eSpark-Consulting-Group/anis-carrier-board/Deliverables/Renderings/3D_Top_View.PNG

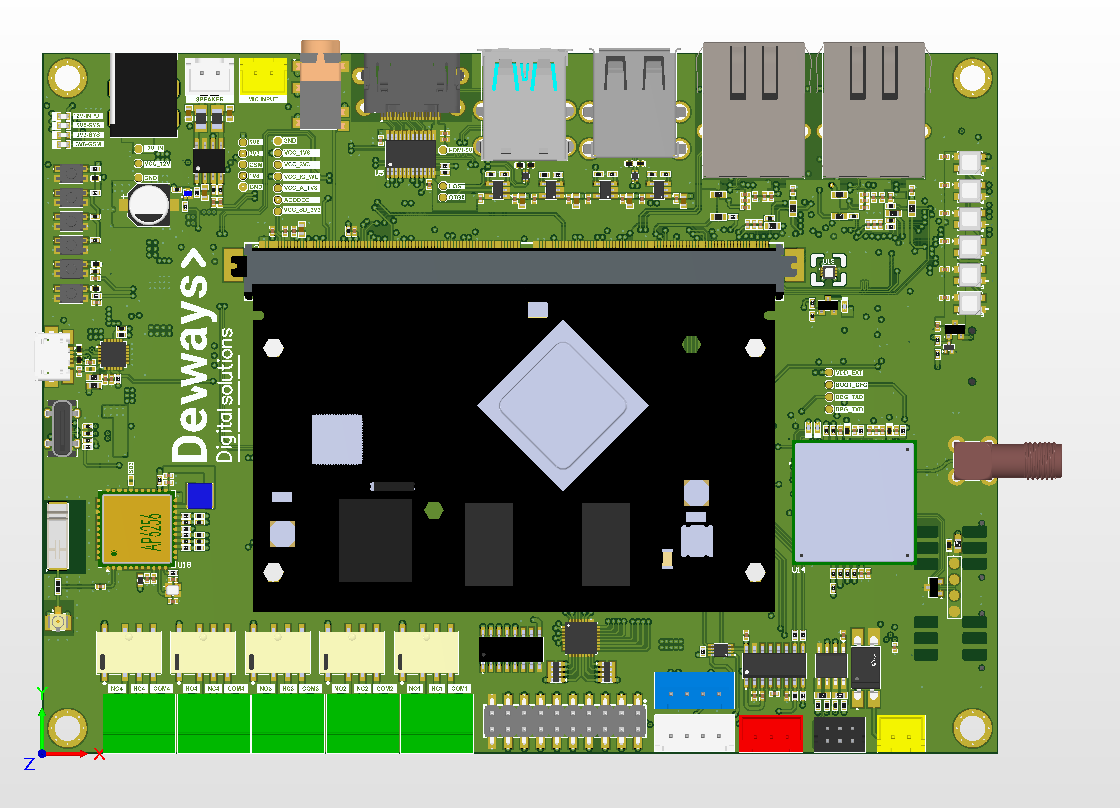
Deliverables/Renderings/3D_Top_View.PNG
