eSpark-Consulting-Group/anis-carrier-board/Deliverables/Renderings/2D_C_View.png

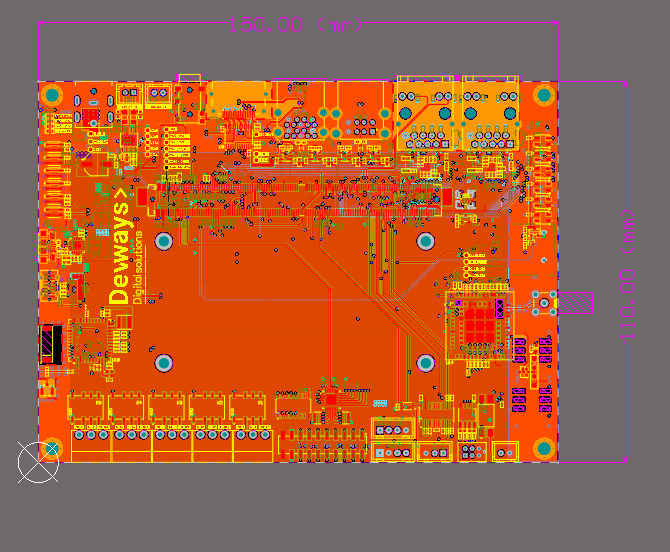
Deliverables/Renderings/2D_C_View.png
