eSpark-Consulting-Group/anis-carrier-board/README.md

# Carrier Board Design and Development
### Client Name: Anis Mohammed
