eSpark-Consulting-Group/anis-carrier-board/Deliverables/Renderings/2D_L2_View.png

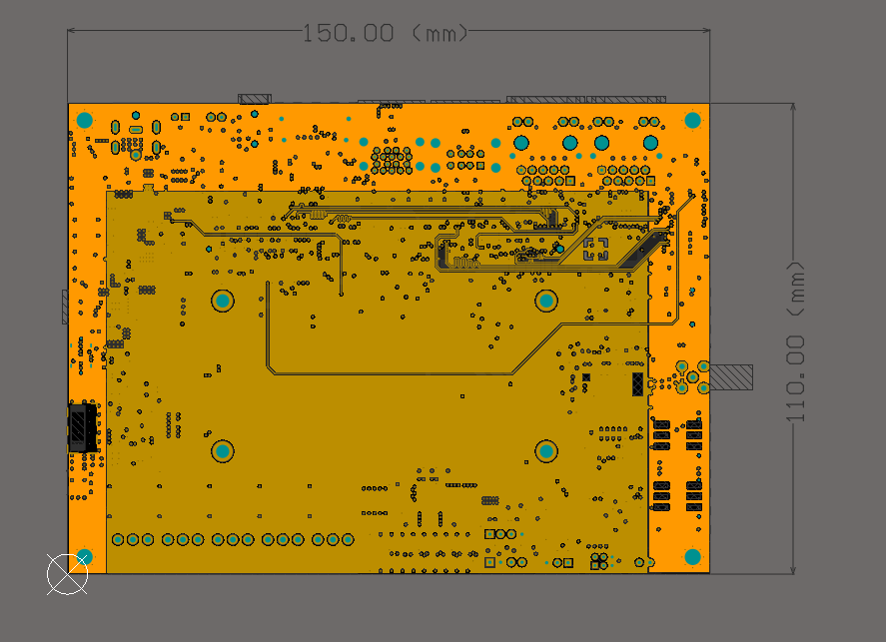
Deliverables/Renderings/2D_L2_View.png
