eSpark-Consulting-Group/anis-carrier-board/Deliverables/Renderings/2D_L3_View.png

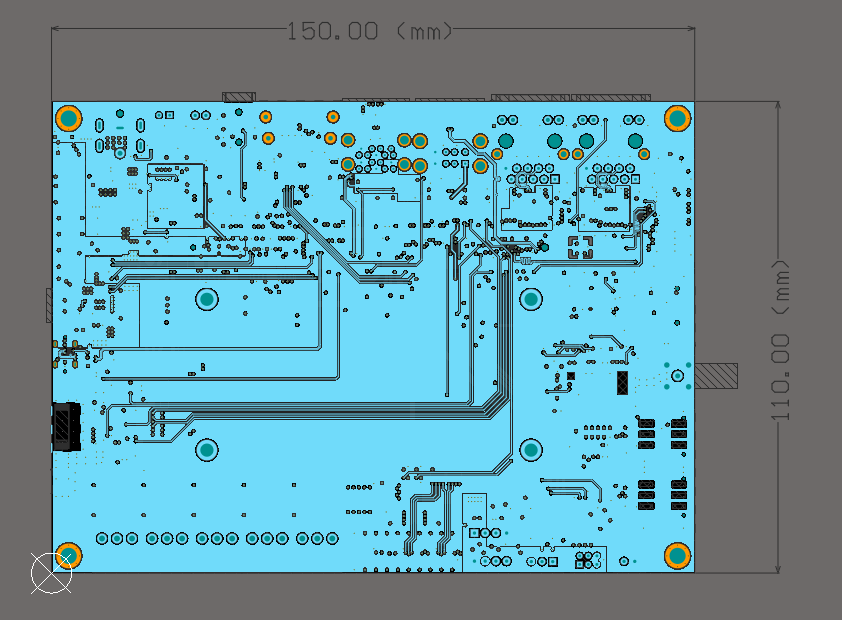
Deliverables/Renderings/2D_L3_View.png
