eSpark-Consulting-Group/anis-carrier-board/Deliverables/Renderings/2D_L6_View.png

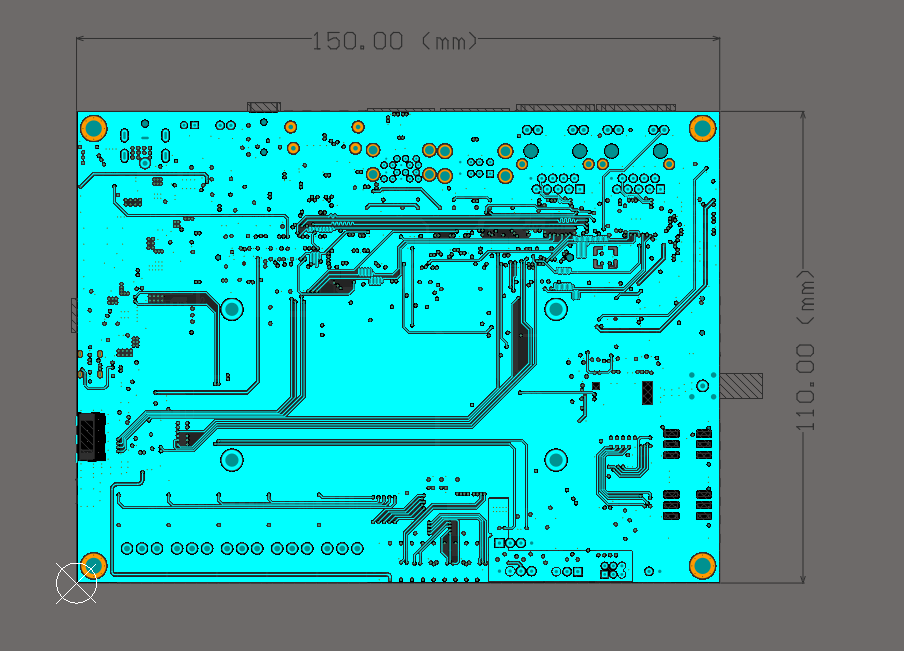
Deliverables/Renderings/2D_L6_View.png
