eSpark-Consulting-Group/anis-carrier-board/Deliverables/Renderings/2D_L7View.png

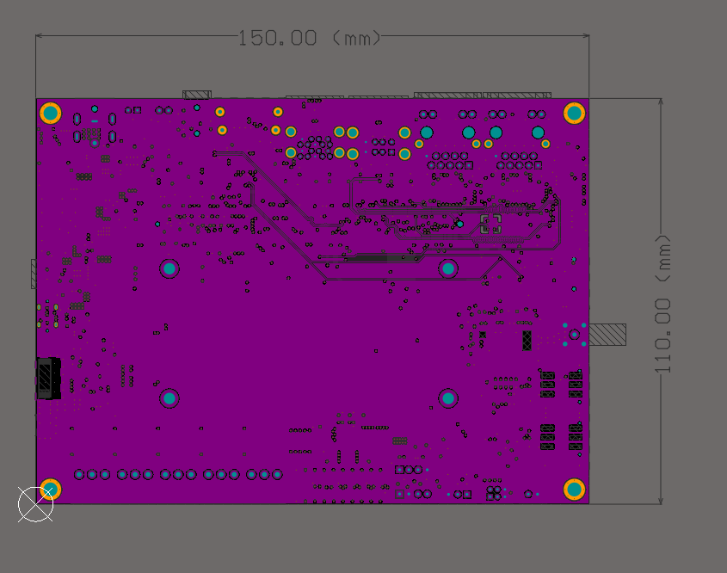
Deliverables/Renderings/2D_L7View.png
