eSpark-Consulting-Group/anis-carrier-board/Deliverables/Renderings/2D_Top_View.PNG

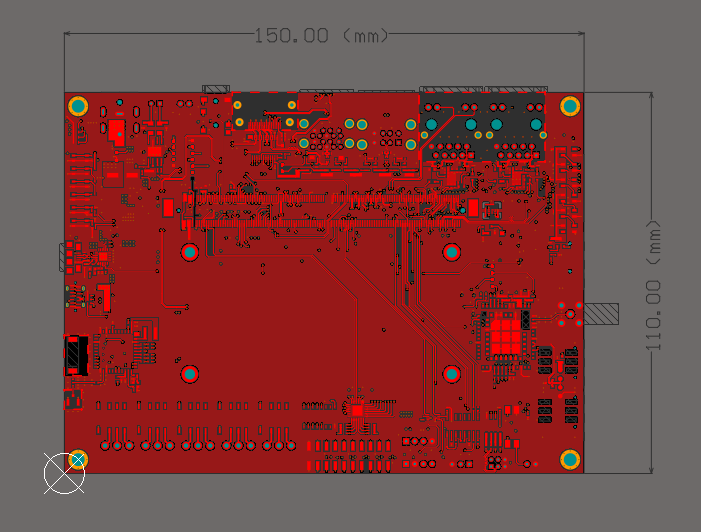
Deliverables/Renderings/2D_Top_View.PNG
