eSpark-Consulting-Group/anis-carrier-board/Deliverables/Renderings/Isometric_View.PNG

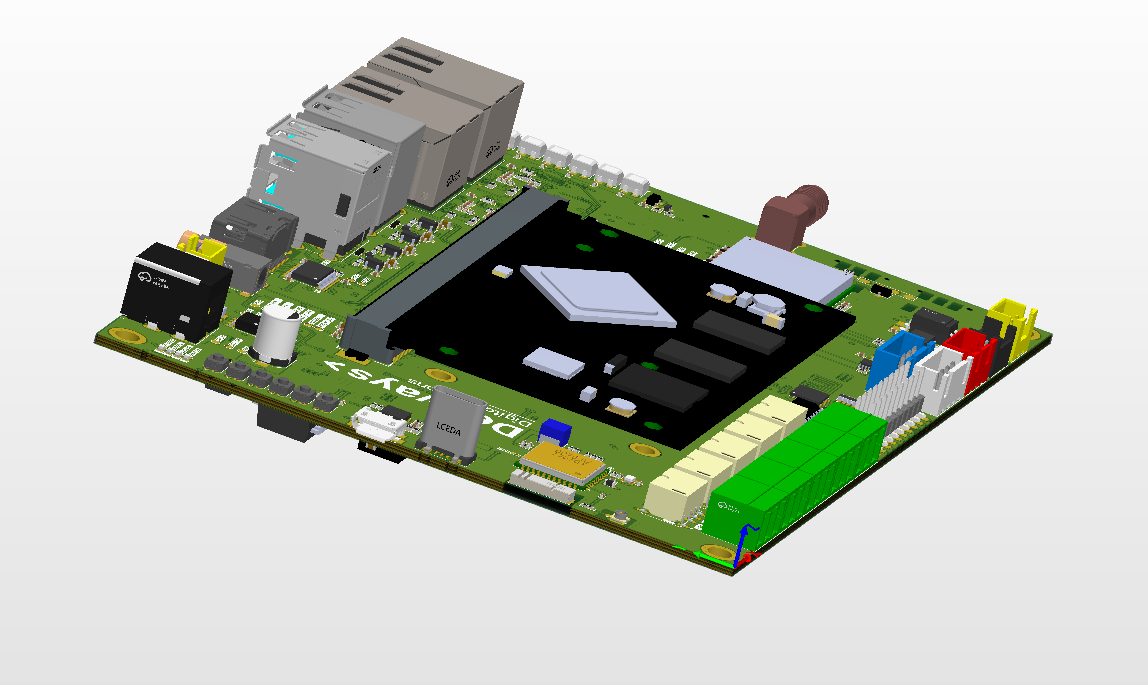
Deliverables/Renderings/Isometric_View.PNG
