eSpark-Consulting-Group/anis-carrier-board/Design-Files/Carrier-Board-v1.1/BOM/Client-BOM-Carrier-Board-v1.1.xlsx

# | Item Type | Designator | Description | Footprint | Manufacturer Part Number | Manufacturer | Value | Quantity | Remarks
1 | Antenna | ANT1 | RF ANT 2.4GHZ/5.5GHZ CHIP SLD | Custom | W3006 | Pulse | - | 1
2 | Capacitor | C1, C3, C4, C6, C7, C8, C9, C10, C11, C12, C13, C14, C15, C16, C17, C18, C21, C22, C23, C27, C30, C34, C55, C65, C66, C67, C70, C71, C72, C75, C76, C78, C81, C84, C85, C88, C89, C91, C92, C93, C94, C95, C96, C97, C98, C100, C101, C103, C104, C106, C107, C109, C110, C111, C113, C114, C115, C118, C119, C120, C122, C126, C129, C131, C134, C135, C136, C137, C141, C143, C144, C147, C148, C149, C152, C153, C154, C155, C158, C168, C169, C180, C181, C182, C183, C184, C185, C186, C187, C188, C189, C190, C191, C192, C193, C194, C199, C204 | CAP CER 0.1UF 16V X5R 0402 | Cap-0402 | CC0402KRX5R7BB104 | Yageo | 100nF | 98
3 | Capacitor | C2, C79 | CAP CER 10UF 10V X5R 0402 | Cap-0402 | CC0402MRX5R6BB106 | Yageo | 10uF | 2
4 | Capacitor | C5, C24, C31, C125, C142, C203 | CAP CER 1000PF 2KV X7R 1206 | Cap-1206 | CC1206KKX7RDBB102 | Yageo | 1nF | 6
5 | Capacitor | C19, C25, C28, C32 | CAP CER 1UF 16V X5R 0402 | Cap-0402 | CC0402KRX5R7BB105 | Yageo | 1uF | 4
6 | Capacitor | C20, C26, C29, C33 | CAP CER 10UF 16V X5R 0603 | Cap-0603 | CC0603KRX5R7BB106 | Yageo | 10uF | 4
7 | Capacitor | C35, C36, C38 | CAP CER 4.7UF 50V X5R 0805 | Cap-0805 | GRM21BR61H475KE51L | Murata | 4.7uf | 3
8 | Capacitor | C37, C68, C80, C166 | CAP CER 1UF 25V X5R 0402 | Cap-0402 | CC0402KRX5R8BB105 | Yageo | 1uF | 4
9 | Capacitor | C39, C40, C42, C43, C46, C50, C52, C53, C57, C124, C130, C177, C179 | CAP CER 0.1UF 50V X7R 0402 | cap-0402 | C1005X7R1H104KT000F | TDK | 100nF | 13
10 | Capacitor | C41, C51, C176, C178 | CAP CER 10UF 50V X5R 0805 | Cap-0805 | GRM21BR61H106ME43L | Murata | 10uF | 4
11 | Capacitor | C44, C45, C54, C56 | CAP CER 47UF 25V X5R 1206 | Cap-1206 | GRM31CR61E476ME44L | Murata | 47uF | 4
12 | Capacitor | C47, C59 | CAP CER 2.2UF 25V X5R 0402 | Cap-0402 | GRM155R61E225KE11D | Murata | 2.2uf | 2
13 | Capacitor | C48, C60 | CAP CER 1000PF 25V X7R 0402 | Cap-0402 | CC0402KRX7R8BB102 | Yageo | 1000pF | 2
14 | Capacitor | C49, C61 | CAP CER 3.9PF 50V C0G/NPO 0402 | Cap-0402 | CC0402BRNPO9BN3R9 | Yageo | 3.9pF | 2
15 | Capacitor | C58, C77 | CAP CER 10PF 50V C0G/NP0 0402 | Cap-0402 | GRM1555C1H100JA01D | Murata | 10pF | 2
16 | Capacitor | C62 | CAP TANT 470UF 10% 10V 2917 | Case-E | TAJE477K010RNJ | Kyocera AVX | 470uF | 1
17 | Capacitor | C63 | CAP CER 0.1UF 50V X5R 0603 | Cap-0603 | CC0603KRX5R9BB104 | Yageo | 100nF | 1
18 | Capacitor | C64 | CAP CER 33PF 25V C0G/NP0 0402 | Cap-0402 | GRM1555C1E330JA01D | Murata | 33pF | 1
19 | Capacitor | C69, C174 | CAP TANT 100UF 20% 10V 1411 | Case-B | TAJB107M010RNJ | Kyocera AVX | 100uF | 2
20 | Capacitor | C73, C74 | CAP CER 0.22UF 25V X5R 0402 | Cap-0402 | CC0402KRX5R8BB224 | Yageo | 220nF | 2
21 | Capacitor | C82, C83 | CAP CER 12PF 50V C0G/NP0 0402 | Cap-0402 | GJM1555C1H120GB01D | Murata | 12pF | 2
22 | Capacitor | C86, C87, C90, C99, C102, C105, C108, C112, C156, C157 | CAP CER 10UF 25V X5R 0603 | Cap-0603 | C1608X5R1E106M080AC | TDK | 10uF | 10
23 | Capacitor | C116 | 100uF 50V ±20% SMD,D6.3xL7.7mm Aluminum Electrolytic Capacitors - SMD ROHS | Custom | RVT1H101M0607 | ROQANG | 100uF | 1
24 | Capacitor | C117, C121, C123, C132, C140, C146, C150 | CAP CER 4.7UF 10V X5R 0402 | Cap-0402 | CC0402KRX5R6BB475 | Yageo | 4.7uF | 7
25 | Capacitor | C127, C128, C138, C139 | CAP CER 18PF 50V C0G/NP0 0402 | Cap-0402 | GCM1555C1H180GA16D | Murata | 18pF | 4
26 | Capacitor | C133, C145, C151, C197 | CAP CER 1UF 25V X5R 0603 | Cap-0603 | CC0603KRX5R8BB105 | Yageo | 1uF | 4
27 | Capacitor | C159, C160, C161, C162, C163, C164, C198 | CAP CER 1000PF 25V X7R 0402 | Cap-0402 | CC0402KRX7R8BB102 | Yageo | 1nF | 7
28 | Capacitor | C165 | CAP CER 100PF 50V C0G/NPO 0402 | Cap-0402 | CC0402JRNPO9BN101 | Yageo | 100pF | 1
29 | Capacitor | C170, C171 | CAP CER 27PF 25V C0G/NP0 0402 | Cap-0402 | 0402N270J250CT | Walsin Technologies | 27pF | 2
30 | Capacitor | C172, C173 | CAP CER 0.015UF 50V X7R 0402 | Cap-0402 | CC0402KRX7R9BB153 | Yageo | 15nF | 2
31 | Capacitor | C175 | CAP CER 0.1UF 100V X7R 0603 | Cap-0603 | CC0603KRX7R0BB104 | Yageo | 0.1uF | 1
32 | Capacitor | C195, C196 | CAP CER 1000PF 25V C0G/NPO 0603 | CAP-0603 | CC0603JRNPO8BN102 | Yageo | 1nF | 2
33 | Surge Protection (TVS/ESD) | D1, D2 | TVS DIODE 7V/12V 14V/26V SOT23-3 | SOT-23 | CDSOT23-SM712 | Bourns | - | 2
34 | Diode | D3, D4, D7, D8, D9, D10, D11, D12, D13, D14, D22, D23, D24, D25, D48, D49, D50, D51, D52, D55, D57, D61, D64, D65, D66, D68 | DFN1006-2(0402) ESD Protection Devices ROHS | DFN1006-2L (Bi-Directional) | ESD5451N | TECH PUBLIC | - | 26
35 | Diode | D5, D6 | DFN2510-10L ESD Protection Devices ROHS | DFN2510-10L_ | ESD5344D-10/TR | WILLSEMI | - | 2
36 | Diode | D15 | TVS DIODE 33VWM 53.3VC SMB | SMB Bi Directional | SMBJ33CA-13-F | Diodes | - | 1
37 | Diode | D16, D58, D59, D60, D62, D63 | DIODE ZENER ARRAY 3.3V SOT363 | SOT-363 | BZX84C3V3TS-7-F | Diodes Incorporated | - | 6
38 | Diode | D17 | DIODE ZENER 5.1V 500MW SOD123 | SOD-123 | MMSZ5231BT1G | ON Semiconductor | - | 1
39 | Diode | D18, D26, D27, D28, D29, D30, D31, D32, D33, D34, D35, D36, D37, D38, D39, D40, D41, D42, D43, D44, D45 | DFN1006-2 ESD Protection Devices ROHS | DFN1006-2L_ | ESD9X5VU | TECH PUBLIC | - | 21
40 | Diode | D19 | 16A 20V 7V 5V@Max Unidirectional SOT-23 TVS ROHS | Sot-23 | ESD5302F-3/TR | WILLSEMI | - | 1
41 | Diode | D20, D21 | 35A@8/20us 15V 4.5V@Max DFN1006-2L Electrostatic and Surge Protection (TVS/ESD) ROHS | DFN1006-2L_ | ESD5651N-2/TR | WILLSEMI(Will Semicon) | - | 2
42 | (TVS/ESD) | D46, D47 | TVS DIODE 5.5VWM SOT23 | SOT-23 | DRTR5V0U1SO-7 | Diodes | - | 2
43 | (TVS/ESD) | D53, D54 | X1-DFN1006-2 ESD and Surge Protection (TVS/ESD) ROHS | DFN1006-2L (Bi-Directional) | ESD9N12BA | TECH PUBLIC | - | 2
44 | Fuse | F1 | FUSE BRD MNT 5A 32VAC 75VDC 1206 | Fuse 1206 (3216 Metric) | 0458005.DR | Littelfuse | - | 1
45 | Fuse | F2 | 6V 500mA 40A 1A 0603 Resettable Fuses ROHS | Fuse-0603 | SMD0603-050 | TECHFUSE | - | 1
46 | Ferrite Bead | FB1 | FERRITE BEAD 30 OHM 0805 1LN | Ind-0805 | BLM21PG300SN1D | Murata | - | 1
47 | Ferrite Bead | FB2 | 0603 180Ω ±25% DCR=0.09Ω 1.5A | IND-0603 (1608 Metric) | BLM18PG181SN1D | Murata | - | 1
48 | Ferrite Bead | FB3, FB4 | FERRITE BEAD 1K OHM 1206 1LN | IND-1206 | BLM31KN102SN1L | Murata | - | 2
49 | MicroSD card | J1 | 2mm Deck MicroSD card (TF card) Self bomb SMD SD Card / Memory Card Connector ROHS | Custom | TF-01A | Yuandi | - | 1
50 | Card Edge Connectors | J1 Part- | SMD,P=0.5mm,Surface Mount，Right Angle | Custom | AS0B826-S78B-7H | FOXCONN | - | 1
51 | HDMI Connector | J2 | CONN RCPT 1.4 HDMI 19POS SMD R/A | Custom | 10029449-111RLF | Amphenol ICC / FCI | - | 1
52 | Wire To Wire Connector | J3 | 2x3P 2 2mm 2mm male 3 -25℃~+85℃ 3A Straight Plugin,P=2mm Wire To Board / Wire To Wire Connector ROHS | Custom | HX20012-6A black | HX(Zhejiang Yueqing Hongxing Elec) | - | 1
53 | Wire To Board Connector | J4 | 1x3P 3P XH 1 Tin 2.5mm 3 -25℃~+85℃ Brass 3A Straight Plugin,P=2.5mm Wire To Board Connector ROHS | Custom | HC-XH-3A-R | HCTL | - | 1
54 | Type-A USB Connector | J5 | USB 2.0 1.5A 2 235℃ Right-Angle 4P+4P Female -40℃~+85℃ Gold Brass Type-A Plugin USB Connectors ROHS | Custom | U224-081N-1BR61 | XKB Connection | - | 1
55 | Type-A Connector | J6 | USB 3.0 2 Right-Angle 9P+9P Female Type-A Plugin USB Connectors ROHS | Custom | UEA1112C-8HS6-4F | FOXCONN | - | 1
56 | DC JACK | J7 | Shrouded DC Power Receptacle -20℃~+70℃ 2.5mm 6.5mm 10A 16V Plugin AC/DC Power Connectors ROHS | Custom | DC-053D-25A | Korean Hroparts Elec | - | 1
57 | SMA Connector | J8 | 1 Inner bore SMA Board Edge Bend 11mm 5.35mm Plugin RF Connectors / Coaxial Connectors ROHS | Custom | HJ-SMA175 | HJ Tech | - | 1
58 | Pogo Connector | ~~J9~~ | ~~Pogo Pad 2.5mm 4 Pin~~ | ~~Custom~~ | ~~POGO Connector 4 Pin~~ | ~~-~~ | ~~-~~ | ~~1~~ | ~~DO NOT PLACE~~
59 | SIM Card Connectors | J10, J11 | Copper Alloy Self bomb Gold plating 1.25mm Deck -40℃~+85℃ 260℃ NanoSIM SMD SIM Card Connectors ROHS | Custom | XKNANO-113 | XKB Connectivity | - | 2
60 | Terminal Block | J12, J13, J14, J15, J16 | 250V 10A 3 Bend -40℃~+105℃ 1 3.5mm 1x3P Green Board Edge/Receptacle-Close Push-Pull,P=3.5mm Pluggable System Terminal Block ROHS | Custom | DB2ERC-3.5-3P-GN | DORABO | - | 5
61 | Male Header | J17 | 250V 3A Brick nogging Square Pins 2.5mm 260℃@5S 6mm 20P -40℃~+105℃ 2.54mm 双排 Black 2.54mm 2x10P SMD,P=2.54mm Pin Headers ROHS | Custom | PZ254-2-10-S | HCTL | - | 1
62 | UFL Connector | J18 | CONN U.FL RCPT STR 50 OHM SMD | Custom | U.FL-R-SMT-1(80) | Hirose | - | 1
63 | USB Connector | J19 | CONN RCPT USB2.0 MICRO B SMD R/A | Custom | 10118192-0001LF | Amphenol FCI | - | 1
64 | Wire To Board Connector | J20 | 1x4P 4P XH 1 Tin 2.5mm 4 -25℃~+85℃ Brass 3A Straight Plugin,P=2.5mm Wire To Board Connector ROHS | Custom | XH-4A-L | HCTL | - | 1
65 | Ethernet Connector | J21, J24 | RJ45 RJReceptacle 1 Internal oscillator included Shrouded WithLED Plugin Ethernet Connectors/Modular Connectors (RJ45 RJ11) ROHS | Custom | HR911130C | HANRUN | - | 2
66 | JST Connector | J22 | 1x2P XH 1 2.54mm 2.54mm Male pin 2 -25℃~+85℃ 3A Straight Straight,P=2.5mm Wire To Board / Wire To Wire Connector ROHS | Custom | HC-XH-2A-G | HCTL | - | 1
67 | Wire To Board Connector | J23 | 1x4P 4P XH 1 Tin 2.5mm 4 -25℃~+85℃ Brass 3A Straight Plugin,P=2.5mm Wire To Board Connector ROHS | Custom | XH-4A | HCTL | - | 1
68 | Audio Connector | J25 | 3.5mm headphone jack 1A SMD Audio Connectors ROHS | Custom | PJ-332D-6A | Korean Hroparts Elec | - | 1
69 | FFC / FPC Connector | J26 | CONN FFC BOTTOM 30POS 0.5MM R/A | Custom | TF31-30S-0.5SH(800) | Hirose | - | 1
70 | Wire To Board Connector | J27, J28 | 1x2P 2P XH 1 Tin 2.5mm 2 -25℃~+85℃ Brass 3A Straight Plugin,P=2.5mm Wire To Board Connector ROHS | Custom | XH-2A-Y | HCTL | - | 2
71 | USB Connector | J29 | 1 Brick nogging 14P Female Type-C SMD USB Connectors ROHS | Custom | TYPE-C-31-D-07 | Korean Hroparts Elec | - | 1
72 | Relay | K1, K2, K3, K4, K5 | RELAY TELECOM DPDT 1A 5V | Custom | G6K-2F-Y-TR-DC5 | Omron | - | 5
73 | Common Mode Chokes | L1, L2, L3, L4 | CMC 100MA 2LN 90 OHM SMD | Custom | MCZ1210CH900L2TA0G | TDK | - | 4
74 | Inductor | L5 | Fixed Ind 4.720%UH 0.06 Ohm 3200M | Custom | SWPA4030S4R7MT | Sunlord | 4.7uH | 1
75 | Inductor | L6, L9 | FIXED IND 2.2UH 1.5A 160MOHM SMD | Custom | MAKK2016T2R2M | Taiyo Yuden | 2.2uH | 2
76 | Inductor | L7, L8 | 1uH ±20% 23A SMD,6.6x6.4mm Power Inductors ROHS | Custom | YSPIT0630A-1R0M | YJYCOIN | 1uH | 2
77 | LED | LED1 | Emerald 0603 Light Emitting Diodes (LED) ROHS | LED-0603 | NCD0603G2 | Foshan NationStar Optoelectronics | - | 1
78 | LED | LED2, LED6 | RED LED 0603 Light Emitting Diodes | LED-0603 | NCD0603R3 | Foshan NationStar Optoelectronics | - | 2
79 | LED | LED3 | yellow 0603 Light Emitting Diodes (LED) ROHS | LED-0603 | NCD0603Y2 | Foshan NationStar Optoelectronics | - | 1
80 | LED | LED4 | LED YELLOW CLEAR CHIP SMD | LED-0402 | XZMYK68W-2 | SunLED | - | 1
81 | LED | LED5 | LED RED CLEAR CHIP SMD | LED-0402 | XZMDK68W-2 | SunLED | - | 1
82 | LED | LED7 | LED BLUE CLEAR 2SMD | LED-0402 | XZCBD68W-2 | SunLED | - | 1
83 | RGB LED | LED8, LED9, LED10, LED11, LED12, LED13 | 12mA RGB SMD3535 Light Emitting Diodes (LED) ROHS | SMD3535 | WS2812B-MINI-V3/W | Worldsemi | - | 6
84 | Mosfet | Q2, Q3, Q4, Q5 | SOT-23 MOSFETs ROHS | SOT-23 | FDN335N | TECH PUBLIC | - | 4
85 | MOSFET | Q7 | 30V 100mA 200mW 8Ω@4V,10mA N Channel SOT-23 MOSFETs ROHS | SOT-23 | 2SK3018 | KUU | - | 1
86 | Transistor | Q14 | Trans Gp Bjt NPN 25V 1.5A 300MW 3-PIN SOT-23 T/r | SOT-23 | SS8050-G | Comchip | - | 1
87 | MOSFET | Q15 | MOSFET P-CH 30V 4.3A SOT23-3 | SOT-23 | AOSS21311C | Alpha & Omega Semiconductor | - | 1
88 | Transistor | Q16 | TRANS NPN 40V 0.2A SOT523 | SOT-523 | MMBT3904T-7-F | Diodes Zetex | - | 1
89 | Mosfet | Q17 | 40V 100mW 100@10mA,1V 200mA 300MHz 300mV@50mA,5mA NPN -55℃~+150℃@(Tj) SOT-723 Bipolar Transistors - BJT ROHS | SOT-723 | MMBT3904M | TECH PUBLIC | - | 1
90 | Resistor | R1, R23, R24, R28, R29, R52, R53, R54, R60, R65, R68, R84, R85, R86, R87, R88, R89, R90, R116, R129, R139, R142, R173, R174, R191, R247, R255 | RES 0 OHM JUMPER 1/16W 0402 | Res-0402 | RC0402FR-070RL | Yageo | 0R | 27
91 | Resistor | R2, R4, R5, R25, R26, R30, R33, R37, R46, R50, R72, R75, R76, R77, R78, R79, R82, R83, R92, R108, R111, R112, R130, R140, R143, R152, R194, R199, R203, R208, R209, R225, R228, R229, R230, R234, R252, R253, R254, R258, R265 | RES 10K OHM 1% 1/16W 0402 | Res-0402 | RC0402FR-0710KL | Yageo | 10K | 41
92 | Resistor | ~~R3, R61, R205~~ | ~~RES 0 OHM JUMPER 1/16W 0402~~ | ~~Res-0402~~ | ~~RC0402FR-070RL~~ | ~~Yageo~~ | ~~DNP~~ | ~~3~~ | ~~DO NOT PLACE~~
93 | Resistor | R6, R11, R14, R15, R16, R19, R20, R21, R22, R119, R120, R121, R122, R123, R124, R144, R145, R146, R147, R148, R149, R177, R178, R239, R240, R241, R242, R243, R244, R245, R246 | RES 22 OHM 1% 1/16W 0402 | Res-0402 | RC0402FR-0722RL | Yageo | 22R | 31
94 | Resistor | R7, R34, R41, R47, R115, R264 | RES SMD 1M OHM 5% 1/16W 0402 | Res-0402 | AF0402JR-071ML | Yageo | 1M | 6
95 | Resistor | R8, R9, R48, R91, R97, R98, R99, R100, R101, R132, R133, R134, R135, R156, R160, R161, R165, R166, R167, R170, R171, R172, R210, R211, R212, R213, R214, R215, R216, R217, R218, R219, R220, R221, R238, R248, R249, R250, R251, R259, R260 | RES 4.7K OHM 1% 1/16W 0402 | Res-0402 | RC0402FR-074K7L | Yageo | 4.7K | 41
96 | Resistor | R10, R73, R74, R80, R81, R237 | RES 1K OHM 1% 1/16W 0402 | Res-0402 | RC0402FR-071KL | Yageo | 1K | 6
97 | Resistor | ~~R12, R13~~ | ~~RES 100 OHM 1% 1/16W 0402~~ | ~~Res-0402~~ | ~~RC0402FR-07100RL~~ | ~~Yageo~~ | ~~DNP~~ | ~~2~~ | ~~DO NOT PLACE~~
98 | Resistor | R17 | RES SMD 120 OHM 0.1% 1/10W 0603 | Res-0603 | RT0603BRB07120RL | Yageo | NC | 1
99 | Resistor | R18 | RES SMD 120 OHM 0.1% 1/10W 0603 | Res-0603 | RT0603BRB07120RL | Yageo | 120R | 1
100 | Resistor Array | R27, R222, R223, R224 | RES ARRAY 4 RES 10K OHM 1206 | Custom | YC164-FR-0710KL | Yageo | 10K | 4
101 | Resistor | R31, R36, R45, R49 | RES 6.8K OHM 1% 1/16W 0402 | Res-0402 | RC0402FR-076K8L | Yageo | 6.8K | 4
102 | Resistor | R32, R40, R42, R44 | RES SMD 510 OHM 1% 1/16W 0402 | Res-0402 | RT0402FRE07510RL | Yageo | 510R | 4
103 | Resistor | R35 | RES 22.1K OHM 1% 1/10W 0603 | Res-0603 | RC0603FR-0722K1L | Yageo | 22.1K | 1
104 | Resistor | R38, R39, R104, R105, R197 | RES 5.1K OHM 1% 1/16W 0402 | Res-0402 | RC0402FR-075K1L | Yageo | 5.1K | 5
105 | Resistor | R43 | RES 47.5K OHM 1% 1/10W 0603 | Res-0603 | RC0603FR-0747K5L | Yageo | 47.5K | 1
106 | Resistor | R51 | RES 2.7K OHM 1% 1/10W 0603 | Res-0603 | RC0603FR-072K7L | Yageo | 2.7K | 1
107 | Resistor | R55 | RES SMD 330R 100 mW 0603 | Res-0603 | RC0603JR-07330RL | Yageo | 330R | 1
108 | Resistor | ~~R56~~ | ~~RES 100K OHM 1% 1/16W 0402~~ | ~~Res-0402~~ | ~~RC0402FR-07100KL~~ | ~~Yageo~~ | ~~DNP~~ | ~~1~~ | ~~DO NOT PLACE~~
109 | Resistor | R57, R63, R64, R69 | RES 100K OHM 1% 1/16W 0402 | Res-0402 | RC0402FR-07100KL | Yageo | 100K | 4
110 | Resistor | R58, R66, R198 | RES 12K OHM 1% 1/16W 0402 | Res-0402 | RC0402FR-0712KL | Yageo | 12K | 3
111 | Resistor | R59, R67 | RES 39K OHM 1% 1/16W 0402 | Res-0402 | RC0402FR-0739KL | Yageo | 39K | 2
112 | Resistor | R62 | RES SMD 1K OHM 1% 1/10W 0603 | Res-0603 | CRCW06031K00FKEA | Vishay Dale | 1K | 1
113 | Resistor | R70, R71 | RES 180 OHM 1% 1/10W 0603 | Res-0603 | RC0603FR-07180RL | Yageo | 180R | 2
114 | Resistor | R93, R94, R95, R125, R126, R136, R157, R162 | RES 0 OHM JUMPER 1/10W 0603 | Res-0603 | RC0603JR-070RL | Yageo | 0R | 8
115 | Resistor | R96, R153 | RES SMD 1.8K OHM 1% 1/5W 0402 | Res-0402 | RCS04021K80FKED | Vishay Dale | 1.8K | 2
116 | Resistor | R102, R103, R117, R118, R189, R190, R206, R207 | RES SMD 2.2K OHM 1% 1/16W 0402 | Res-0402 | RC0402FR-072K2L | Yageo | 2.2K | 8
117 | Resistor | R106, R107, R127, R150, R188, R195, R227, R232 | RES 100 OHM 1% 1/16W 0402 | Res-0402 | RC0402FR-07100RL | Yageo | 100R | 8
118 | Resistor | R109, R113 | RES 15K OHM 1% 1/16W 0402 | Res-0402 | RC0402FR-0715KL | Yageo | 15K | 2
119 | Resistor | R110, R114 | RES 20K OHM 1% 1/16W 0402 | Res-0402 | RC0402FR-0720KL | Yageo | 20K | 2
120 | Resistors | R128, R151 | RES 120 OHM 1% 1/16W 0402 | Res-0402 | RC0402FR-07120RL | Yageo | 120R | 2
121 | Resistors | R131, R141 | RES 2.49K OHM 1% 1/16W 0402 | Res-0402 | RC0402FR-072K49L | Yageo | 2.49K | 2
122 | Resistor | R137, R138 | RES 470 OHM 1% 1/16W 0402 | Res-0402 | RC0402FR-07470RL | Yageo | 470R | 2
123 | Resistor | ~~R175, R231~~ | ~~RES 10K OHM 1% 1/16W 0402~~ | ~~Res-0402~~ | ~~RC0402FR-0710KL~~ | ~~Yageo~~ | ~~DNP~~ | ~~2~~ | ~~DO NOT PLACE~~
124 | Resistor | R196 | RES 3K OHM 1% 1/16W 0402 | Res-0402 | RC0402FR-073KL | Yageo | 3K | 1
125 | Resistor | R201, R202, R233 | RES 470 OHM 1% 1/10W 0603 | Res-0603 | RC0603FR-07470RL | Yageo | 470R | 3
126 | Resistor | R204 | RES 47K OHM 1% 1/16W 0402 | Res-0402 | RC0402FR-0747KL | Yageo | 47K | 1
127 | Resistor | R226 | RES 1.5K OHM 1% 1/16W 0402 | Res-0402 | RC0402FR-071K5L | Yageo | 1.5K | 1
128 | Resistor | R235 | RES 51K OHM 1% 1/16W 0402 | Res-0402 | RC0402FR-0751KL | Yageo | 51K | 1
129 | Resistor | R236 | RES 499 OHM 1% 1/16W 0402 | Res-0402 | RC0402FR-07499RL | Yageo | 499R | 1
130 | Resistor | R256, R257 | RES SMD 22.1KOHM 0.1% 1/16W 0402 | Res-0402 | RT0402BRD0722K1L | Yageo | 22.1K | 2
131 | Resistor | R263, R266 | RES SMD 15K OHM 0.1% 1/16W 0402 | Res-0402 | RT0402BRD0715KL | Yageo | 15K | 2
132 | Resistor | RN4, RN5 | RES ARRAY 4 RES 22 OHM 1206 | 0603x4 | YC164-FR-0722RL | YAGEO | 22R | 2
133 | Switch | SW1, SW2, SW3, SW4, SW5, SW6 | 3mm 2mm Round Button 50mA Top3.65mm SPST 12V SMD Tactile Switches | Custom | TS-1185EC-C-D-B | XKB | - | 6
134 | IC | U1 | IC TXRX RS485/422 10MBPS 8SOIC | SOIC-8 | MAX3490EESA+T | Maxim | - | 1
135 | IC | U2 | IC RS232 LINE DVR/RCVR 16-SOIC | SOIC-16 | MAX3232EIDR | Texas Instruments | - | 1
136 | IC | U3, U4 | TVS DIODE 5.5VWM 11VC U-DFN2510 | U-DFN2510-10 | DT1240-04LP-7 | Diodes | - | 2
137 | IC | U5 | IC INTERFACE SPECIALIZED 24TSSOP | 24-TSSOP | TPD12S016PWR | Texas Instruments | - | 1
138 | IC | U6, U7, U8, U9 | SOT-23-5 Power Distribution Switches ROHS | SOT-23-5 | SY6280AAC | Silergy | - | 4
139 | IC | U10 | MOSFET N-CH 40V 60A PPAK SO-8 | PowerPAK-SO-8 | SQJ886EP-T1_GE3 | Vishay Siliconix | - | 1
140 | IC | U11 | OR Controller N+1 ORing Controller N-Channel 1:1 SOT-23-6 | SOT-23-6 | LM74700QDBVRQ1 | Texas Instruments | - | 1
141 | IC | U12 | IC REG BUCK 3.3V 6A 17FC2QFN | 17-FC2QFN (3.5x3.75) | MAX20006AFOB/VY+T | Maxim | - | 1
142 | IC | U13 | IC REG BUCK 5V 8A 17FC2QFN | 17-FC2QFN (3.5x3.75) | MAX20008AFOC/VY+T | Analog Devices | - | 1
143 | Module | U14 | LGA-85_19.6x19.6x1.10P RF Modules ROHS | Custom | A7682E | SIMCom Wireless Solutions | - | 1
144 | IC | U15 | IC TRNSLTR BIDIRECTIONAL US8 | Custom | TXB0102DCUT | Texas Instruments | - | 1
145 | ESD Diode | U16, U17 | 15V 5 Unidirectional 5V SOT-363 ESD Protection Devices ROHS | SOT-363 | SMF05CT1G-ES | ElecSuper | - | 2
146 | IC | U18 | 802.11ac/a/b/g/n WiFi Combo Sip Module (WiFi 5), 1T1R | Custom | AP6256 | SparkLan | - | 1
147 | Temperature & Humidity Sensor | U19 | DFN-6-EP(2x2) Temperature and Humidity Sensor ROHS | DFN-6-EP(2x2) | GXHTC3 | GXCAS | - | 1
148 | IC | U20 | 100uA@50V 3V@2V,300mA 1.6V@350mA 4mA@12V 100uA@50V 1.25V@350mA 500mA 25pF SOP-16_150mil Darlington Transistor Arrays ROHS | SOP-16_150mil | ULN2003A | Mixic | - | 1
149 | IC | U21 | IC USB TO UART BRIDGE QFN24 | Custom | CP2102N-A02-GQFN24R | Silicon Labs | - | 1
150 | IC | U22 | IC TRANSLTR BIDIRECTIONAL 8VSSOP | VSSOP-8(3.1x2.1) | TXS0102DCUR | Texas Instruments | - | 1
151 | IC | U23, U25 | WQFN-40-EP(5x5) Ethernet ICs ROHS | WQFN-40-EP(5x5) | RTL8211F-CG | Realtek Semicon | - | 2
152 | IC | U24 | Power Switch/Driver 1:1 P-Channel 1.7V~5.5V 130mΩ 1.2A SC-70-6 | SC-70-6 | MIC94093YC6-TR | Microchip Tech | - | 1
153 | IC | U26 | IC REG LDO ADJ 3A TO263-5 | TO-263-5 (D2PAK) | MIC29302WU-TR | Microchip | - | 1
154 | IC | U27 | IC REG LINEAR 1.8V 800MA SOT223 | SOT- 223 | LM1117MPX-1.8/NOPB | TI National Semiconductor | - | 1
155 | IC | U28 | IC XPNDR 400KHZ I2C SMBUS 32UQFN | 32-UQFN (5x5) | TCA6424ARGJR | Texas Instruments | - | 1
156 | IC | U29 | Optoisolator Output Channel 4-SMD | Custom | PC817X2NIPW | Sharp | - | 1
157 | IC | U30 | IC BUFFER SCHMITT TRIGGER 5TSOP | SC-74A | 74LVC1G17GV,125 | Nexperia | - | 1
158 | IC | U31 | SOP-8-EP Audio Power OpAmps ROHS | 8-SOIC-EP | NS4110B | Shenzhen Nsiway Tech | - | 1
159 | IC | U33 | IC USB SWITCH DPDT 10MSOP | 10-MSOP | FSUSB42MUX | ON Semiconductor / Fairchild | - | 1
160 | Crystal | X1 | 37.4MHz SMD Crystal Resonator 9pF 60Ω ±10ppm -40℃~+85℃ SMD2016-4P Crystals | Custom | Q22FA12800078 | Seiko | 37.4MHz | 1
161 | Crystal | X2, X3 | CRYSTAL 25.0000MHZ 12PF SMD | Custom | Q22FA12800090 | Seiko Epson | 25MHz | 2
162 | Peripheral | - | Network cables ROHS | Custom | S108510003 | Ckmtw | - | 2
163 | Peripheral | - | Network cables ROHS | Custom | S108510001 | Ckmtw | - | 3
164 | Peripheral | - | Network cables ROHS | Custom | S108510002 | Ckmtw | - | 1
165 | Peripheral | - | 250V 10A 3 -40℃~+105℃ 1.5 1 16~28 3.5mm 1x3P Green Plug P=3.5mm Pluggable System Terminal Block ROHS | Custom | DB2EK-3.5-3P-GN-S | DORABO | - | 5
166 | Peripheral | SMA Antenna | 1.8 3dBi Vertical 50W - Antennas ROHS | Custom | BWGSMJWX105-7KJ | BAT WIRELESS |  | 1
167 | Peripheral | UFL Antenna | 1.5 3dBi Vertical 50W - Antennas ROHS | - | BW2.4FNX42-12B1 | BAT WIRELESS | - | 1
168 | Peripheral | Adaptor | 12V 8A | - | - | DAMTSM | - | 1
169 | Peripheral | Compute Module | Rockchip RK3568 8G/64G | - | Core-3568J | FireFly | - | 1
170 | Peripheral | - | Universal RFID reader/writer module |  | TWN4 MultiTech 3 M | ELATEC
171 | Peripheral | - | Epson BA-T500IIS: M-T500II Series, 24V |  | BA-T500IIS | Epson
172 | Peripheral | - | 20/ 50pcs M3 M4 M5 M6 M8 White/ Black ABS Non-Threaded Spacer Round Hollow Standoff Washer PCB Board Spacer length 2 to 25mm | - | M3x5mm 100pcs | - | - | 4
173 | Peripheral | - | Honeywell 1900G-HD (High Density) 2D Barcode Scanner with USB Cable |  | Xenon 1900g | Honeywell
