eSpark-Consulting-Group/anis-carrier-board/(list of files, cad)

Other CAD files:
Deliverables/Supporting_Files/Carrier_Board_v1.1.DWG
