eSpark-Consulting-Group/anis-carrier-board/Deliverables/Schematic/Carrier-Board-v1.1.pdf

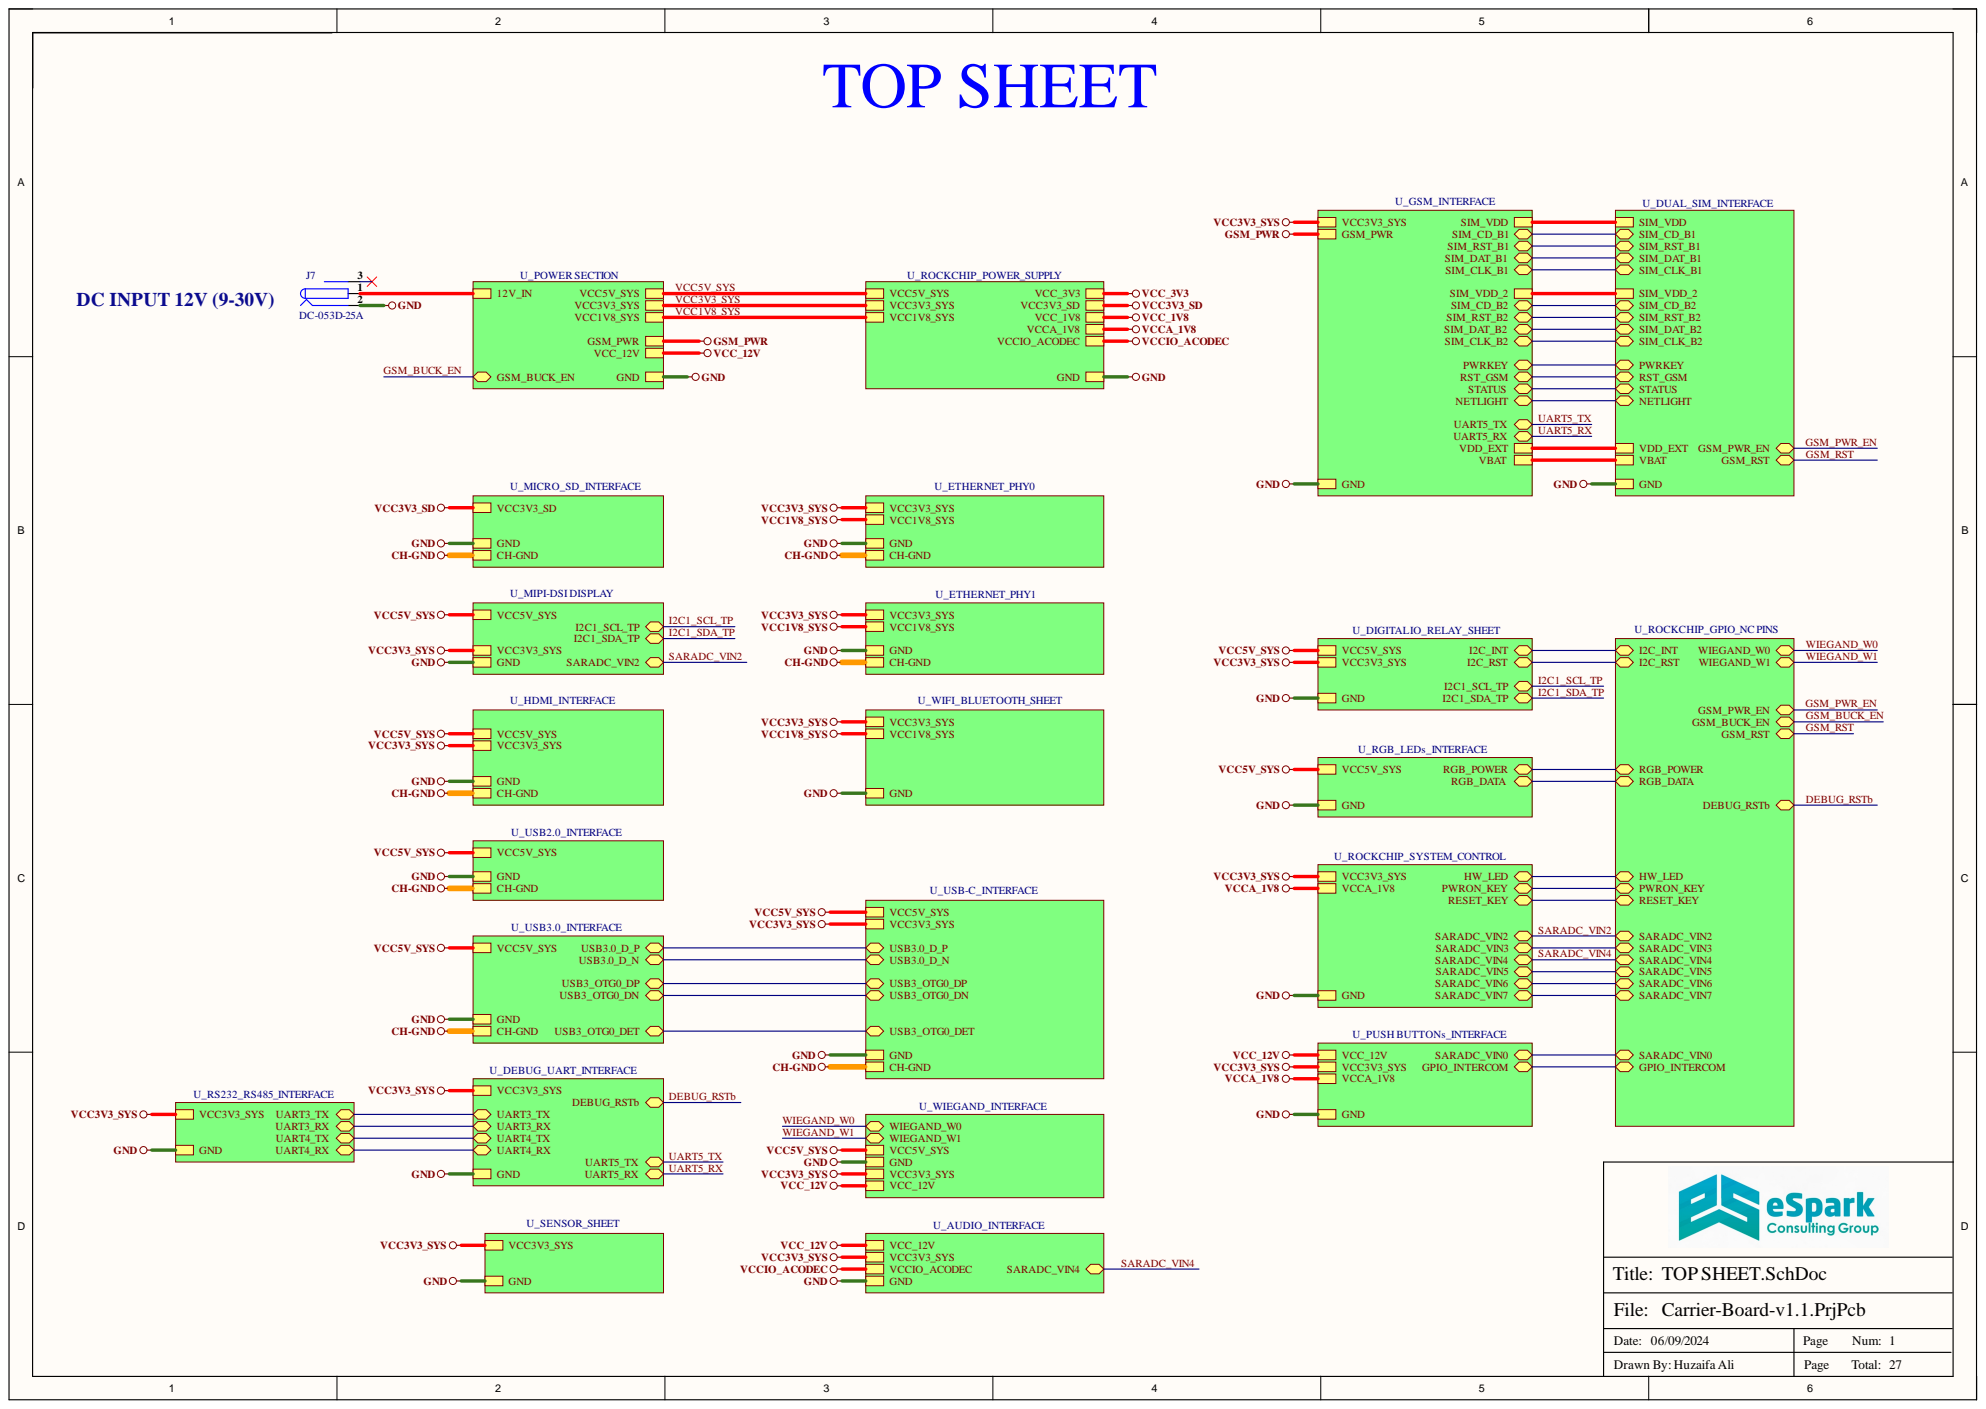
[picture p14: page 1]

Date: 06/09/2024 | Page Num: 1

Drawn By: Huzaifa Ali | Total:

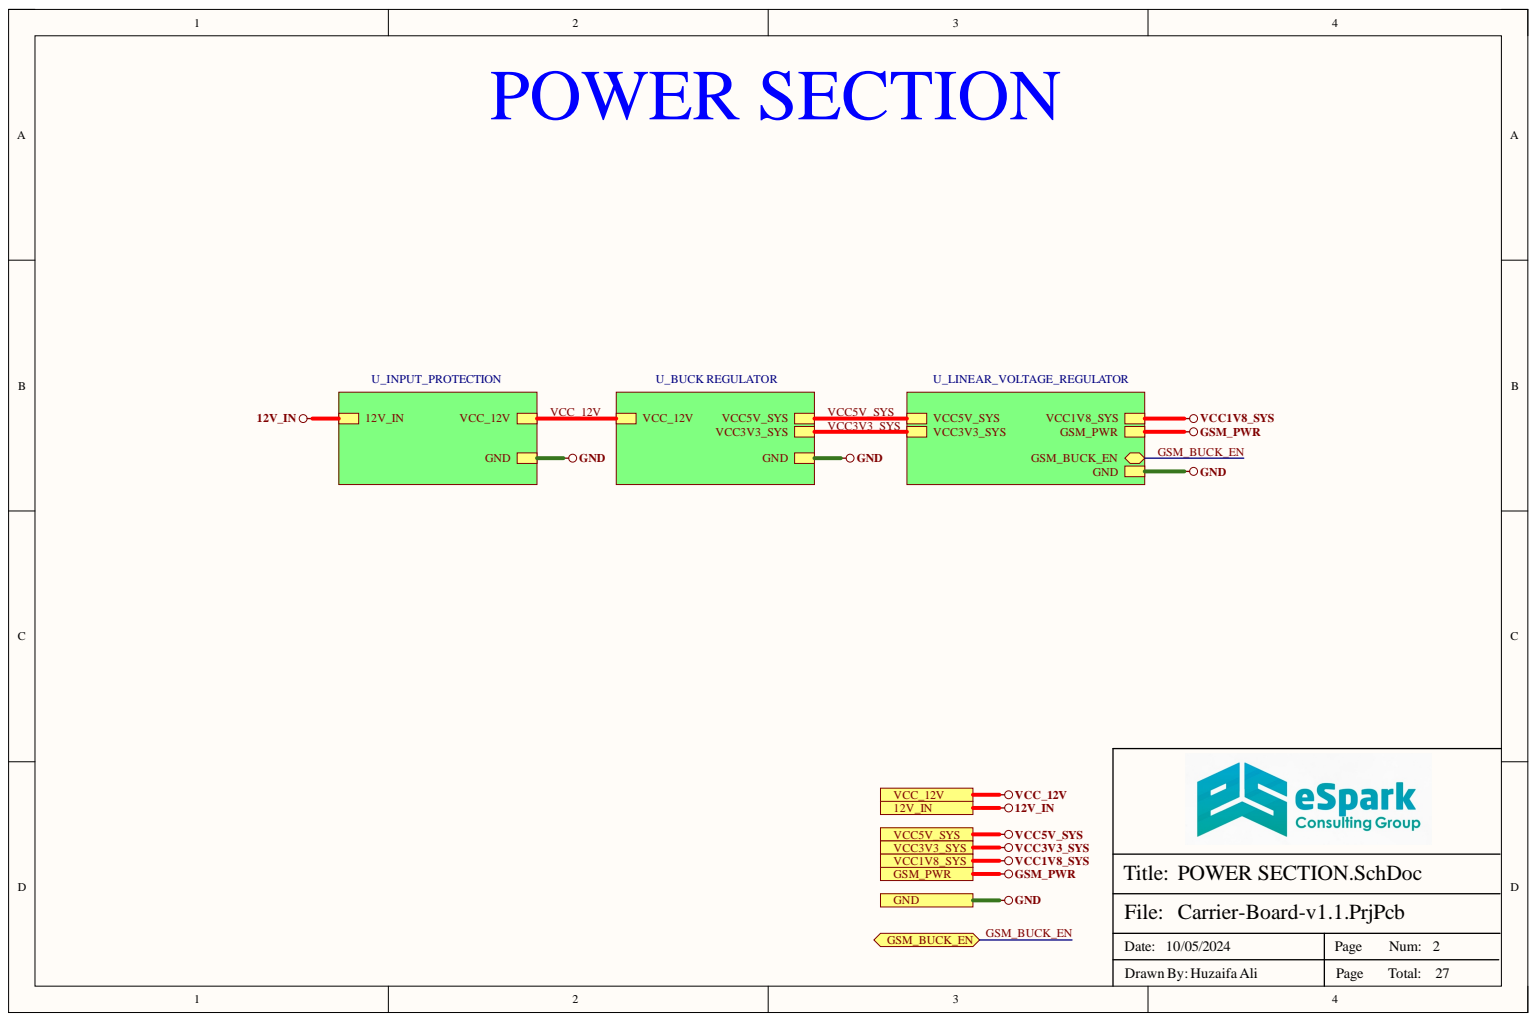
[picture p15: page 2]

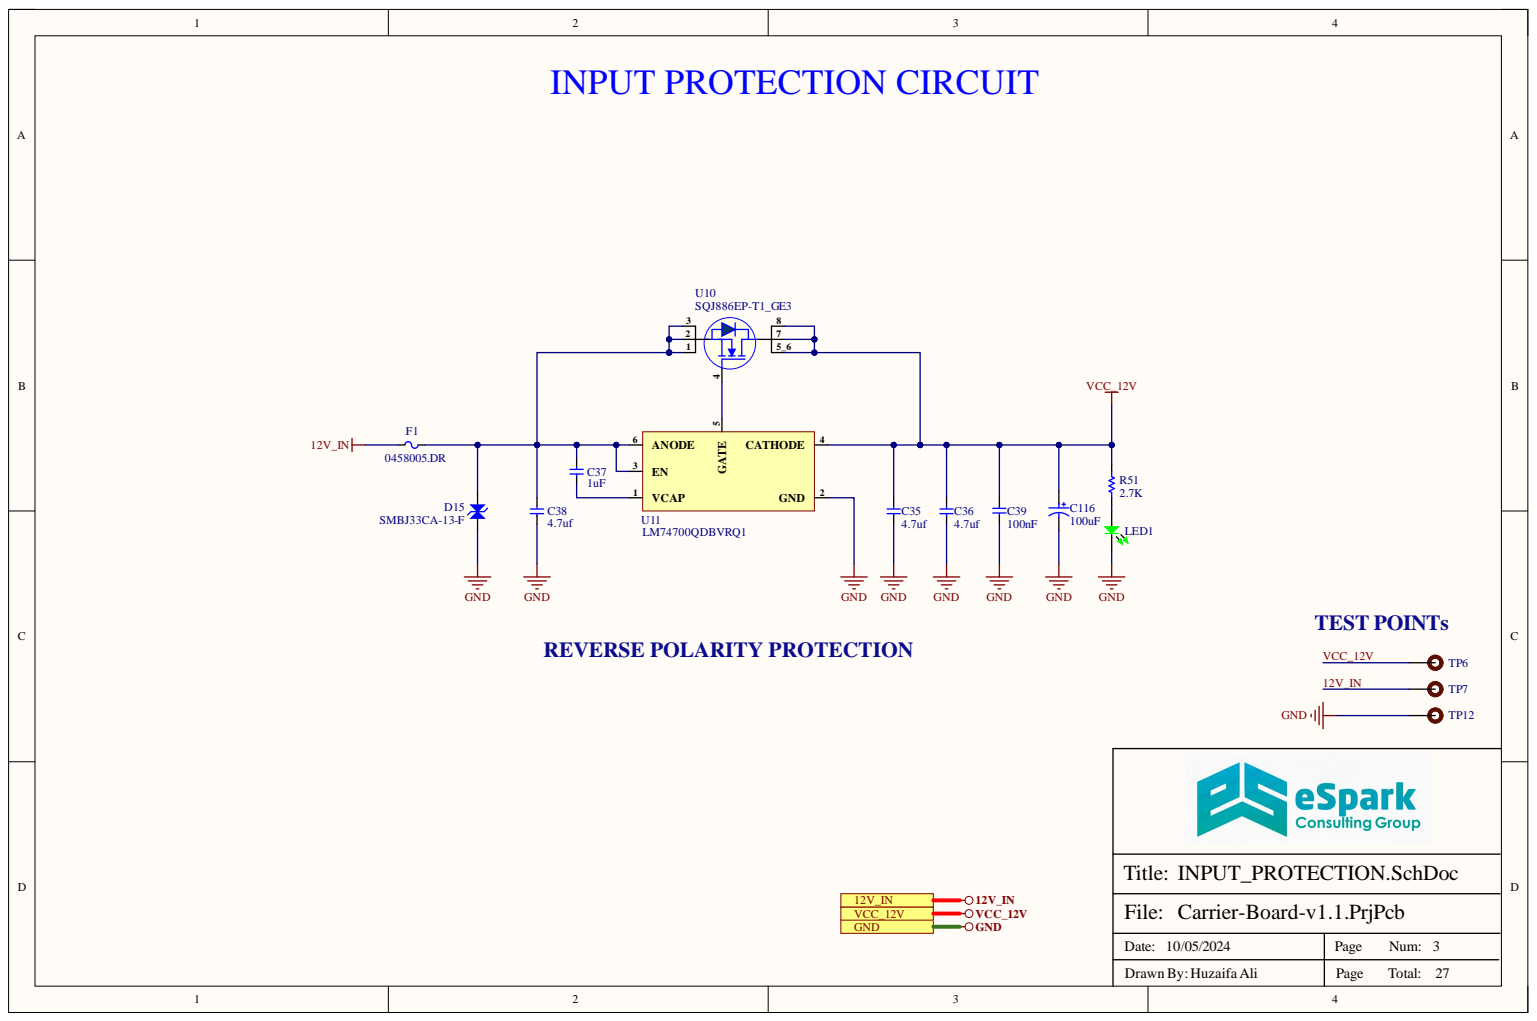
[picture p16: page 3]

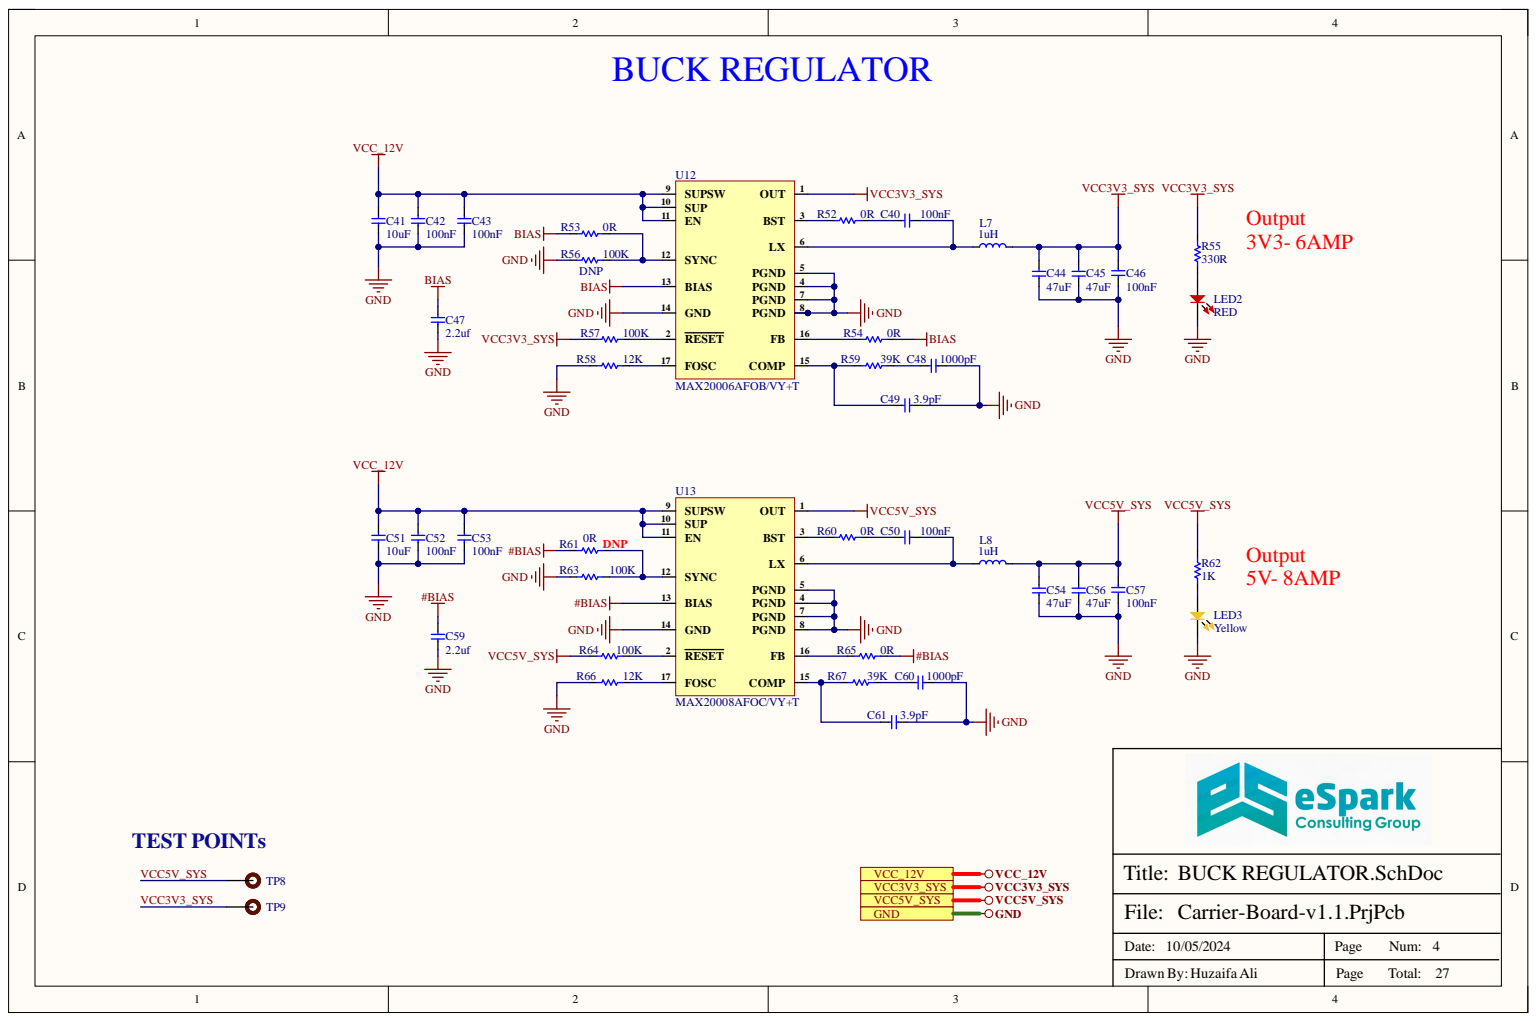
[picture p17: page 4]

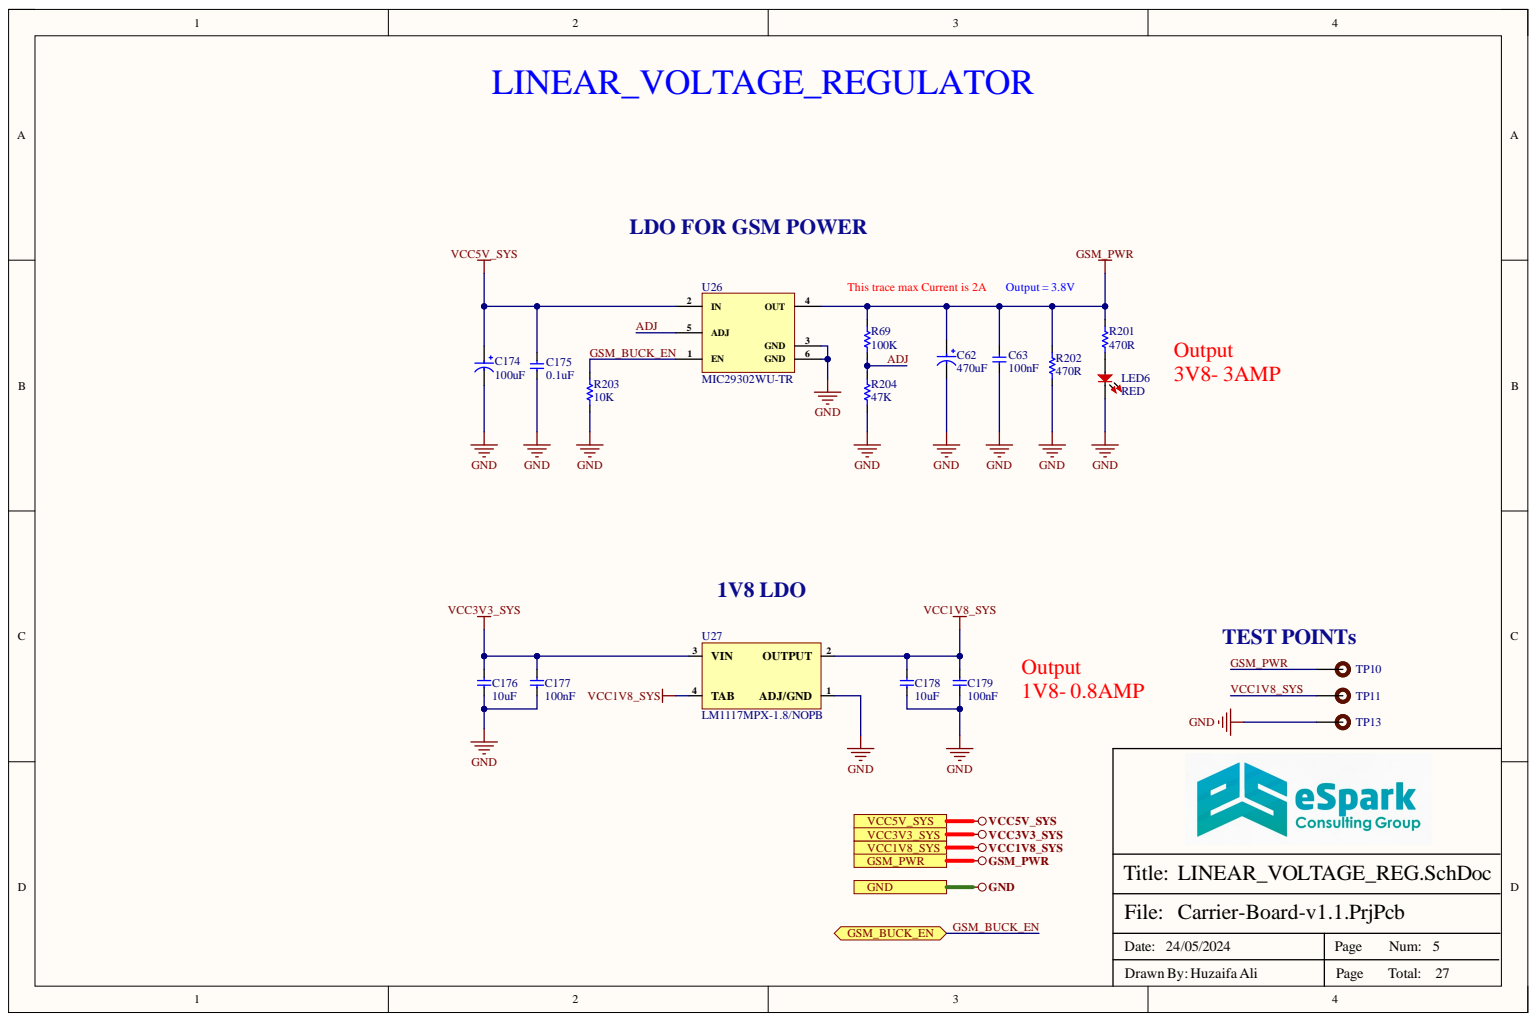
[picture p18: page 5]

LDO FOR GSM POWER

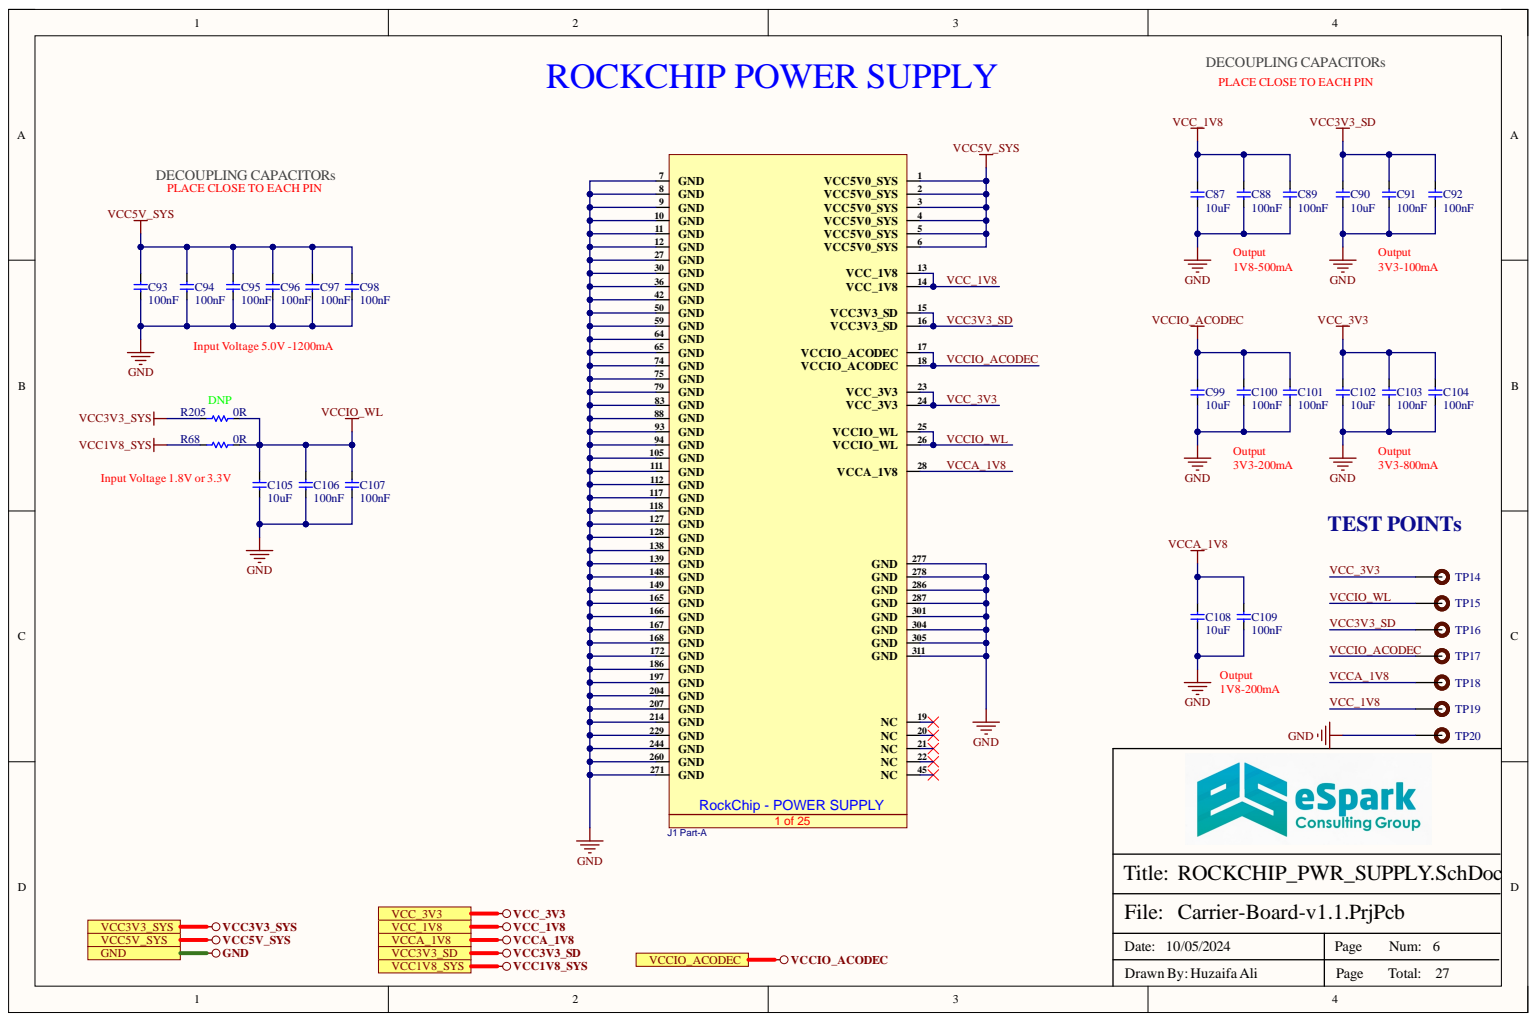
[picture p19: page 6]

DECOUPLING CAPACITORs
PLACE CLOSE TO EACH PIN

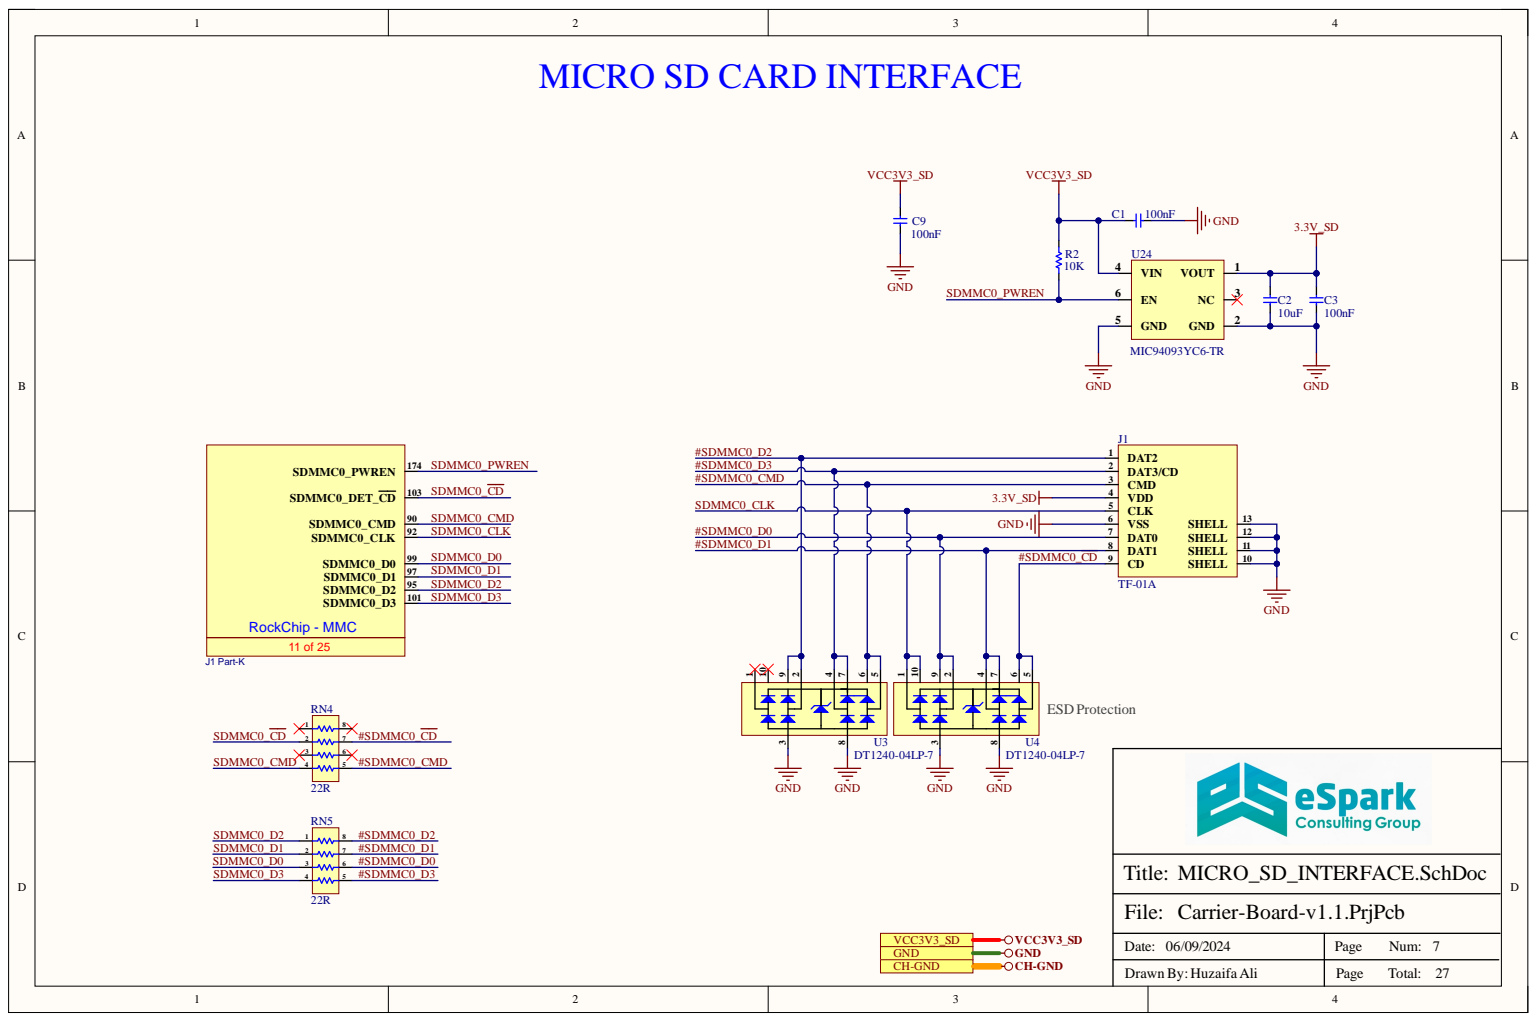
[picture p20: page 7]

MICRO SD CARD INTERFACE

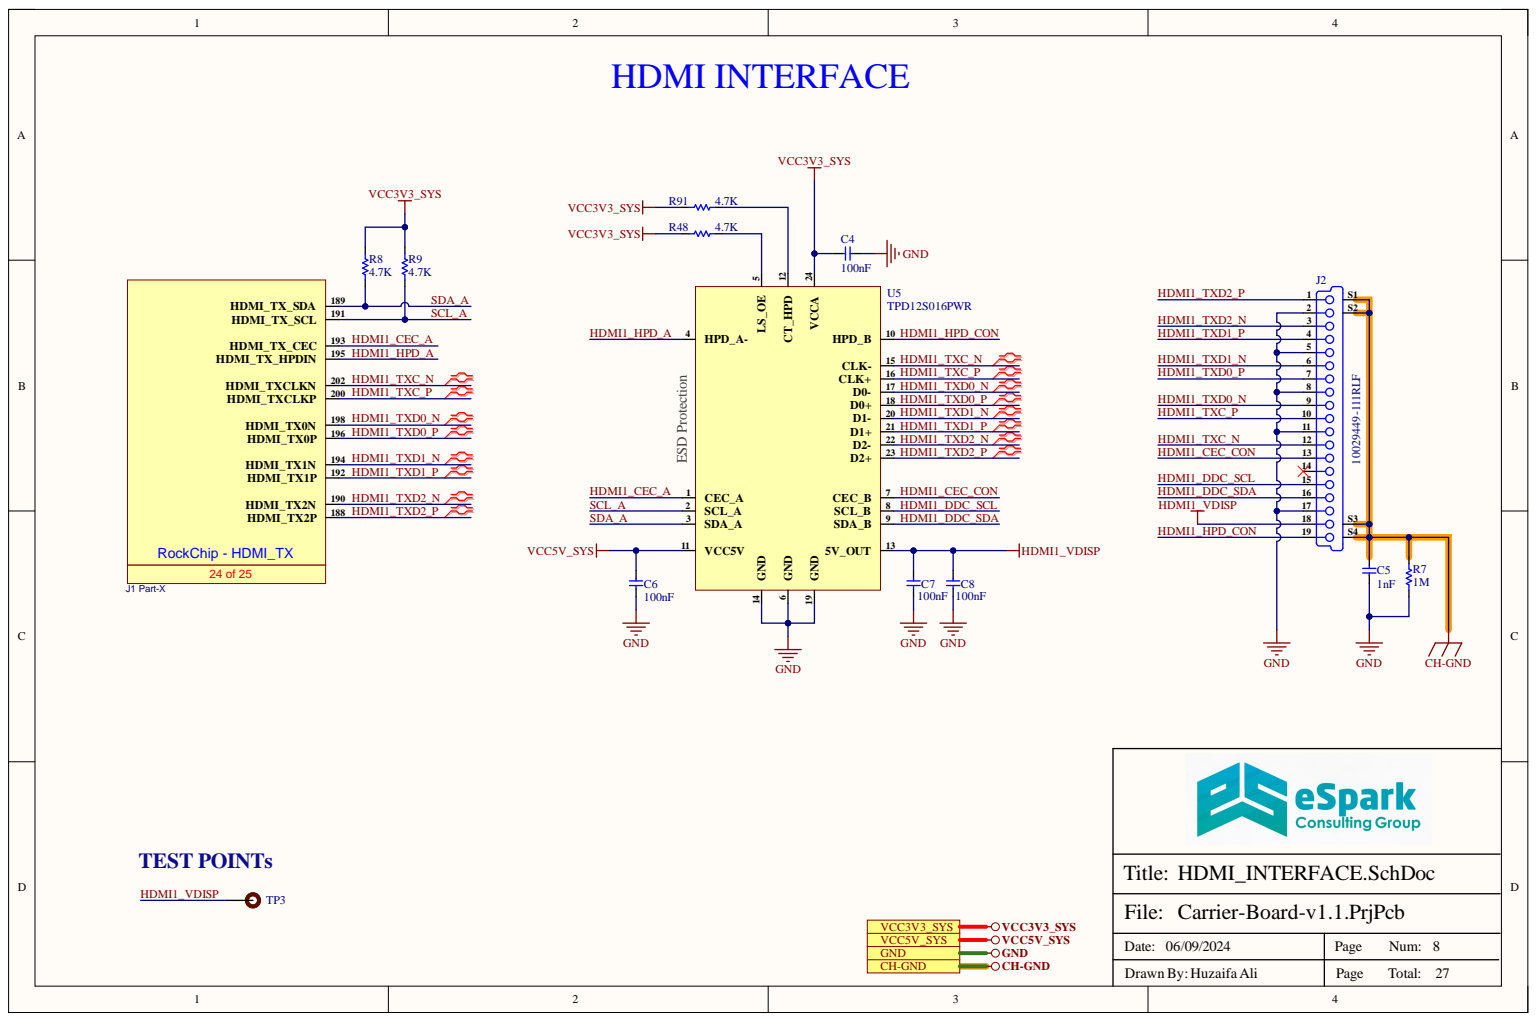
[picture p21: page 8]

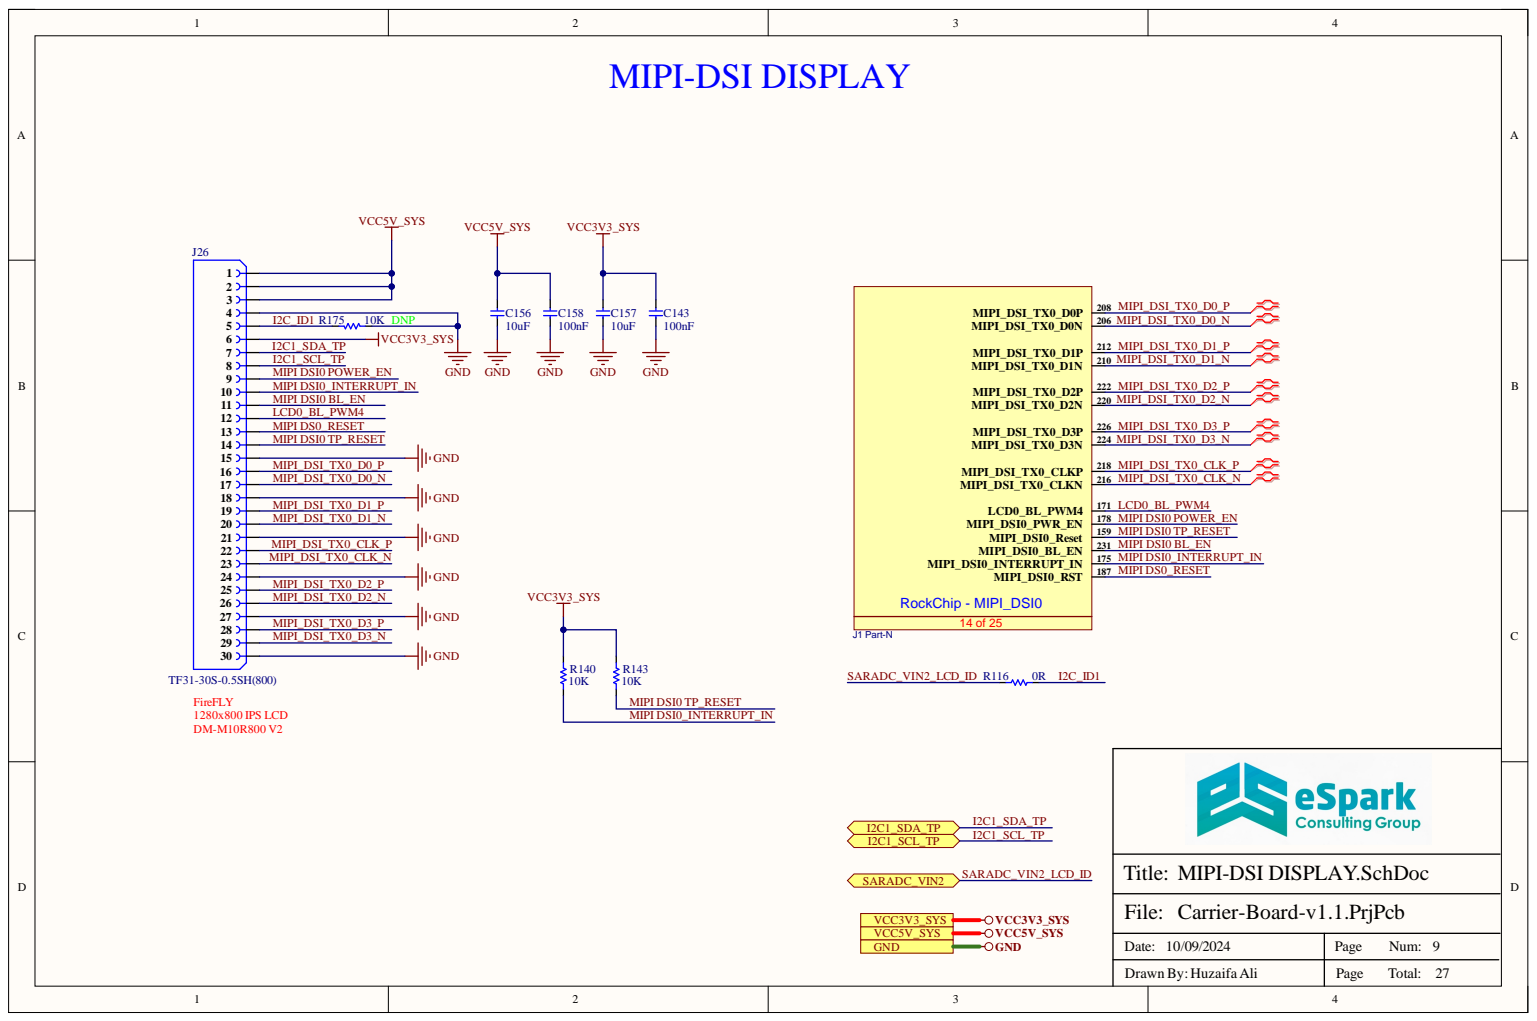
[picture p22: page 9]

MIPI-DSI DISPLAY.SchDoc

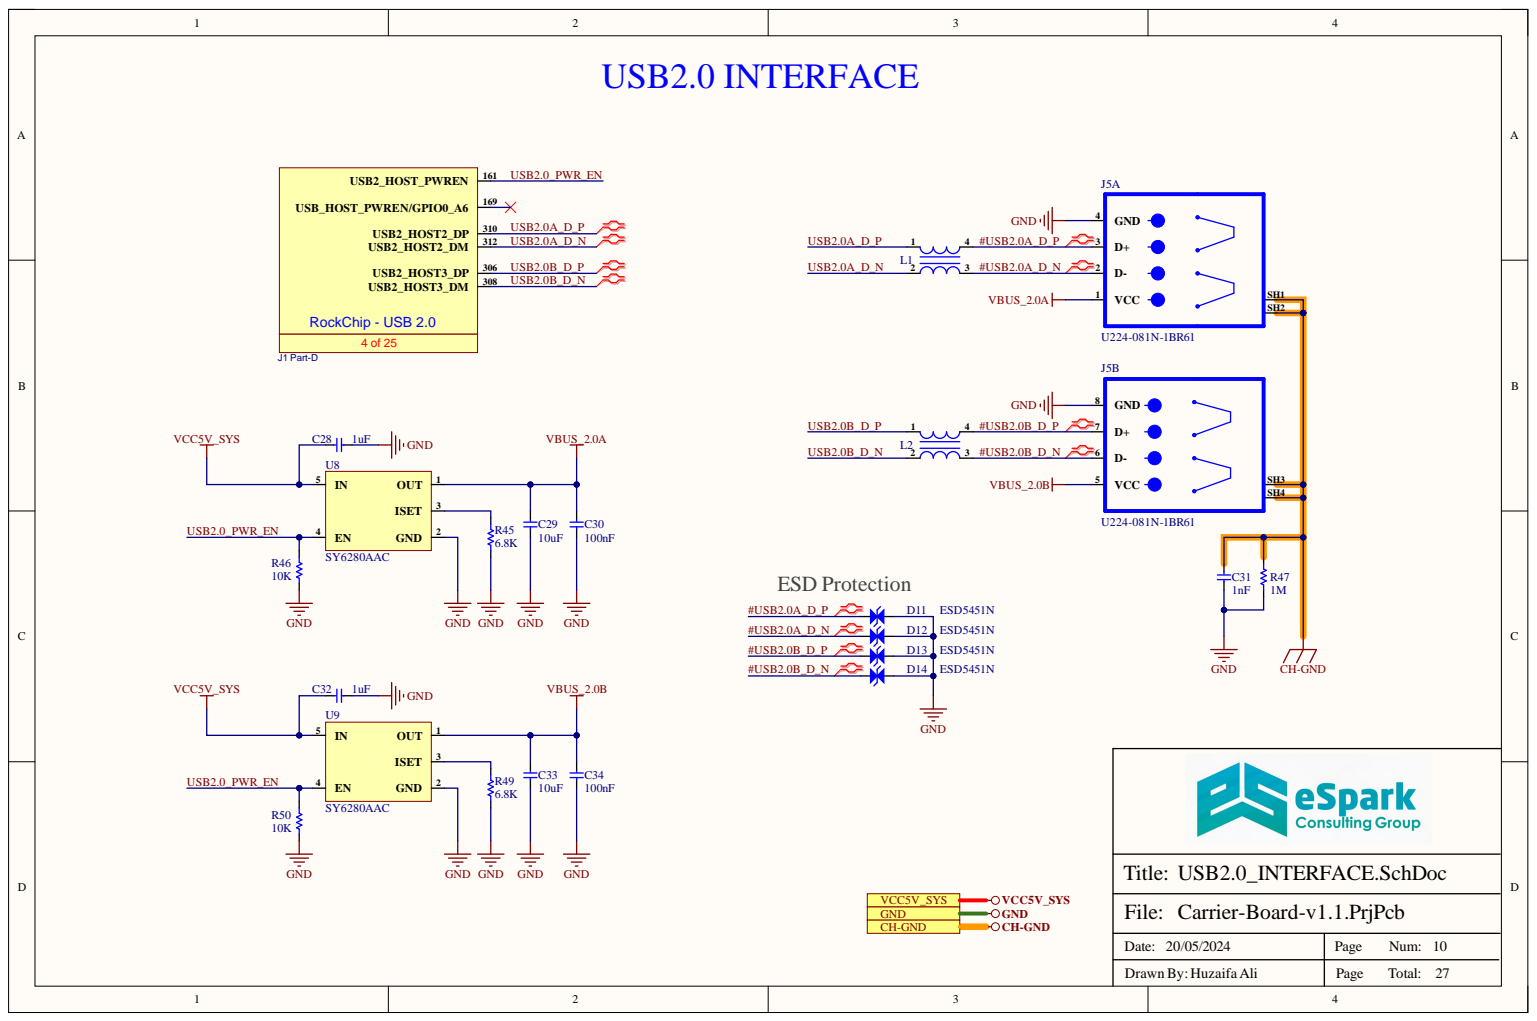
[picture p23: page 10]

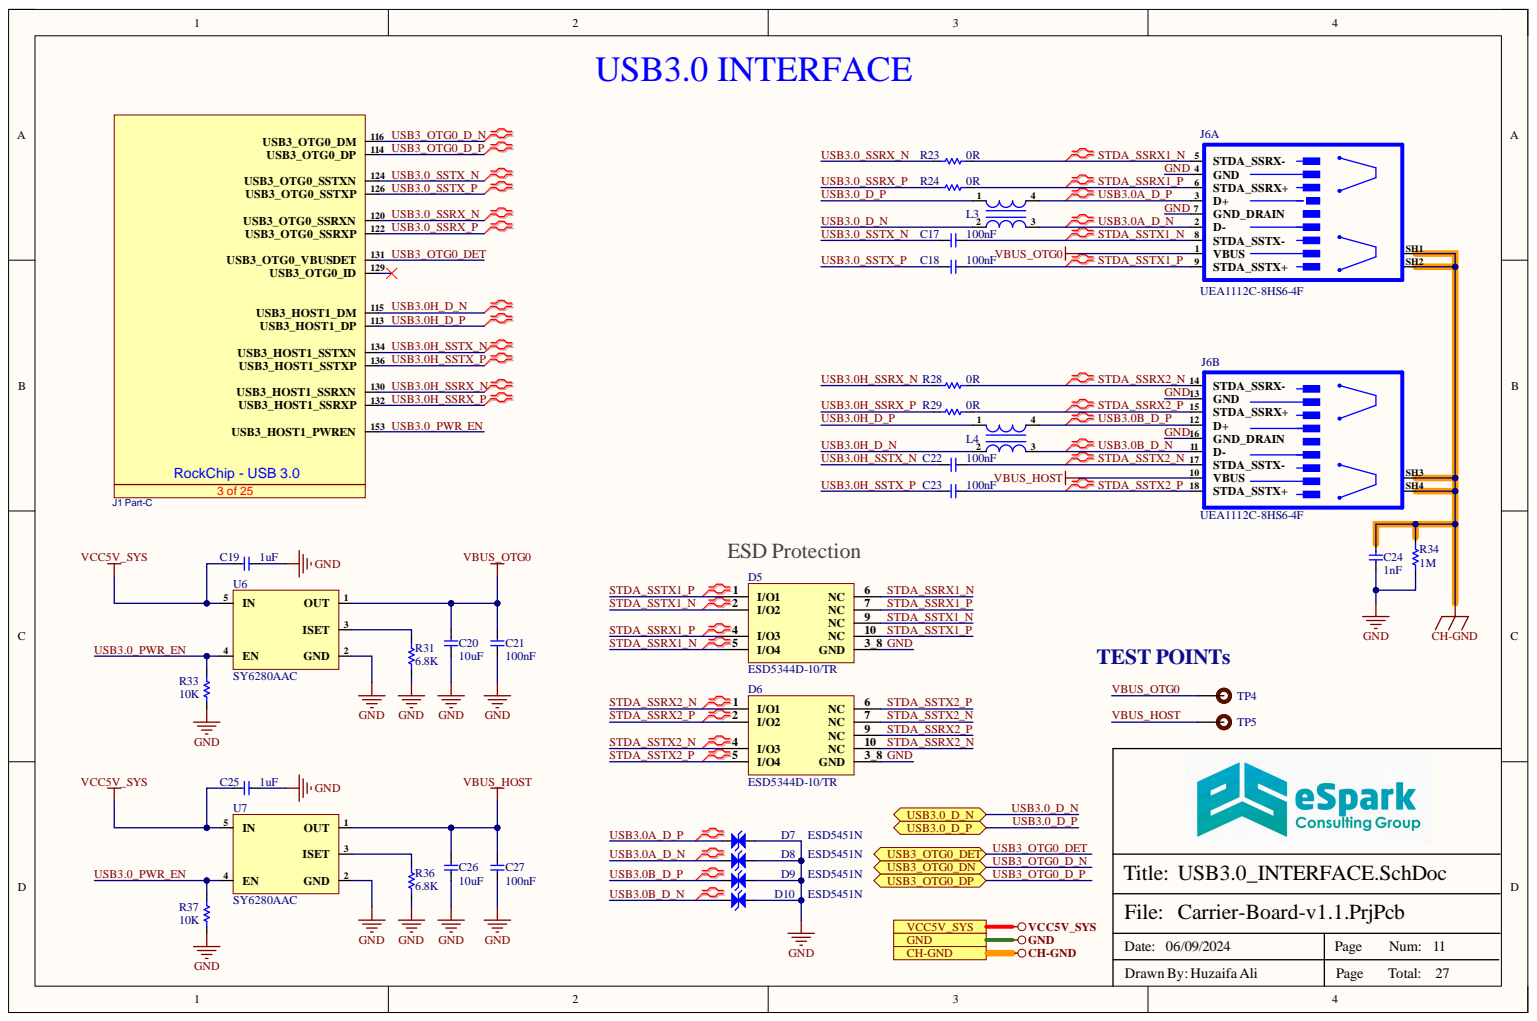
[picture p24: page 11]

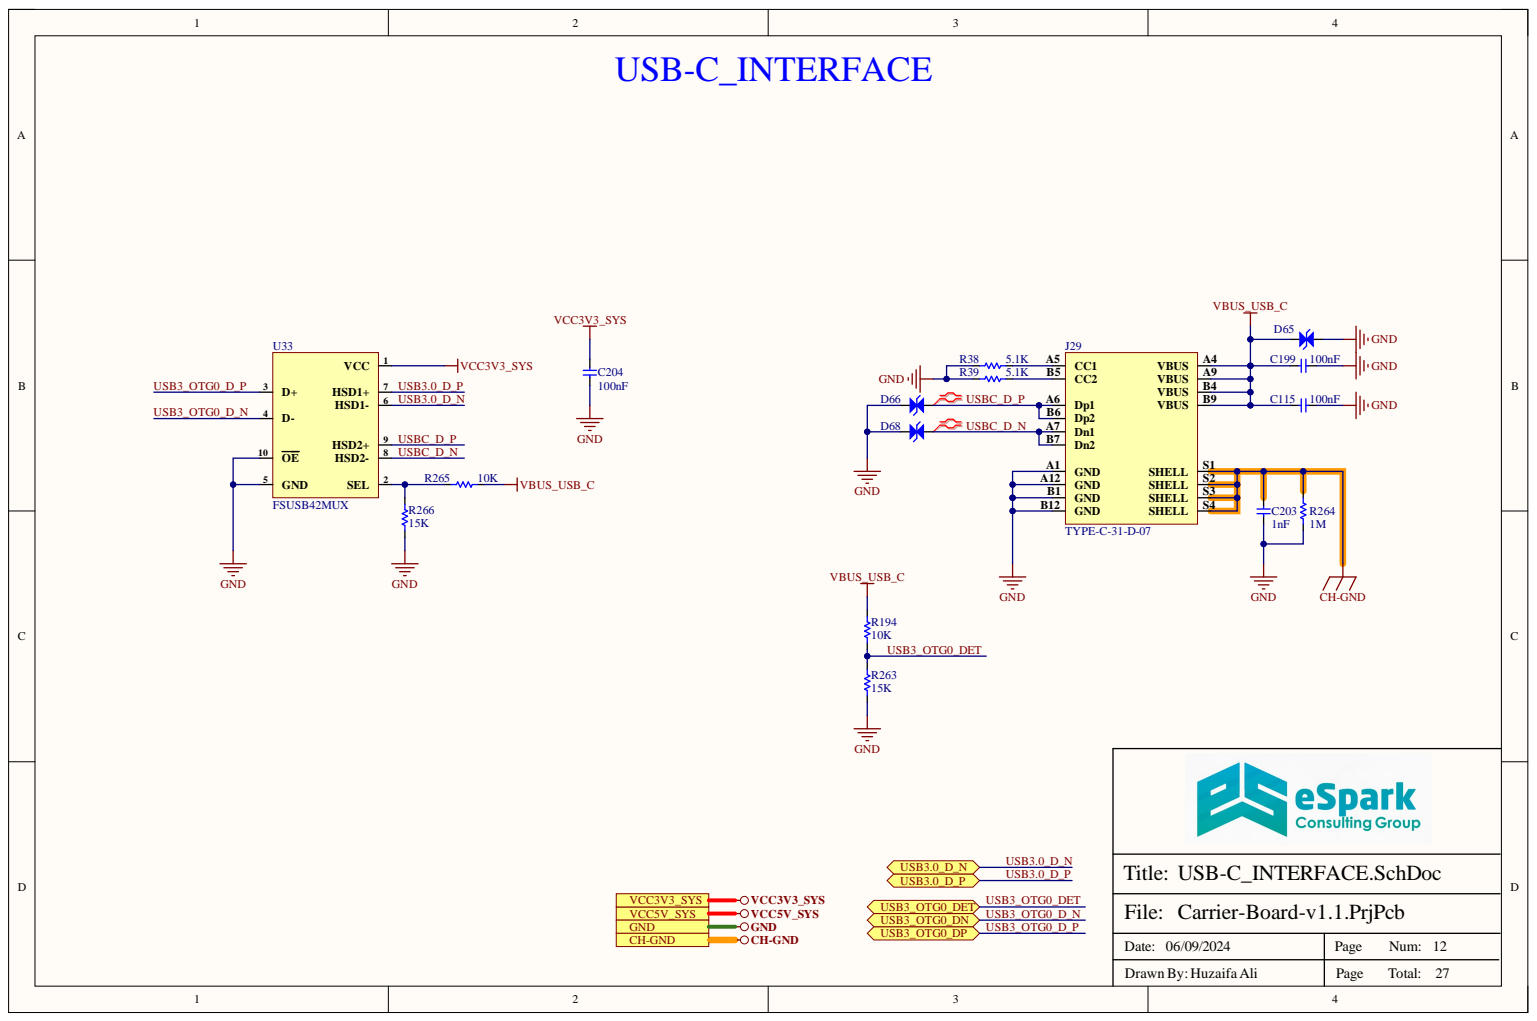
[picture p25: page 12]

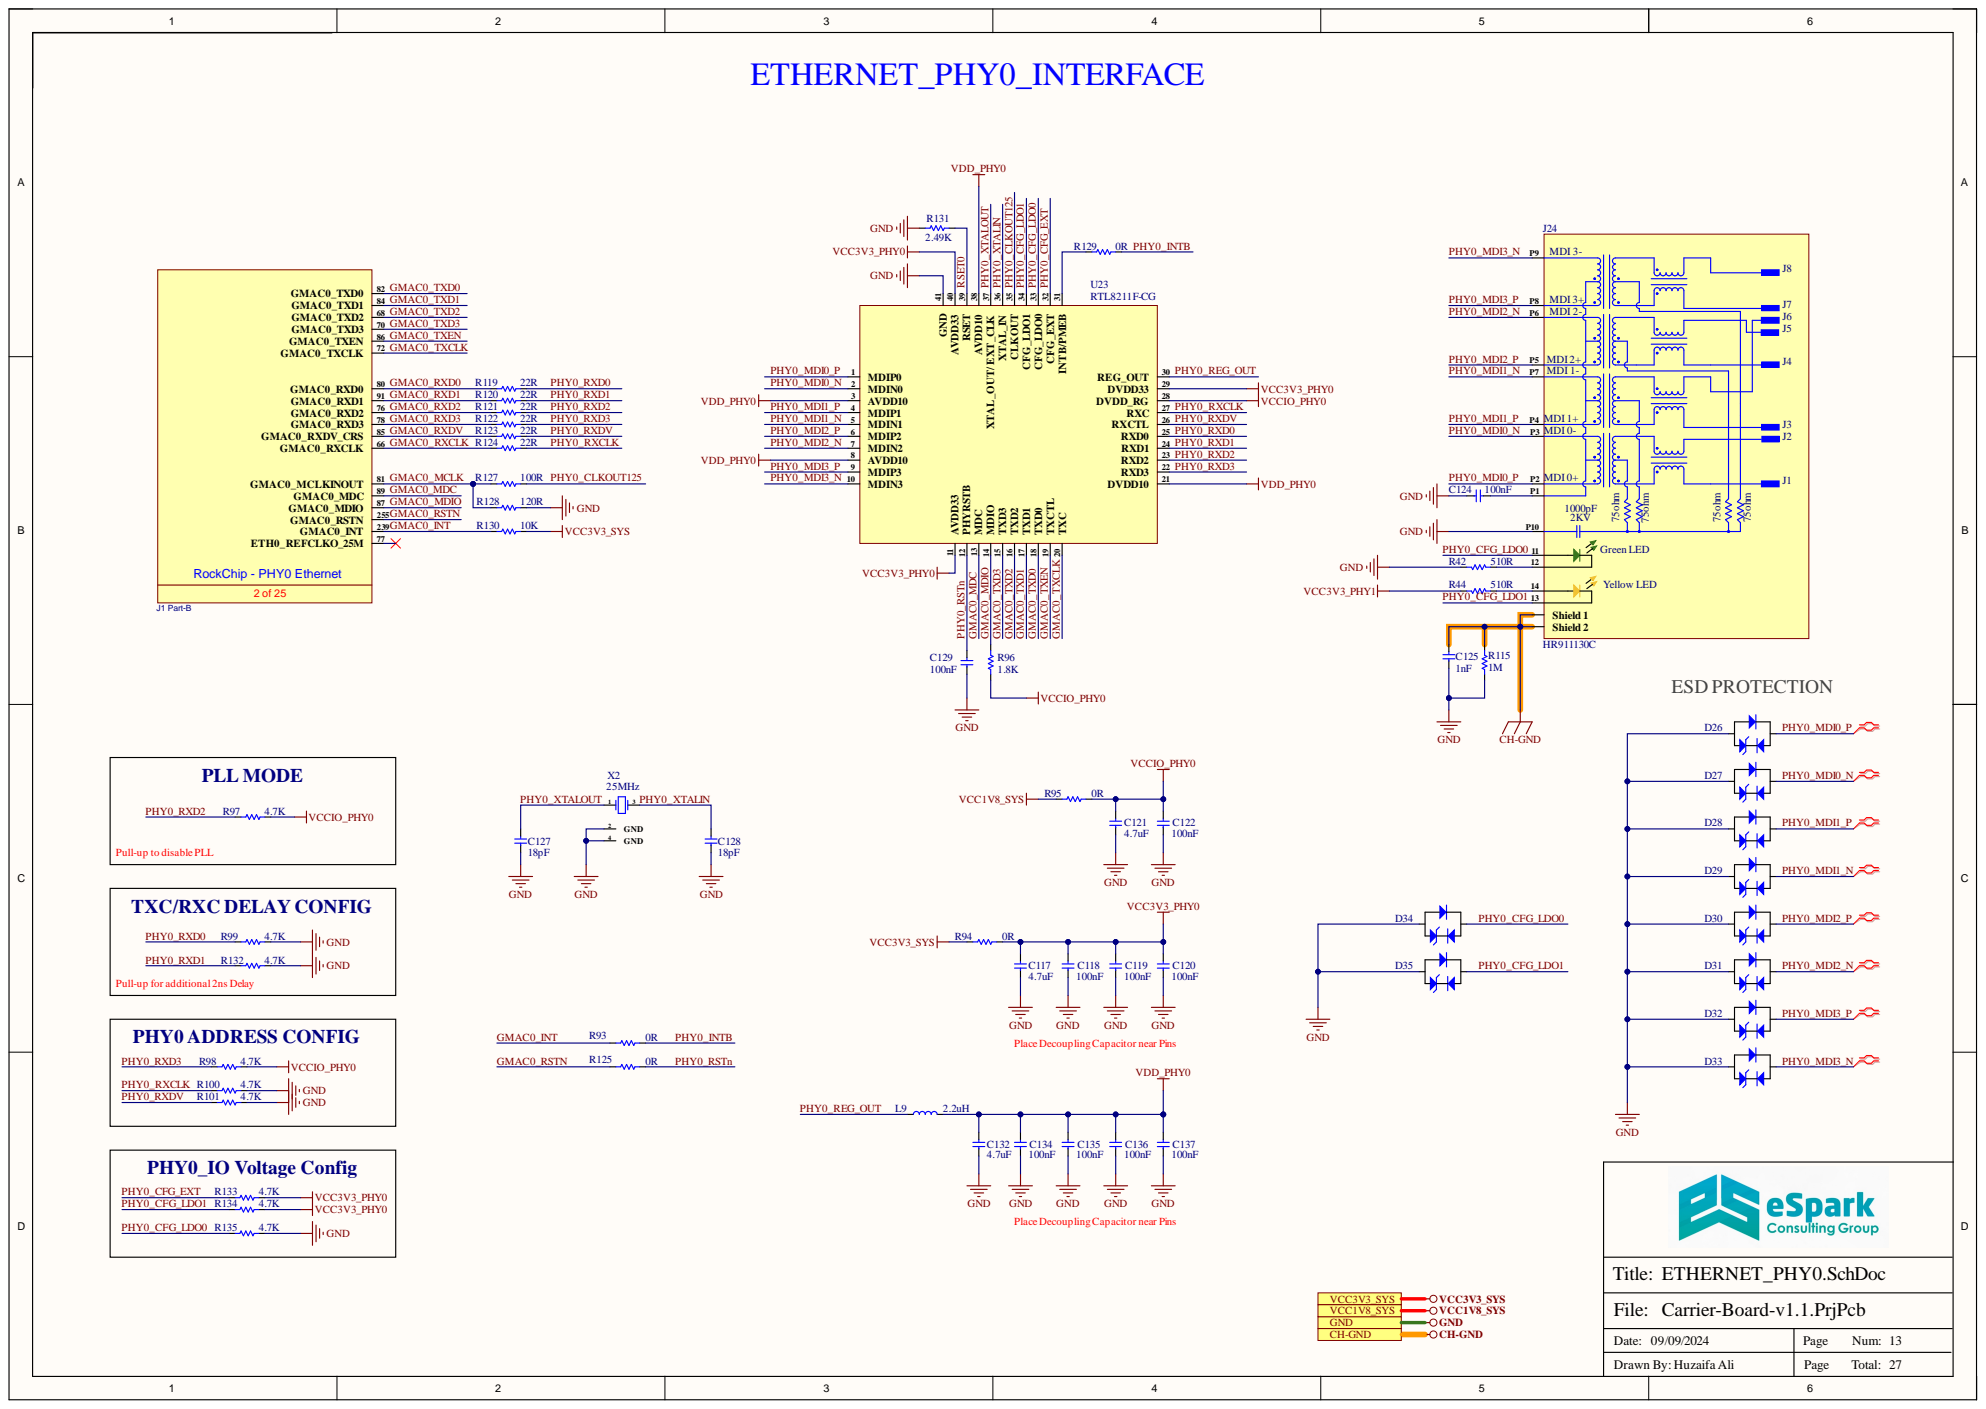
[picture p26: page 13]

30 NTB/PMEB 31 CFG_EXT 32 CFG_LDO0 33 CFG_LDO1 34 CLKOUT 35 XTAL_IN 36 XTAL_OUT/ EXT_CLK 37 AVDD10 38 RSET 39 AVDD33 40 GND 41

Pull-up to disablePLL

TXC/RXC DELAY CONFIG

Pull-up for additional 2ns Delay

Date: 09/09/2024 | Num: 13

Drawn By: Huzaifa Ali | Total:

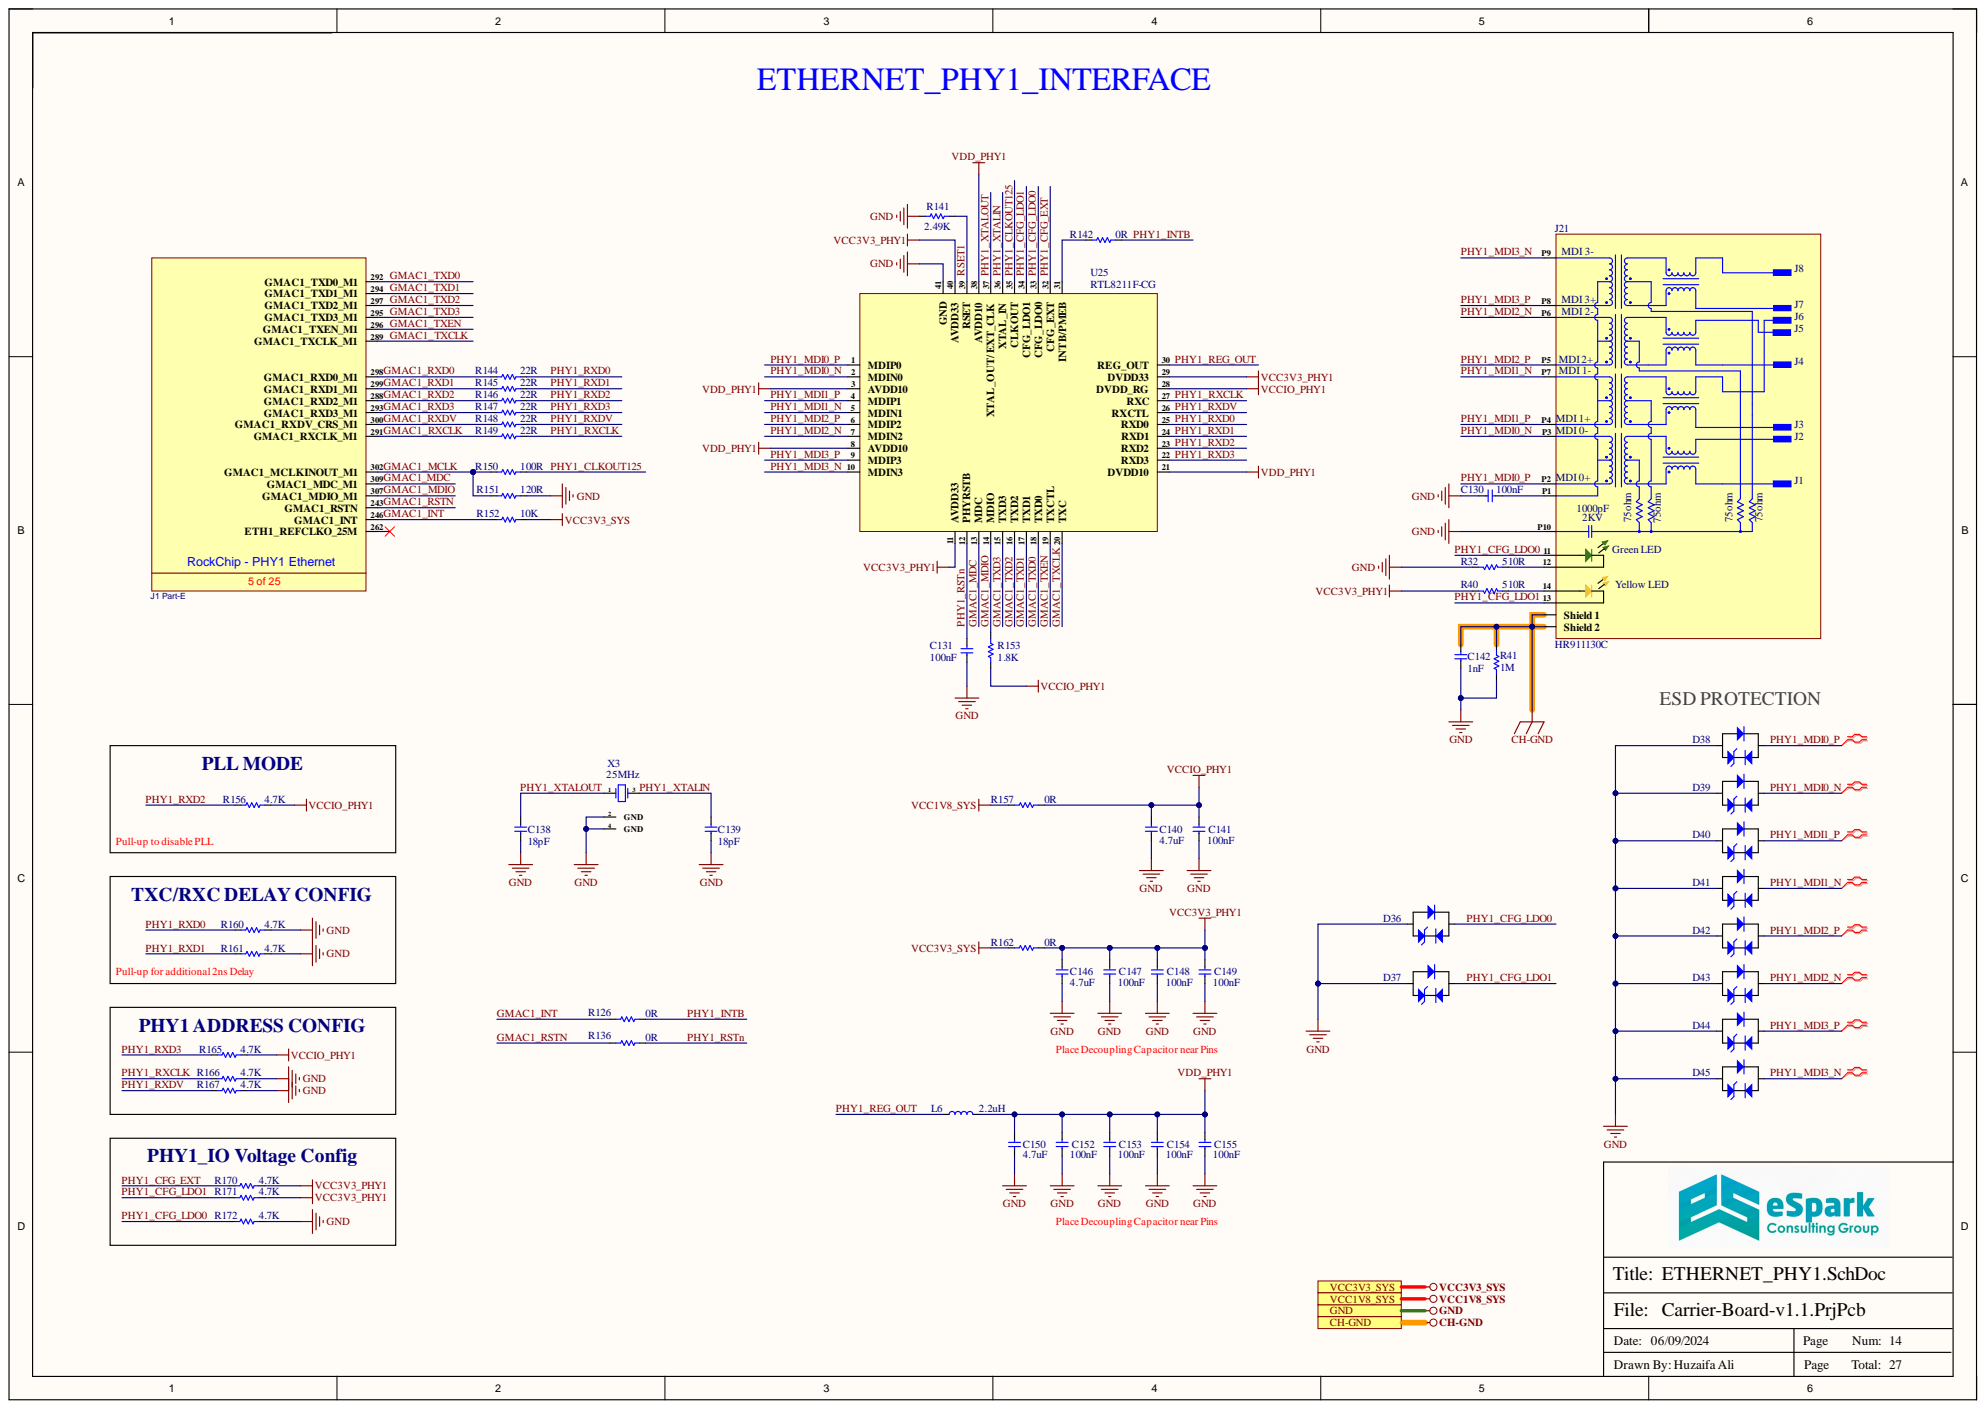
[picture p27: page 14]
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

Pull-up to disablePLL

TXC/RXC DELAY CONFIG

Pull-up for additional 2ns Delay

Date: 06/09/2024 | Num: 14

Drawn By: Huzaifa Ali | Total:

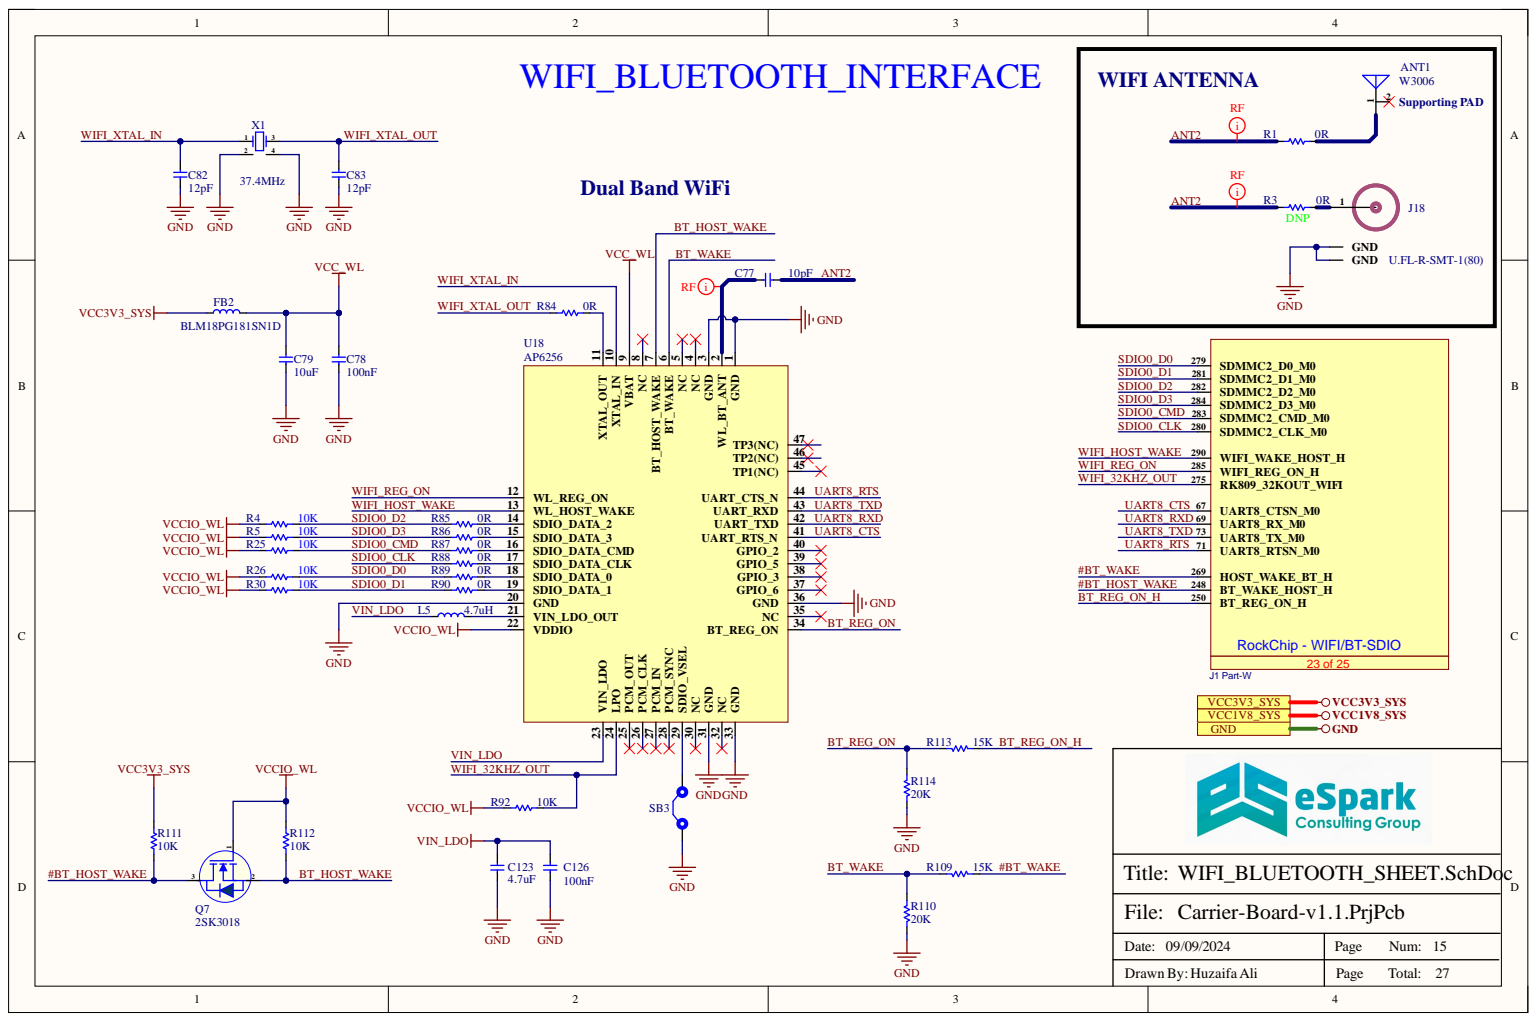
[picture p28: page 15]

GND 1 WL_BT_ANT 2 GND 3 NC 4 NC 5 BT_WAKE 6 BT_H

RockChip - WIFI/BT-SDIO

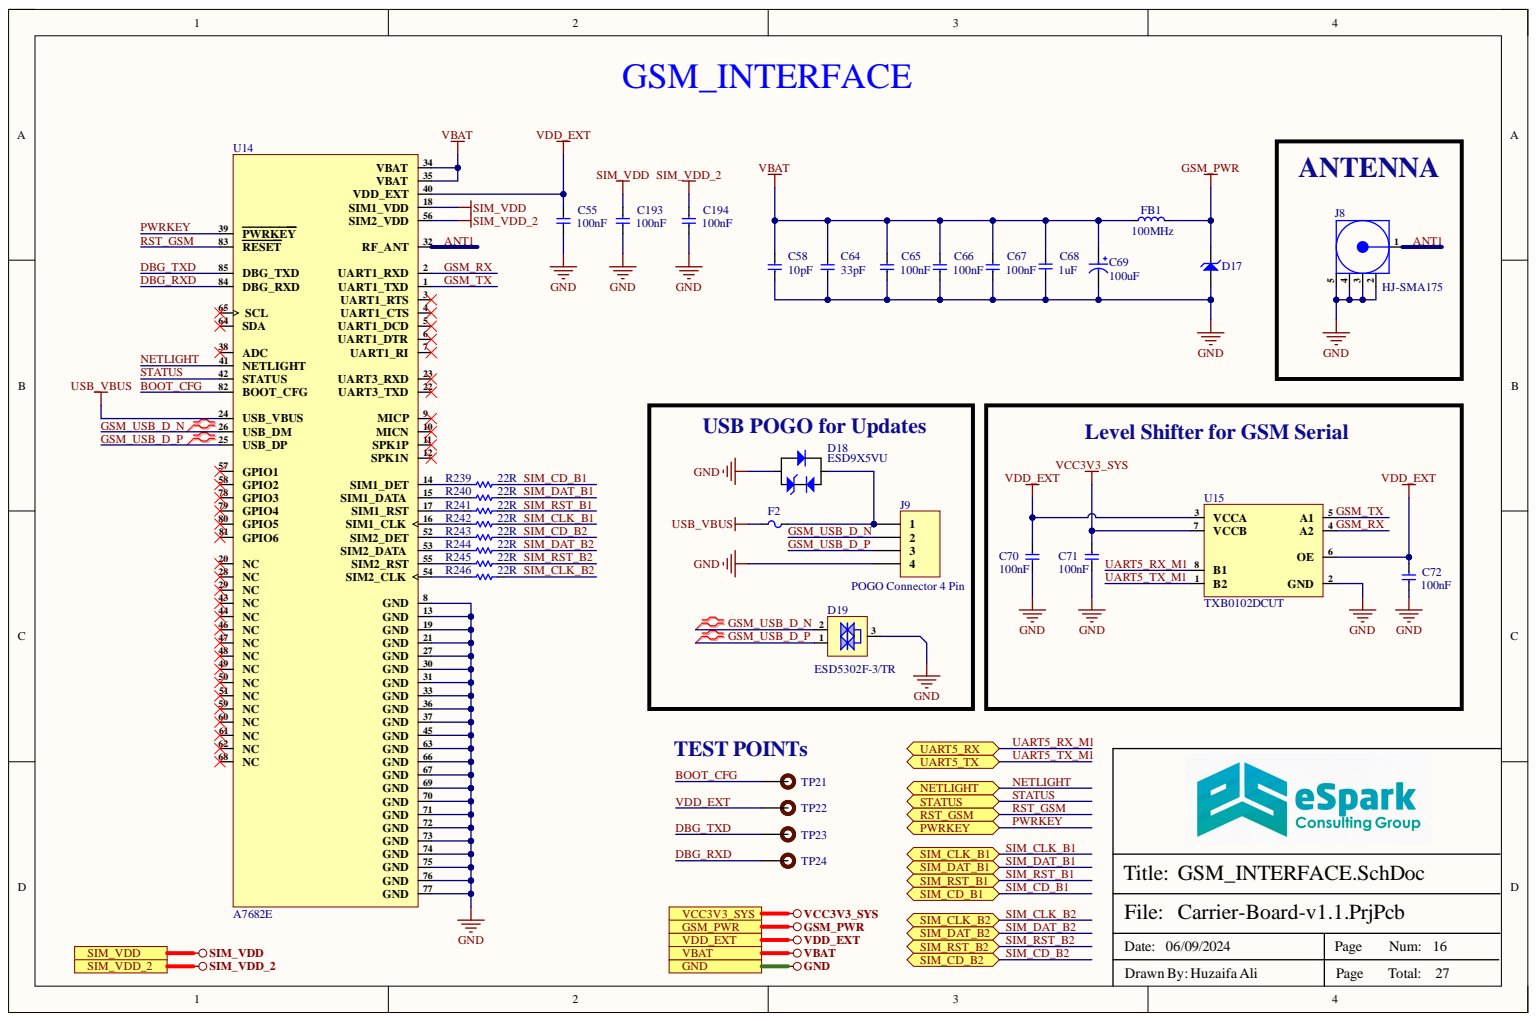
[picture p29: page 16]

USB POGO for Updates

Level Shifter for GSM Serial

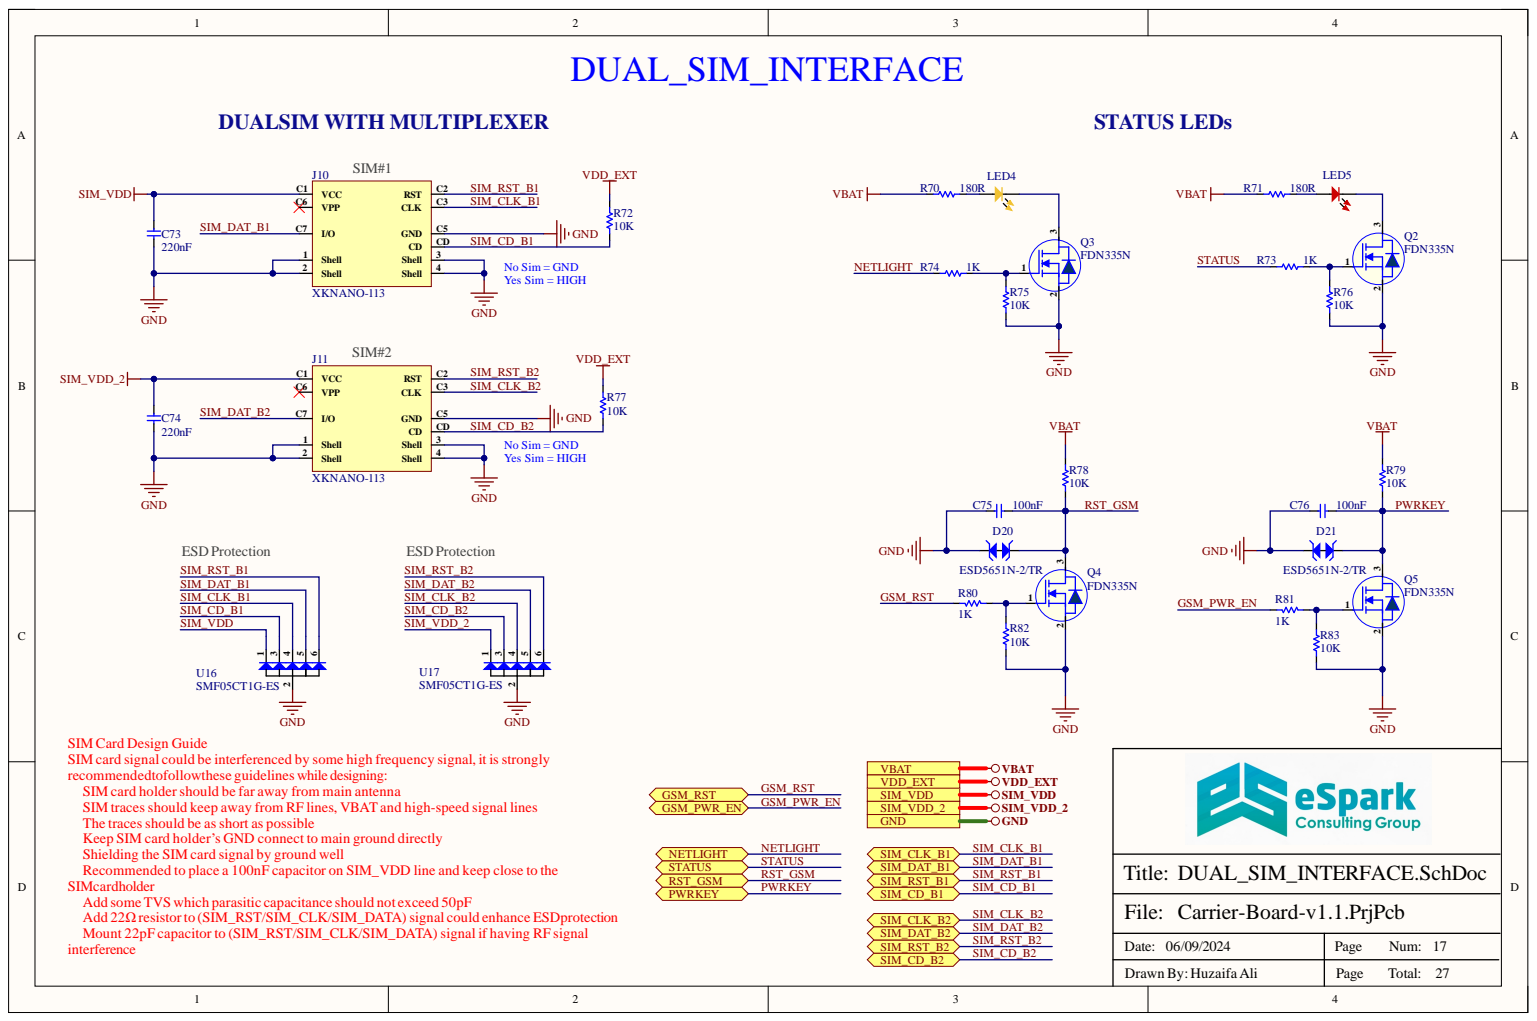
[picture p30: page 17]

SIM Card Design Guide
SIM card signal could be interferenced by some high frequency signal, it is strongly
recommendedtofollowthese guidelines while designing:
SIM card holder should be far away from main antenna
SIM traces should keep away from RF lines, VBATand high-speed signal lines
The traces should be as short as possible
Keep SIM card holder’s GND connect to main ground directly
Shielding the SIM card signal by ground well
Recommended to place a 100nF capacitor on SIM_VDD line and keep close to the
SIMcardholder
Add some TVS which parasitic capacitance should not exceed 50pF
Add 22Ω resistor to (SIM_RST/SIM_CLK/SIM_DATA) signal could enhance ESDprotection
Mount 22pF capacitor to (SIM_RST/SIM_CLK/SIM_DATA) signal if having RF signal
interference

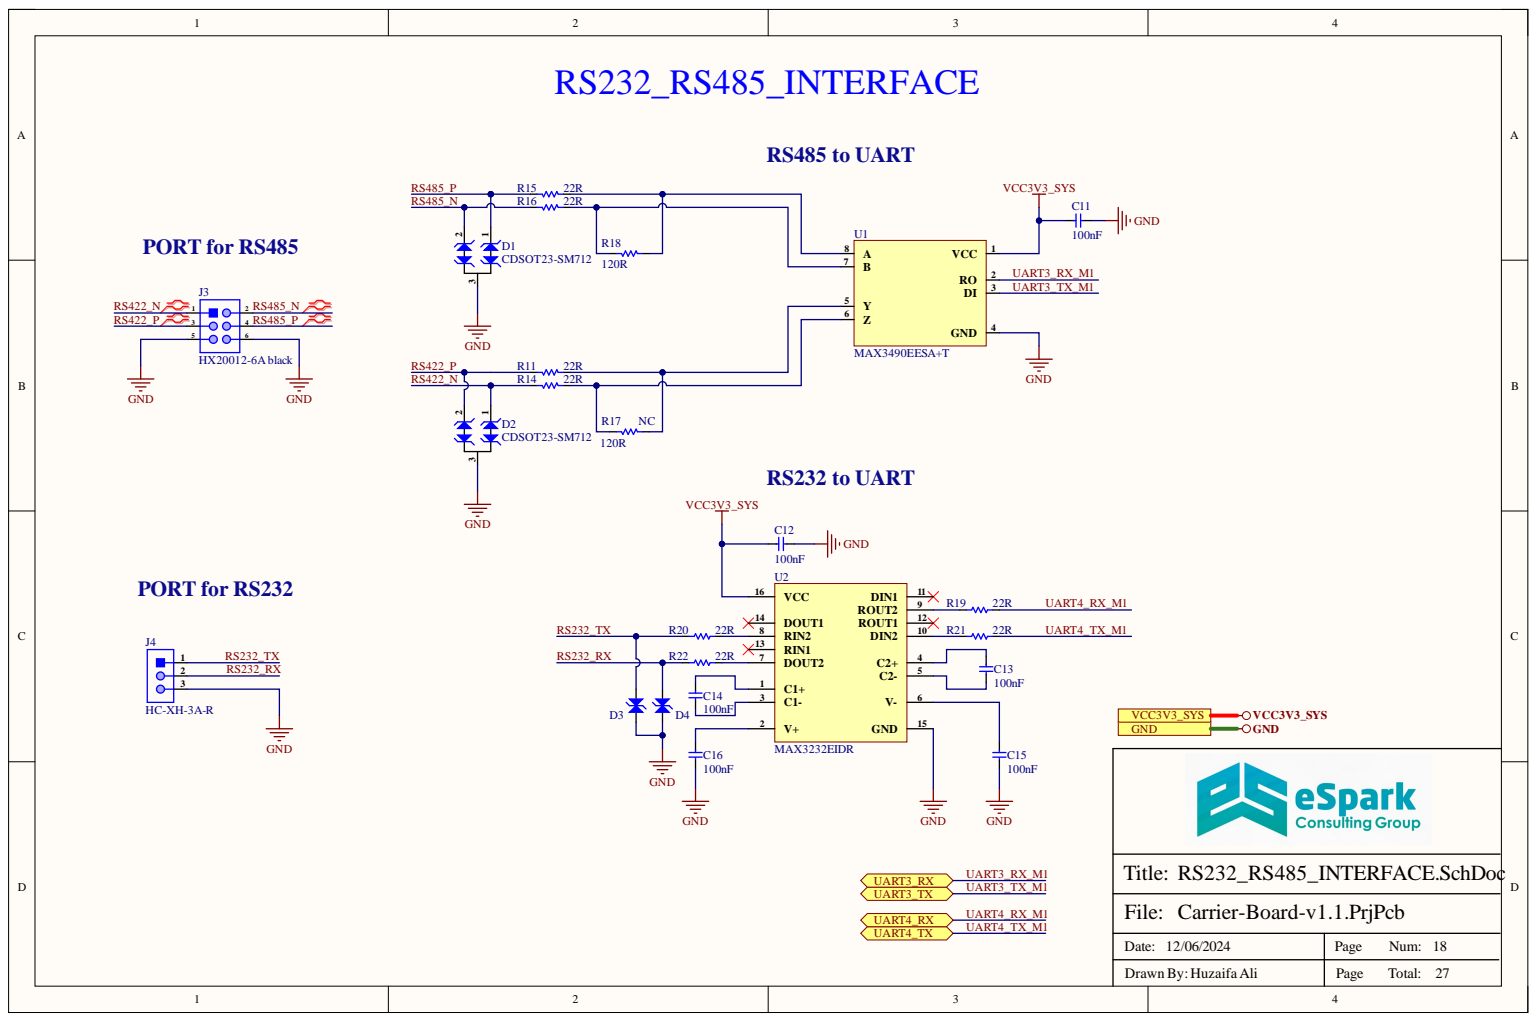
[picture p31: page 18]

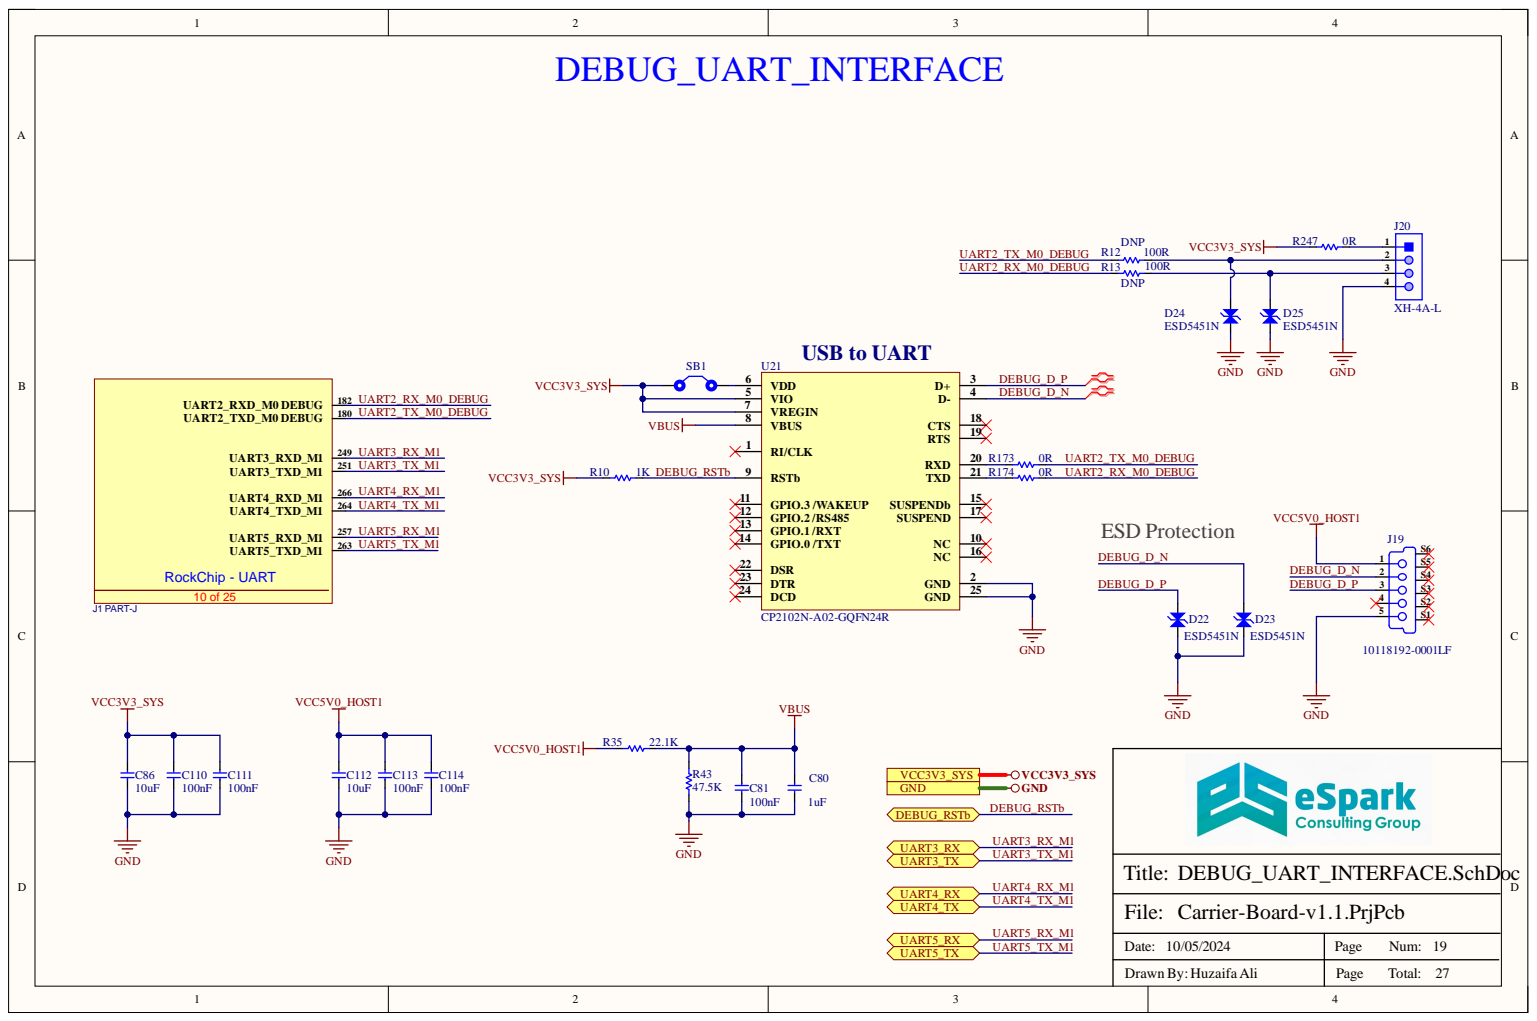
[picture p32: page 19]

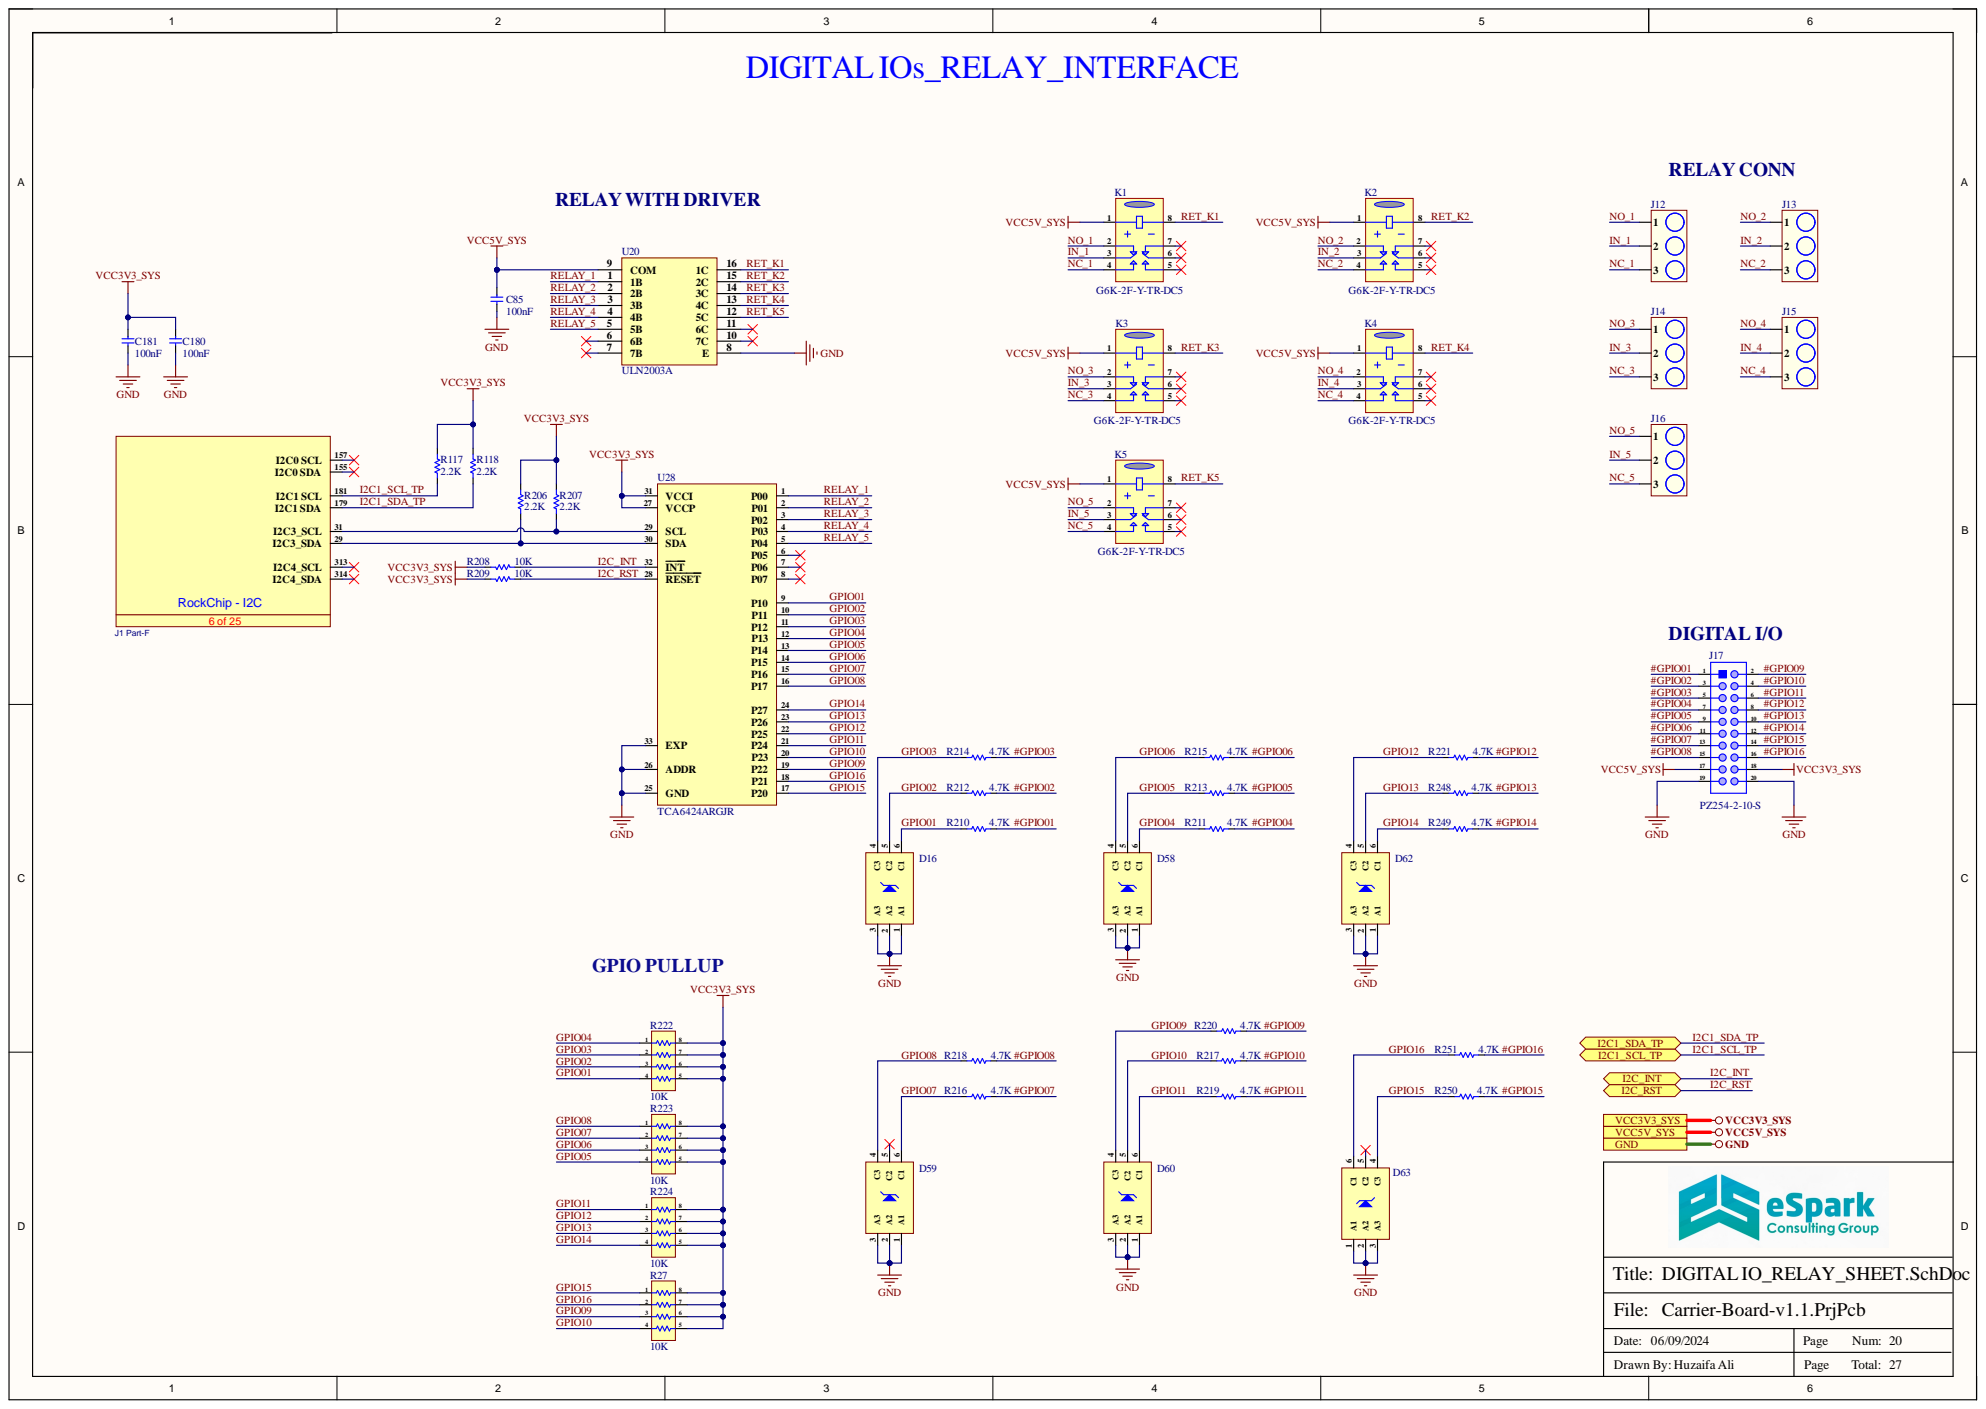
[picture p33: page 20]

Date: 06/09/2024 | Num: 20

Drawn By: Huzaifa Ali | Total:

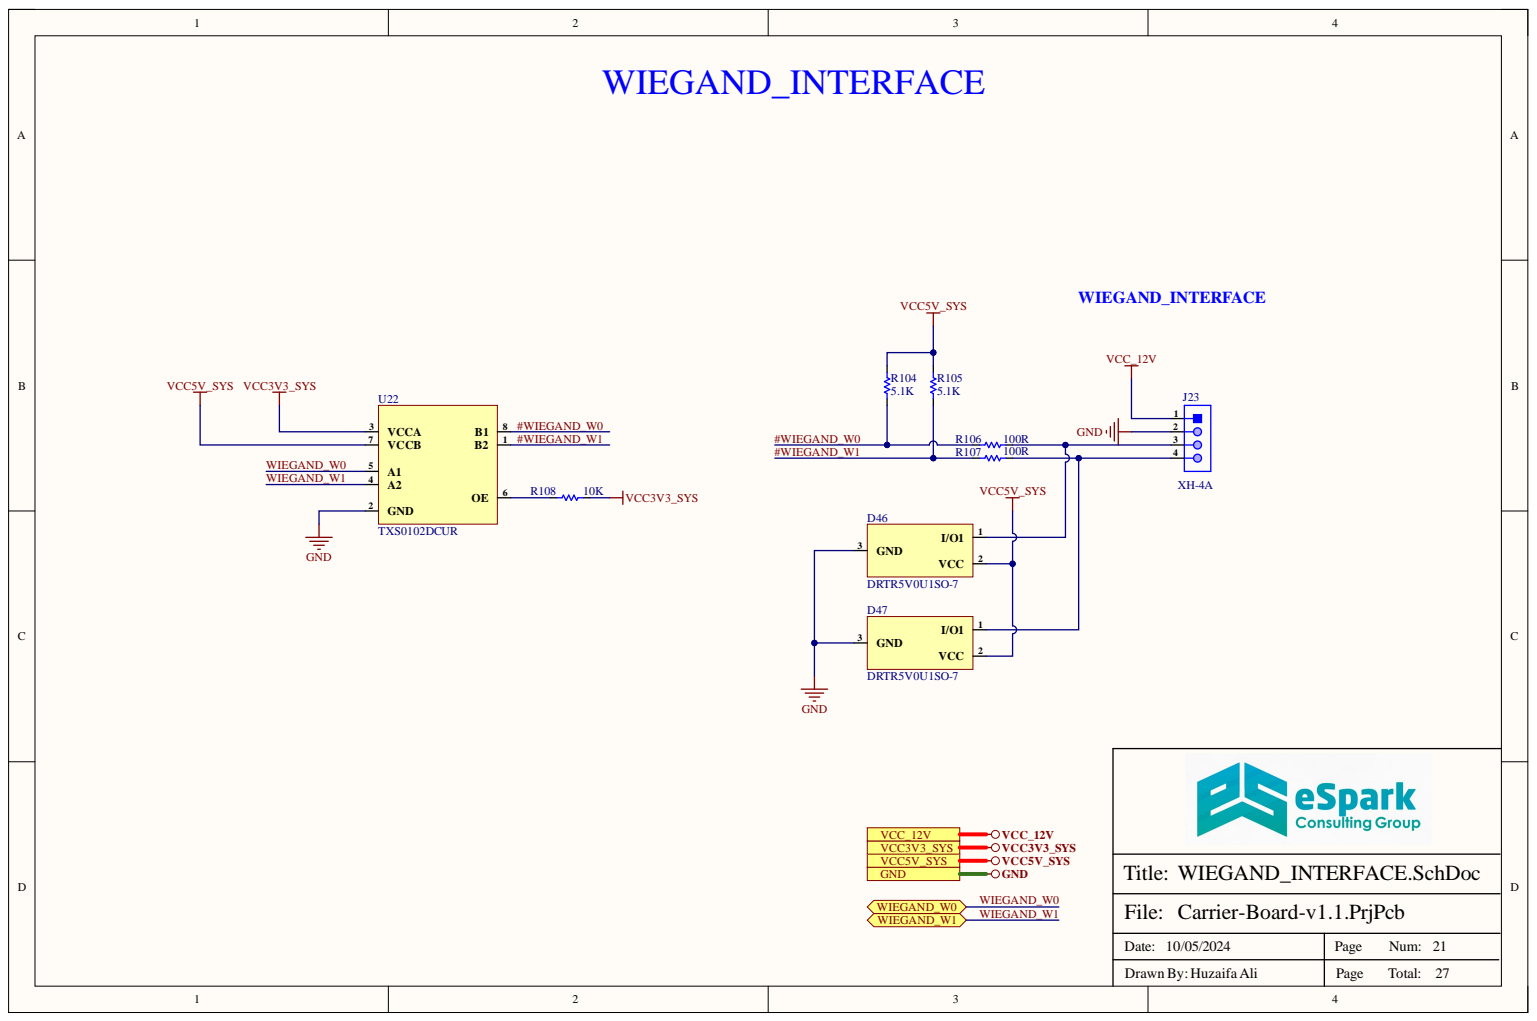
[picture p34: page 21]

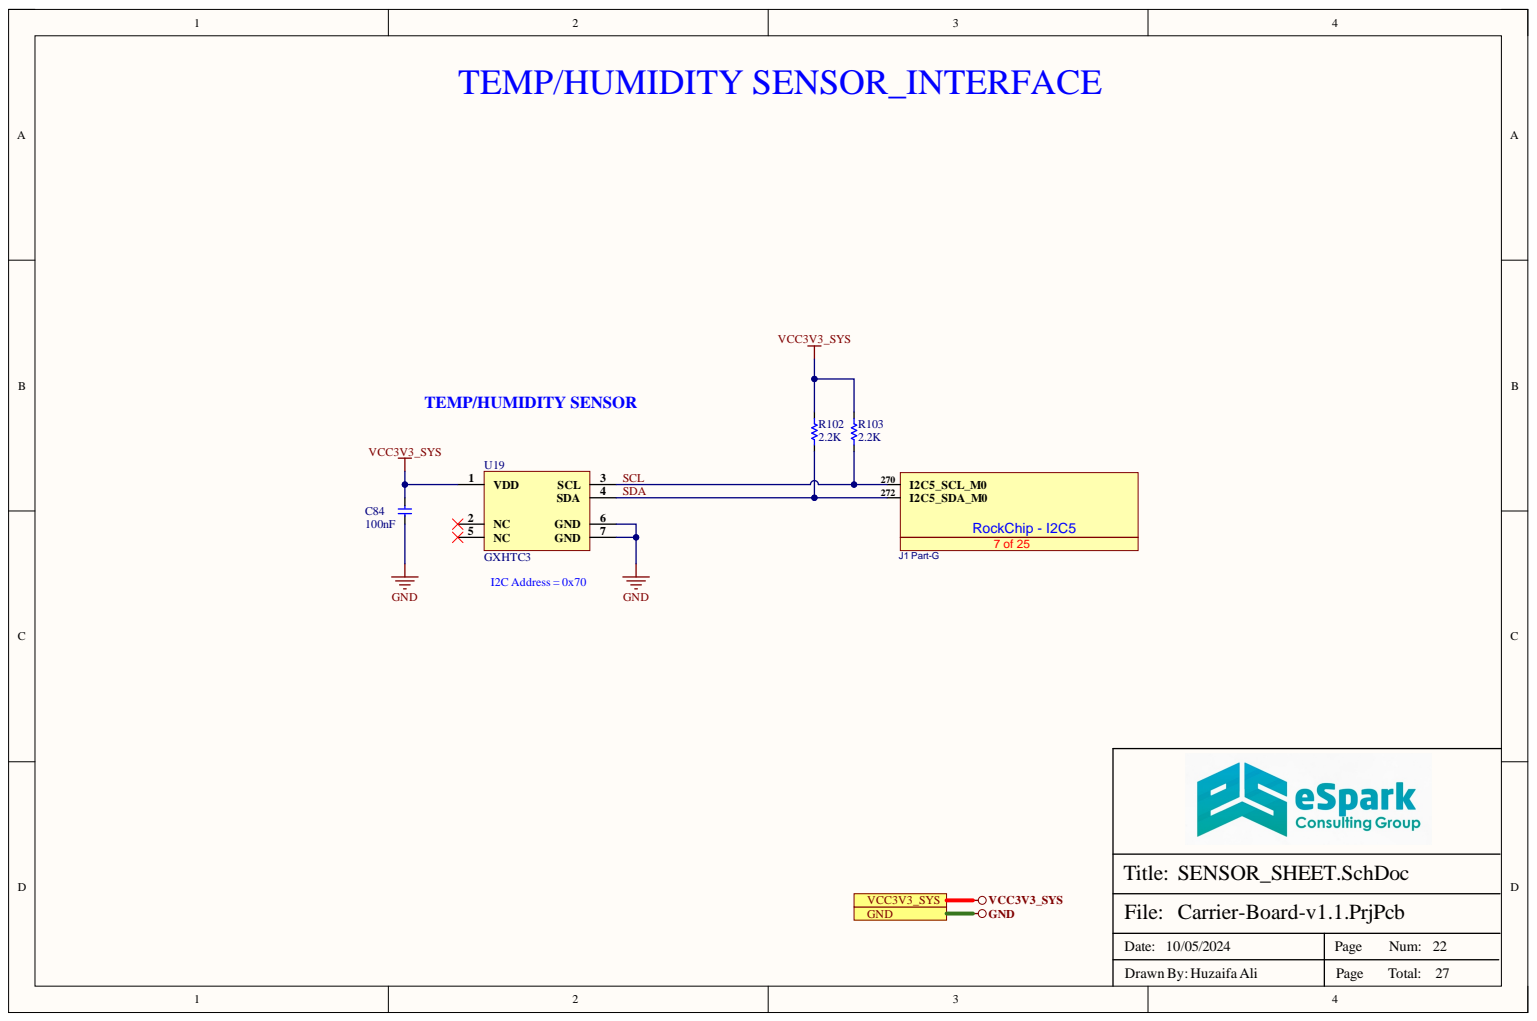
[picture p35: page 22]

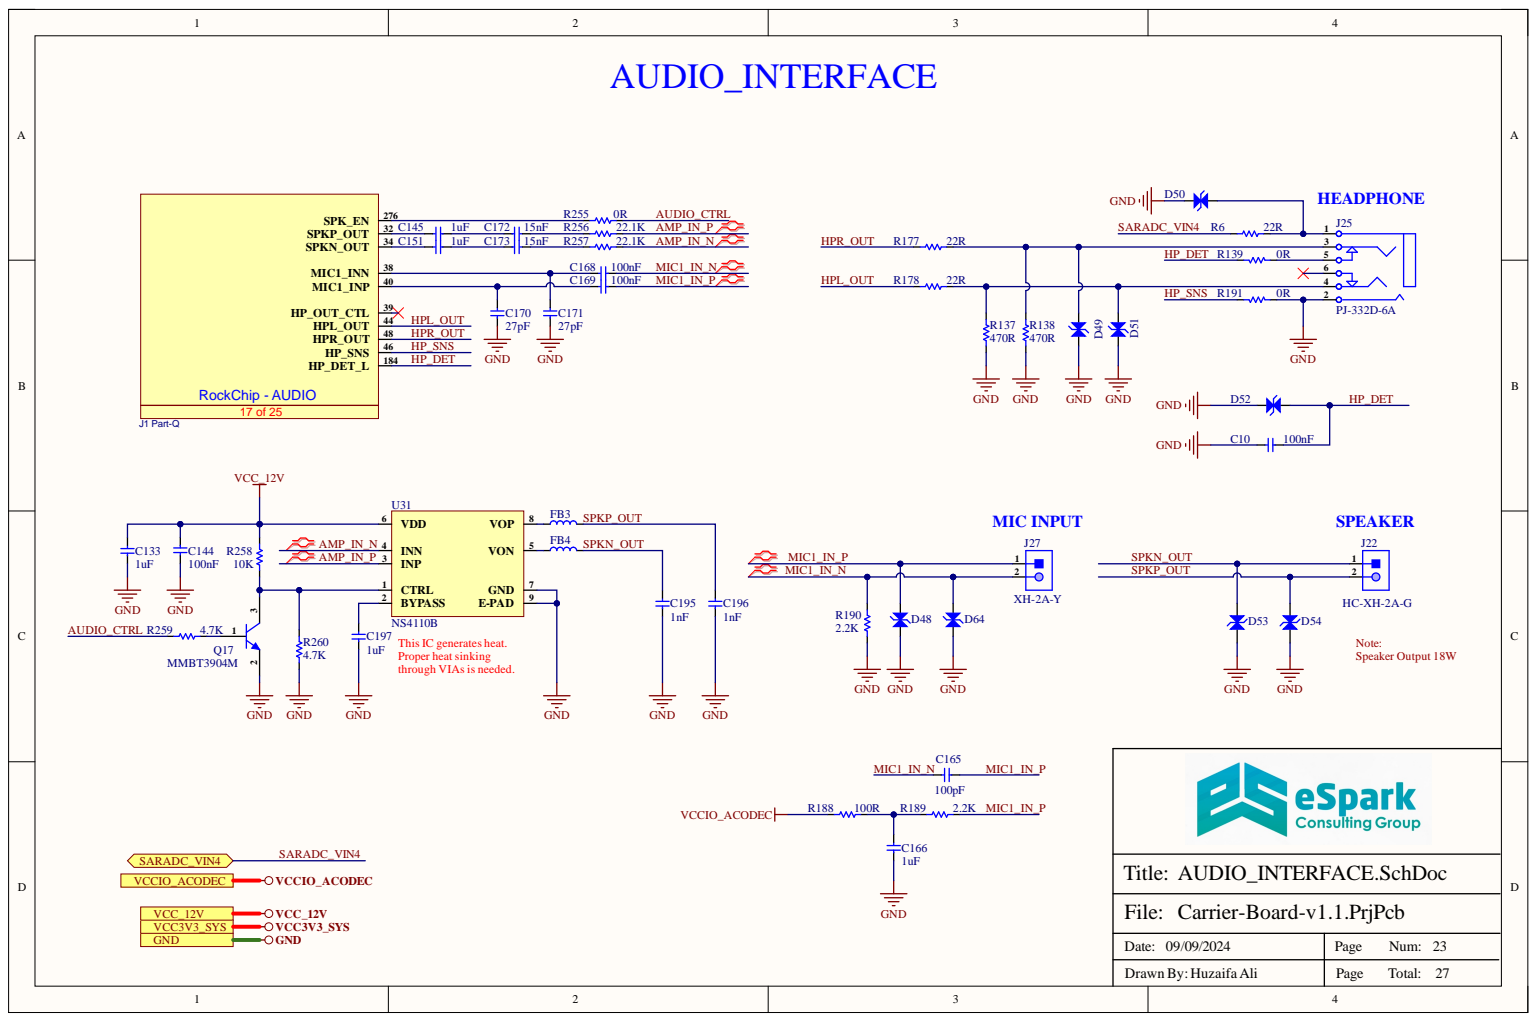
[picture p36: page 23]

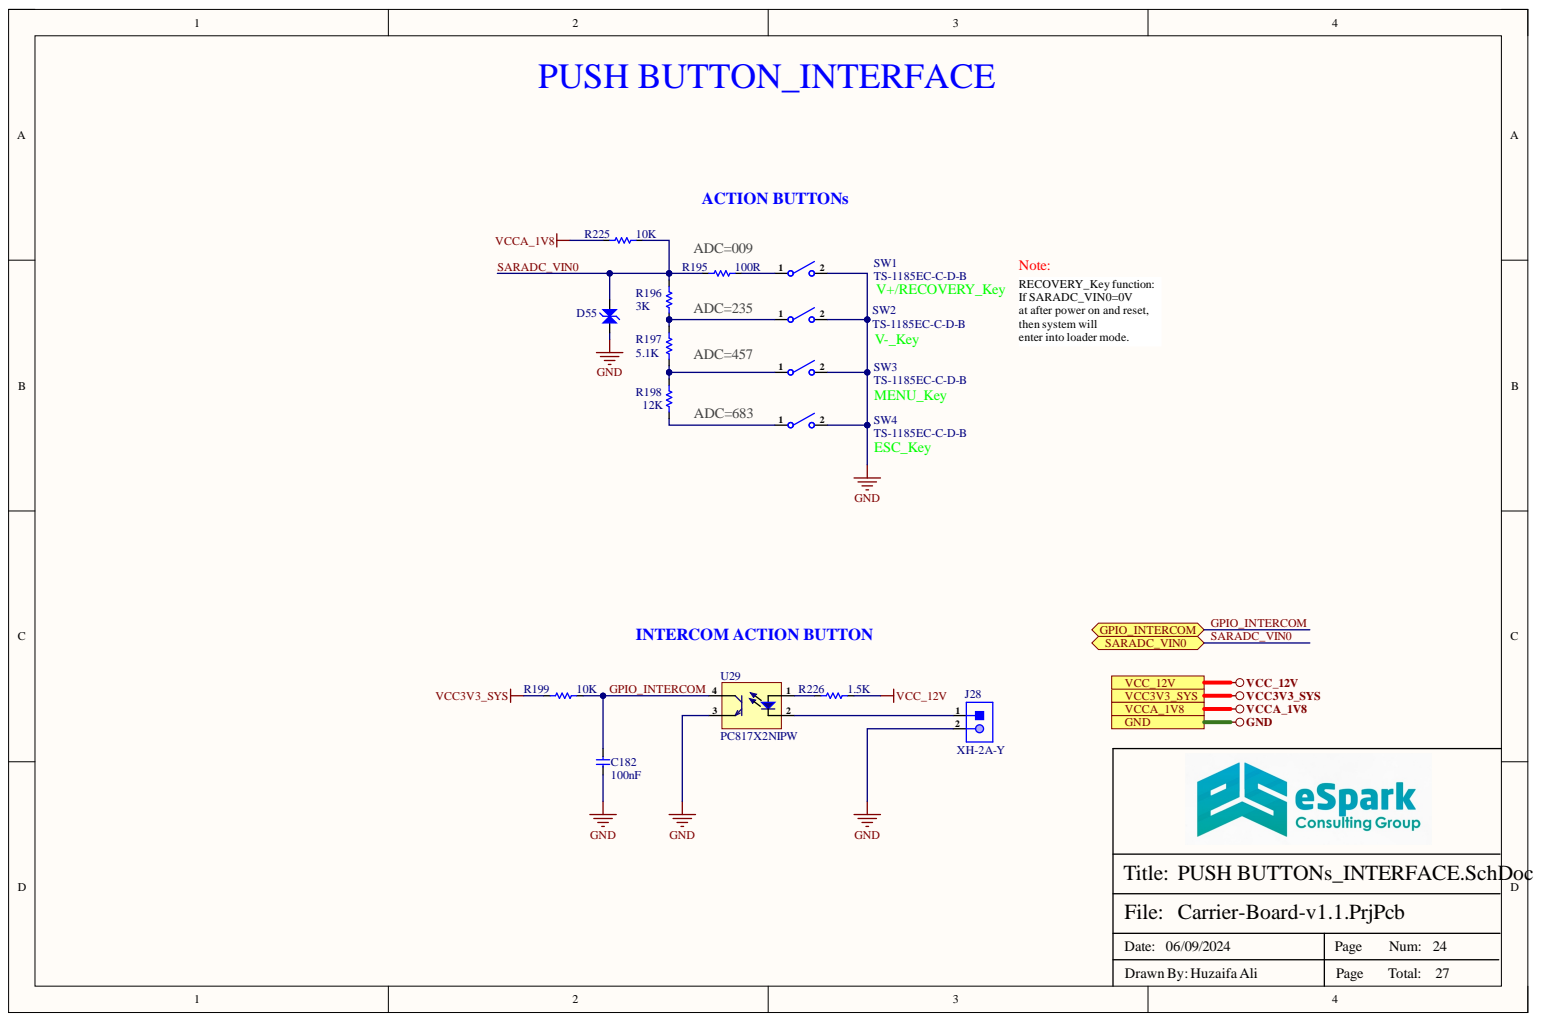
[picture p37: page 24]

Note:
RECOVERY_Key function:
If SARADC_VIN0=0V
at after power on and reset,
then system will
enter into loader mode.

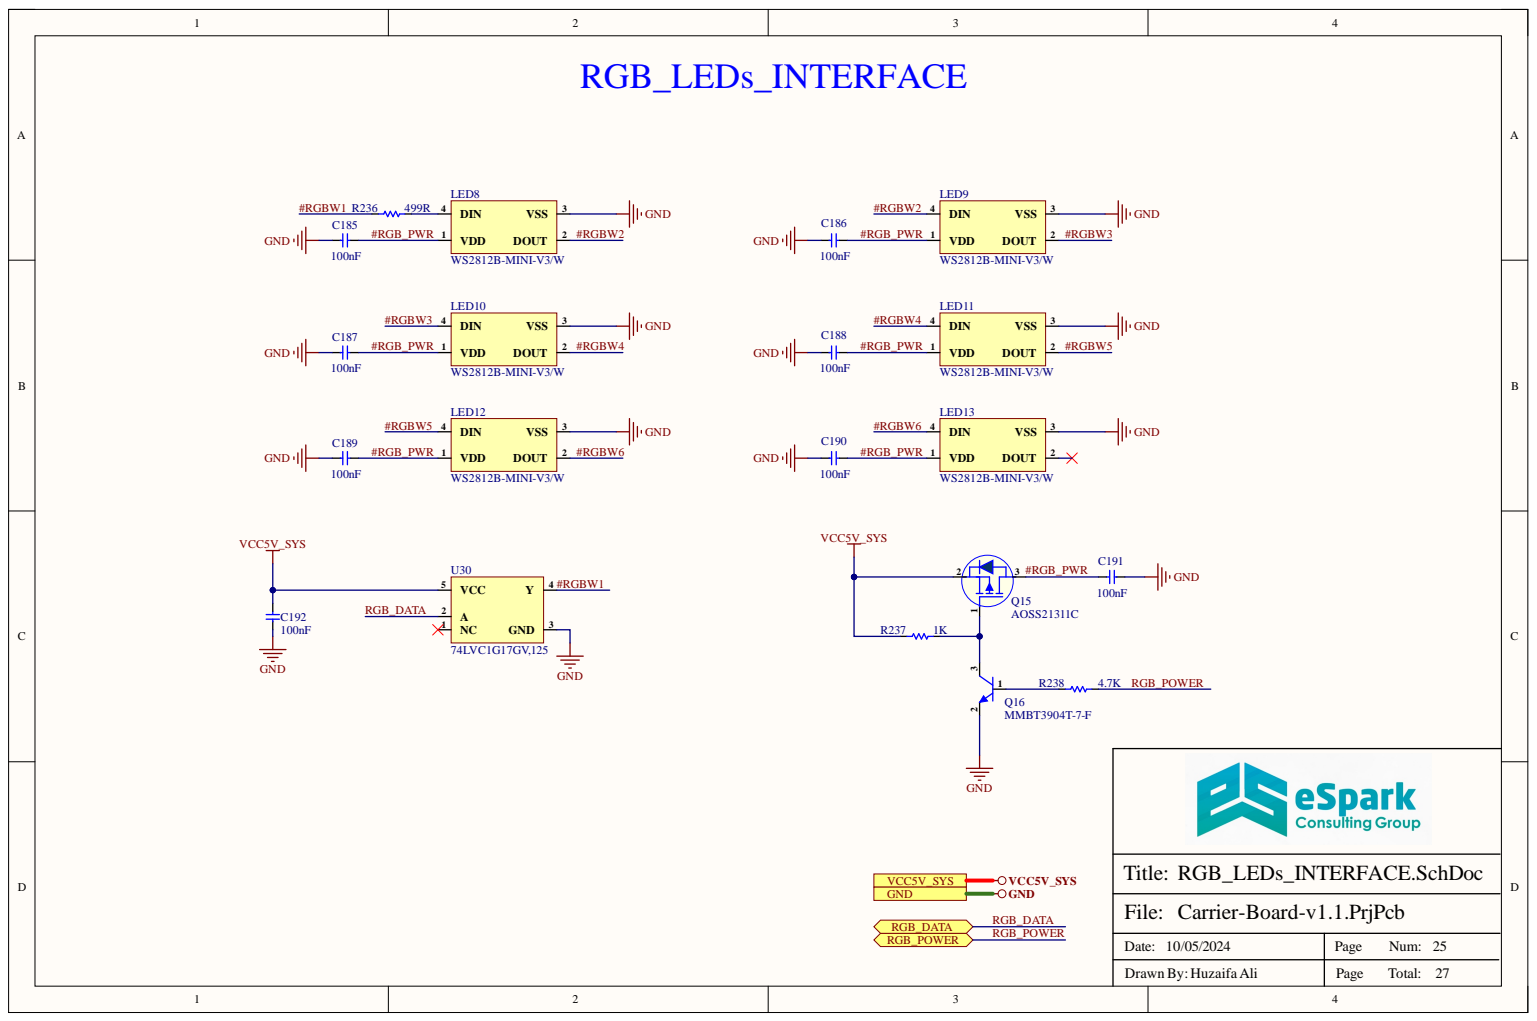
[picture p38: page 25]

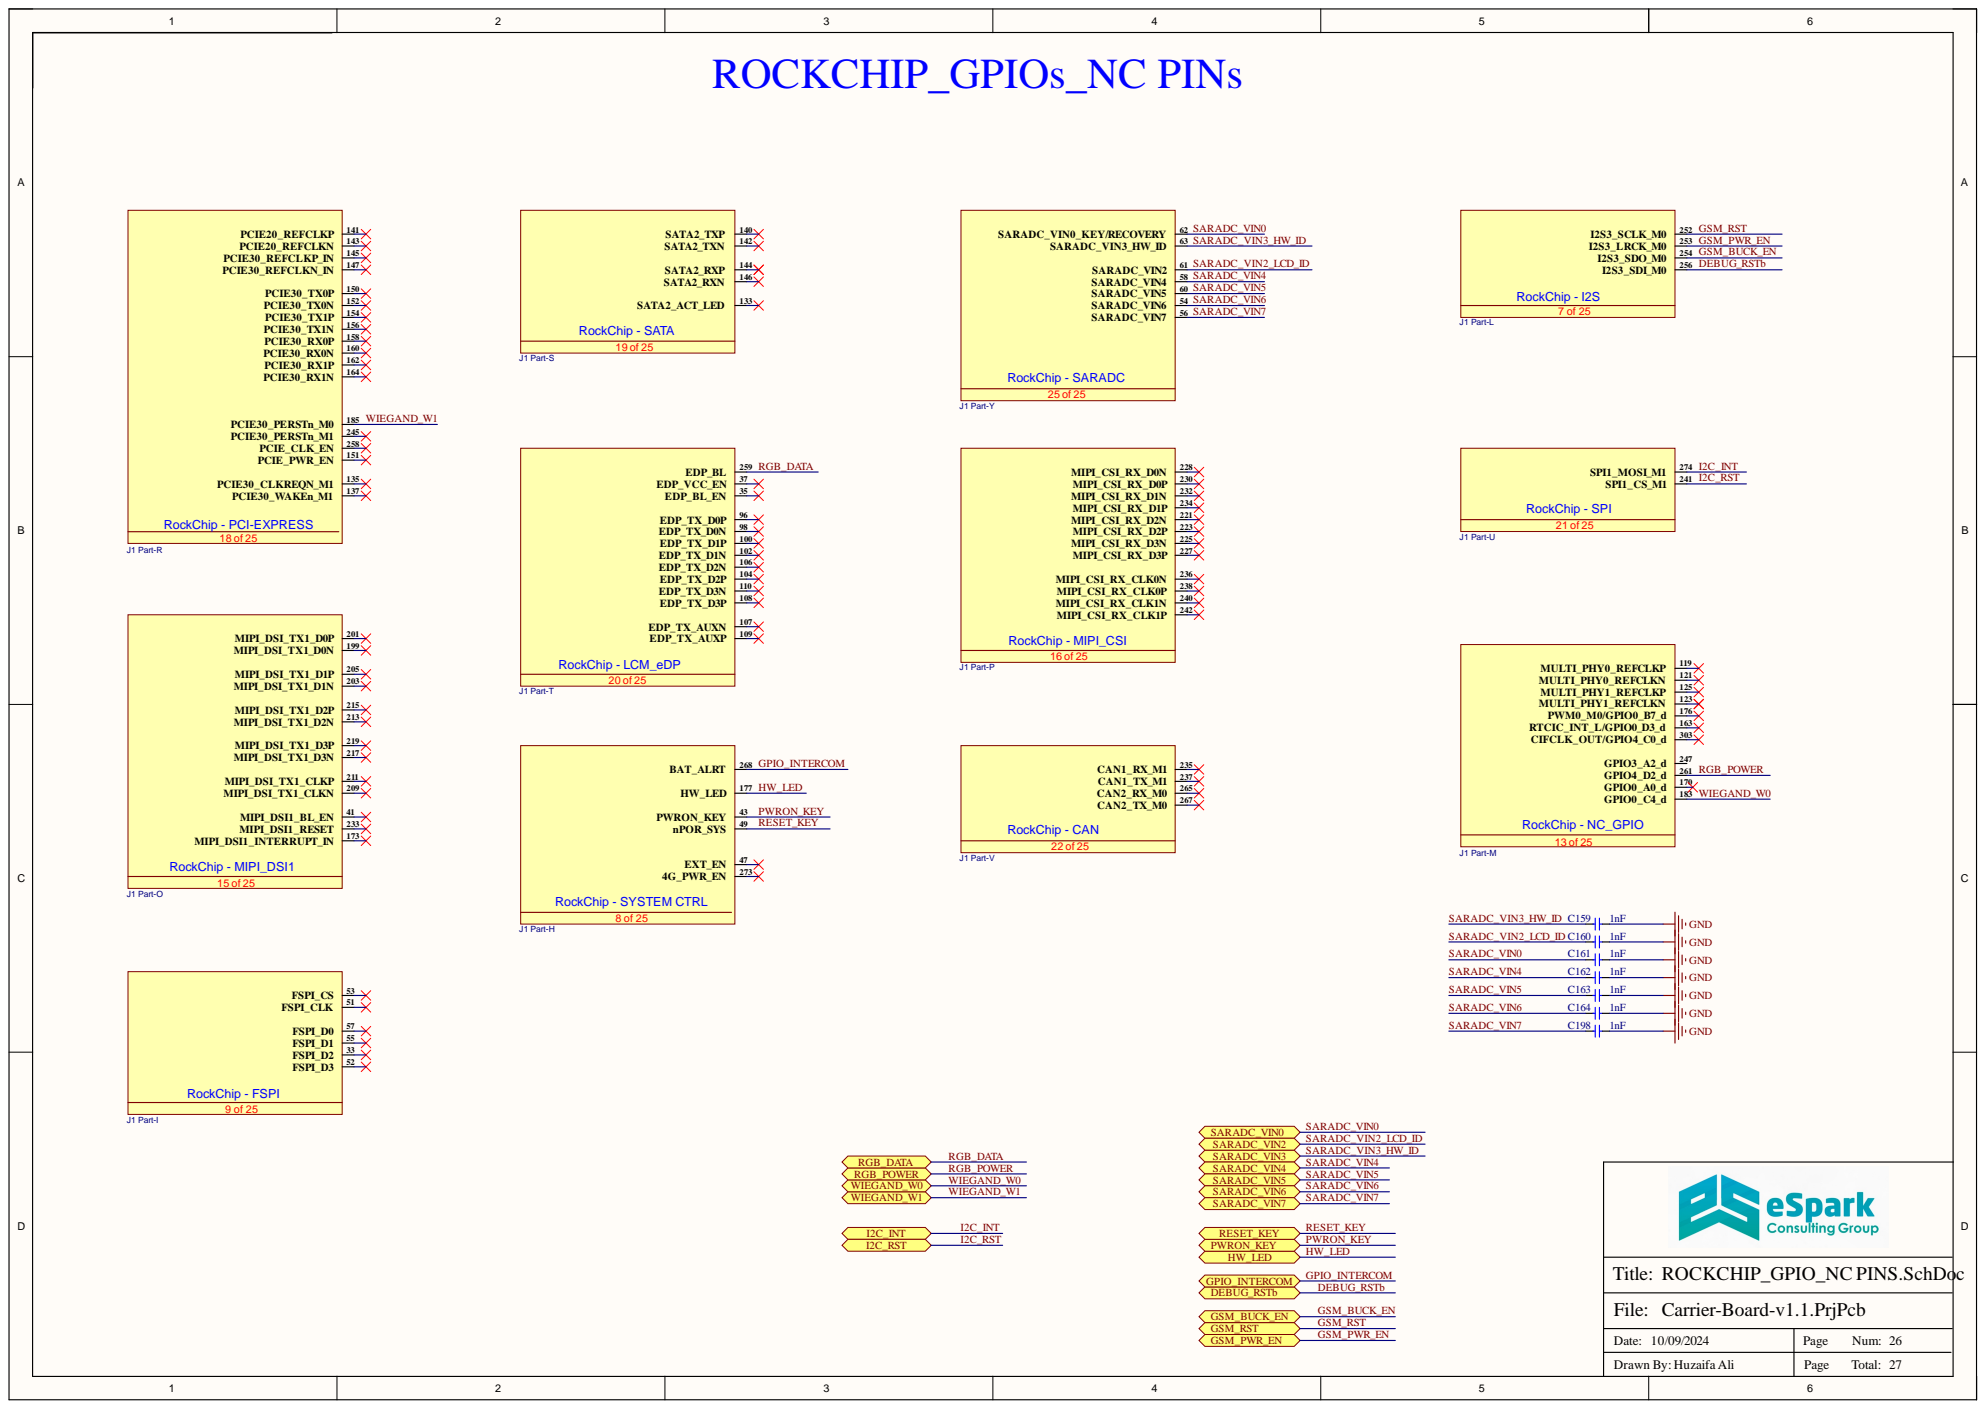
[picture p39: page 26]

Date: | Pag e N u m :

D raw n B y : H uzai fa A l i | Pag e To tal :

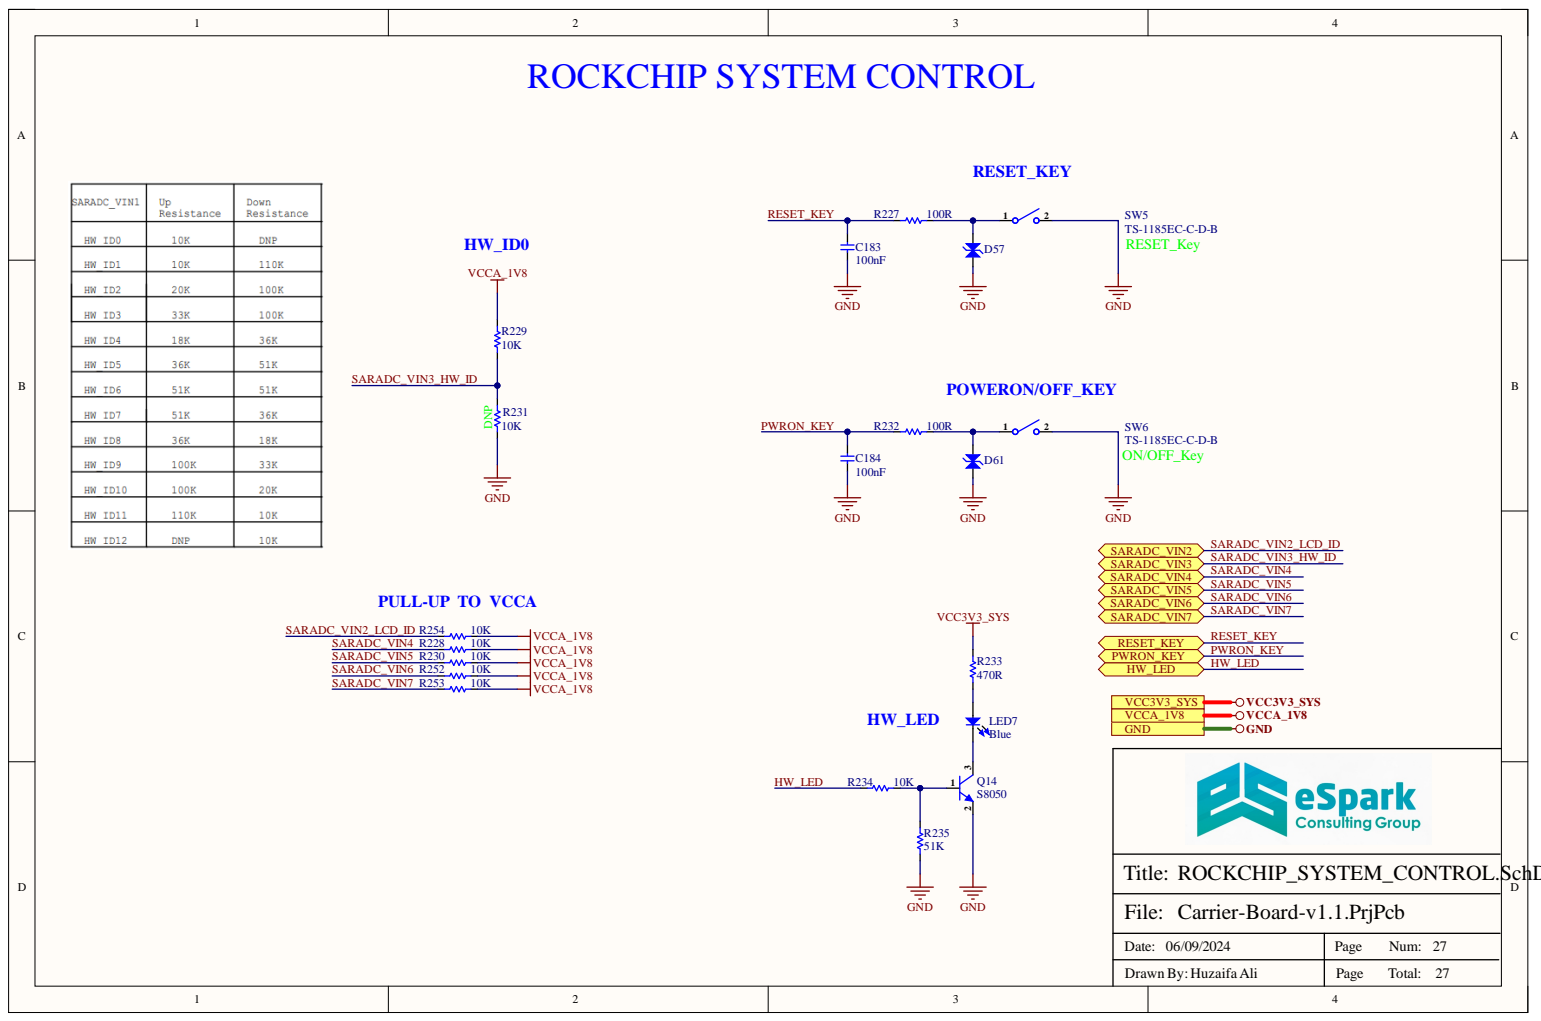
[picture p40: page 27]

PULL-UP TO VCCA

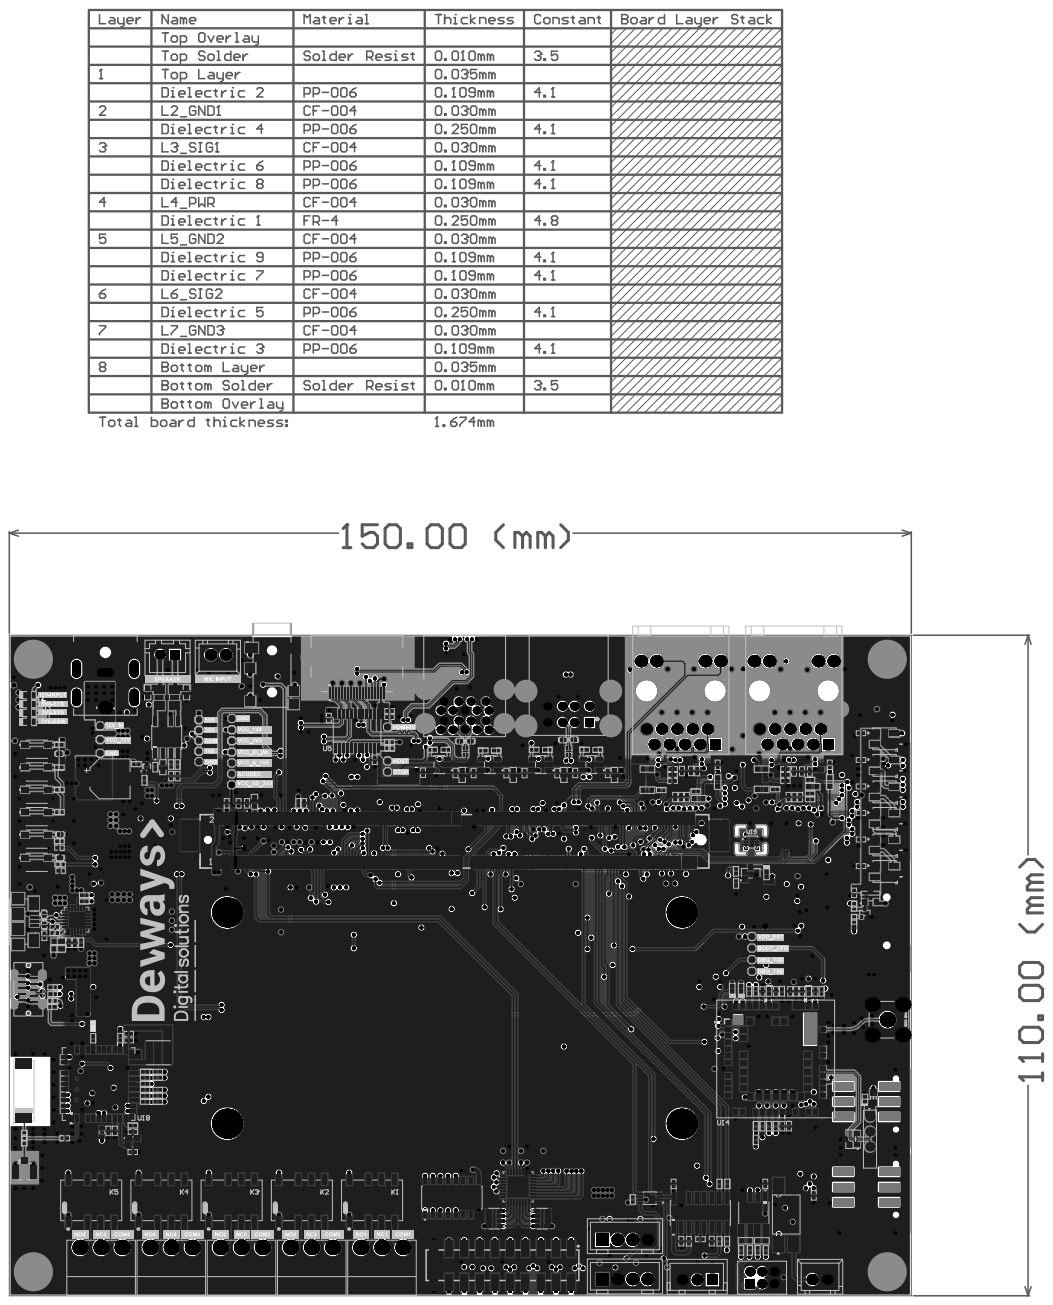
[picture p41: page 28]

100nF | CAP CER 0.1UF 16V X5R 0402, CAP CER 0.1UF 50V X7R 0402 | C1, C3, C4, C6, C7, C8, C9, C10, C11, C12, C13, C14, C15, C16, C17, C18, C21, C22, C23, C27, C30, C34, C39, C40, C42, C43, C46, C50, C52, C53, C55, C57, C65, C66, C67, C70, C71, C72, C75, C76, C78, C81, C84, C85, C88, C89, C91, C92, C93, C94, C95, C96, C97, C98, C100, C101, C103, C104, C106, C107, C109, C110, C111, C113, C114, C115, C118, C119, C120, C122, C124, C126, C129, C130, C131, C134, C135, C136, C137, C141, C143, C144, C147, C148, C149, C152, C153, C154, C155, C158, C168, C169, C177, C179, C180, C181, | Cap-0402 | CC0402KRX5R7BB104, C1005X7R1H104KT000 F

10uF | CAP CER 10UF 10V X5R 0402 | C182, C183, C184, C2, C79 | Cap-0402 | CC0402MRX5R6BB106 | 2

1nF 1uF | CAP CER 1000PF 2KV CAP CER 1UF 16V X5R 0402, CAP CER 1UF X7R 1206 25V X5R 0402 | C5, C24, C31, C125, C142, C203 C19, C25, C28, C32, C37, C68, C80, C166 | Cap-1206 Cap-0402 | CC1206KKX7RDBB102 CC0402KRX5R7BB105, CC0402KRX5R8BB105 | 6 8

10uF | CAP CER 10UF 16V X5R 0603, CAP CER 10UF 25V X5R 0603 | C20, C26, C29, C33, C86, C87, C90, C99, C102, C105, C108, C112, C156, C157 | Cap-0603 | CC0603KRX5R7BB106, C1608X5R1E106M080 AC | 14

10uF 4.7uf | CAP CER 10UF 50V X5R 0805 CAP CER 4.7UF 50V X5R 0805 | C41, C51, C176, C178 C35, C36, C38 | Cap-0805 | GRM21BR61H106ME4 3L GRM21BR61H475KE51 L | 4 3

4.7uF | CAP CER 4.7UF 10V X5R 0402 | C117, C121, C123, C132, C140, C146, C150 | Cap-0402 | CC0402KRX5R6BB475 | 7

18pF 1uF 1nF | CAP CER 18PF 50V C0G/NP0 0402 CAP CER 1UF 25V X5R 0603 CAP CER 1000PF 25V X7R 0402 | C127, C128, C138, C139 C133, C145, C151, C197 C159, C160, C161, C162, C163, C164, C198 | Cap-0402 Cap-0603 Cap-0402 | GCM1555C1H180GA1 6D CC0603KRX5R8BB105 CC0402KRX7R8BB102 | 4 4 7

27pF 100pF 15nF 1nF 0.1uF CDSOT23-SM712 | CAP CER 27PF 25V CAP CER 100PF 50V C0G/NPO 0402 CAP CER 0.015UF 50V X7R 0402 C0G/NP0 0402 CAP CER 1000PF 25V CAP CER 0.1UF 100V X7R 0603 TVS DIODE 7V/12V 14V/26V SOT23-3 C0G/NPO 0603 | C165 C172, C173 C170, C171 C175 D1, D2 C195, C196 | Cap-0402 Cap-0402 Cap-0402 Cap-0603 SOT-23 CAP-0603 | CC0402JRNPO9BN101 CC0402KRX7R9BB153 0402N270J250CT CC0603KRX7R0BB104 CDSOT23-SM712 CC0603JRNPO8BN102 | 1 2 2

ESD5451N | DFN1006-2(0402) ESD Protection Devices ROHS | D3, D4, D7, D8, D9, D10, D11, D12, D13, D14, D22, D23, D24, D25, D48, D49, D50, D51, D52, D55, D57, D61, D64, D65, D66, D68 | DFN1006-2L (Bi-Directional) | ESD5451N | 26

ESD5344D-10/TR | DFN2510-10L ESD Protection Devices ROHS | D5, D6 | DFN2510-10L_ | ESD5344D-10/TR | 2

SMBJ33CA-13-F | TVS DIODE 33VWM 53.3VC SMB | D15 | SMB Bi Directional | SMBJ33CA-13-F | 1

BZX84C3V3TS-7-F MMSZ5231BT1G ESD9X5VU | DIODE ZENER ARRAY DIODE ZENER 5.1V 500MW SOD123 3.3V SOT363 DFN1006-2 ESD Protection Devices ROHS | D16, D58, D59, D60, D62, D63 D17 D18, D26, D27, D28, D29, D30, D31, D32, D33, D34, D35, D36, D37, D38, D39, D40, D41, D42, D43, D44, D45 | SOT-363 SOD-123 DFN1006-2L_ | BZX84C3V3TS-7-F MMSZ5231BT1G ESD9X5VU | 6 1 21

ESD5302F-3/TR | 16A 20V 7V 5V@Max Unidirectional SOT-23 TVS ROHS | D19 | Sot-23 | ESD5302F-3/TR | 1

ESD5651N-2/TR | 35A@8/20us 15V 4.5V@Max DFN1006-2L Electrostatic and Surge Protection (TVS/ESD) ROHS | D20, D21 | DFN1006-2L_ | ESD5651N-2/TR | 2

DRTR5V0U1SO-7 ESD9N12BA | X1-DFN1006-2 ESD TVS DIODE 5.5VWM SOT23 and Surge Protection (TVS/ESD) ROHS | D46, D47 D53, D54 | SOT-23 DFN1006-2L (Bi-Directional) | DRTR5V0U1SO-7 ESD9N12BA | 2 2

0458005.DR SMD0603-050 | 6V 500mA 40A 1A FUSE BRD MNT 5A 32VAC 75VDC 1206 0603 Resettable Fuses ROHS | F1 F2 | Fuse 1206 (3216 Metric) Fuse-0603 | 0458005.DR SMD0603-050 | 1 1

FERRITE BEAD 1K
2mm Deck MicroSD
card (TF card) Self
bomb SMD SD Card /
Memory Card
Connector ROHS

AS0B826-S78B-7H | SMD,P=0.5mm,Surfac e Mount，Right Angle | J1 Part- | AS0B826-S78B-7H | AS0B826-S78B-7H | 1

10029449-111RLF | CONN RCPT 1.4 HDMI 19POS SMD R/A | J2 | 10029449-111RLF | 10029449-111RLF | 1

HX20012-6A black | 2x3P 2 2mm 2mm male 3 -25℃~+85℃ 3A Straight Plugin,P=2mm Wire To Board / Wire To Wire Connector ROHS | J3 | HX20012-6A black | HX20012-6A black | 1

HC-XH-3A-R | 1x3P 3P XH 1 Tin 2.5mm 3 -25℃~+85℃ Brass 3A Straight Plugin,P=2.5mm Wire To Board Connector ROHS | J4 | HC-XH-3A-R | HC-XH-3A-R | 1

U224-081N-1BR61 | USB 2.0 1.5A 2 235℃ Right-Angle 4P+4P Female -40℃~+85℃ Gold Brass Type-A Plugin USB Connectors ROHS | J5 | U224-081N-1BR61 | U224-081N-1BR61 | 1

UEA1112C-8HS6-4F | USB 3.0 2 Right-Angle 9P+9P Female Type-A Plugin USB Connectors ROHS | J6 | UEA1112C-8HS6-4F | UEA1112C-8HS6-4F | 1

DC-053D-25A | Shrouded DC Power Receptacle -20℃~+70℃ 2.5mm 6.5mm 10A 16V Plugin AC/DC Power Connectors ROHS | J7 | DC-053D-25A | DC-053D-25A | 1

HJ-SMA175 | 1 Inner bore SMA Board Edge Bend 11mm 5.35mm Plugin RF Connectors / Coaxial Connectors ROHS | J8 | HJ-SMA175 | HJ-SMA175 | 1

POGO Connector 4 Pin XKNANO-113 | Pogo Pad 2.5mm 4 Pin Copper Alloy Self bomb Gold plating 1.25mm Deck -40℃~+85℃ 260℃ NanoSIM SMD SIM Card Connectors ROHS | J9 J10, J11 | Pogo 4 Pin XKNANO-113 | POGO Connector 4 Pin XKNANO-113 | 1 2

DB2ERC-3.5-3P-GN | 250V 10A 3 Bend -40℃~+105℃ 1 3.5mm 1x3P Green Board Edge/Receptacle-Close Push-Pull,P=3.5mm Pluggable System Terminal Block ROHS | J12, J13, J14, J15, J16 | DB2ERC-3.5-3P-GN | DB2ERC-3.5-3P-GN | 5

PZ254-2-10-S | 250V 3A Brick nogging Square Pins 2.5mm 260℃@5S 6mm 20P -40℃~+105℃ 2.54mm 双排 Black 2.54mm 2x10P SMD,P=2.54mm Pin Headers ROHS | J17 | PZ254-2-10-S | PZ254-2-10-S | 1

U.FL-R-SMT-1(80) 10118192-0001LF XH-4A-L | CONN U.FL RCPT STR 50OHM SMD CONN RCPT USB2.0 MICRO B SMD R/A 1x4P 4P XH 1 Tin 2.5mm 4 -25℃~+85℃ Brass 3A Straight Plugin,P=2.5mm Wire To Board Connector ROHS | J18 J19 J20 | U.FL-R-SMT-1(80)_ 10118192-0001LF_ XH-4A-L | U.FL-R-SMT-1(80) 10118192-0001LF XH-4A-L | 1 1 1

HR911130C | RJ45 RJReceptacle 1 Internal oscillator included Shrouded WithLED Plugin Ethernet Connectors/Modular Connectors (RJ45 RJ11) ROHS | J21, J24 | HR911130C | HR911130C | 2

HC-XH-2A-G | 1x2P XH 1 2.54mm 2.54mm Male pin 2 -25℃~+85℃ 3A Straight Straight,P=2.5mm Wire To Board / Wire To Wire Connector ROHS | J22 | HC-XH-2A-G | HC-XH-2A-G | 1

XH-4A | 1x4P 4P XH 1 Tin 2.5mm 4 -25℃~+85℃ Brass 3A Straight Plugin,P=2.5mm Wire To Board Connector ROHS | J23 | XH-4A | XH-4A | 1

PJ-332D-6A | 3.5mm headphone jack 1A SMD Audio Connectors ROHS | J25 | PJ-332D-6A | PJ-332D-6A | 1

TF31-30S-0.5SH(800) XH-2A-Y | CONN FFC BOTTOM 1x2P 2P XH 1 Tin 30POS 0.5MM R/A 2.5mm 2 -25℃~+85℃ Brass 3A Straight Plugin,P=2.5mm Wire To Board Connector ROHS | J26 J27, J28 | TF31-30S-0.5SH(800) XH-2A-Y | TF31-30S-0.5SH(800) XH-2A-Y | 1 2

TYPE-C-31-D-07 | 1 Brick nogging 14P Female Type-C SMD USB Connectors ROHS | J29 | TYPE-C-31-D-07 | TYPE-C-31-D-07 | 1

G6K-2F-Y-TR-DC5 MCZ1210CH900L2TA0 G 4.7uH | RELAY TELECOM DPDT 1A 5V CMC 100MA 2LN 90 OHM SMD Fixed Ind 4.720%UH 0.06Ohm 3200M | K1, K2, K3, K4, K5 L1, L2, L3, L4 L5 | G6K-2F-Y-TR DC5 MCZ1210CH900L2 SWPA4030S4R7MT_ | G6K-2F-Y-TR-DC5 MCZ1210CH900L2TA0 G SWPA4030S4R7MT | 5 4 1

2.2uH 1uH | FIXED IND 2.2UH 1.5A 160MOHM SMD 1uH ±20% 23A SMD,6.6x6.4mm Power Inductors ROHS | L6, L9 L7, L8 | MAKK2016T2R2M_ YSPIT0630A-1R0M | MAKK2016T2R2M YSPIT0630A-1R0M | 2 2

Emerald 0603 Light Emitting Diodes (LED) ROHS | LED1 | LED-0603 | NCD0603G2 | 1

RED Yellow | RED LED 0603 Light yellow 0603 Light Emitting Diodes Emitting Diodes (LED) ROHS | LED2, LED6 LED3 | LED-0603 | NCD0603R3 NCD0603Y2 | 2 1

FDN335N 2SK3018 | 30V 100mA 200mW SOT-23 MOSFETs ROHS 8Ω@4V,10mA N Channel SOT-23 MOSFETs ROHS | Q2, Q3, Q4, Q5 Q7 | SOT-23 | FDN335N 2SK3018 | 4 1

S8050 | Trans Gp Bjt NPN 25V 1.5A 300MW 3-PIN SOT-23 T/r | Q14 | SOT-23 | S8050 | 1

MMBT3904T-7-F AOSS21311C MMBT3904M | TRANS NPN 40V 0.2A MOSFET P-CH 30V 4.3A SOT23-3 40V 100mW SOT523 100@10mA,1V 200mA 300MHz 300mV@50mA,5mA NPN -55℃~+150℃@(Tj) SOT-723 Bipolar Transistors - BJT ROHS | Q15 Q16 Q17 | SOT-23 SOT-523 SOT-723 | AOSS21311C MMBT3904T-7-F MMBT3904M | 1 1 1

0R | RES 0OHM JUMPER 1/16W 0402 | R1, R23, R24, R28, R29, R52, R53, R54, R60, R65, R68, R84, R85, R86, R87, R88, R89, R90, R116, R129, R139, R142, R173, R174, R191, R247, R255 | Res-0402 | RC0402FR-070RL | 27

10K | RES 10K OHM 1% 1/16W 0402 | R2, R4, R5, R25, R26, R30, R33, R37, R46, R50, R72, R75, R76, R77, R78, R79, R82, R83, R92, R108, R111, R112, R130, R140, R143, R152, R194, R199, R203, R208, R209, R225, R228, R229, R230, R234, R252, R253, R254, R258, R265 | Res-0402 | RC0402FR-0710KL | 41

DNP | RES 0OHM JUMPER 1/16W 0402, RES 100 OHM 1% 1/16W 0402, RES 100K OHM 1% 1/16W 0402, RES 10K OHM 1% 1/16W 0402 | R3, R12, R13, R56, R61, R175, R205, R231 | Res-0402 | RC0402FR-070RL, RC0402FR-07100RL, RC0402FR-07100KL, RC0402FR-0710KL | 8

22R | RES 22OHM 1% 1/16W 0402 | R6, R11, R14, R15, R16, R19, R20, R21, R22, R119, R120, R121, R122, R123, R124, R144, R145, R146, R147, R148, R149, R177, R178, R239, R240, R241, R242, R243, R244, R245, R246 | Res-0402 | RC0402FR-0722RL | 31

1M 4.7K | RES SMD 1M OHM 5% 1/16W 0402 RES 4.7K OHM 1% 1/16W 0402 | R8, R9, R48, R91, R97, R7, R34, R41, R47, R115, R264 R98, R99, R100, R101, R132, R133, R134, R135, R156, R160, R161, R165, R166, R167, R170, R171, R172, R210, R211, R212, R213, R214, R215, R216, R217, R218, R219, R220, R221, R238, R248, R249, R250, R251, R259, R260 | Res-0402 | AF0402JR-071ML RC0402FR-074K7L | 6 41

1K NC | RES 1K OHM 1% RES SMD 120OHM 0.1% 1/10W 0603 1/16W 0402 | R10, R73, R74, R80, R81, R237 R17 | Res-0402 Res-0603 | RC0402FR-071KL RT0603BRB07120RL | 6 1

180R 0R | RES 180OHM 1% 1/10W 0603 RES 0OHM JUMPER 1/10W 0603 | R70, R71 R93, R94, R95, R125, R126, R136, R157, R162 | Res-0603 | RC0603FR-07180RL RC0603JR-070RL | 2 8

1.8K 2.2K | RES SMD 1.8K OHM 1% 1/5W 0402 RES SMD 2.2K OHM 1% 1/16W 0402 | R102, R103, R117, R96, R153 R118, R189, R190, R206, R207 | Res-0402 | RCS04021K80FKED RC0402FR-072K2L | 2 8

100R | RES 100OHM 1% 1/16W 0402 | R106, R107, R127, R150, R188, R195, R227, R232 | Res-0402 | RC0402FR-07100RL | 8

15K | RES 15K OHM 1% 1/16W 0402, RES SMD 15K OHM 0.1% 1/16W 0402 | R109, R113, R263, R266 | Res-0402 | RC0402FR-0715KL, RT0402BRD0715KL | 4

20K 2.49K 120R 470R | RES 20K OHM 1% 1/16W 0402 RES 2.49K OHM 1% RES 120OHM 1% 1/16W 0402 RES 470OHM 1% 1/16W 0402 1/16W 0402 | R110, R114 R128, R151 R137, R138 R131, R141 | Res-0402 Res-0402 | RC0402FR-0720KL RC0402FR-07120RL RC0402FR-07470RL RC0402FR-072K49L | 2 2

22.1K 22R TS-1185EC-C-D-B | RES SMD 22.1KOHM 0.1% 1/16W 0402 RES ARRAY 4 RES 22 OHM 1206 3mm 2mm Round Button 50mA Top3.65mm SPST 12V SMD Tactile Switches | R256, R257 RN4, RN5 SW1, SW2, SW3, SW4, SW5, SW6 | Res-0402 0603x4 TS-1185EC-C-D-B_ | RT0402BRD0722K1L YC164-FR-0722RL TS-1185EC-C-D-B | 2 2 6

MAX3490EESA+T MAX3232EIDR | IC TXRX RS485/422 10MBPS 8SOIC IC RS232 LINE DVR/RCVR 16-SOIC | U1 U2 | SOIC-8(0.154", SOIC-16 3.90mm Width) | MAX3232EIDR MAX3490EESA+T | 1 1

DT1240-04LP-7 TPD12S016PWR | TVS DIODE 5.5VWM 11VC U-DFN2510 IC INTERFACE SPECIALIZED 24TSSOP | U3, U4 U5 | U-DFN2510-10 24-TSSOP | DT1240-04LP-7 TPD12S016PWR | 2 1

SY6280AAC | SOT-23-5 Power Distribution Switches ROHS | U6, U7, U8, U9 | SOT-23-5 | SY6280AAC | 4

SQJ886EP-T1_GE3 LM74700QDBVRQ1 | MOSFET N-CH 40V 60A PPAK SO-8 OR Controller N+1 ORing Controller N-Channel 1:1 SOT-23-6 | U10 U11 | PowerPAK-SO-8 SOT-23-6 | SQJ886EP-T1_GE3 LM74700QDBVRQ1 | 1 1

MAX20006AFOB/VY+ T MAX20008AFOC/VY+ T A7682E | IC REG BUCK 3.3V 6A 17FC2QFN LGA-IC REG BUCK 5V 8A 17FC2QFN 85_19.6x19.6x1.10P RF Modules ROHS | U12 U13 U14 | 17-FC2QFN (3.5x3.75) 17-FC2QFN (3.5x3.75) A7682E | MAX20006AFOB/VY+ T MAX20008AFOC/VY+ T A7682E | 1 1 1

TXB0102DCUT SMF05CT1G-ES | IC TRNSLTR 15V 5Unidirectional BIDIRECTIONAL US8 5V SOT-363 ESD Protection Devices ROHS | U15 U16, U17 | TXB0102DCUT SOT-363 | TXB0102DCUT SMF05CT1G-ES | 1 2

AP6256 | 802.11ac/a/b/g/n WiFi Combo Sip Module (WiFi 5), 1T1R | U18 | AP6256_ | AP6256 | 1

GXHTC3 | DFN-6-EP(2x2) Temperature and Humidity Sensor ROHS | U19 | DFN-6-EP(2x2) | GXHTC3 | 1

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
