eSpark-Consulting-Group/anis-carrier-board/docs/Support files/ROC-RK3568-PCSE-V10-20220809.pdf

D | D

# Revision History

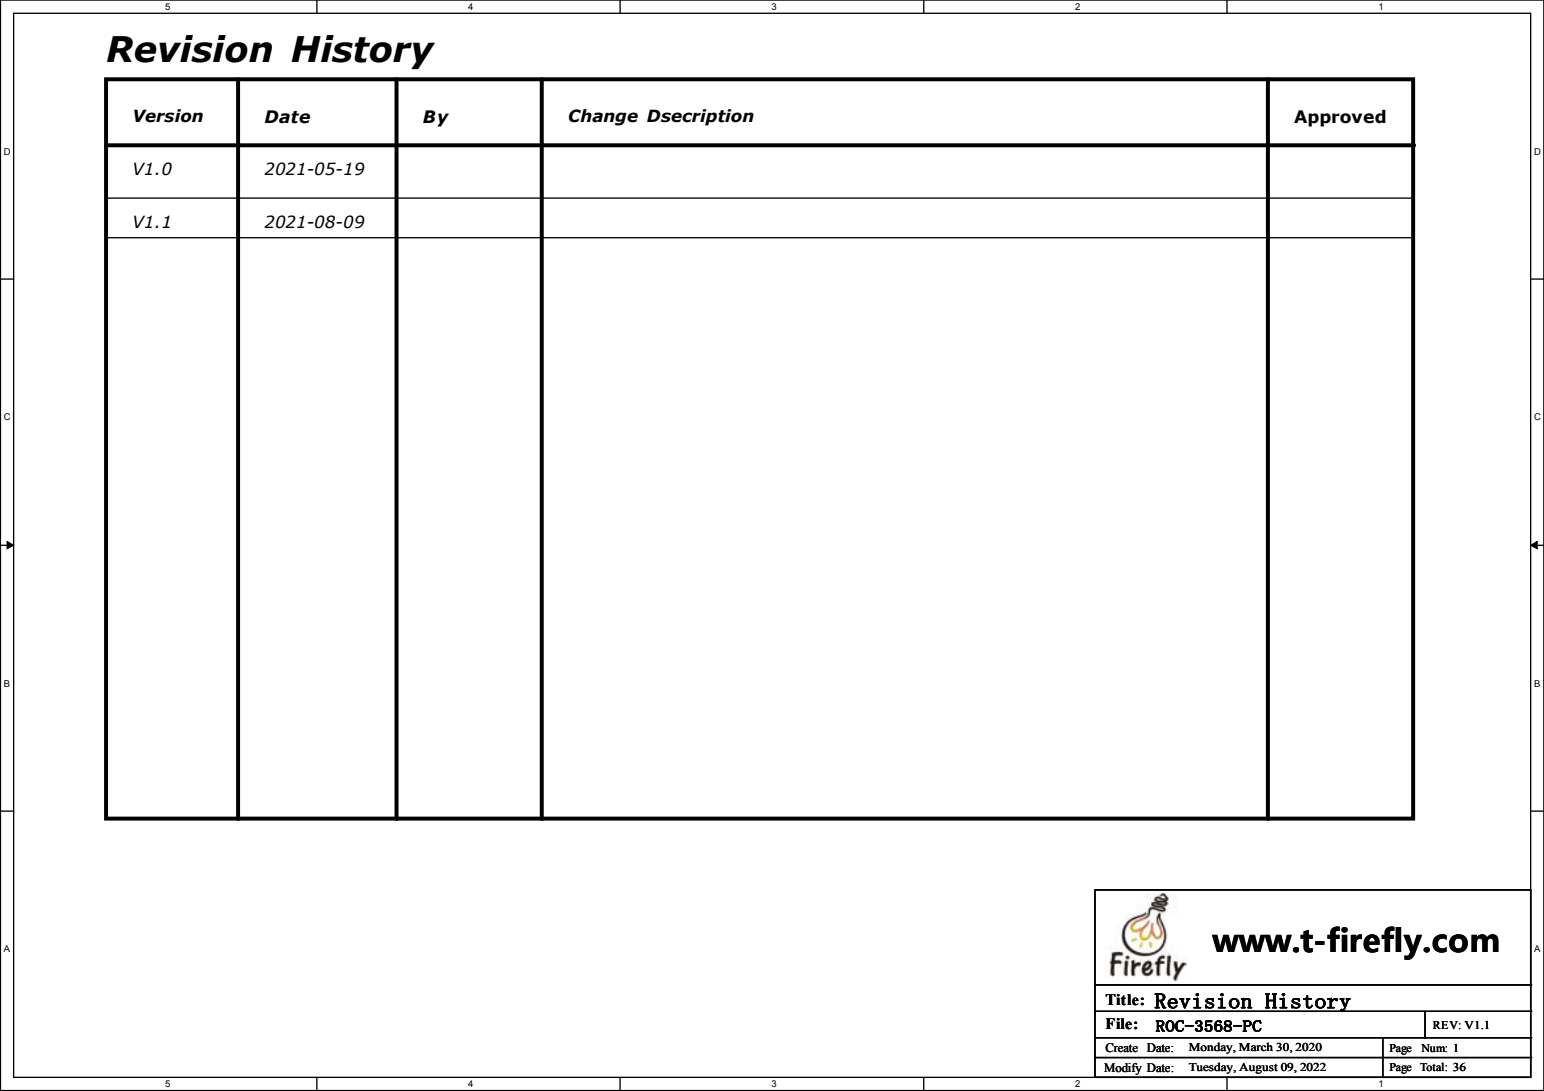
[picture p42: page 1]
Version; Date; Change Dsecription; Approved; REV:; Create Date:; Title:; File:; Page Num:; Modify Date:; Page Total:; Revision History; ROC-3568-PC; Monday, March 30, 2020; Tuesday, August 09, 2022; REV: V1.1

www.t-firefly.com

D | D

# RK3568_ABCDE (Power&Gnd)

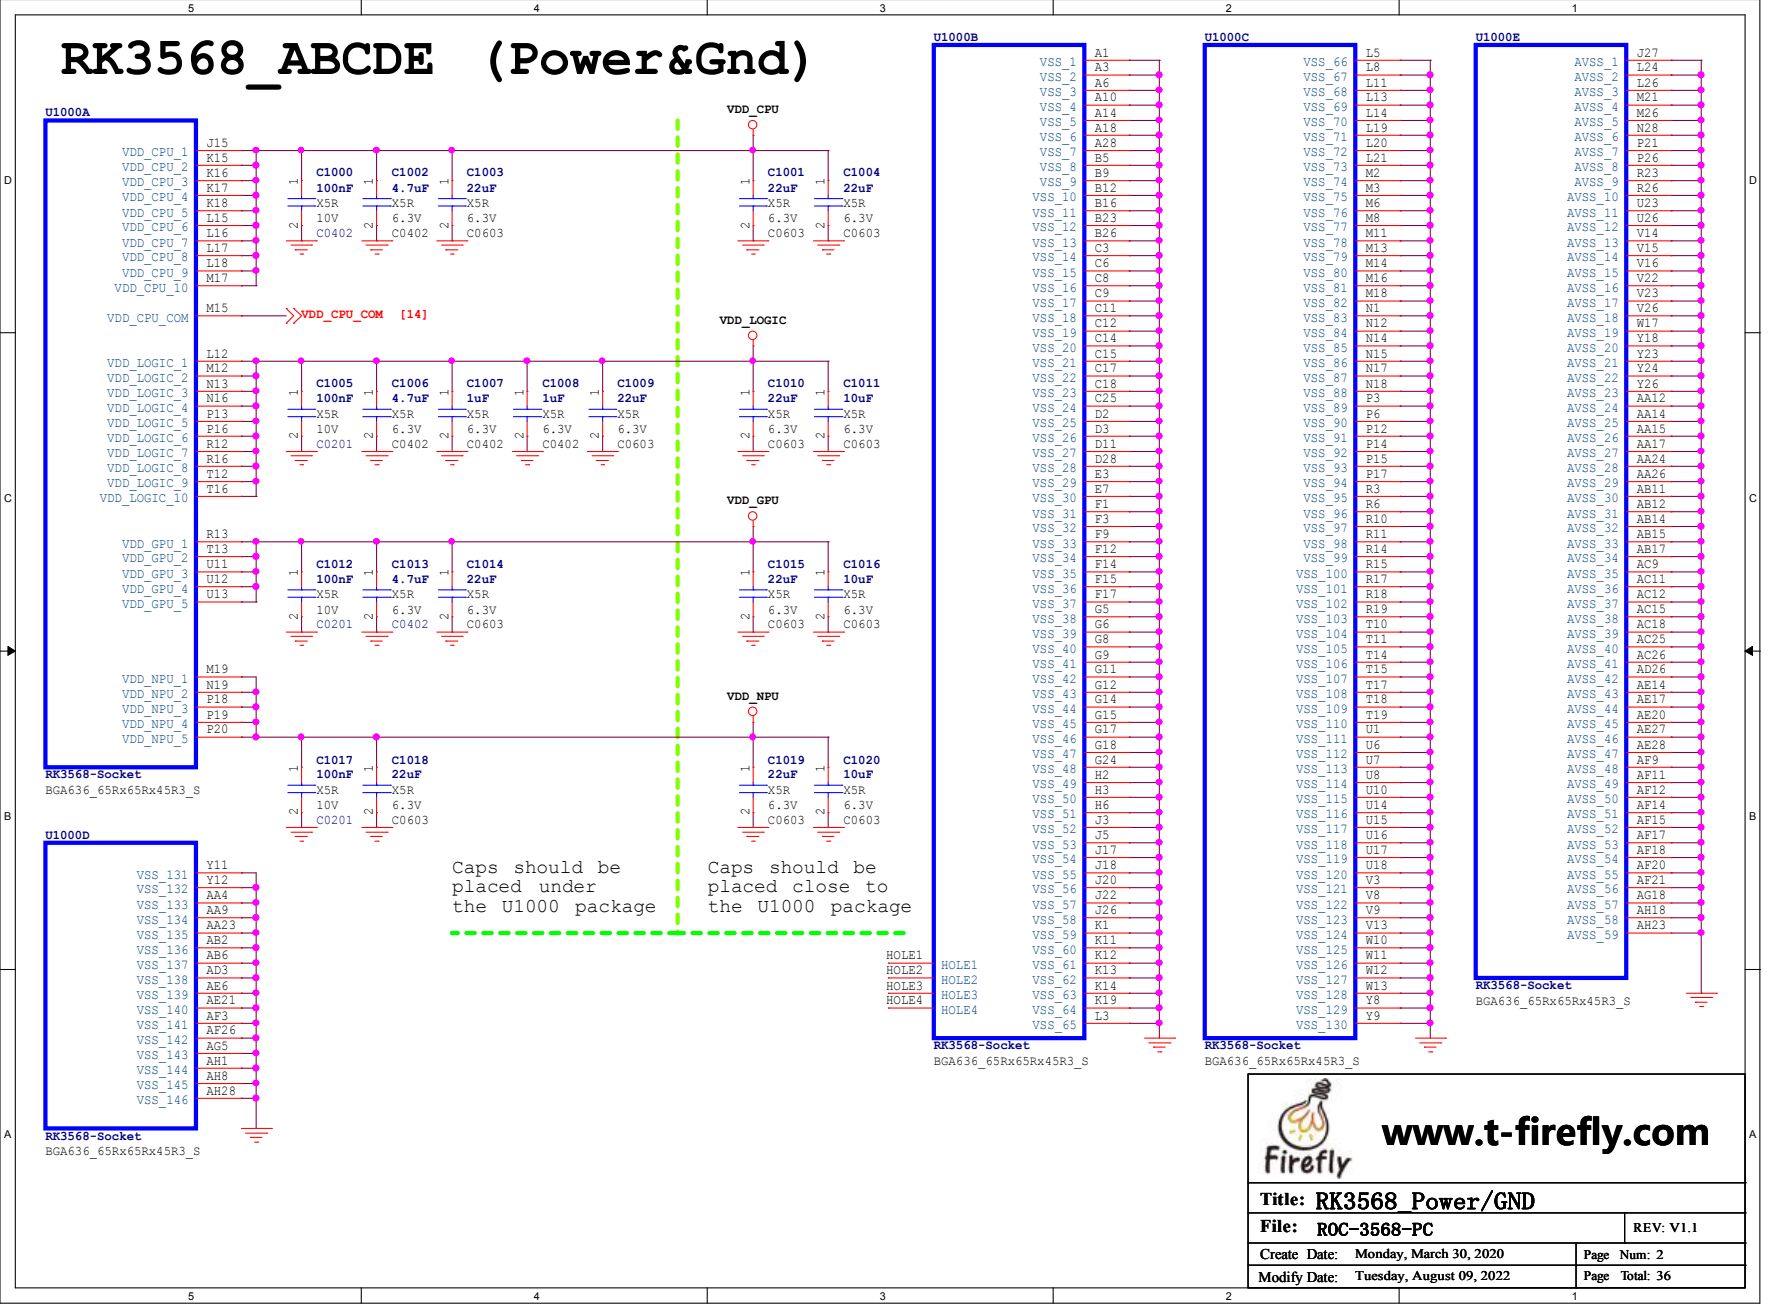
[picture p43: page 2]

# RK3568_F (DDR PHY)

## DDR4

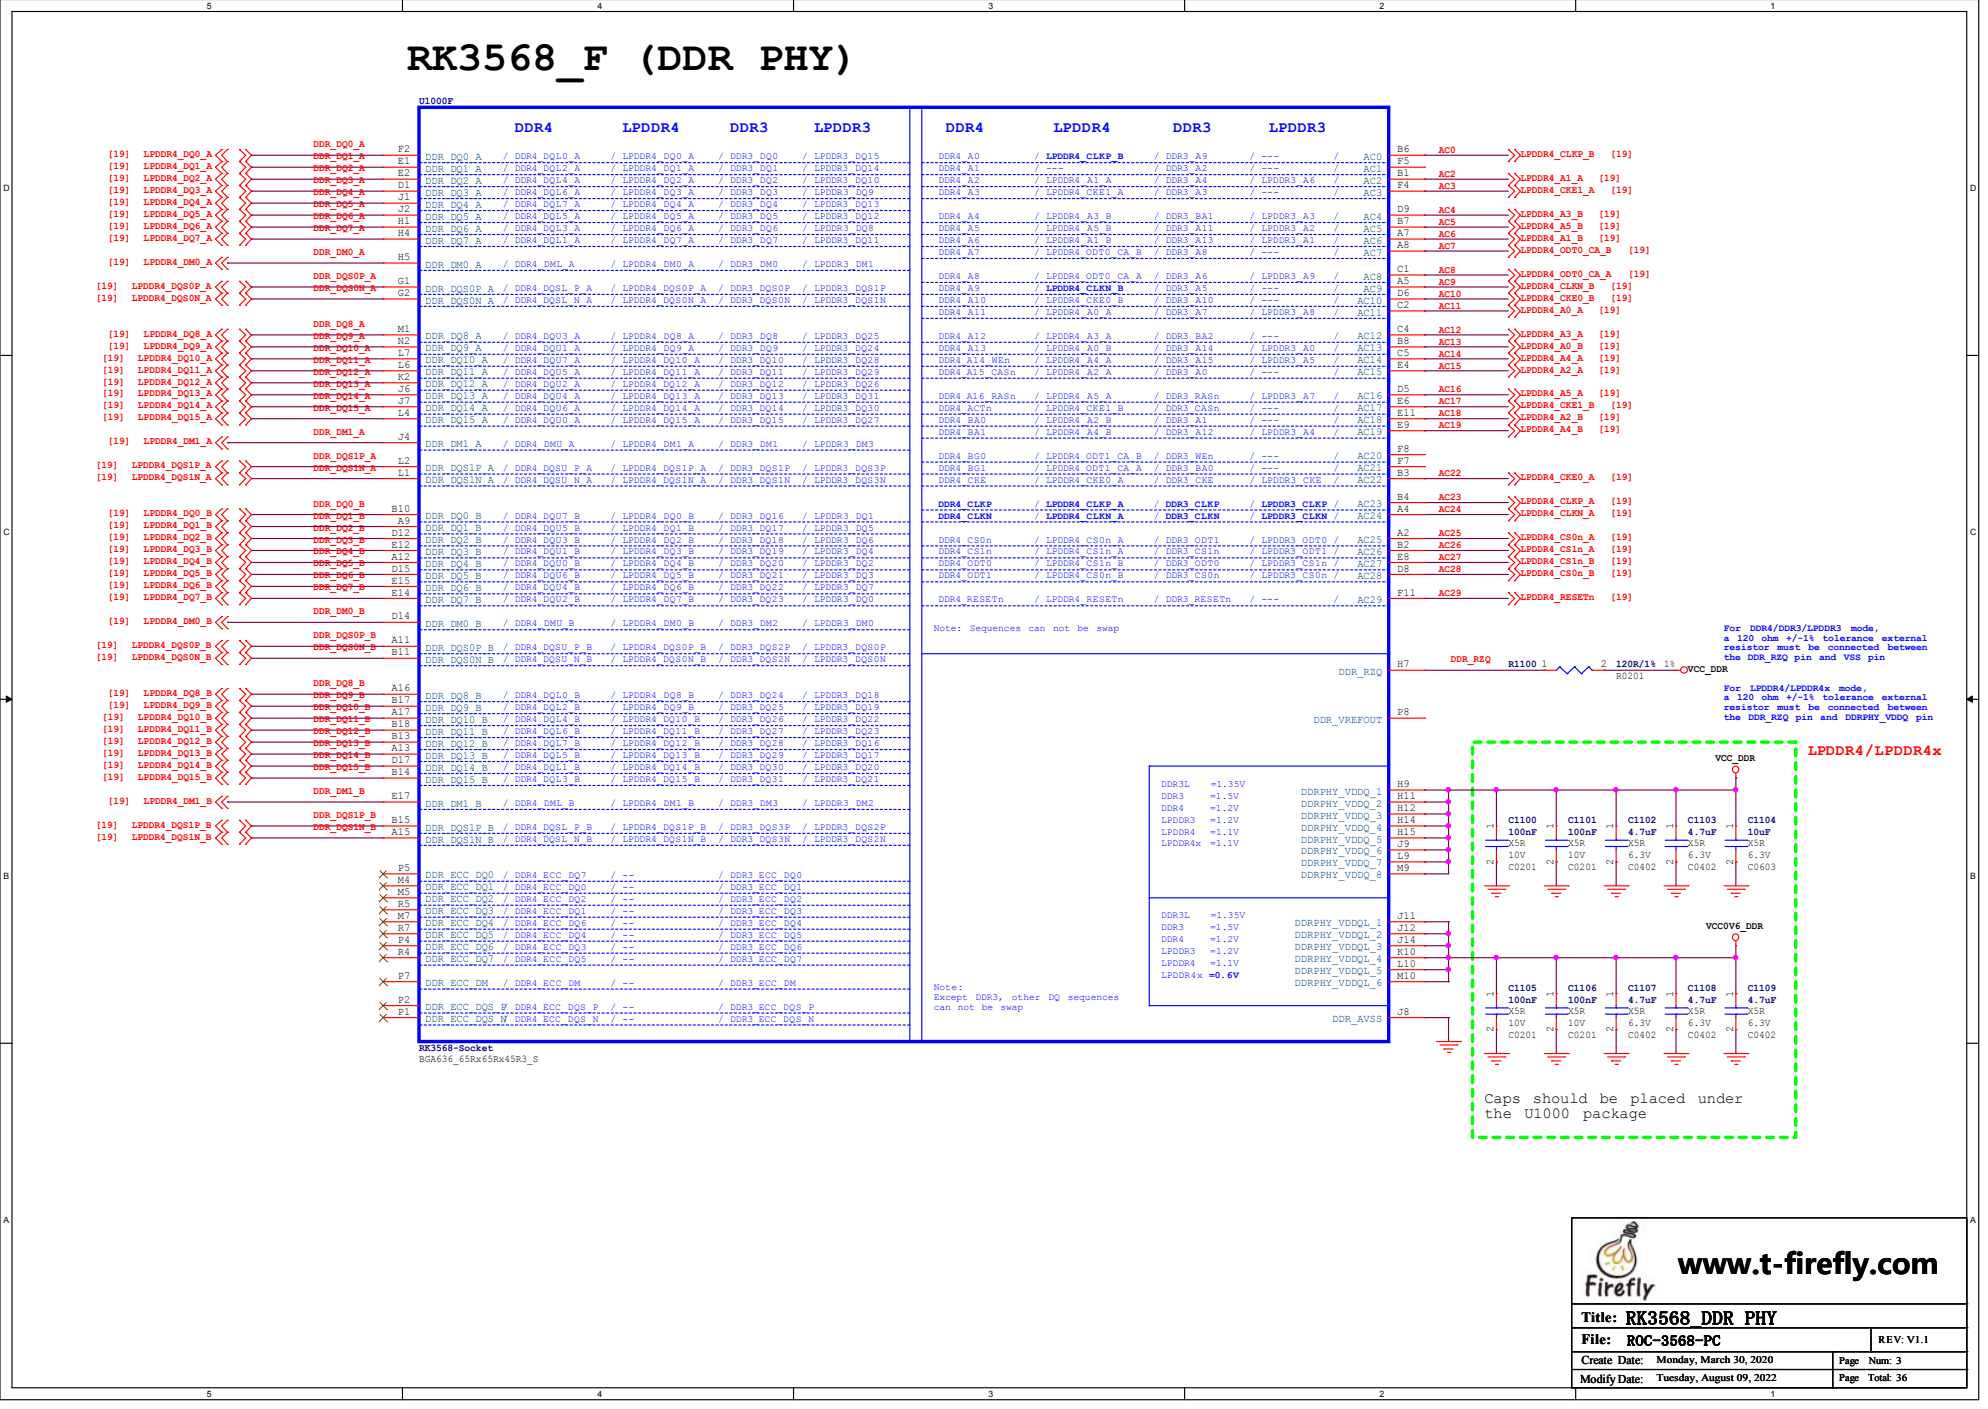
[picture p44: page 3]

Note: Sequences can not be swap

For DDR4/DDR3/LPDDR3 mode,
a 120 ohm +/-1% tolerance external
resistor must be connected between
the DDR_RZQ pin and VSS pin

For LPDDR4/LPDDR4x mode,
the DDR_RZQ pin and DDRPHY_VDDQ pin

Note:
Except DDR3, other DQ sequences
can not be swap

Caps should be placed under
the U1000 package

# RK3568_G(OSC/PLL/PMUIO1/2)

OSC | PMUIO1 Domain

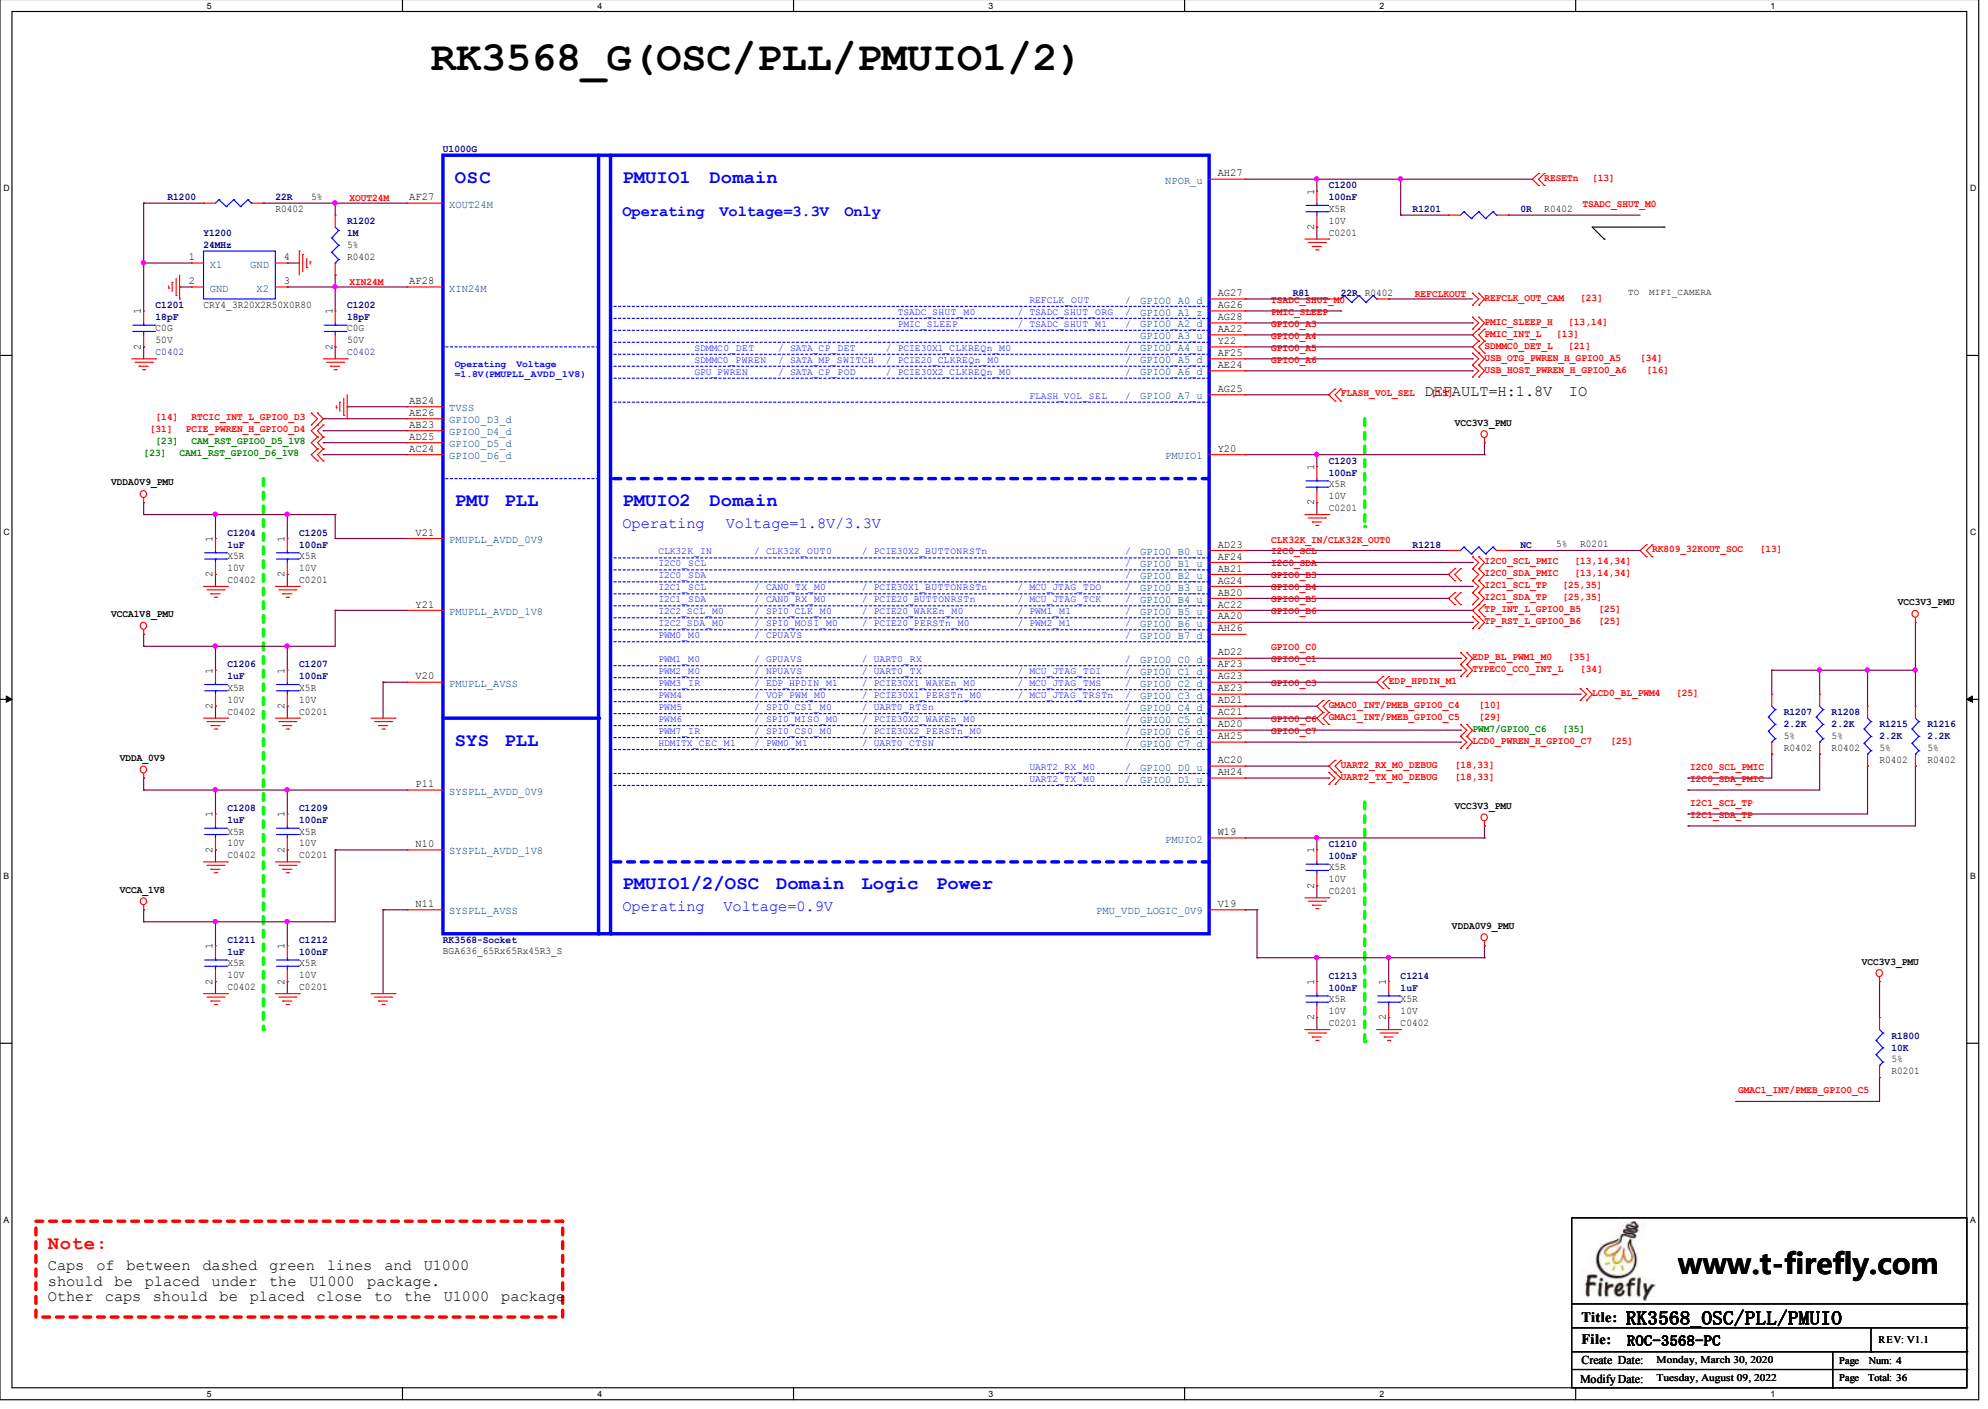
[picture p45: page 4]

PMUIO1/2/OSC Domain Logic Power

Caps of between dashed green lines and U1000
should be placed under the U1000 package.
Other caps should be placed close to the U1000 package

# RK3568_I(VCCIO2 Domain)

# VCCIO2 Domain

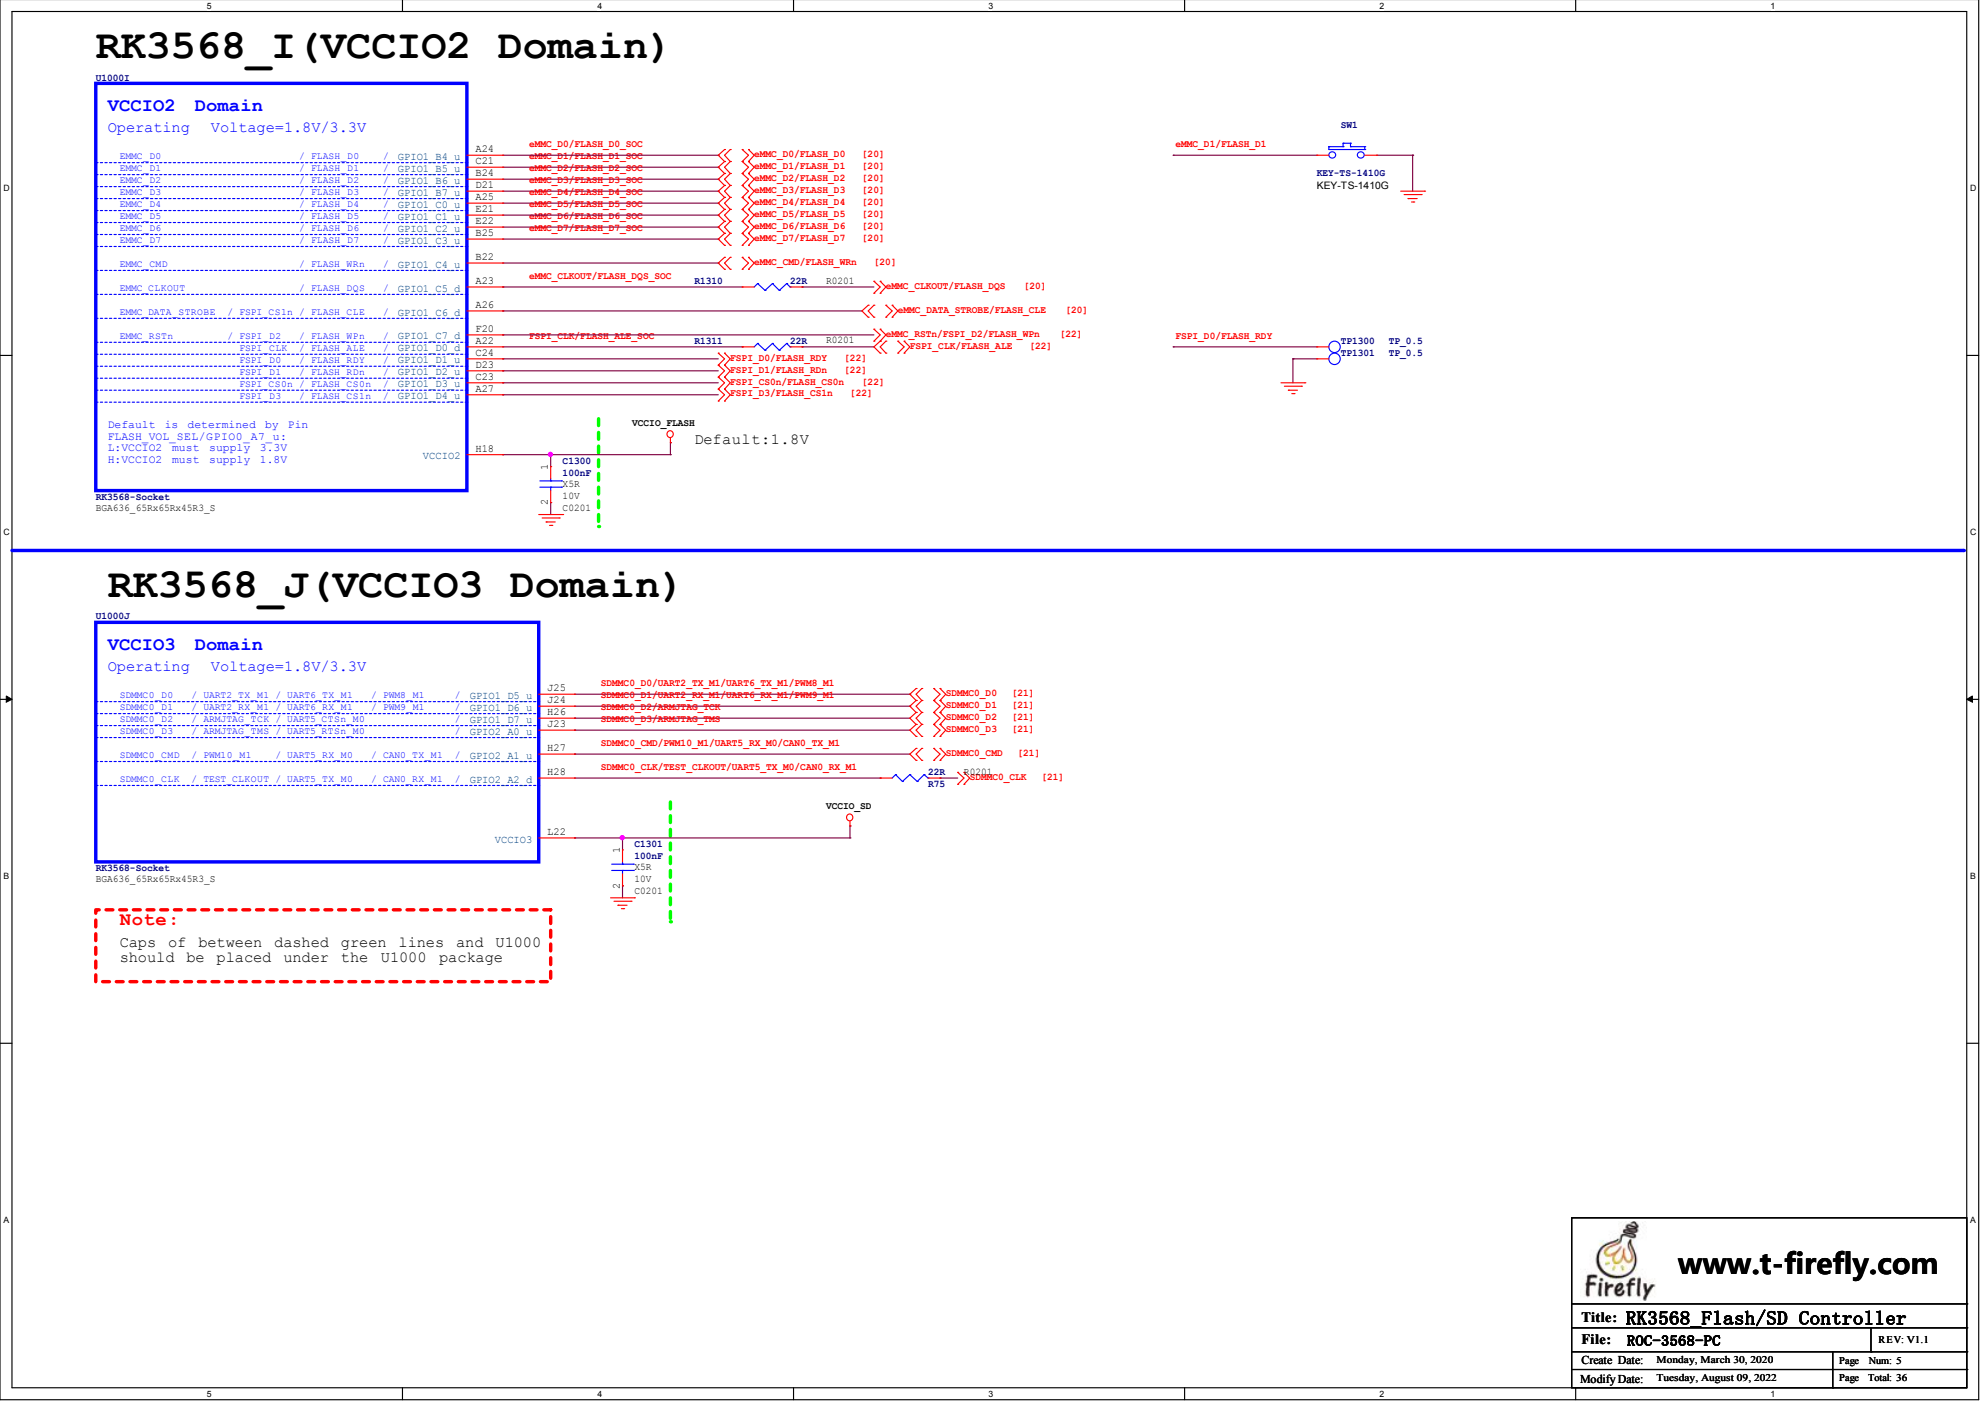
[picture p46: page 5]

Default is determined by Pin
FLASH_VOL_SEL/GPIO0_A7_u:
L:VCCIO2 must supply 3.3V
H:VCCIO2 must supply 1.8V

Caps of between dashed green lines and U1000
should be placed under the U1000 package

# RK3568_U(USB3.0/SATA/QSGMII/PCIe2.0 x1) RK3568_V(USB2.0 HOST)

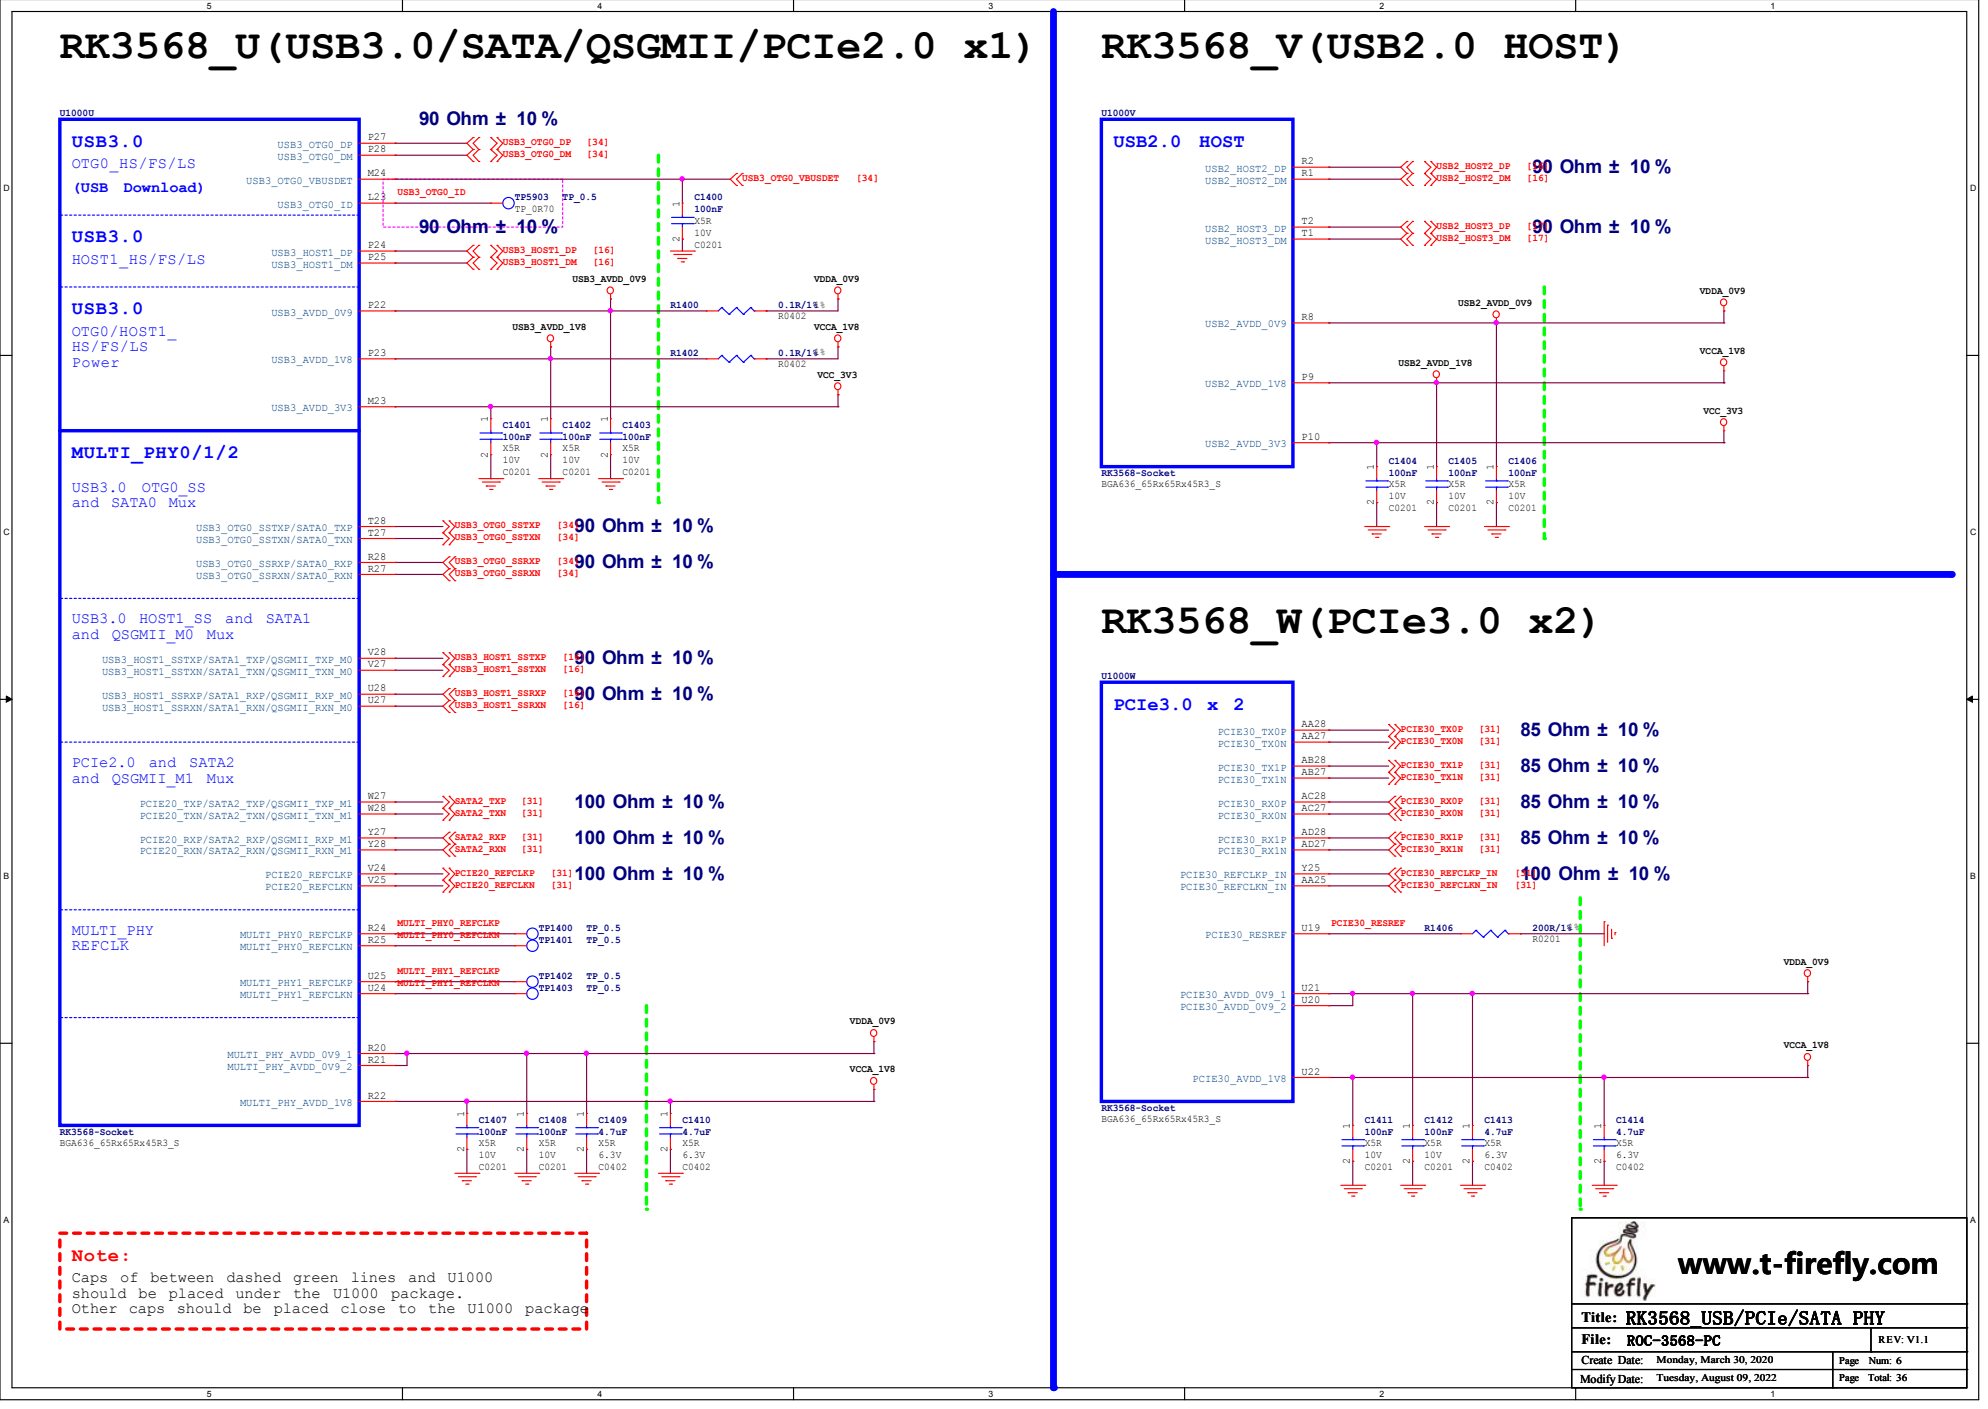
[picture p47: page 6]
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

# RK3568_K(VCCIO4 Domain) RK3568_O(SARADC/OTP)

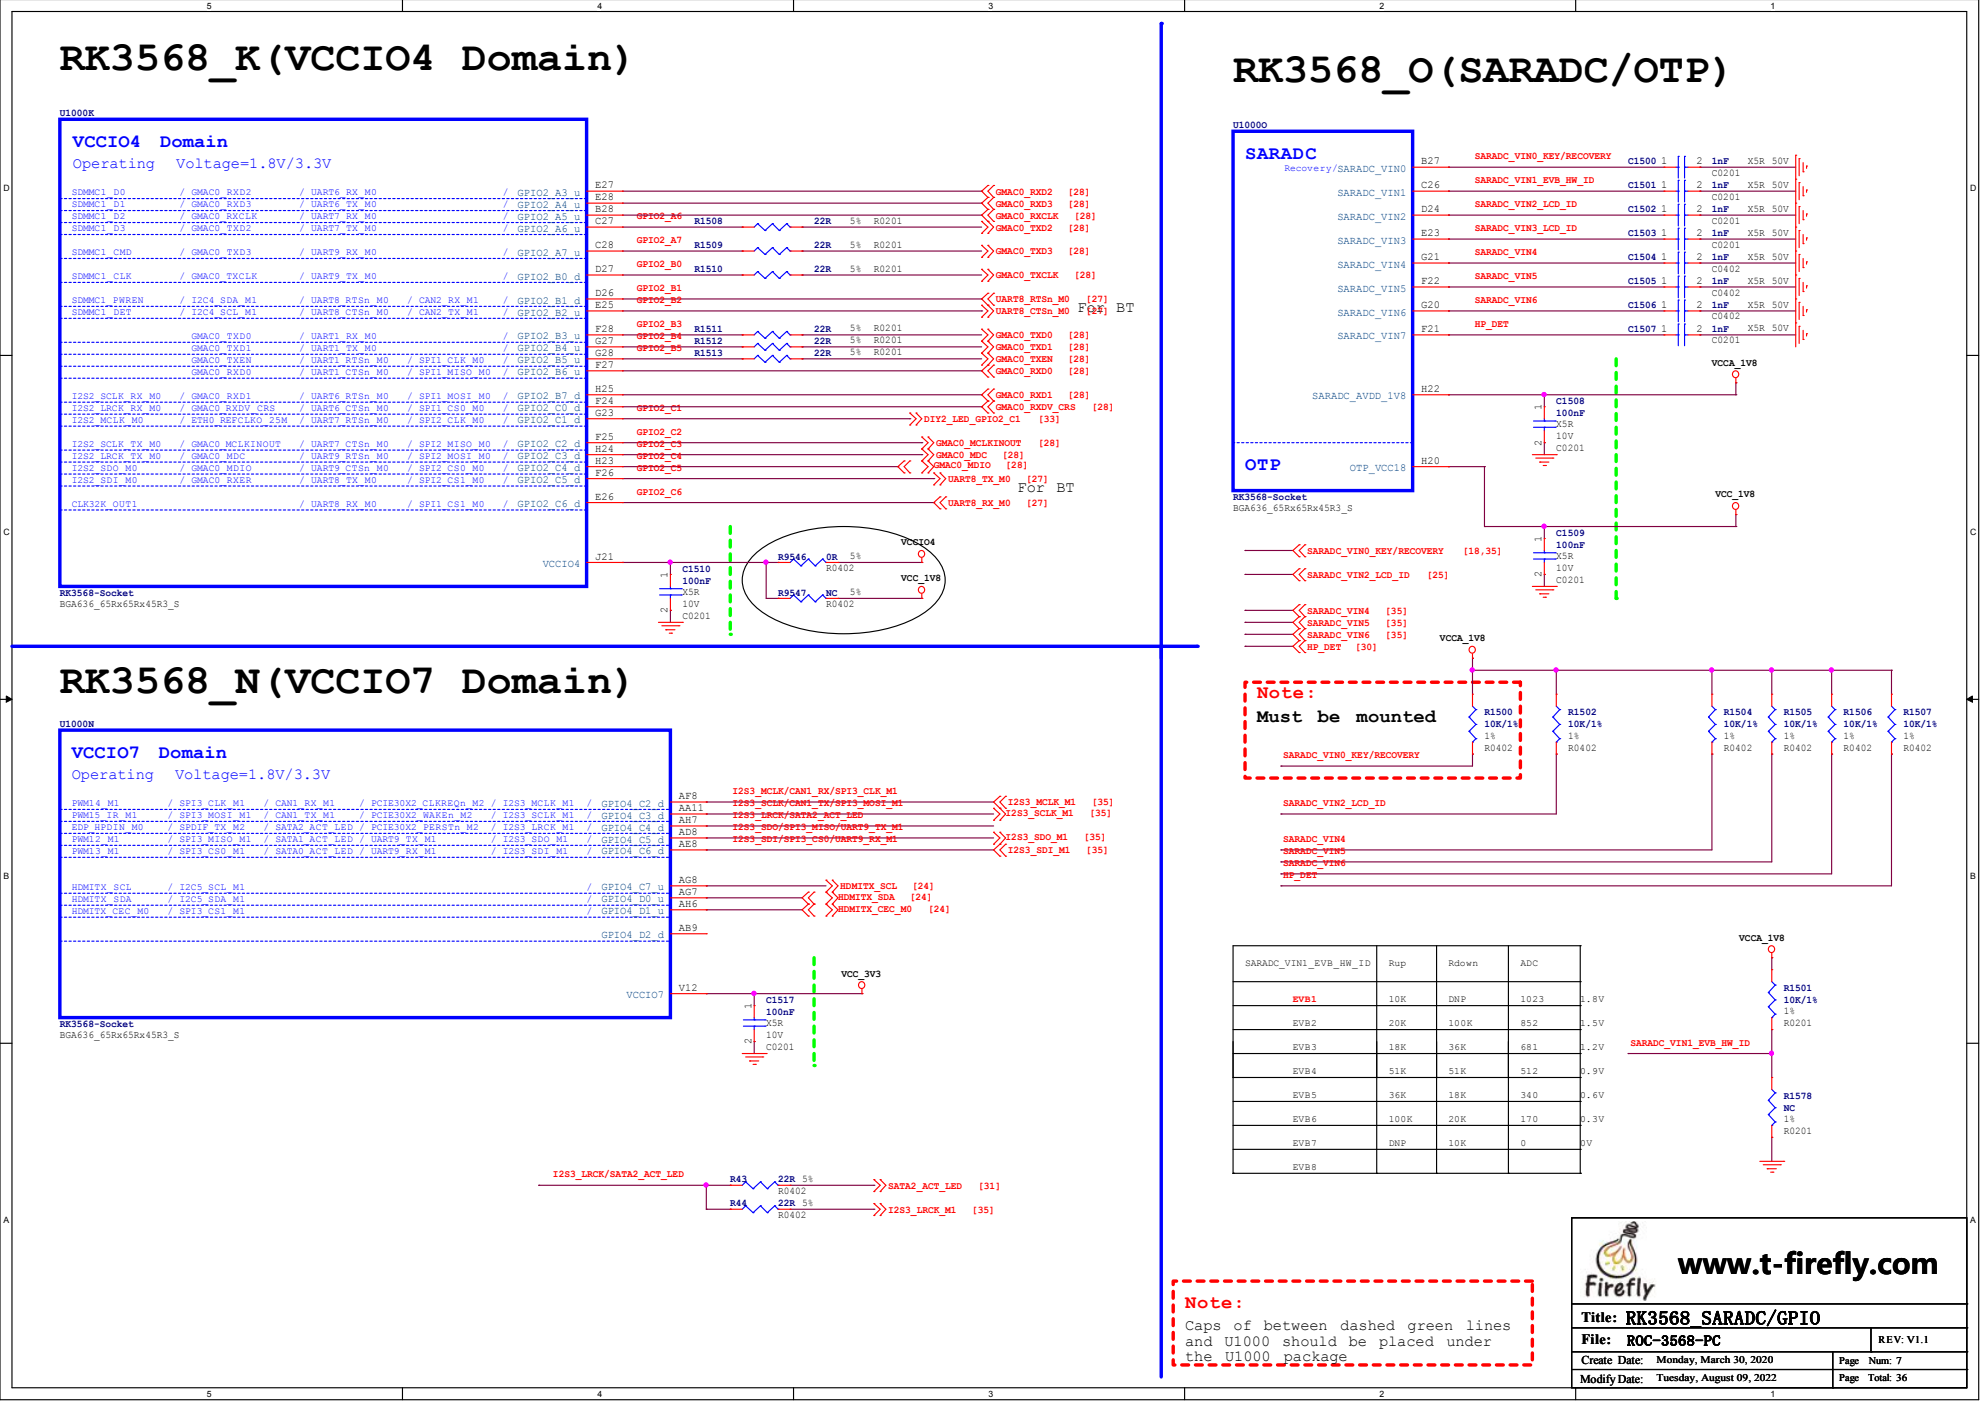
[picture p48: page 7]

SARADC_VIN1_EVB_HW_ID | Rup | Rdown | ADC

EVB1 | 10K | DNP | 1023

EVB2 | 20K | 100K | 852

EVB3 | 18K | 36K | 681

EVB4 | 51K | 51K | 512

EVB5 | 36K | 18K | 340

EVB6 | 100K | 20K | 170

EVB7 | DNP | 10K | 0

EVB8

Caps of between dashed green lines
and U1000 should be placed under
the U1000 package

# RK3568_P(MIPI_CSI_RX)

## MIPI_CSI_RX

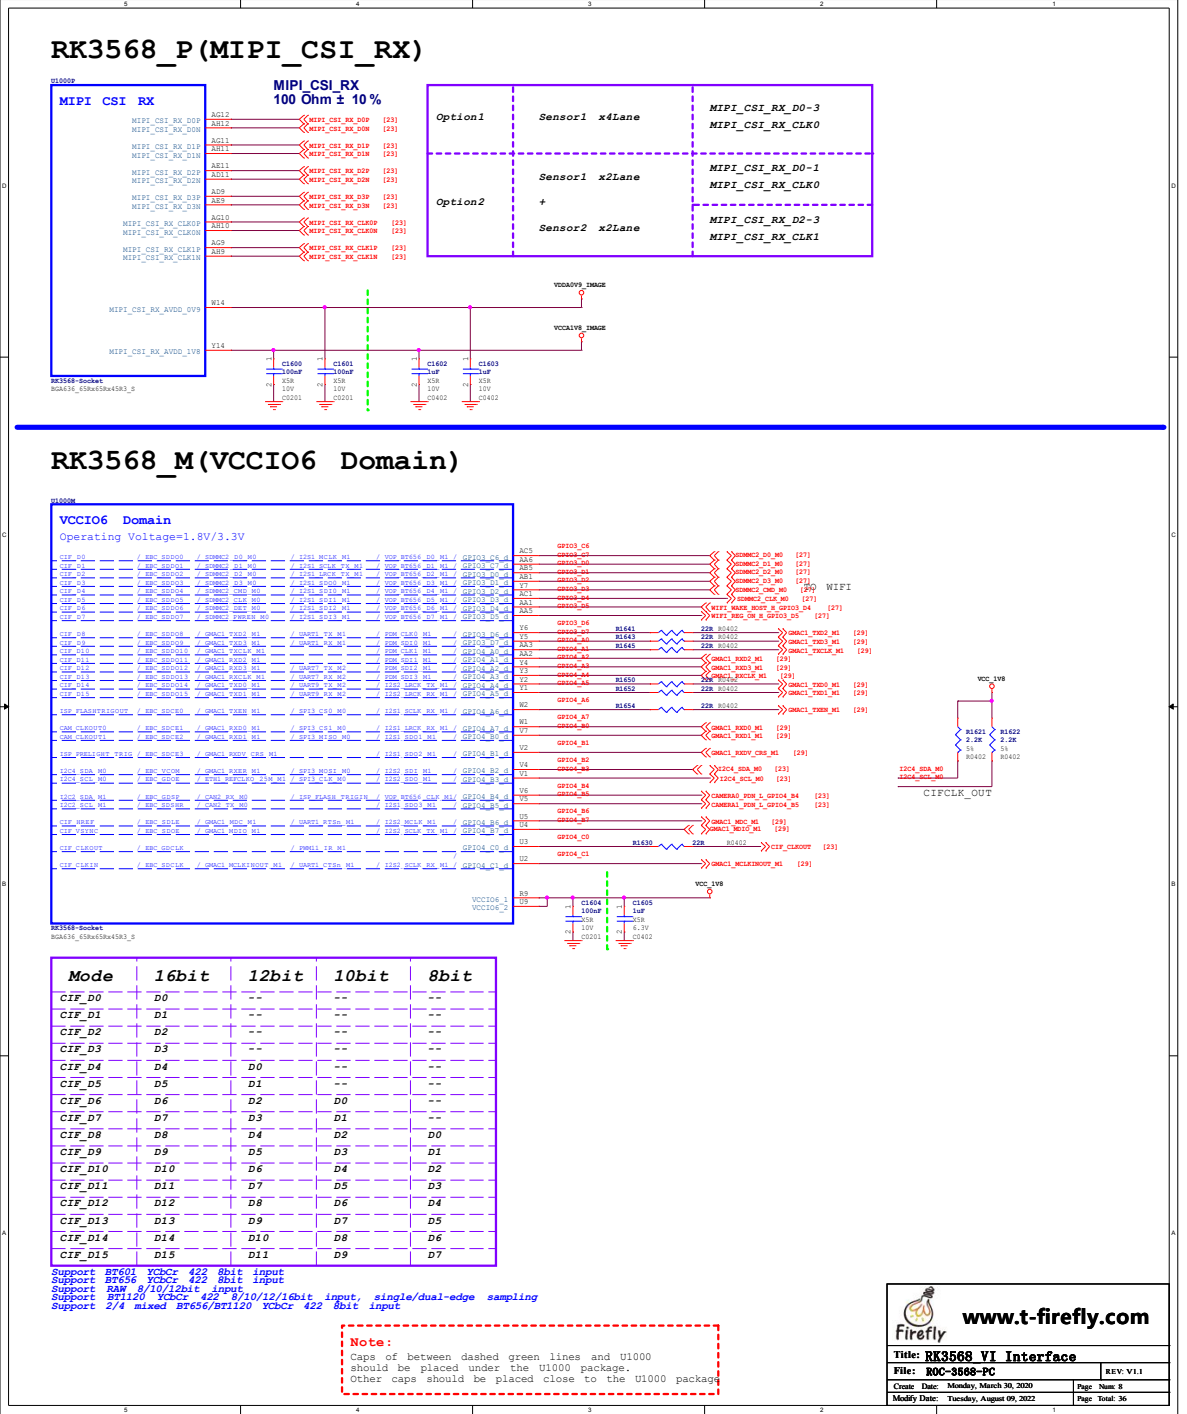
[picture p49: page 8]
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

RK3568_R(MIPI_DSI_TX0/LVDS_TX0) | RK3568_S(MIPI_DSI_TX1)

MIPI_DSI_TX0/LVDS_TX0 100 Ohm ± 10 % MIPI_DSI_TX0_D0P/LVDS_TX0_D0P [25] MIPI_DSI_TX0_D0N/LVDS_TX0_D0N [25] MIPI_DSI_TX0_D1P/LVDS_TX0_D1P [25] MIPI_DSI_TX0_D1N/LVDS_TX0_D1N [25] MIPI_DSI_TX0_D2P/LVDS_TX0_D2P [25] MIPI_DSI_TX0_D2N/LVDS_TX0_D2N [25] MIPI_DSI_TX0_D3P/LVDS_TX0_D3P [25] MIPI_DSI_TX0_D3N/LVDS_TX0_D3N [25] MIPI_DSI_TX0_CLKP/LVDS_TX0_CLKP [25] MIPI_DSI_TX0_CLKN/LVDS_TX0_CLKN [25] VDDA0V9_IMAGE

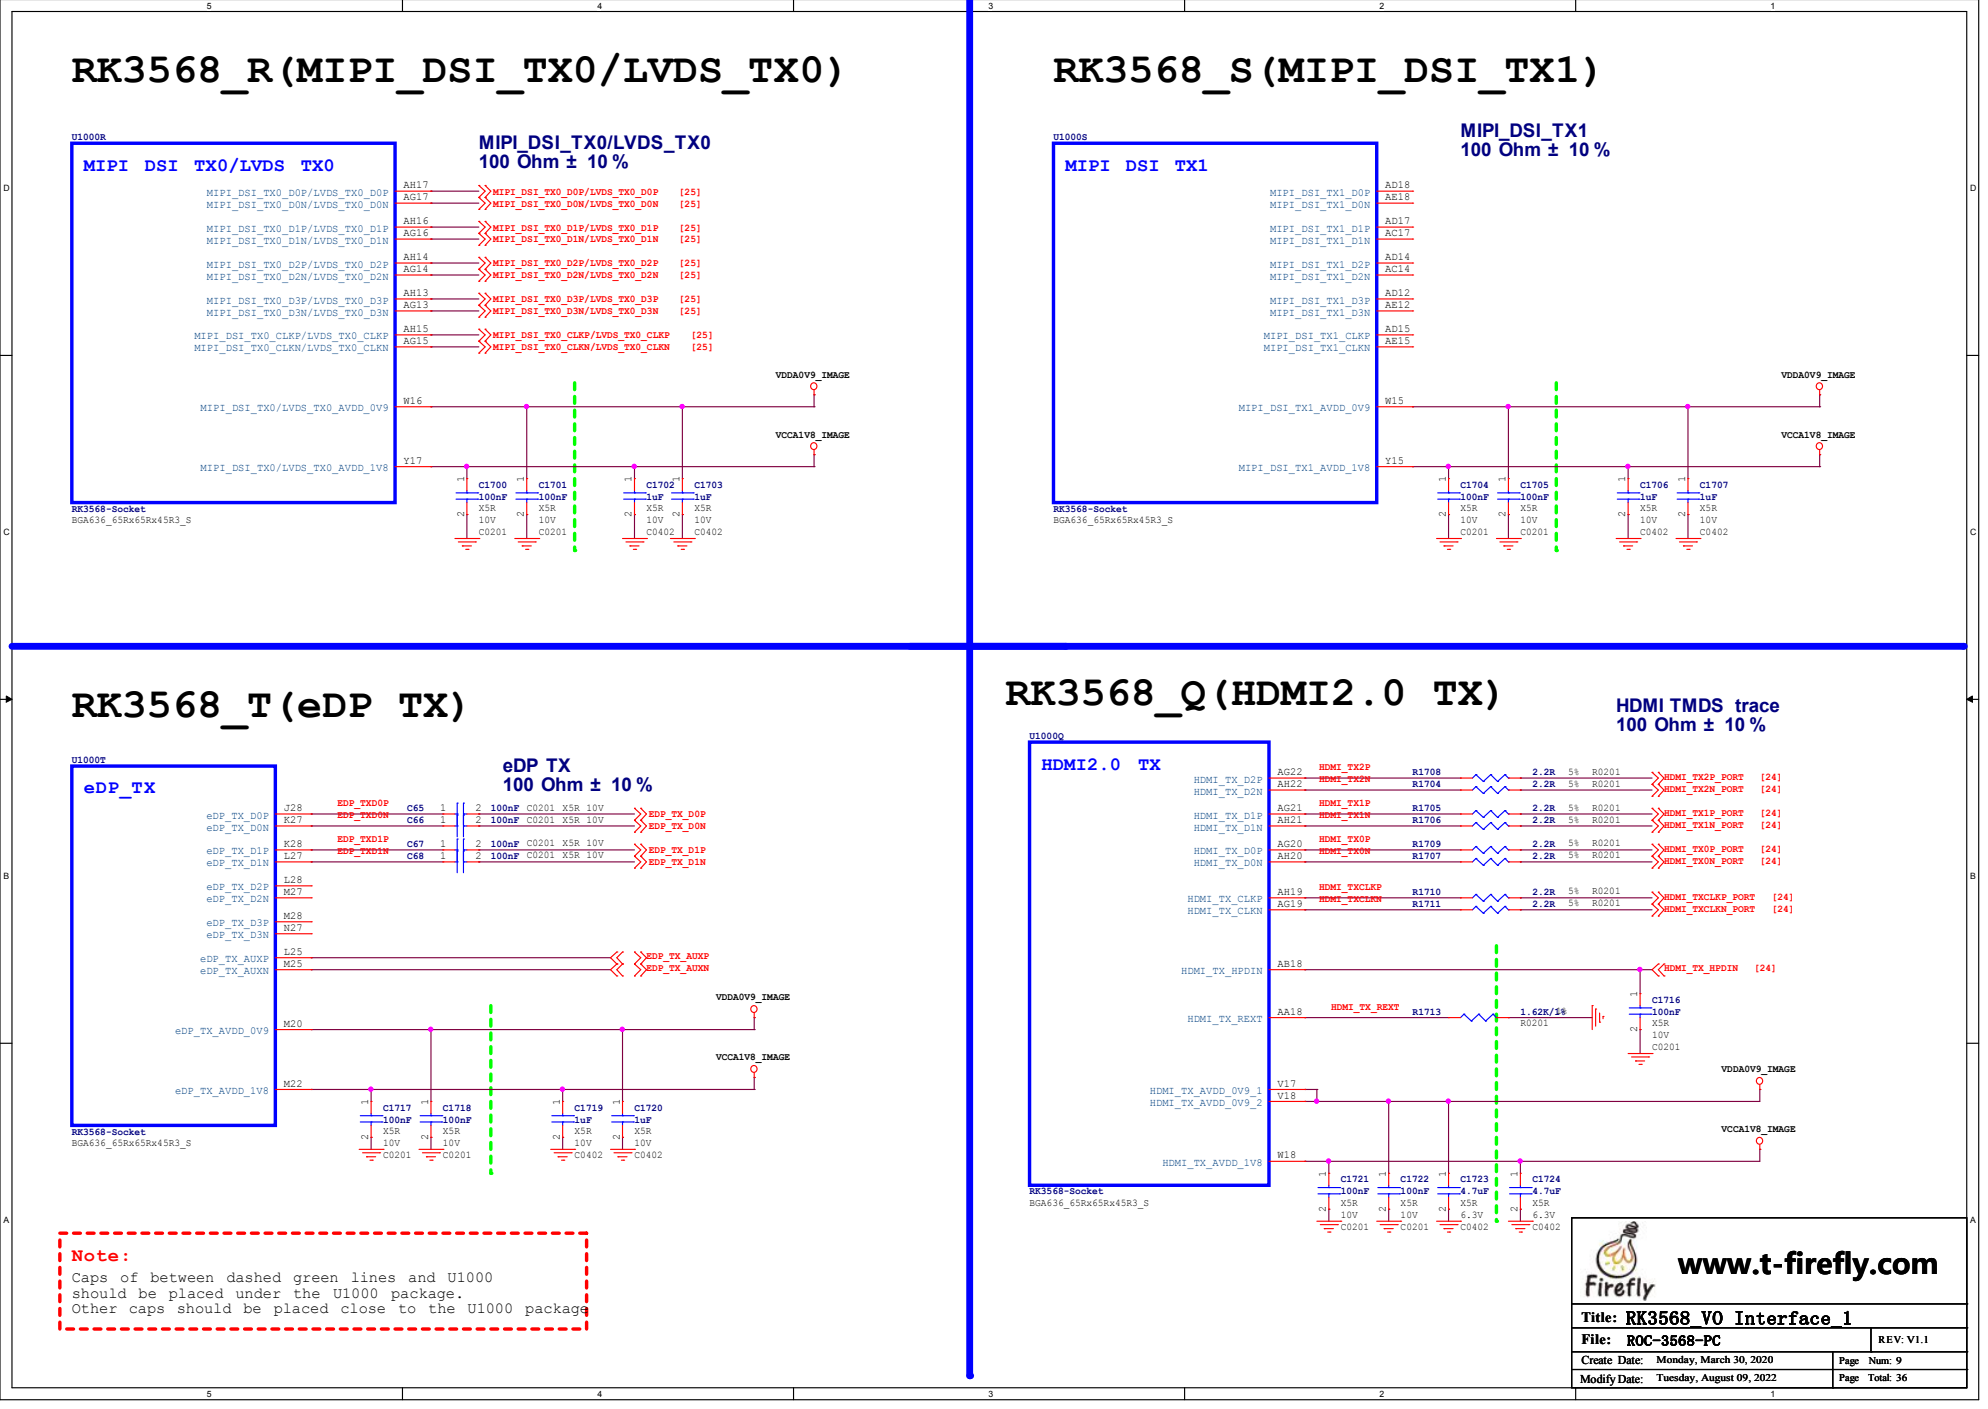
[picture p50: page 9]

VCCA1V8_IMAGE

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

D | D

# RK3568_L(VCCIO5 Domain)

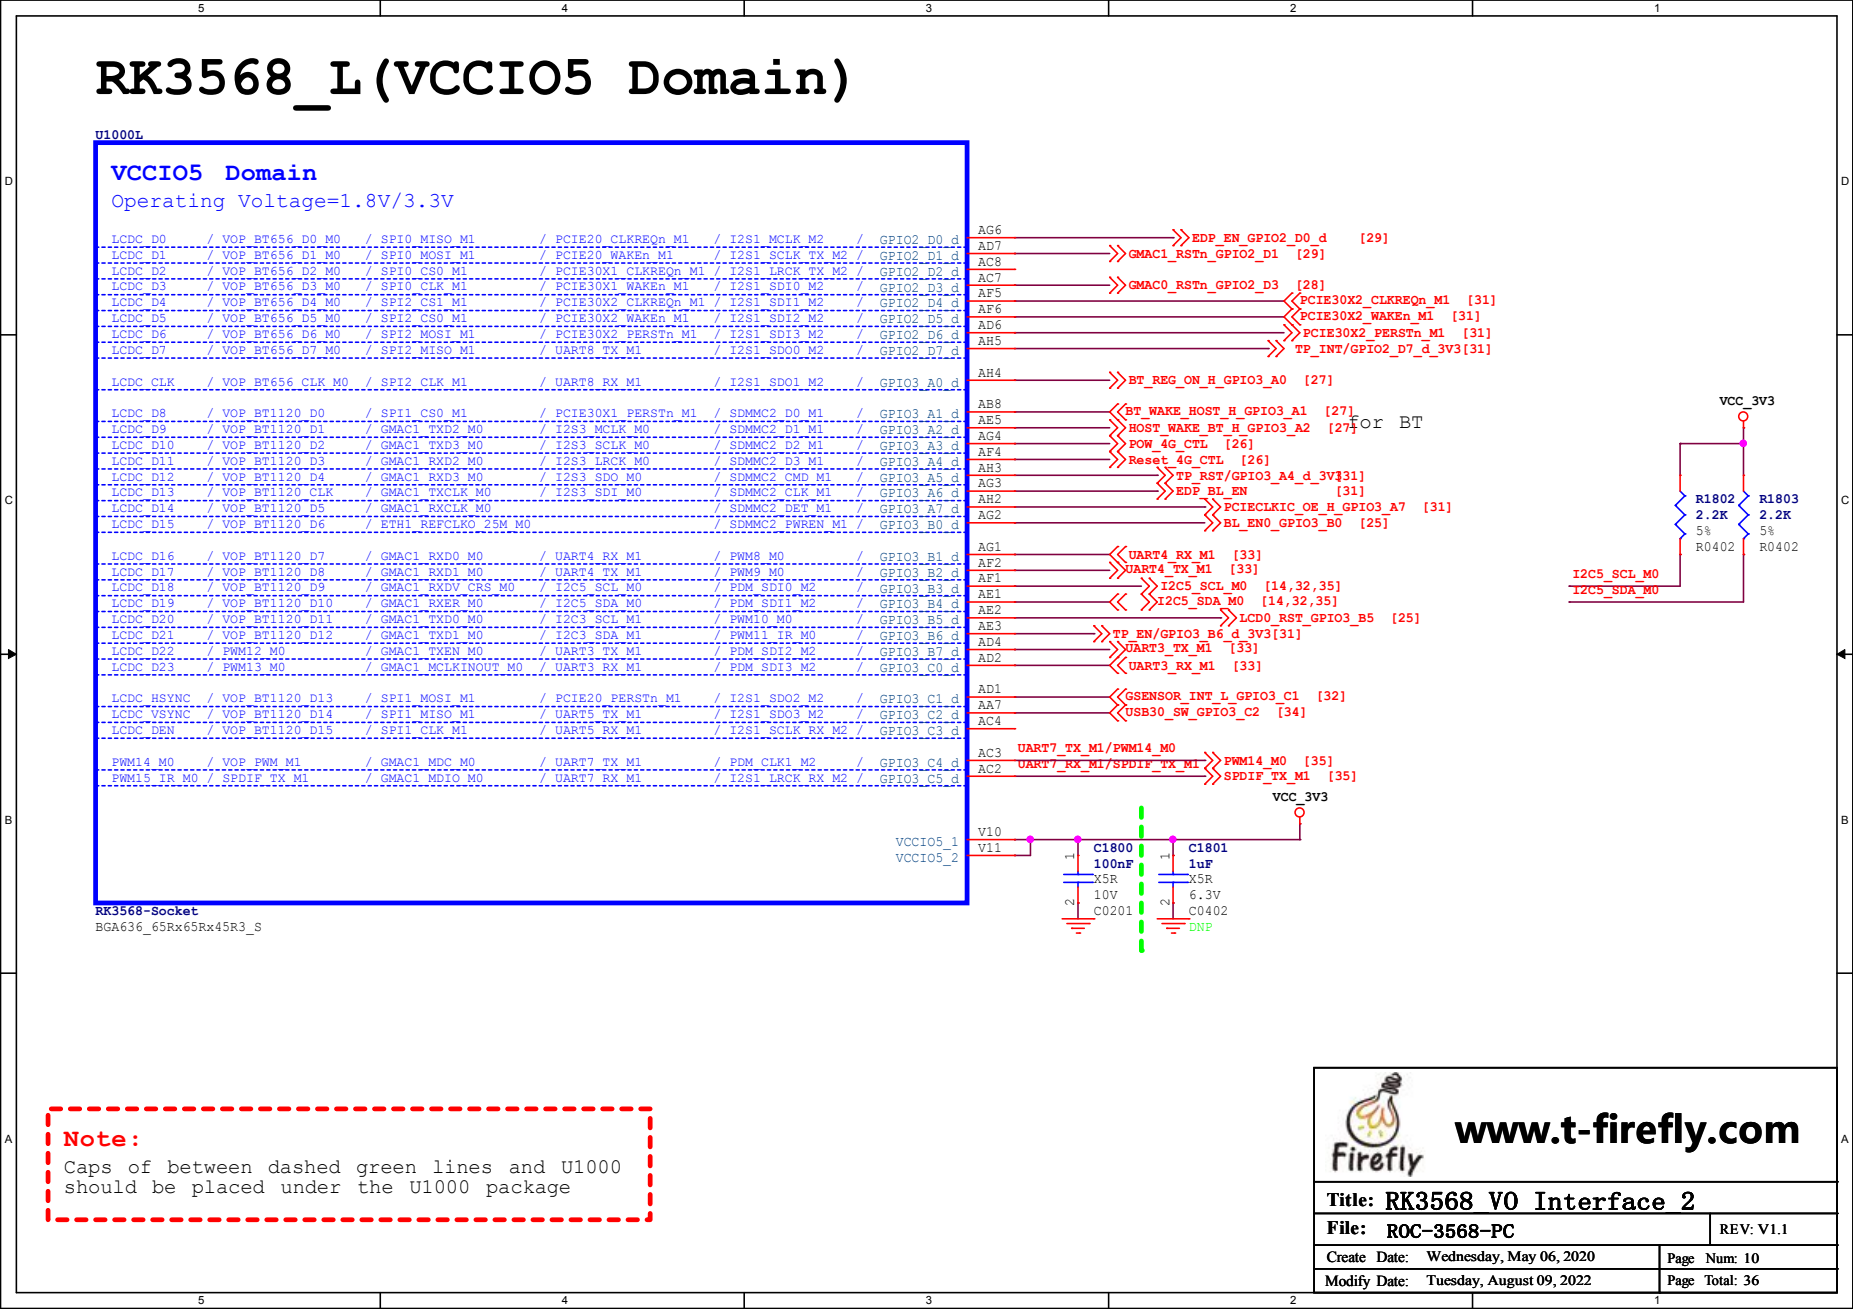
[picture p51: page 10]

Note:
Caps of between dashed green lines and U1000
should be placed under the U1000 package

D | D

# RK3568_H(VCCIO1 Domain)

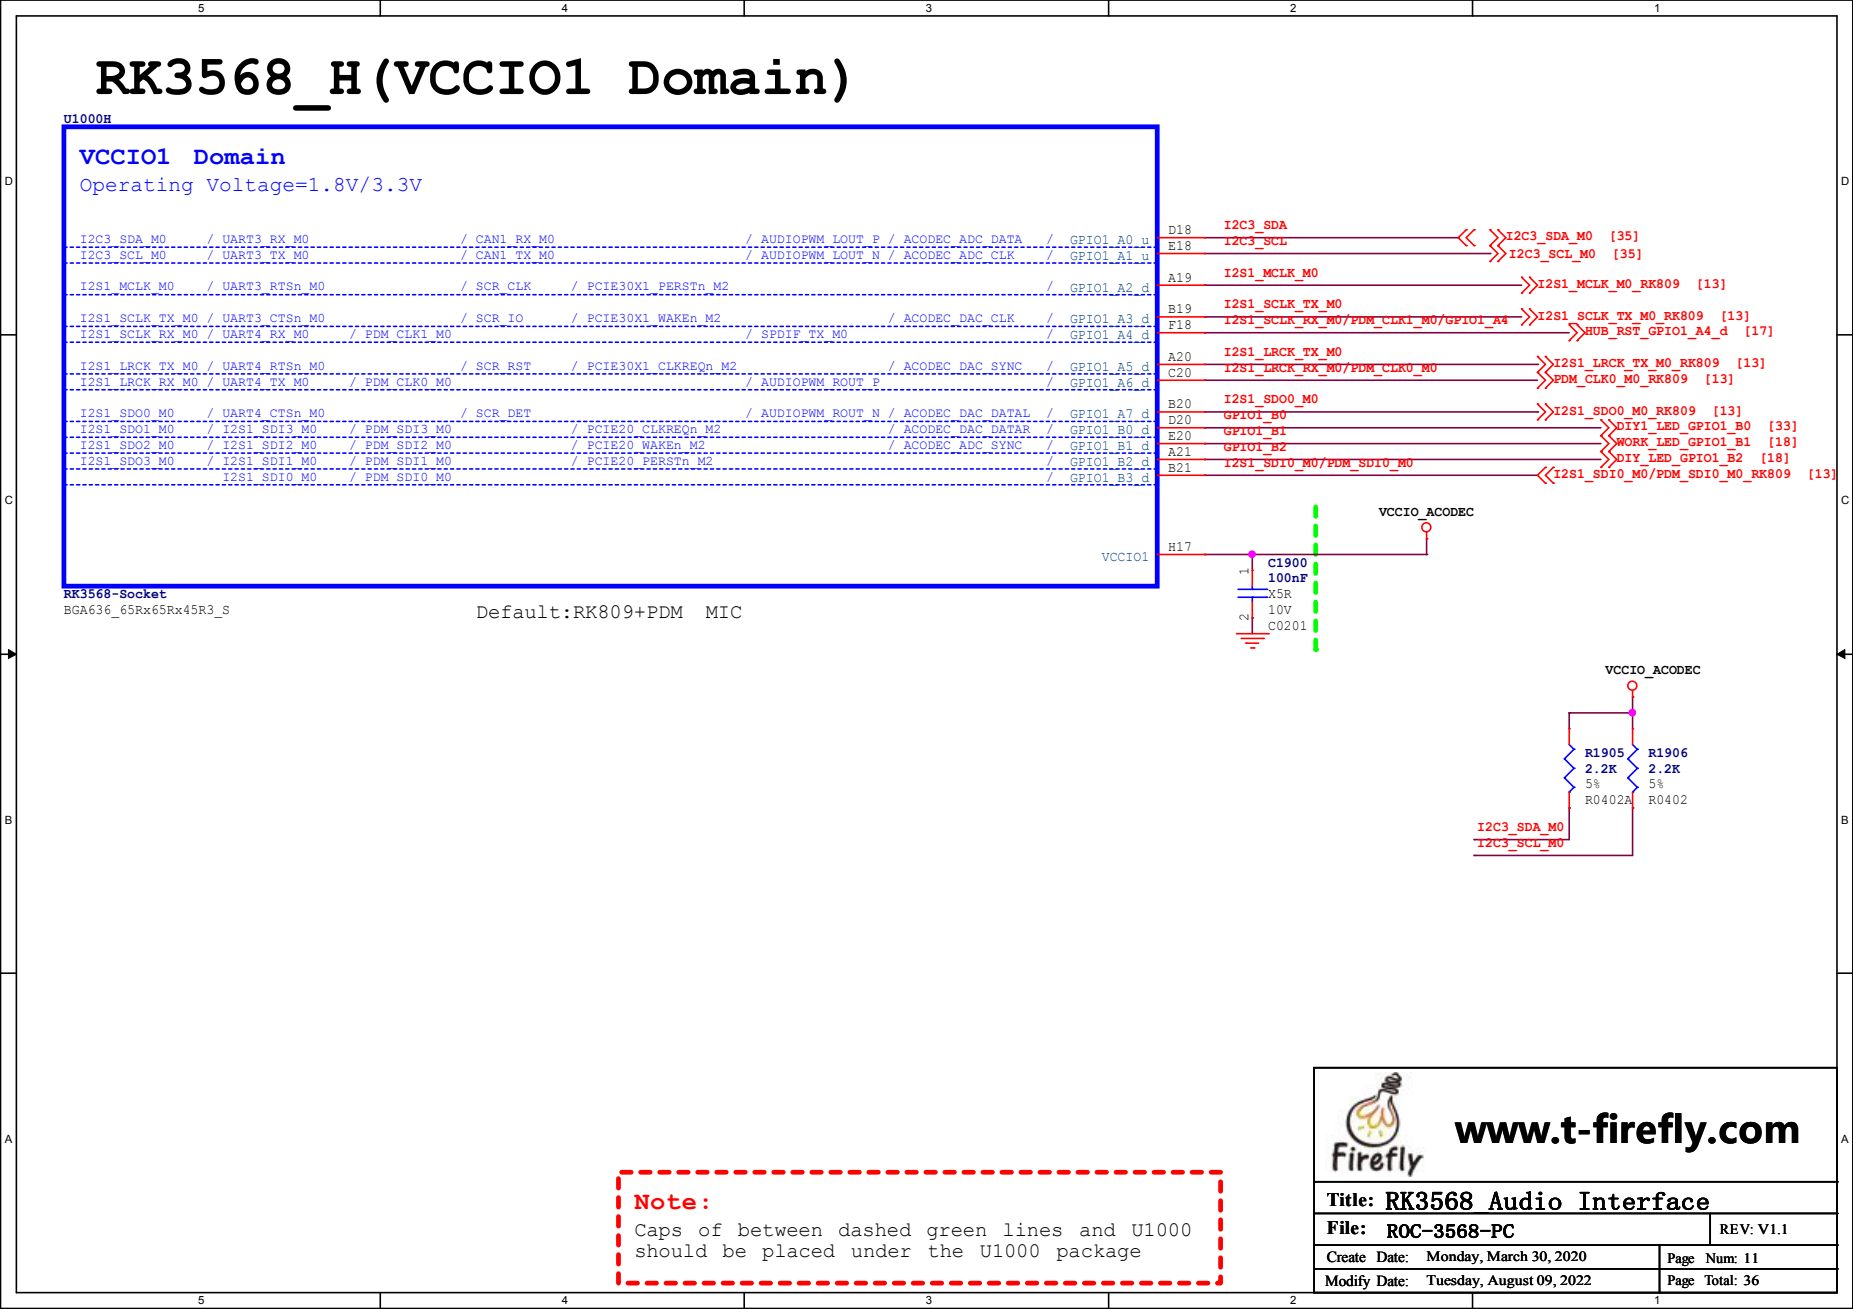
[picture p52: page 11]

Note:
Caps of between dashed green lines and U1000
should be placed under the U1000 package

12V/3A

# DCIN

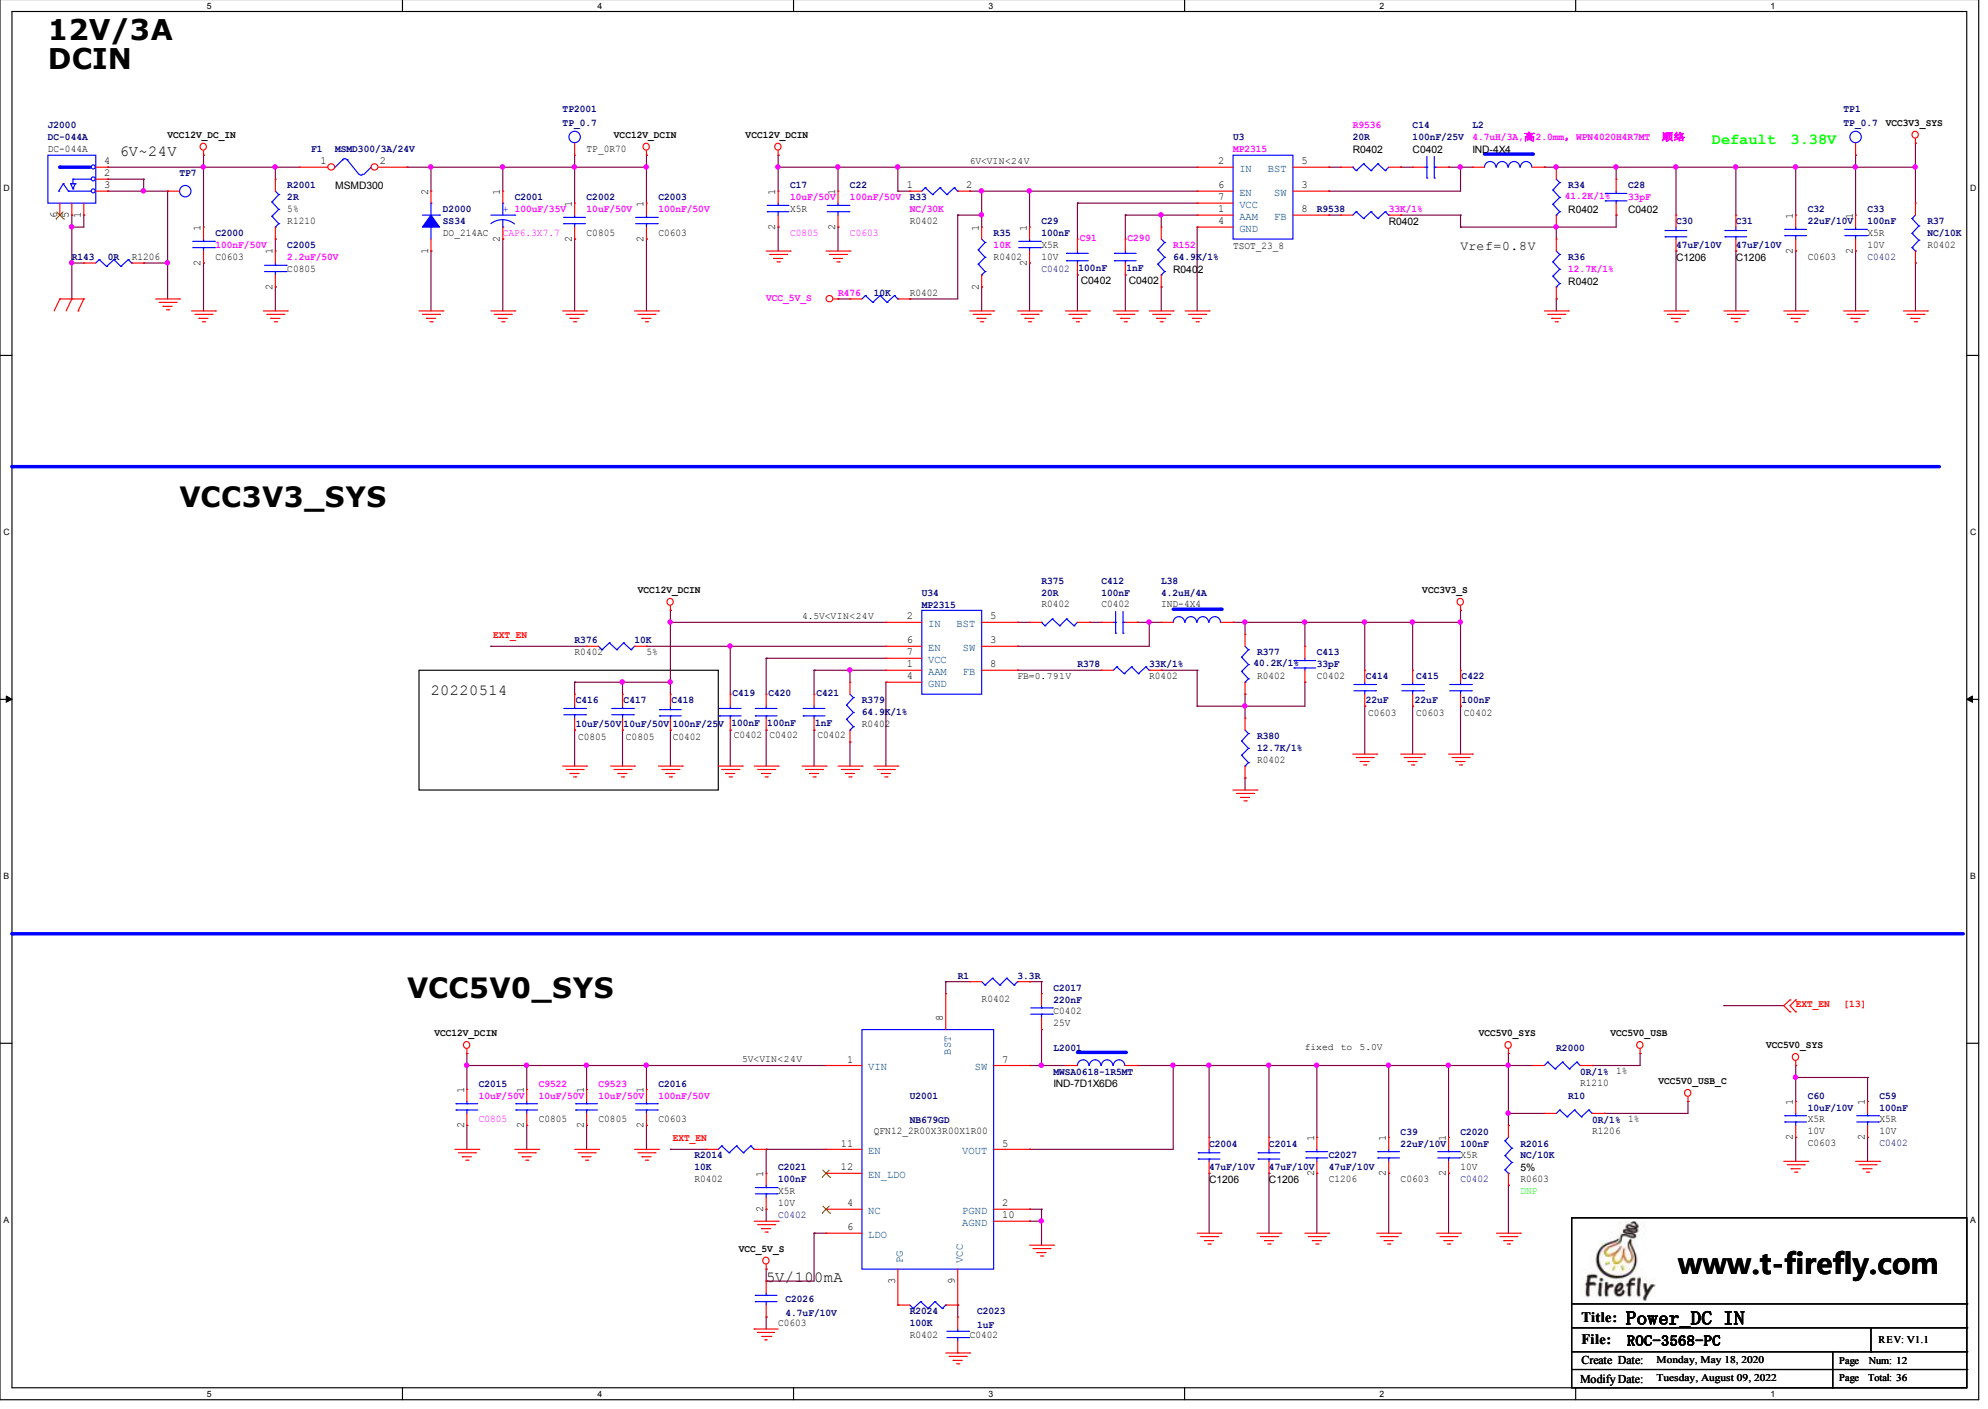
[picture p53: page 12]

# PMIC RK809 DCDC

# PMIC RK809 LDO

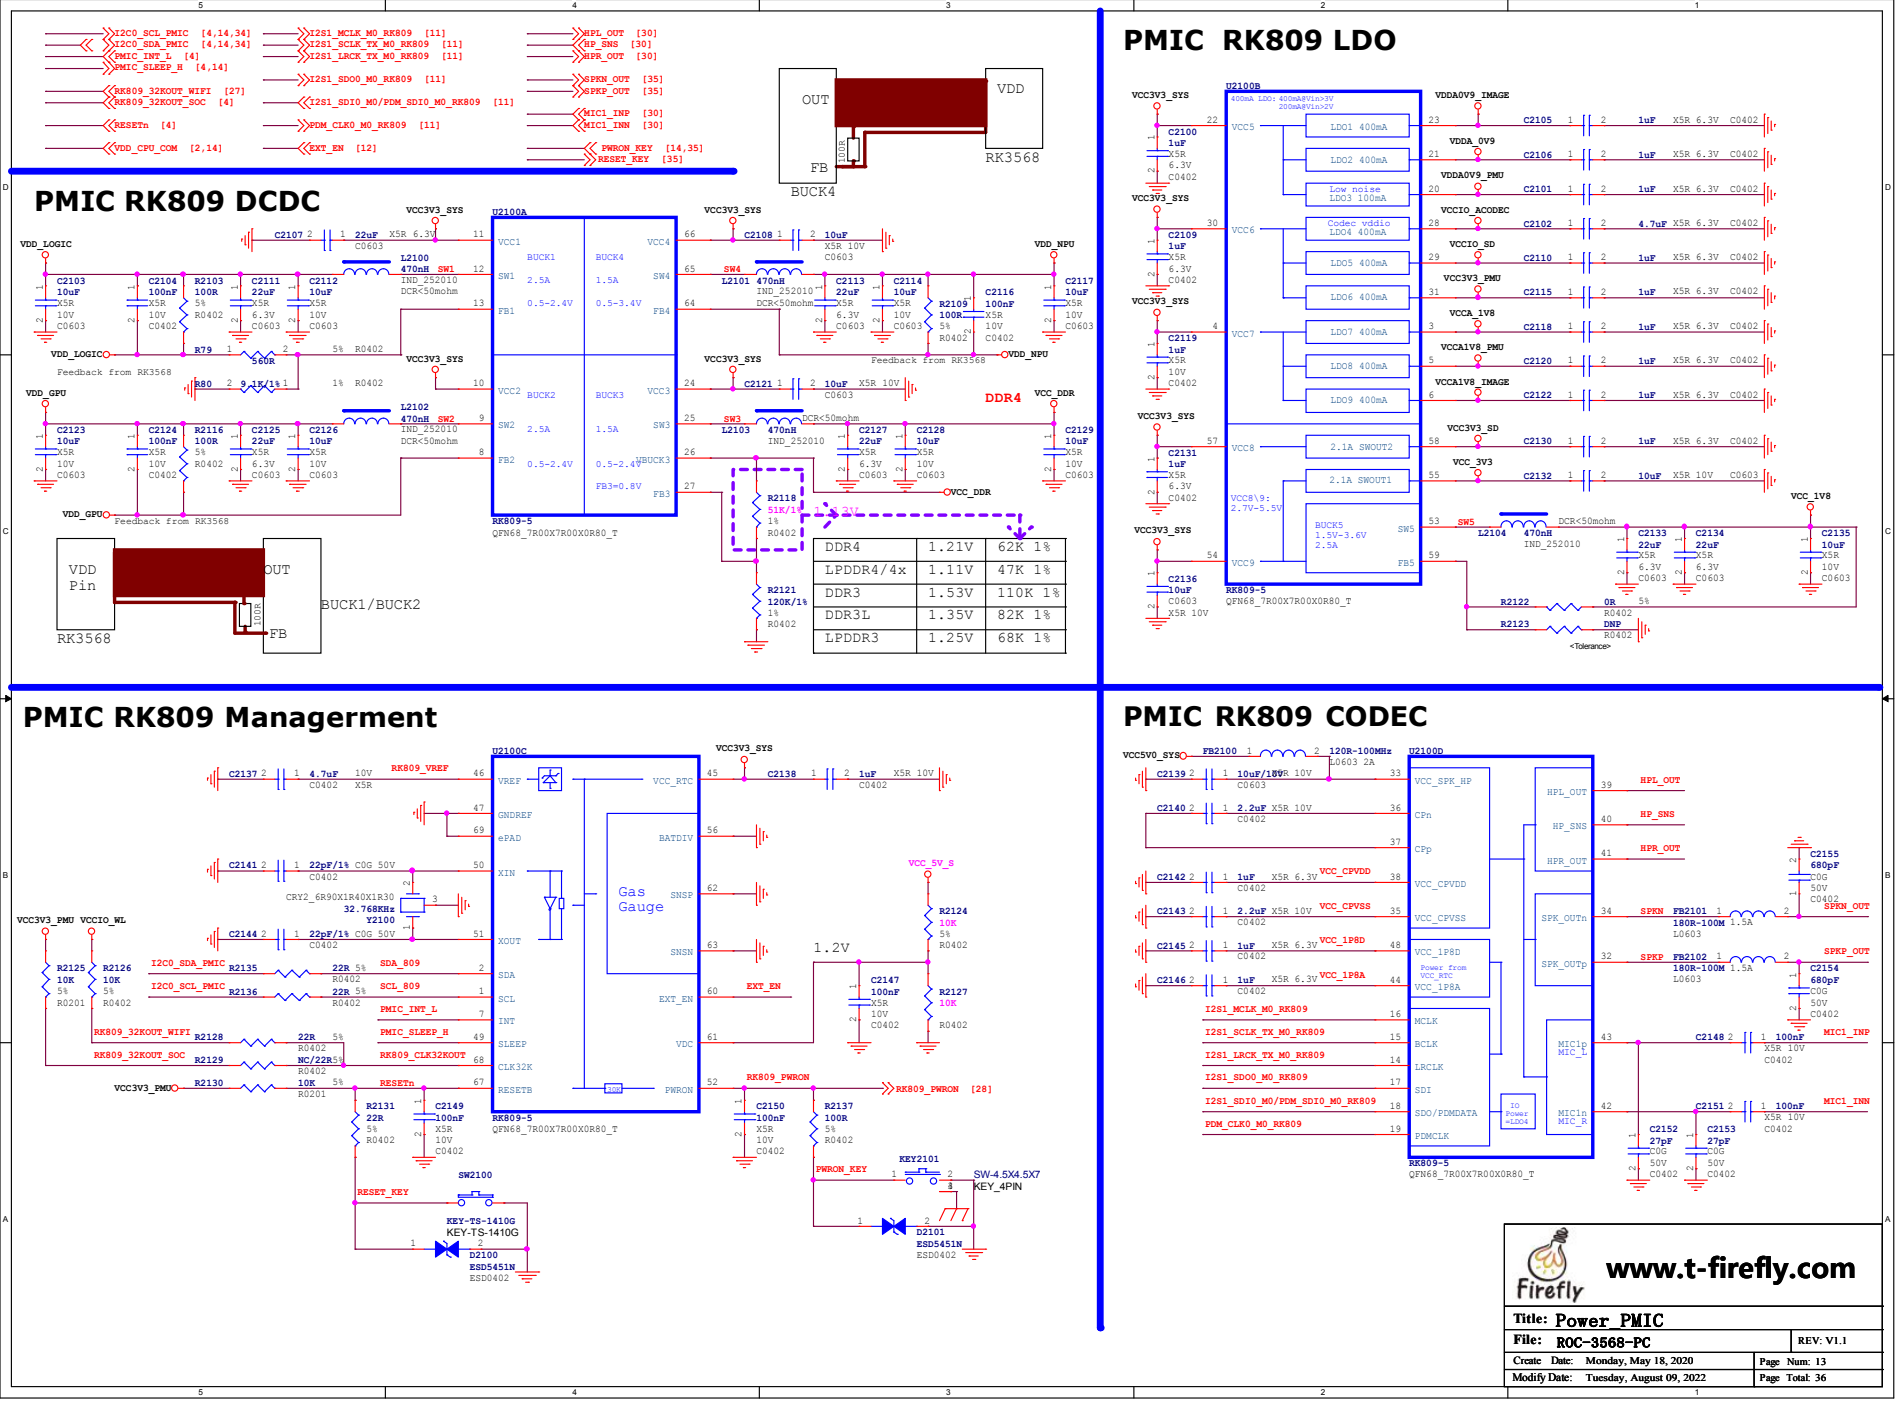
[picture p54: page 13]

DDR4 | 1.21V | 62K 1%
LPDDR4/4x | 1.11V | 47K 1%

DDR3 | 1.53V | 110K 1%

# RTC IC

# VDD_CPU

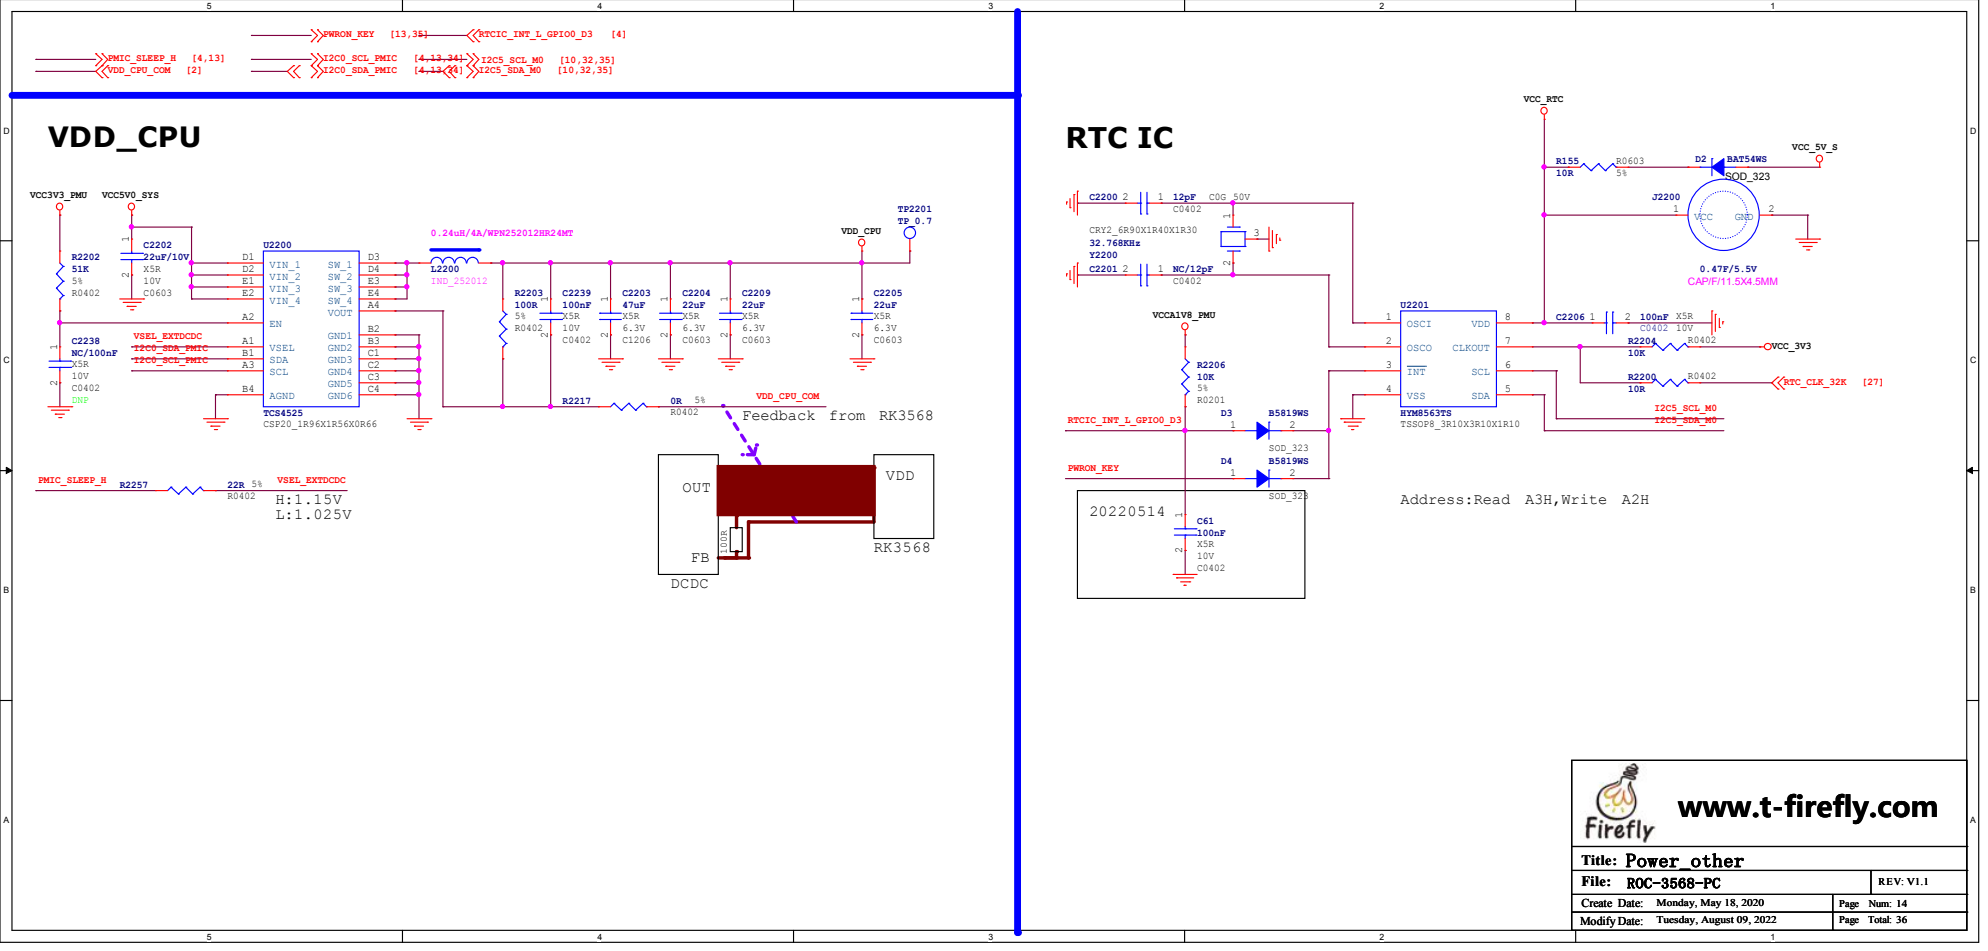
[picture p55: page 14]

D | D

# eMMC

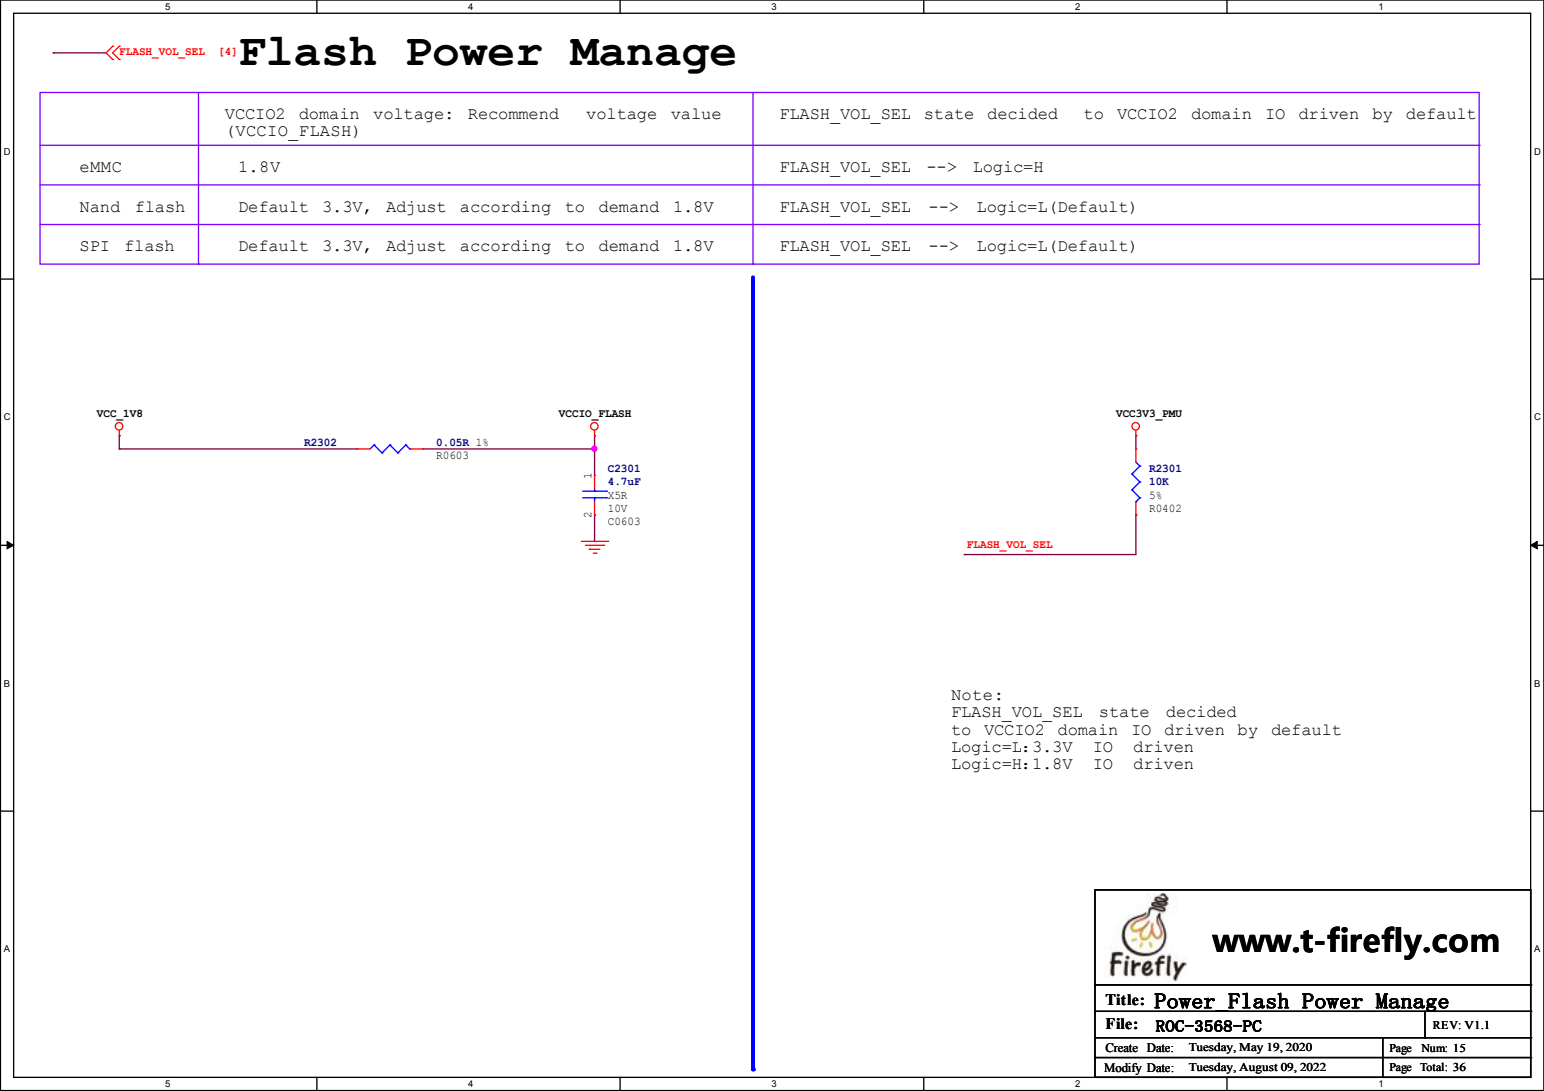
[picture p56: page 15]
Logic=L：3.3V; driven; Logic=H：1.8V; Nand flash; SPI flash; VCCIO2 domain voltage: Recommend; voltage value; (VCCIO_FLASH); FLASH_VOL_SEL state decided; to VCCIO2 domain IO driven by default; FLASH_VOL_SEL --> Logic=H; FLASH_VOL_SEL; Logic=L(Default); VCC_1V8; VCCIO_FLASH; VCC3V3_PMU; Power_Flash Power Manage; Tuesday, May 19, 2020

Flash Power Manage

Default 3.3V, Adjust according to demand 1.8V

Note:
FLASH_VOL_SEL state decided
to VCCIO2 domain IO driven by default

www.t-firefly.com

# USB3.0 HOST1

1.4A

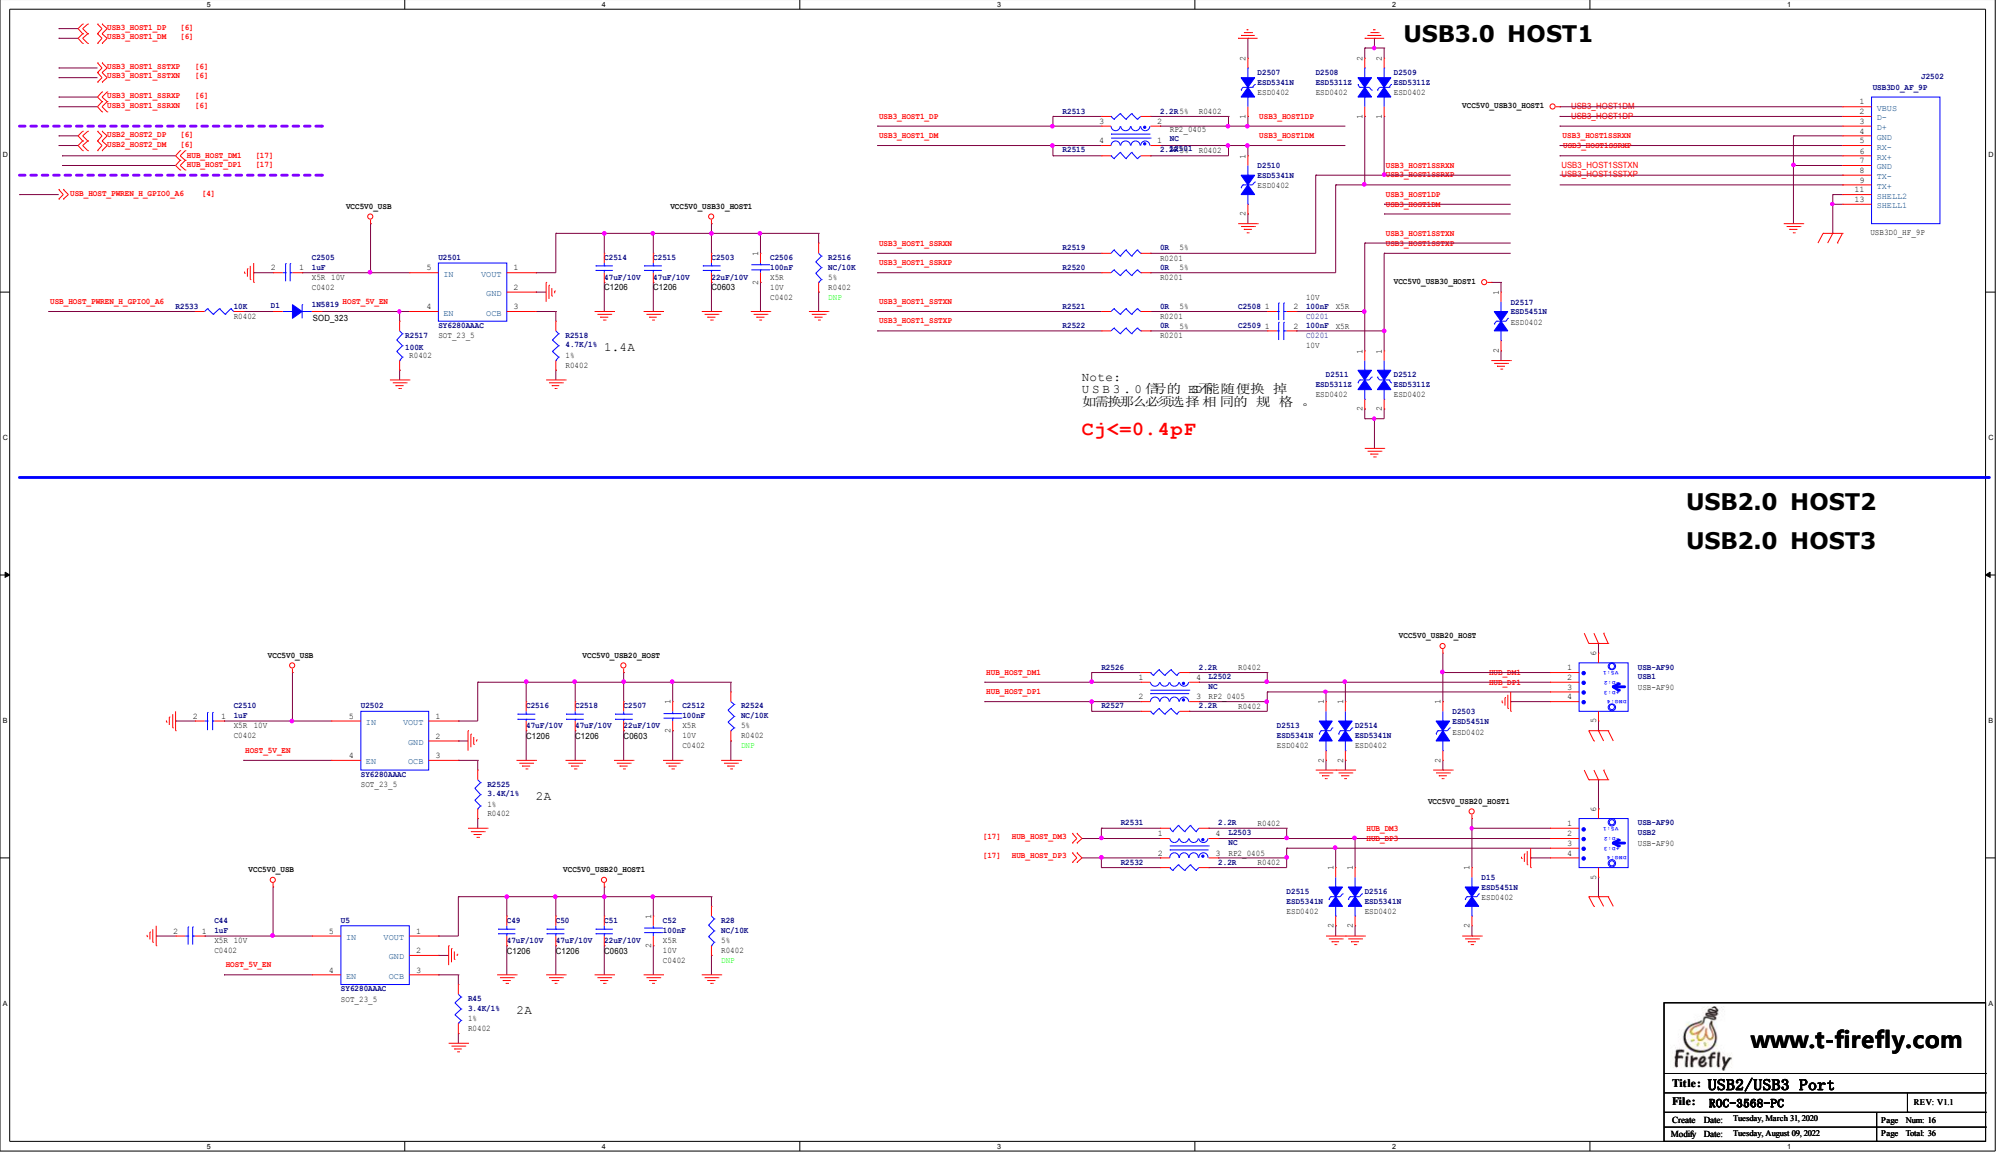
[picture p57: page 16]

D

# USB2.0 HUB

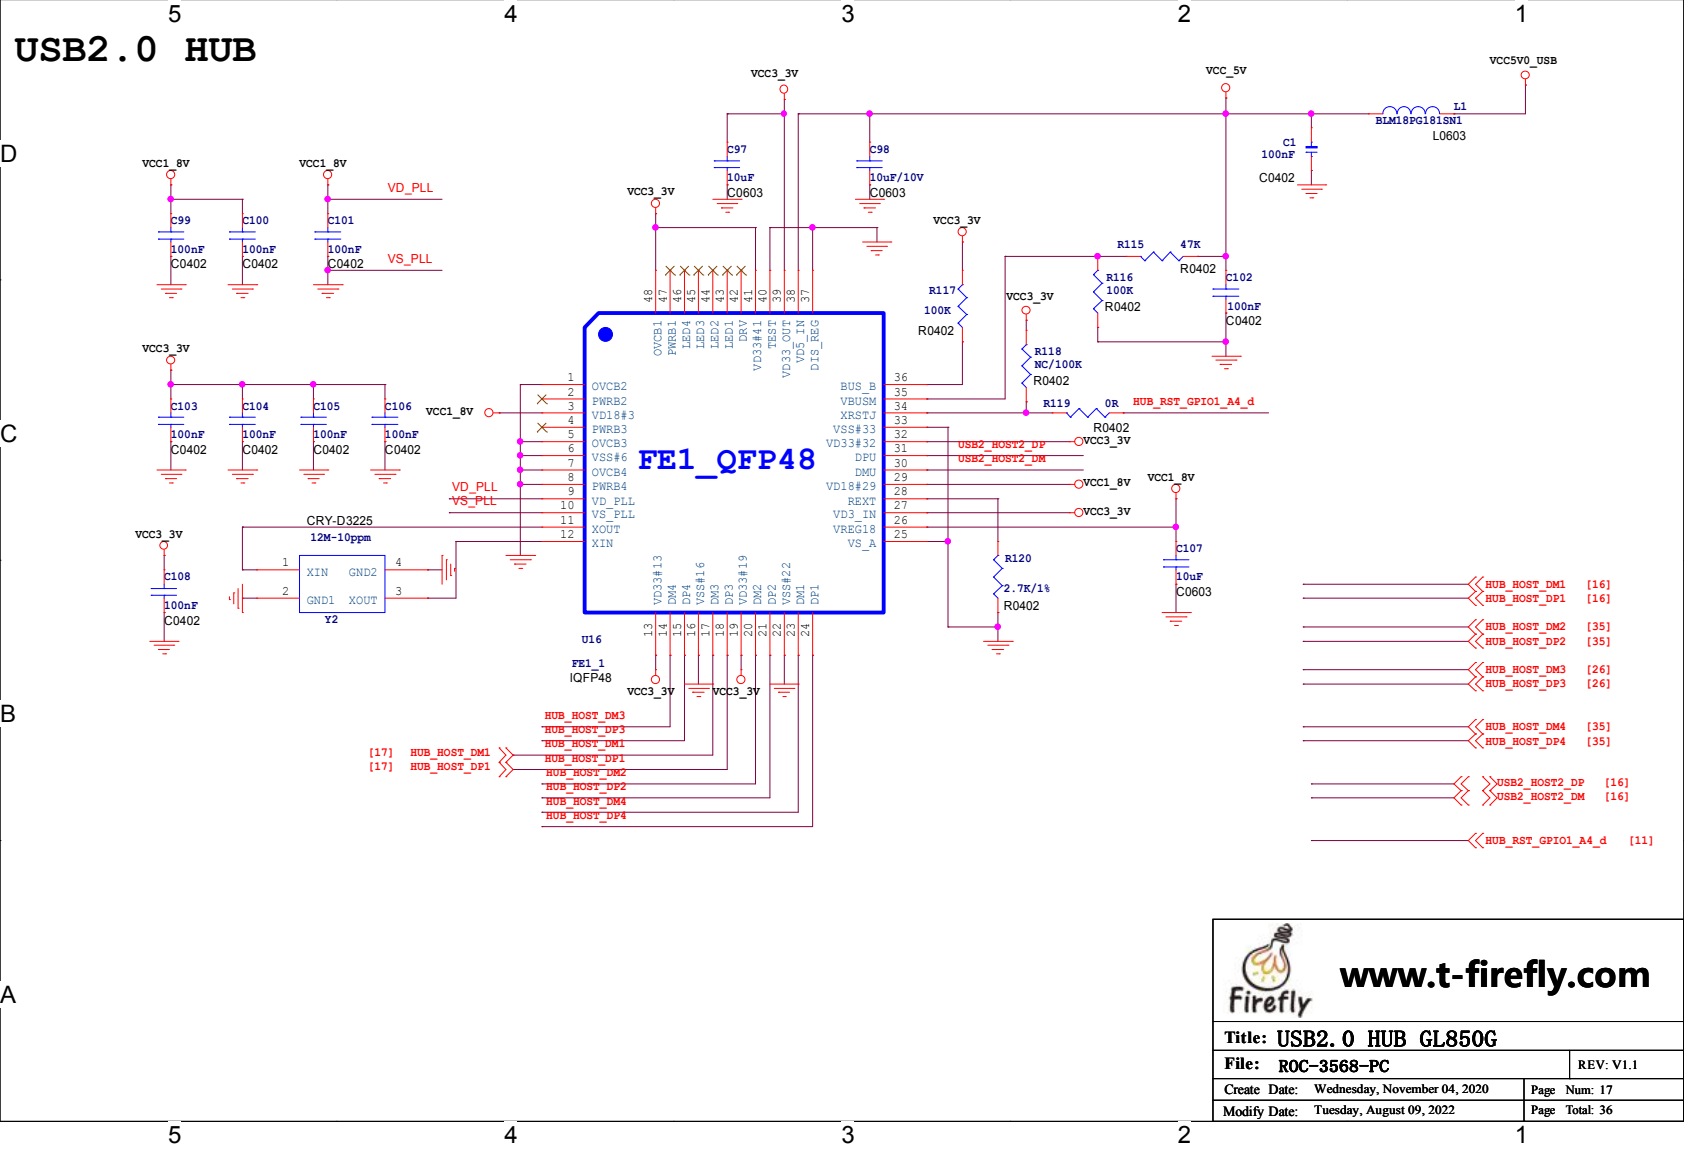
[picture p58: page 17]

D | D

# KEY

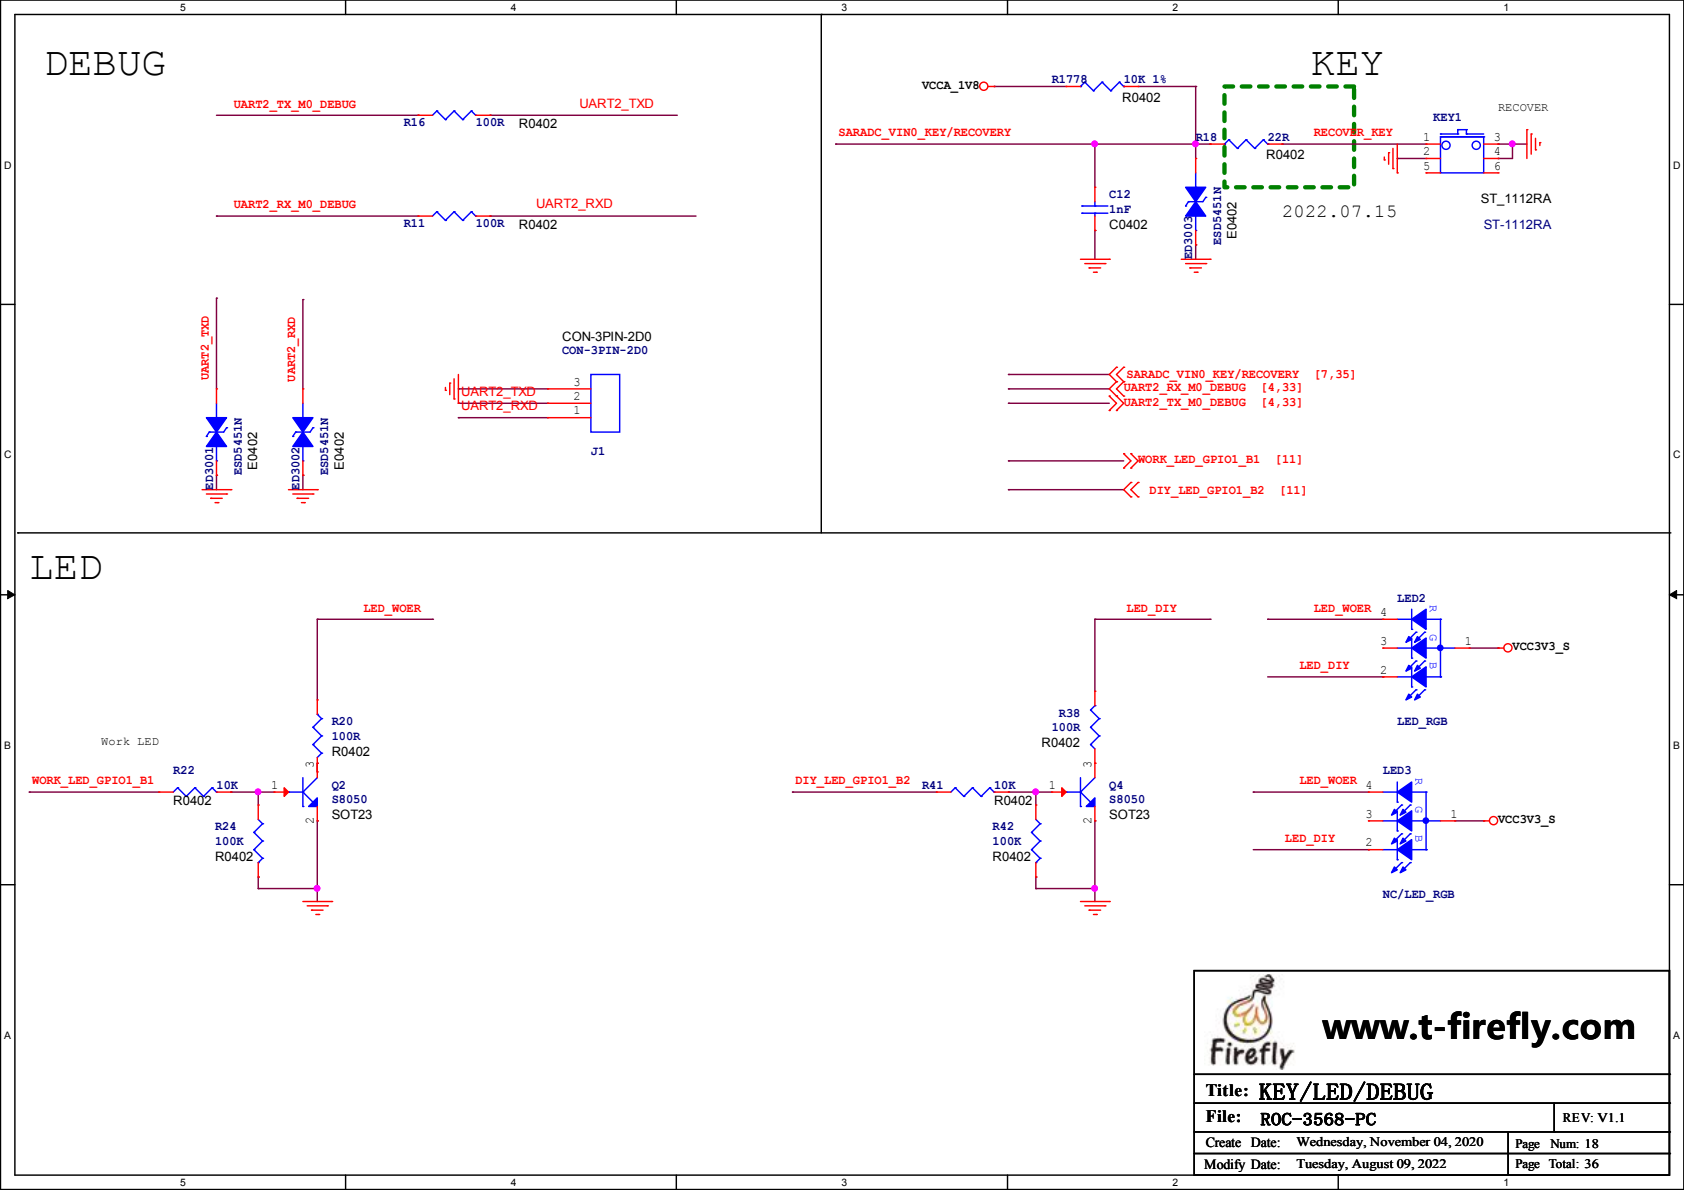
[picture p59: page 18]

# CH A CH B

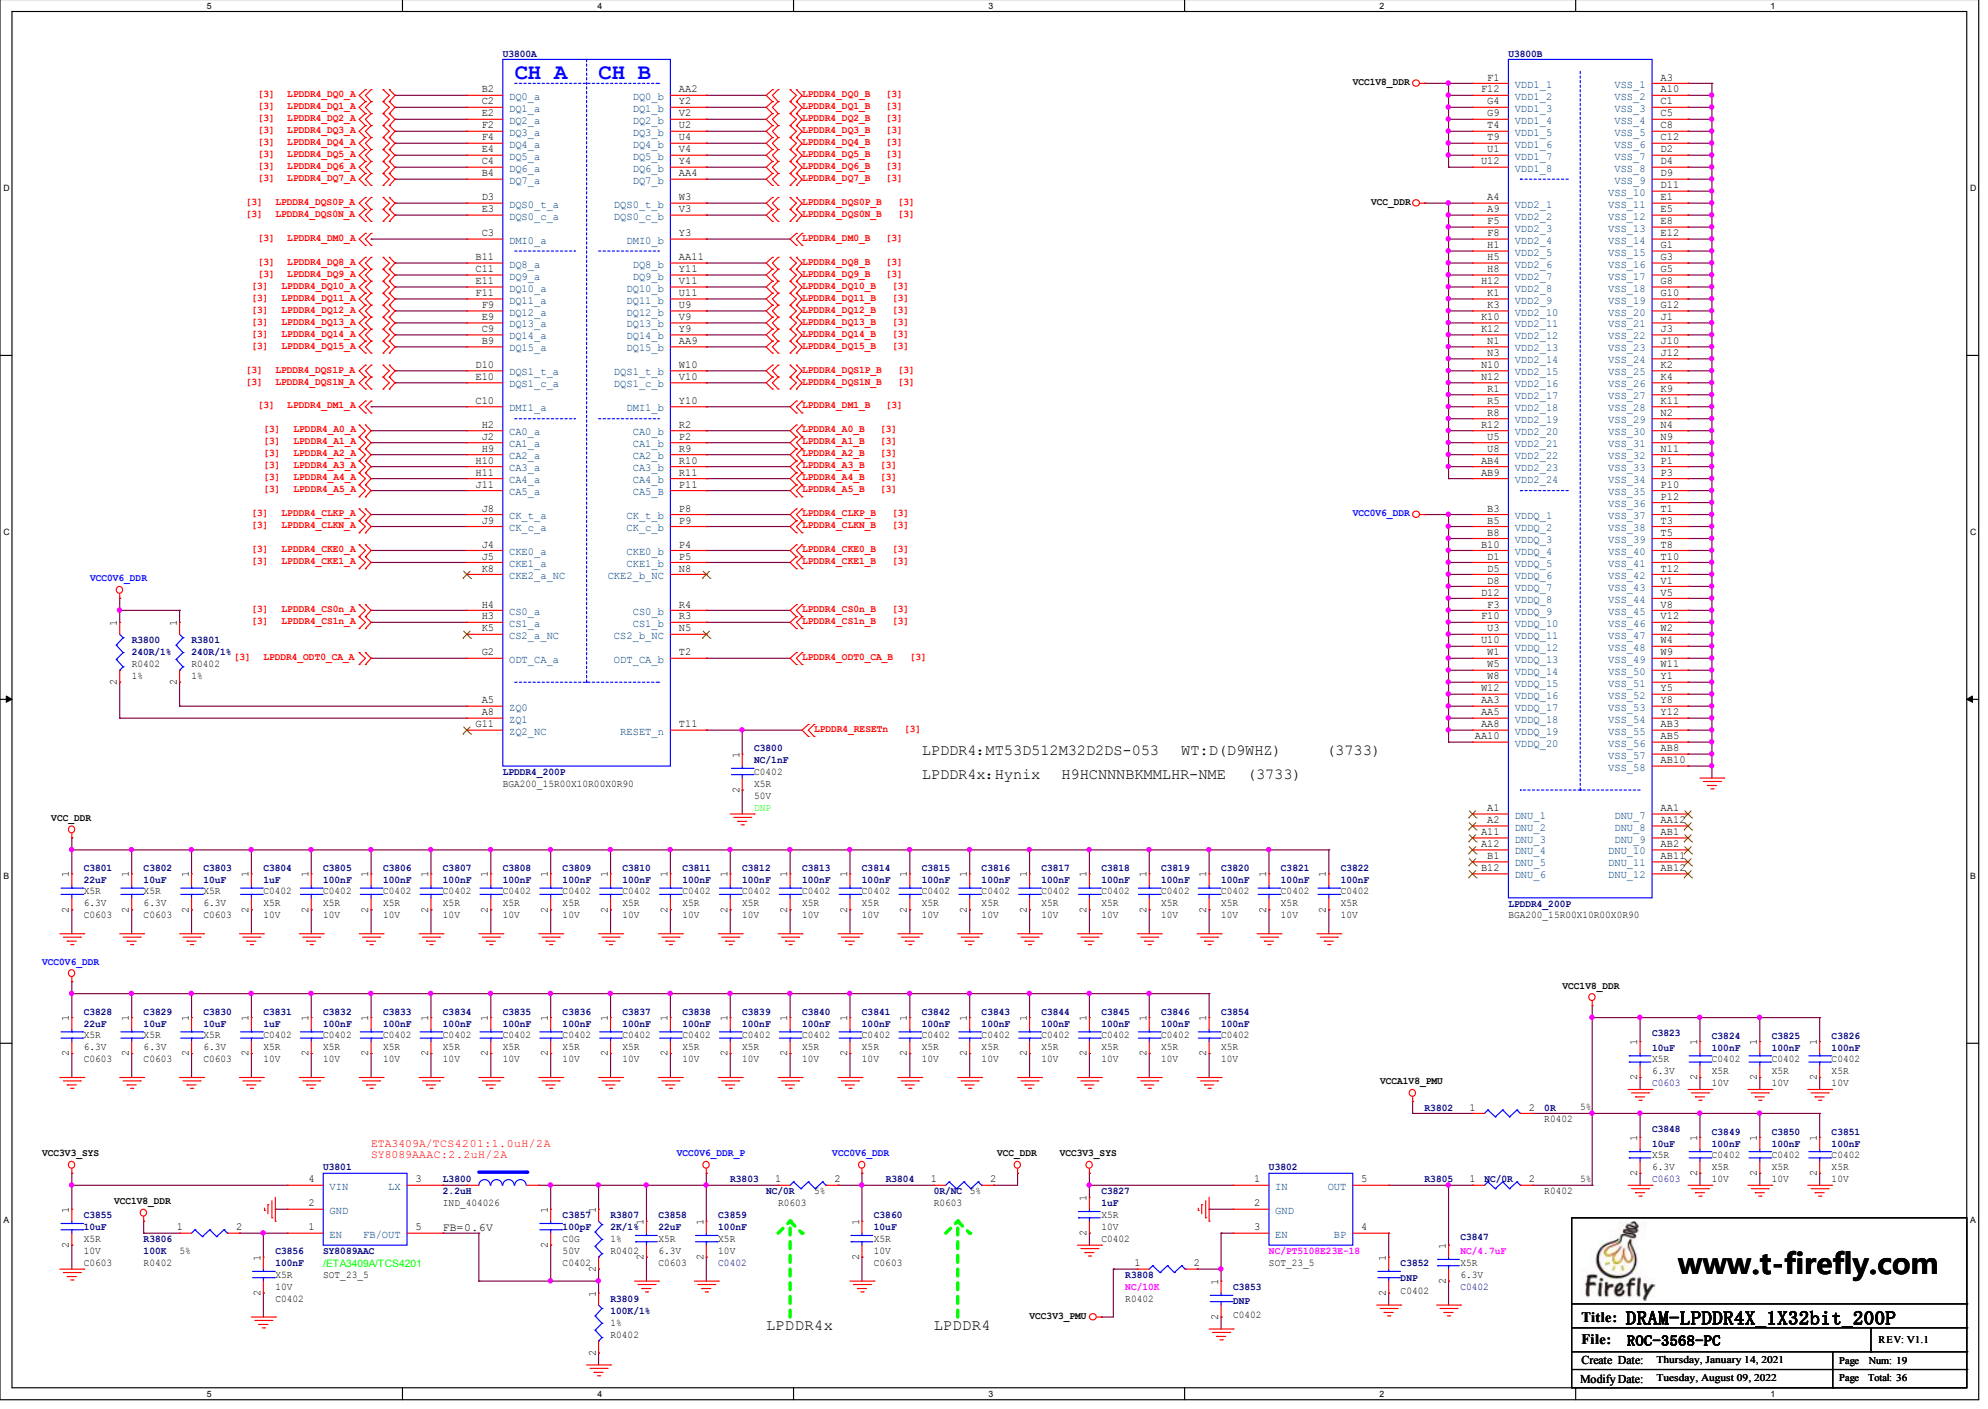
[picture p60: page 19]

D | D
eMMC_D0/FLASH_D0 | [5]

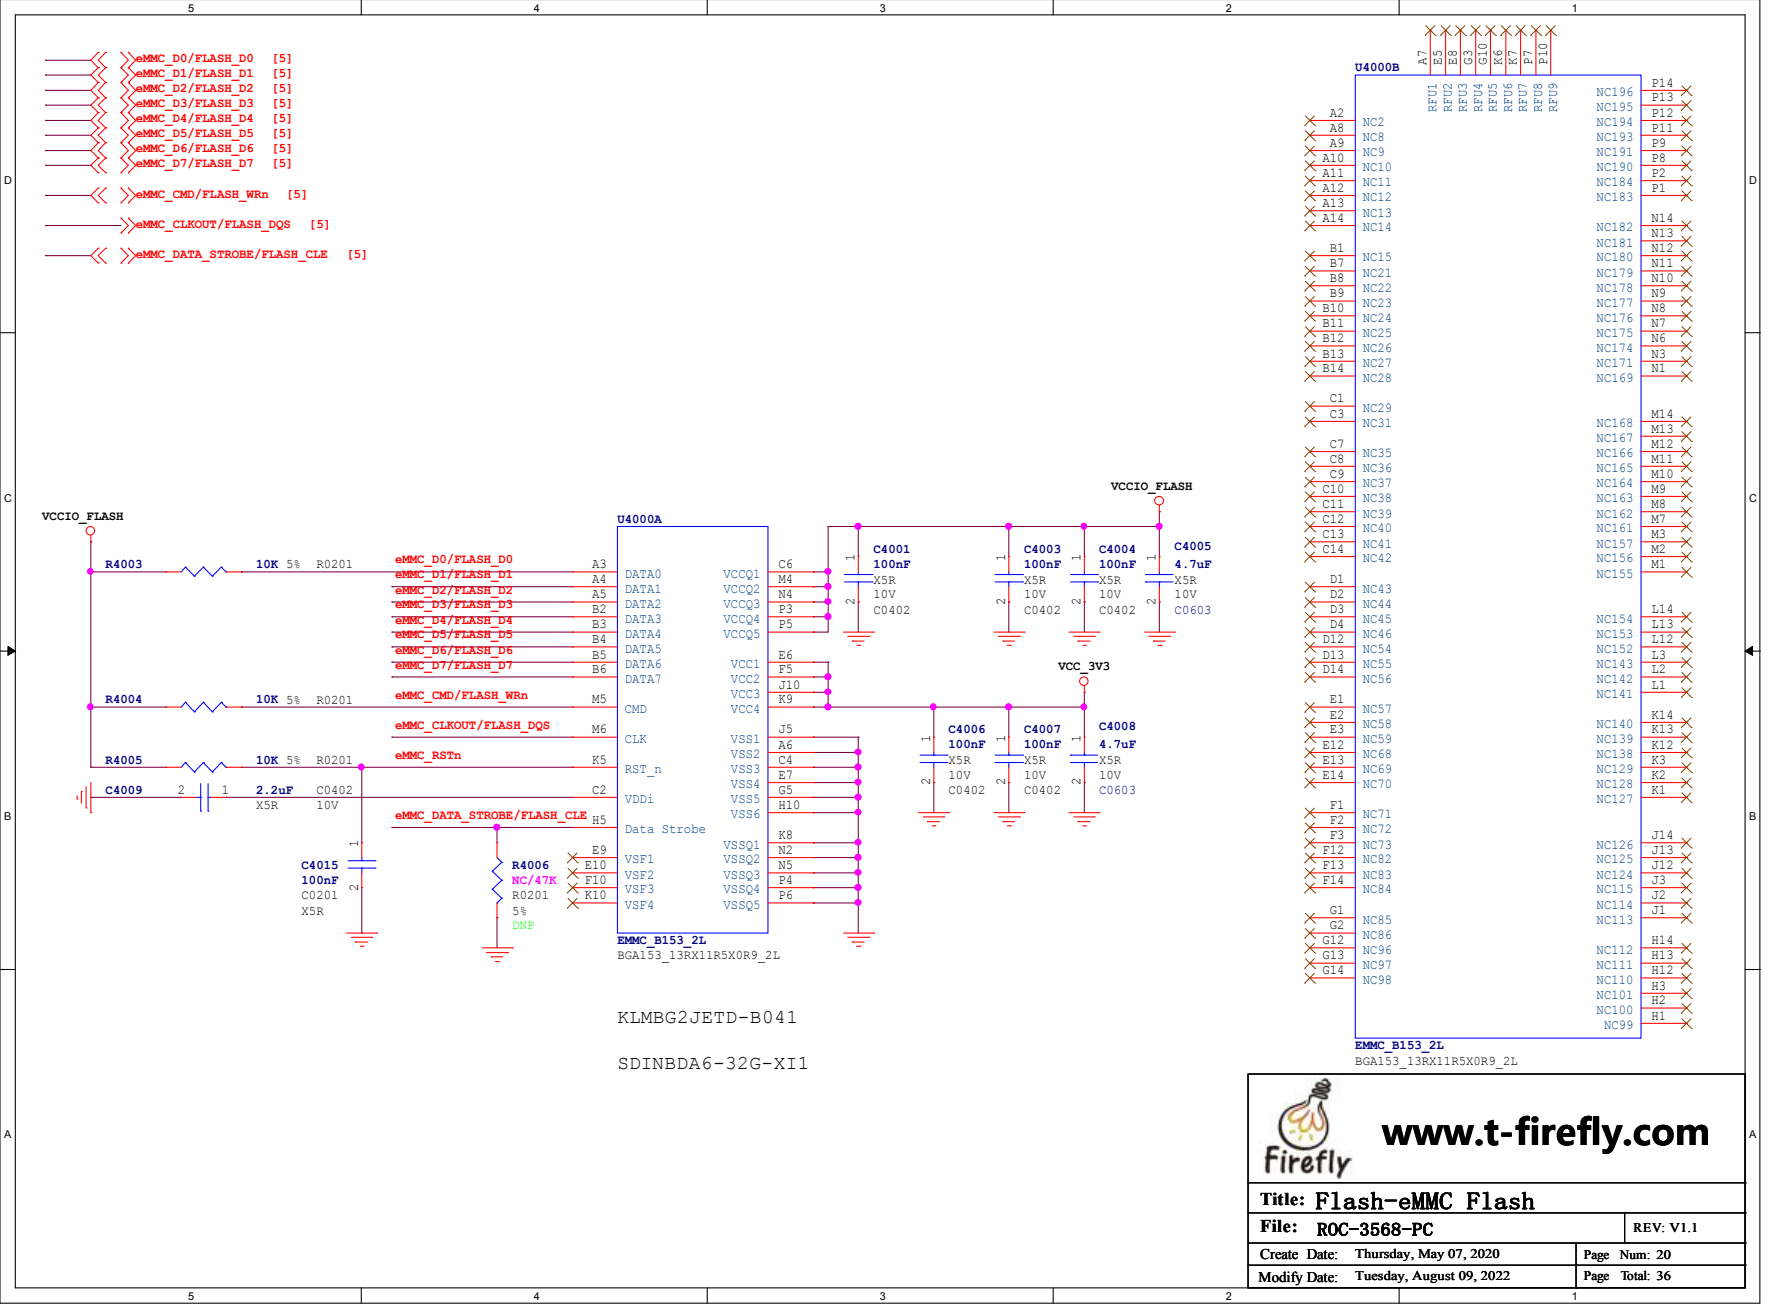
[picture p61: page 20]

D | D
SDMMC0_DET_L | [4]

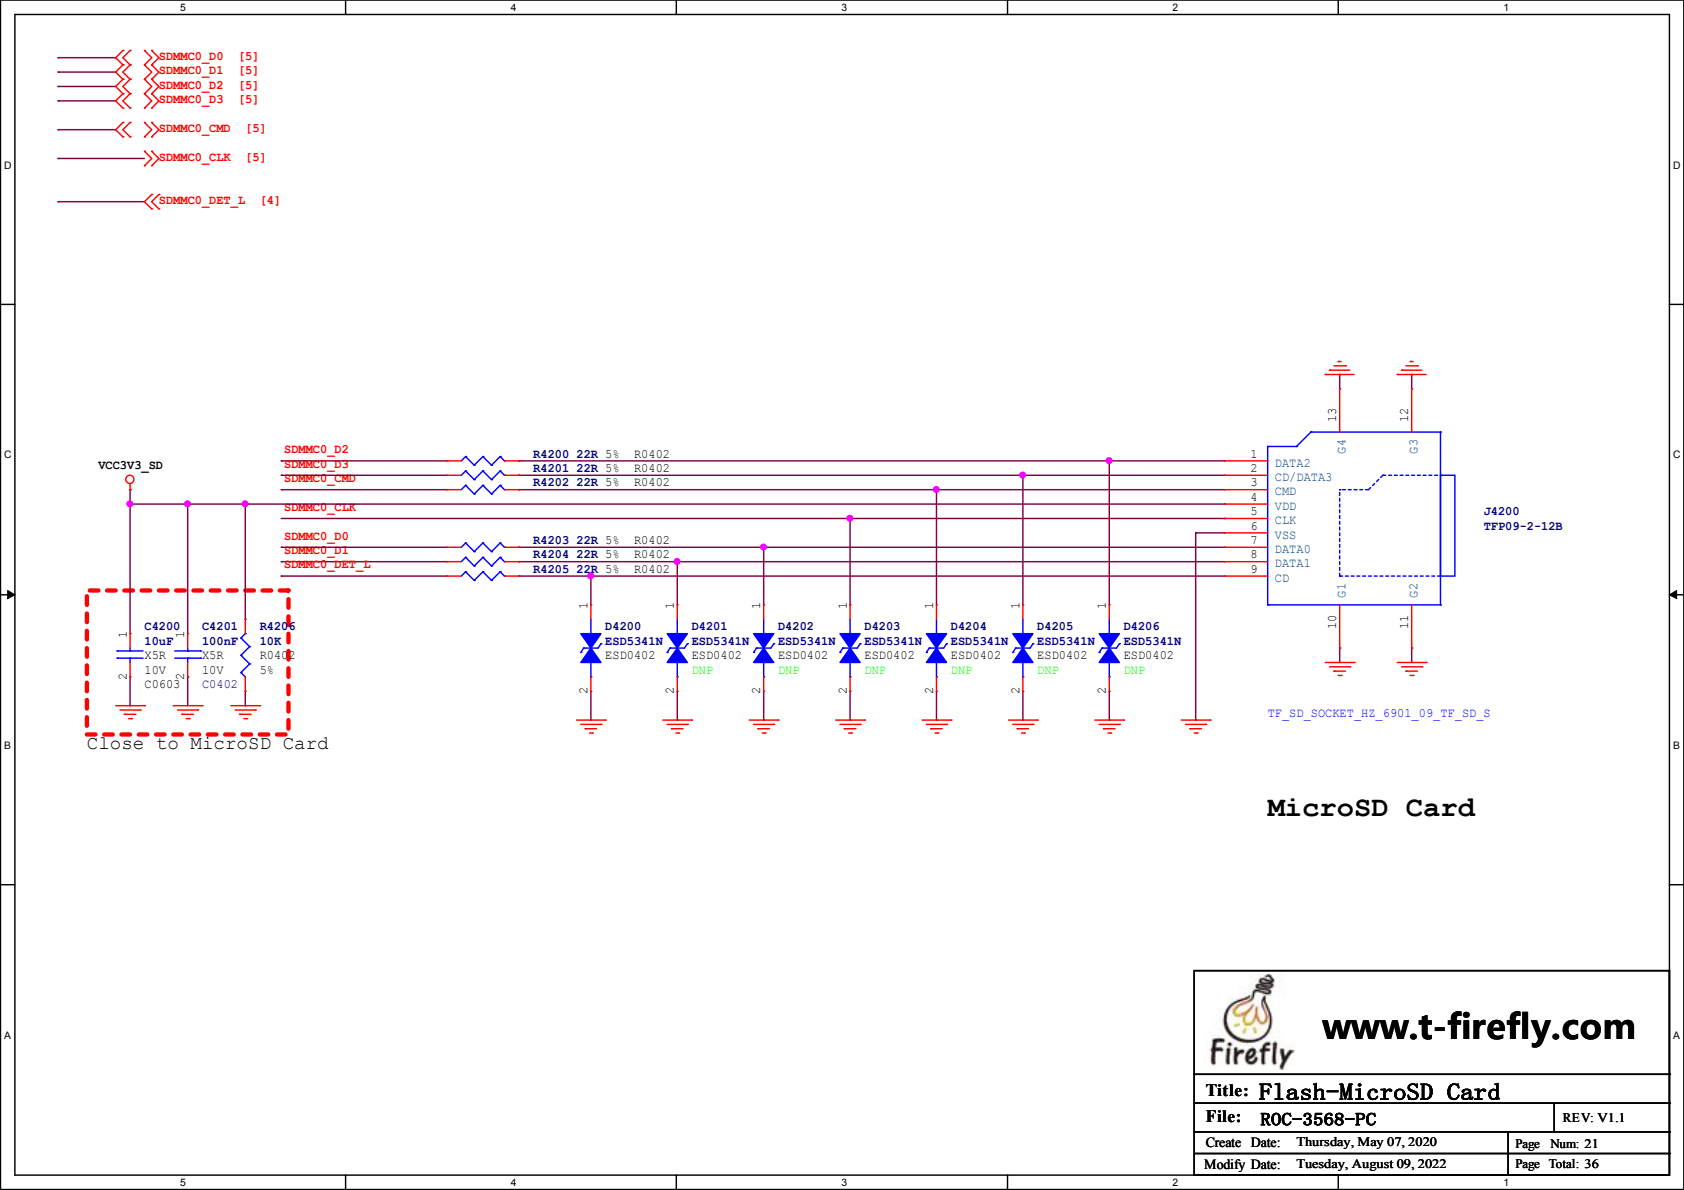
[picture p62: page 21]

Close to MicroSD Card

D | D
FSPI_D3/FLASH_CS1n | [5]

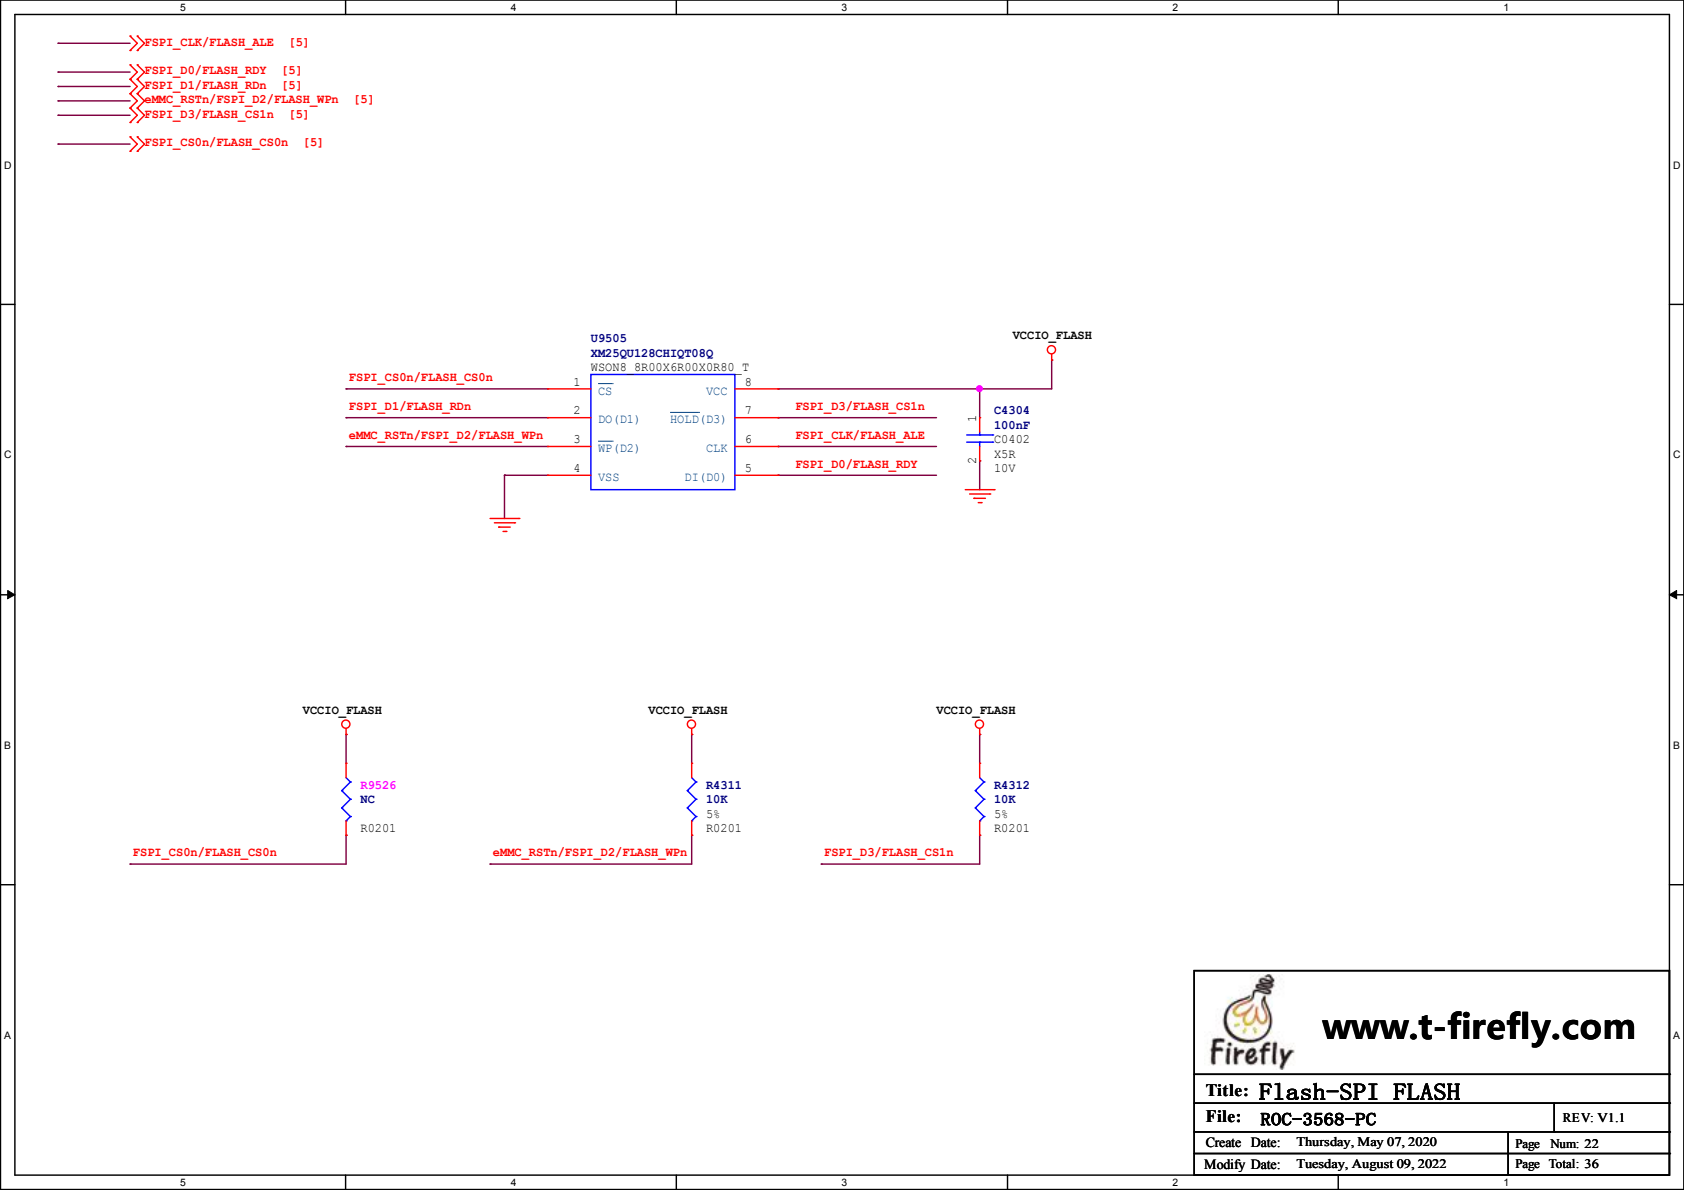
[picture p63: page 22]
FSPI_CS0n/FLASH_CS0n; FSPI_D1/FLASH_RDn; eMMC_RSTn/FSPI_D2/FLASH_WPn; FSPI_CLK/FLASH_ALE; FSPI_D0/FLASH_RDY; FSPI_D3/FLASH_CS1n; VCCIO_FLASH; Thursday, May 07, 2020; U9505 XM25QU128CHIQT08Q WSON8_8R00X6R00X0R80_T; VCC; VSS; CLK; HOLD(D3)

www.t-firefly.com

Flash-SPI FLASH

D | D

# MIPI-CSI_RX CON

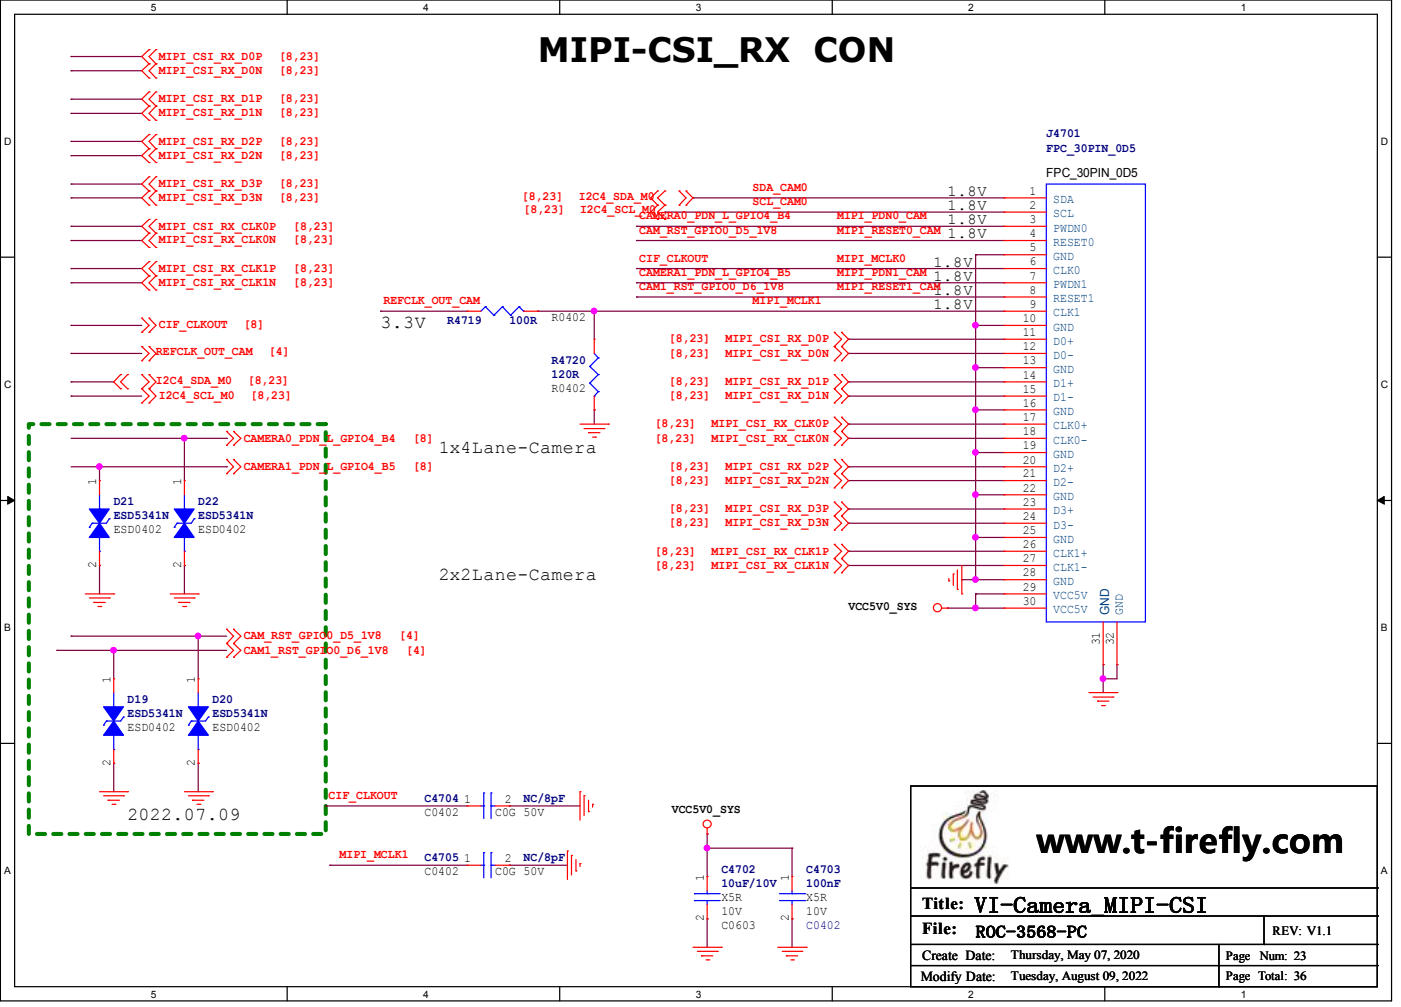
[picture p64: page 23]

D | D

# Cj<=0.4pF

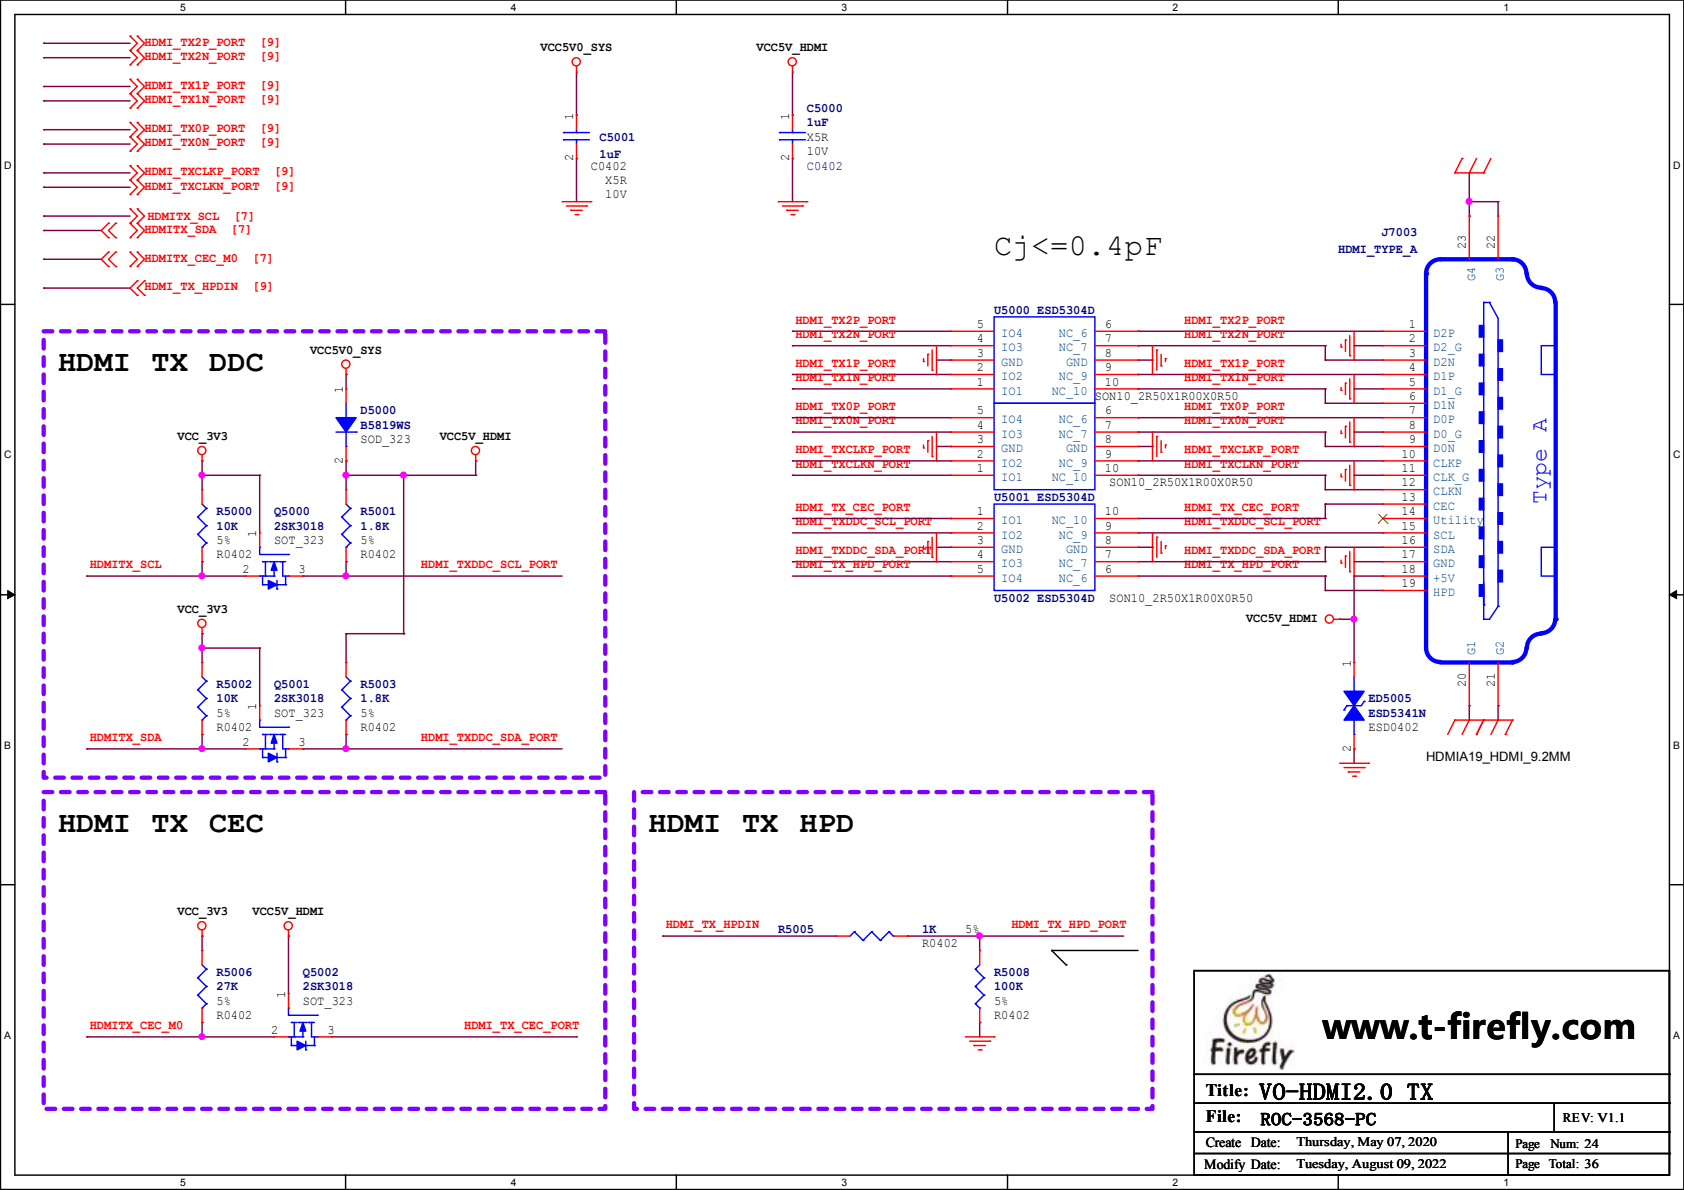
[picture p65: page 24]

D | D
20210519

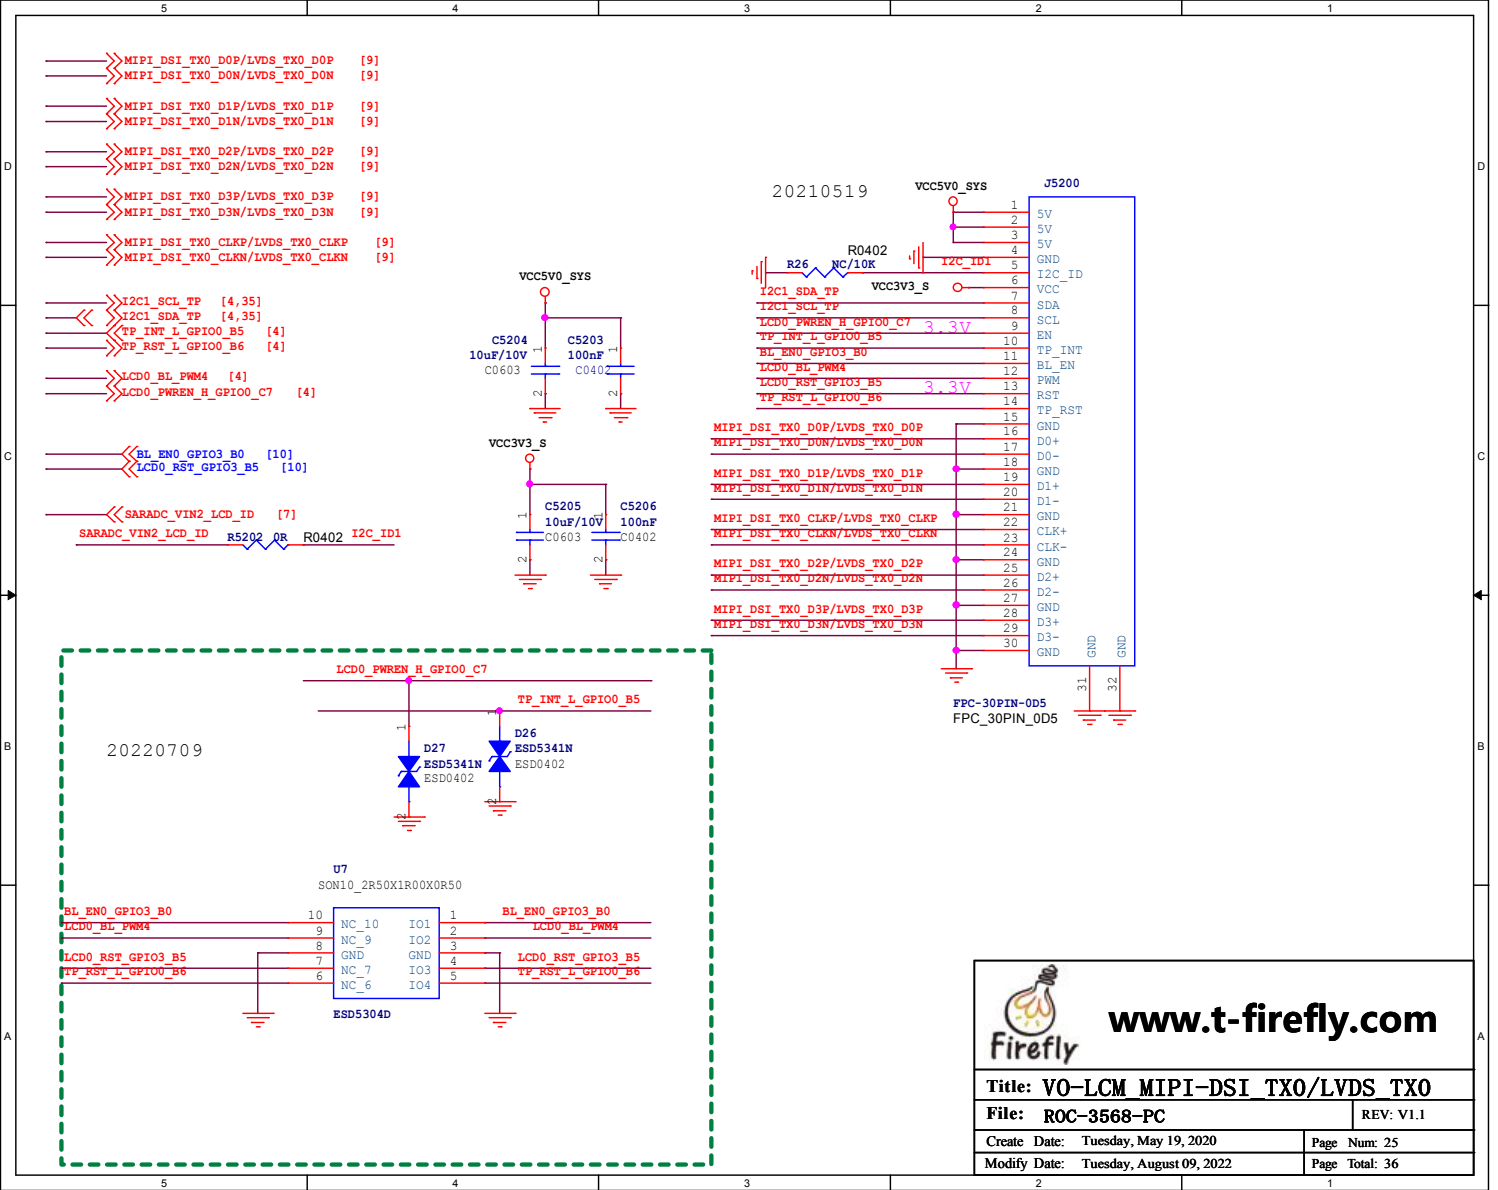
[picture p66: page 25]

# 4G/5G SIM CARD

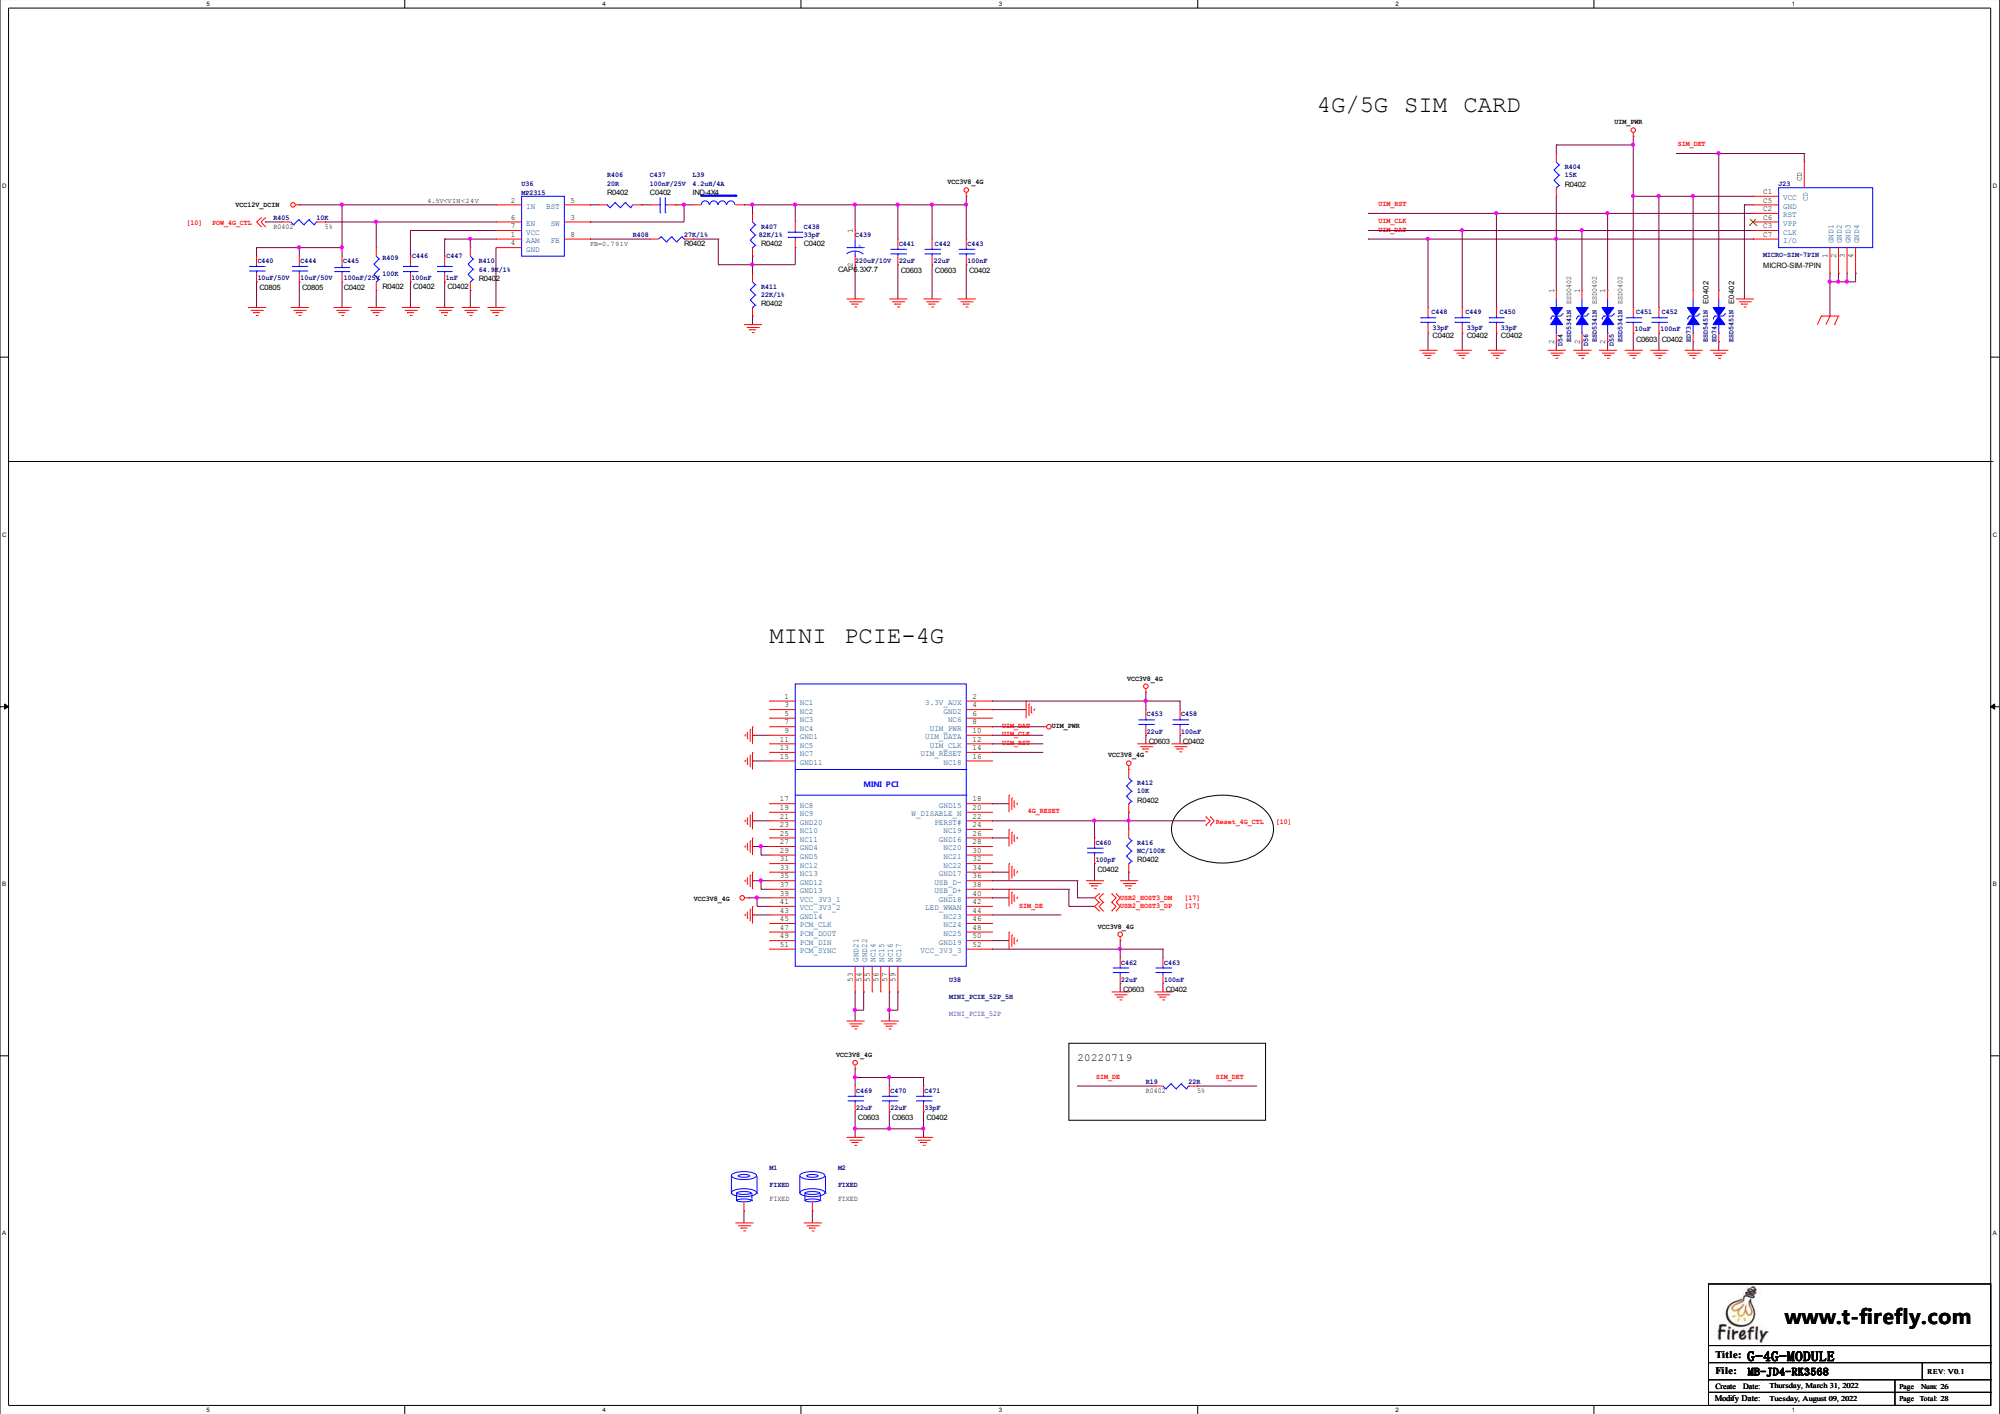
[picture p67: page 26]

# Note: Adjusted the load capacitance

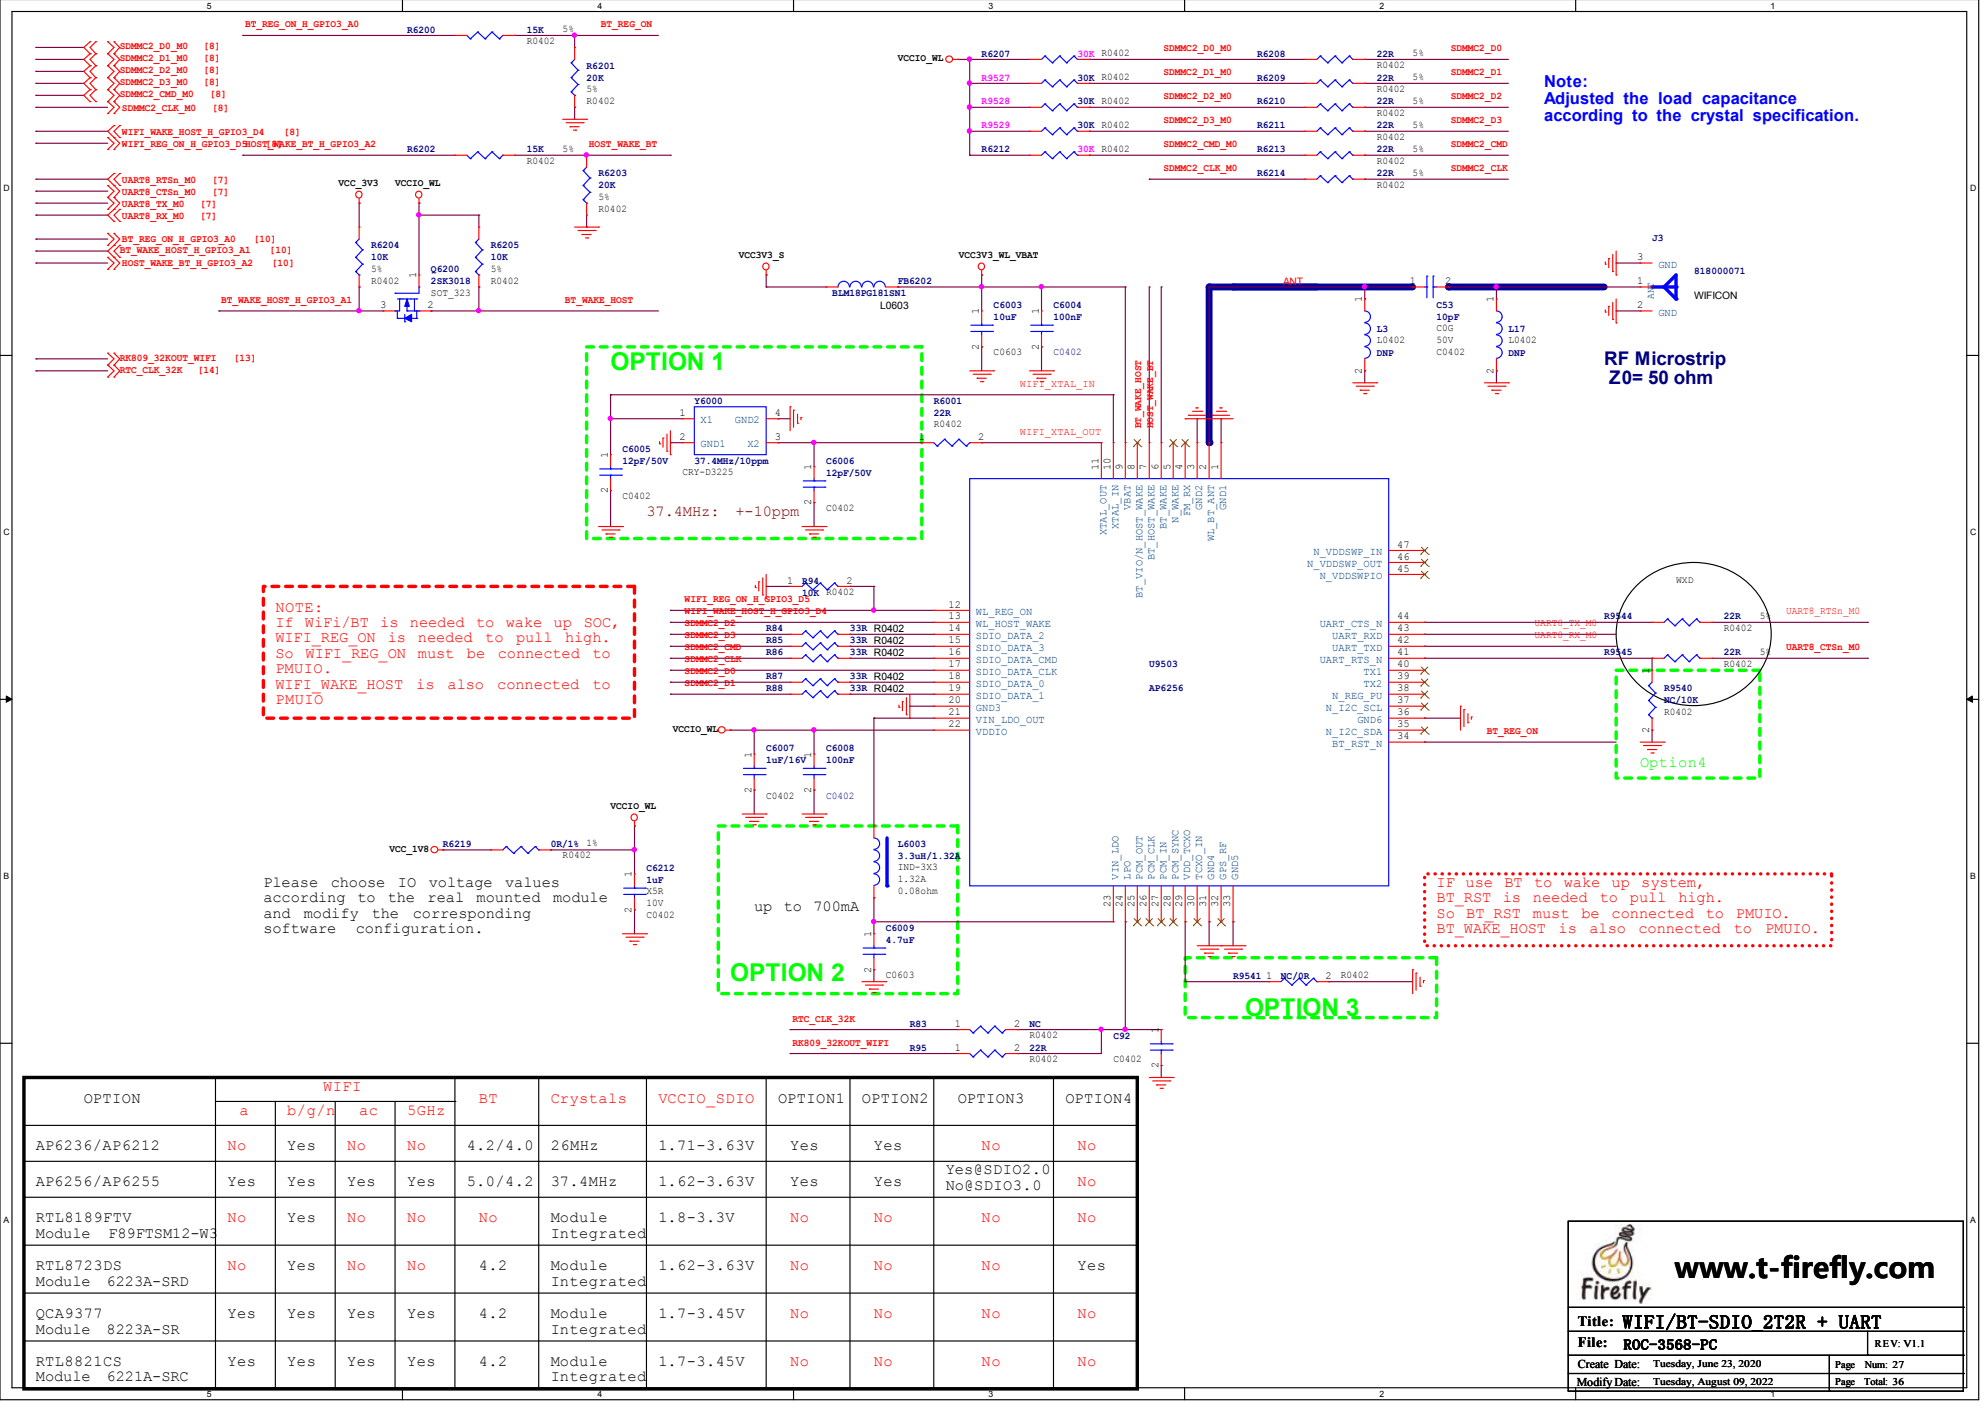
[picture p68: page 27]

according to the crystal specification.

NOTE:
If WiFi/BT is needed to wake up SOC,
WIFI_REG_ON is needed to pull high.
So WIFI_REG_ON must be connected to
PMUIO.
WIFI_WAKE_HOST is also connected to
PMUIO

Please choose IO voltage values
according to the real mounted module
and modify the corresponding

IF use BT to wake up system,
BT_RST is needed to pull high.
So BT_RST must be connected to PMUIO.
BT_WAKE_HOST is also connected to PMUIO.

### EDP_AUXP EDP_AUXN

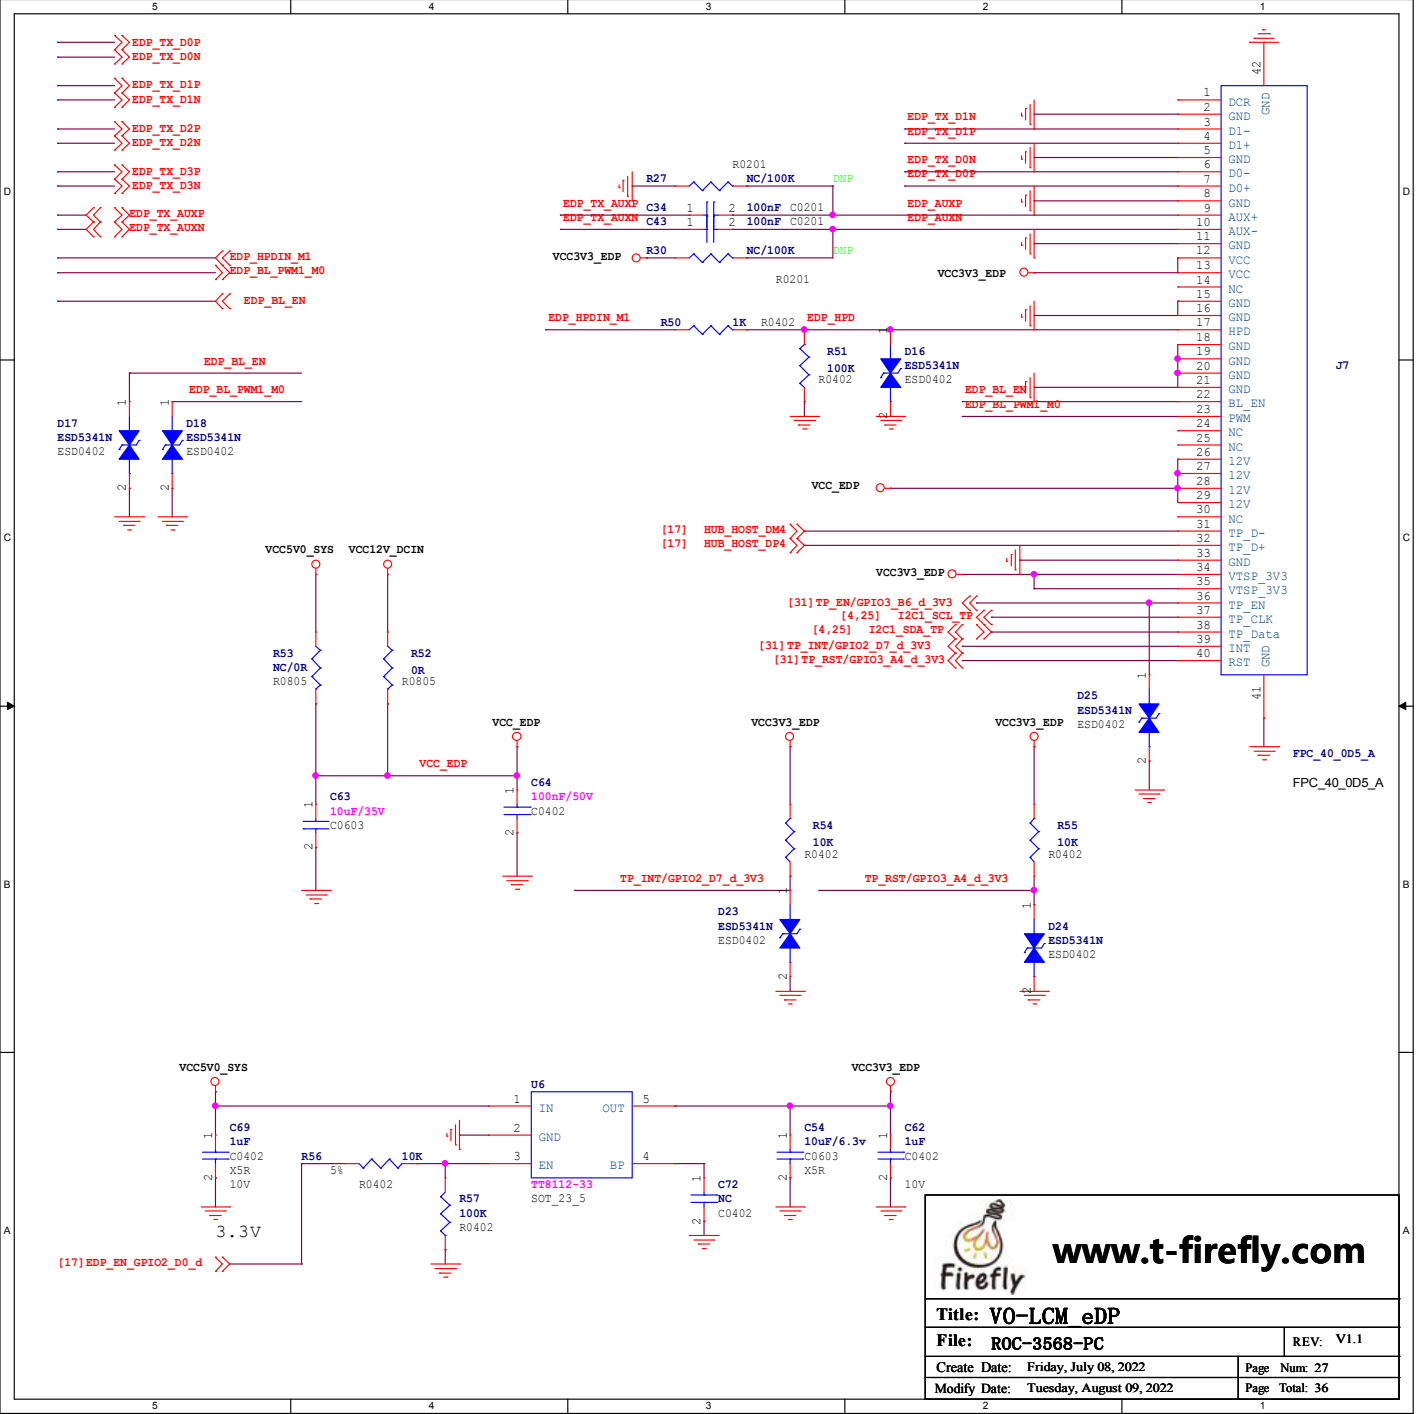
[picture p69: page 28]

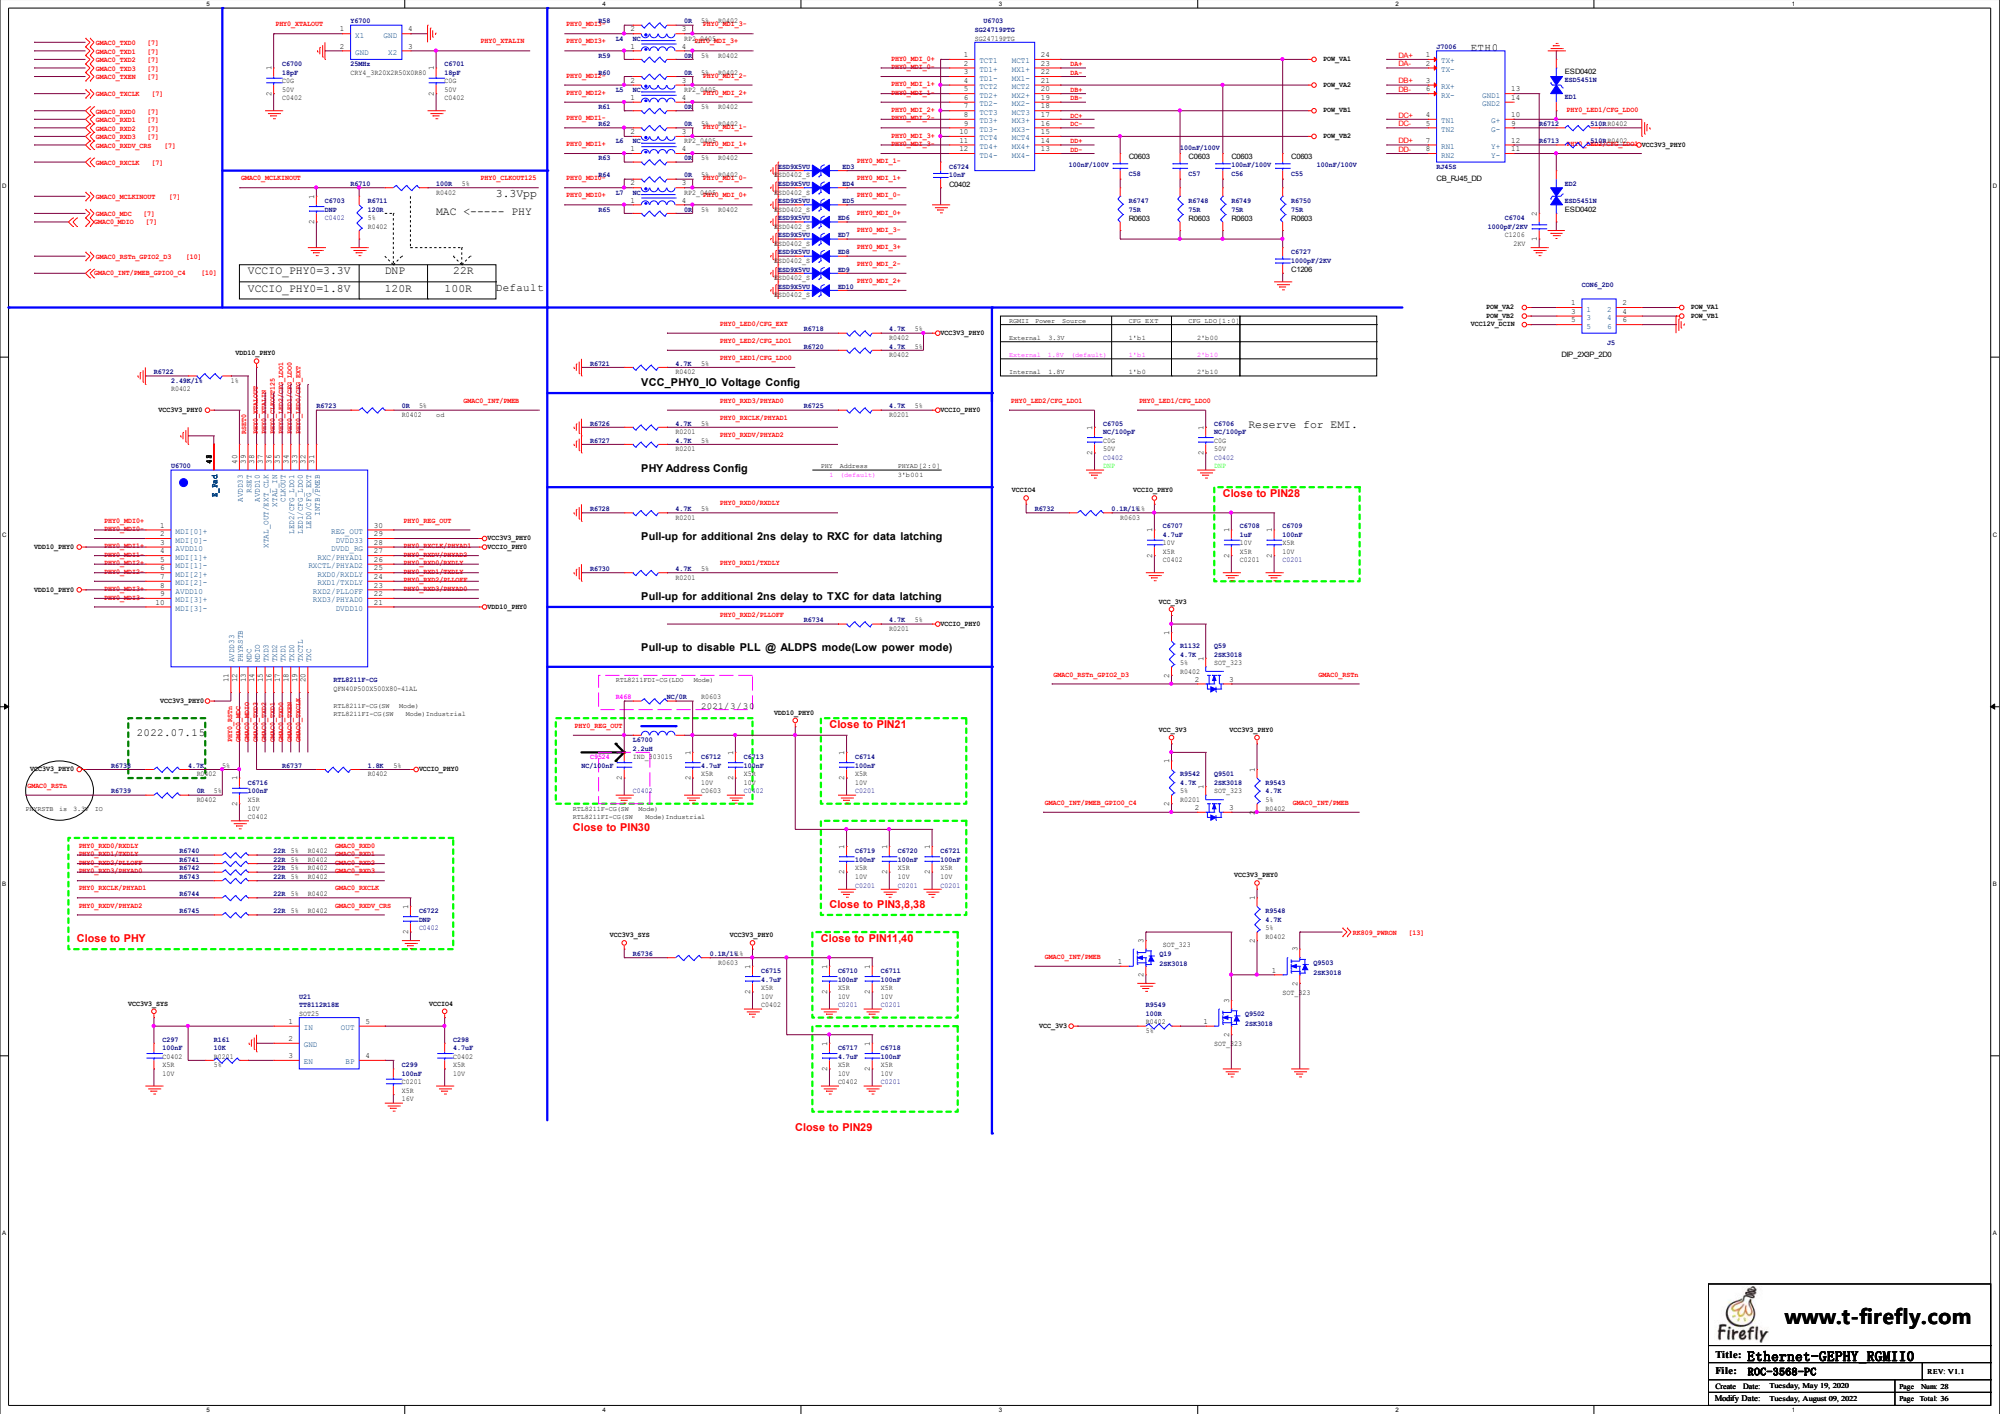
[picture p70: page 29]

Pull-up for additional 2ns delay to RXC for data latching

Pull-up for additional 2ns delay to TXC for data latching

Pull-up to disable PLL @ ALDPS mode(Low power mode)

## MAC <----- PHY

## 3.3Vpp

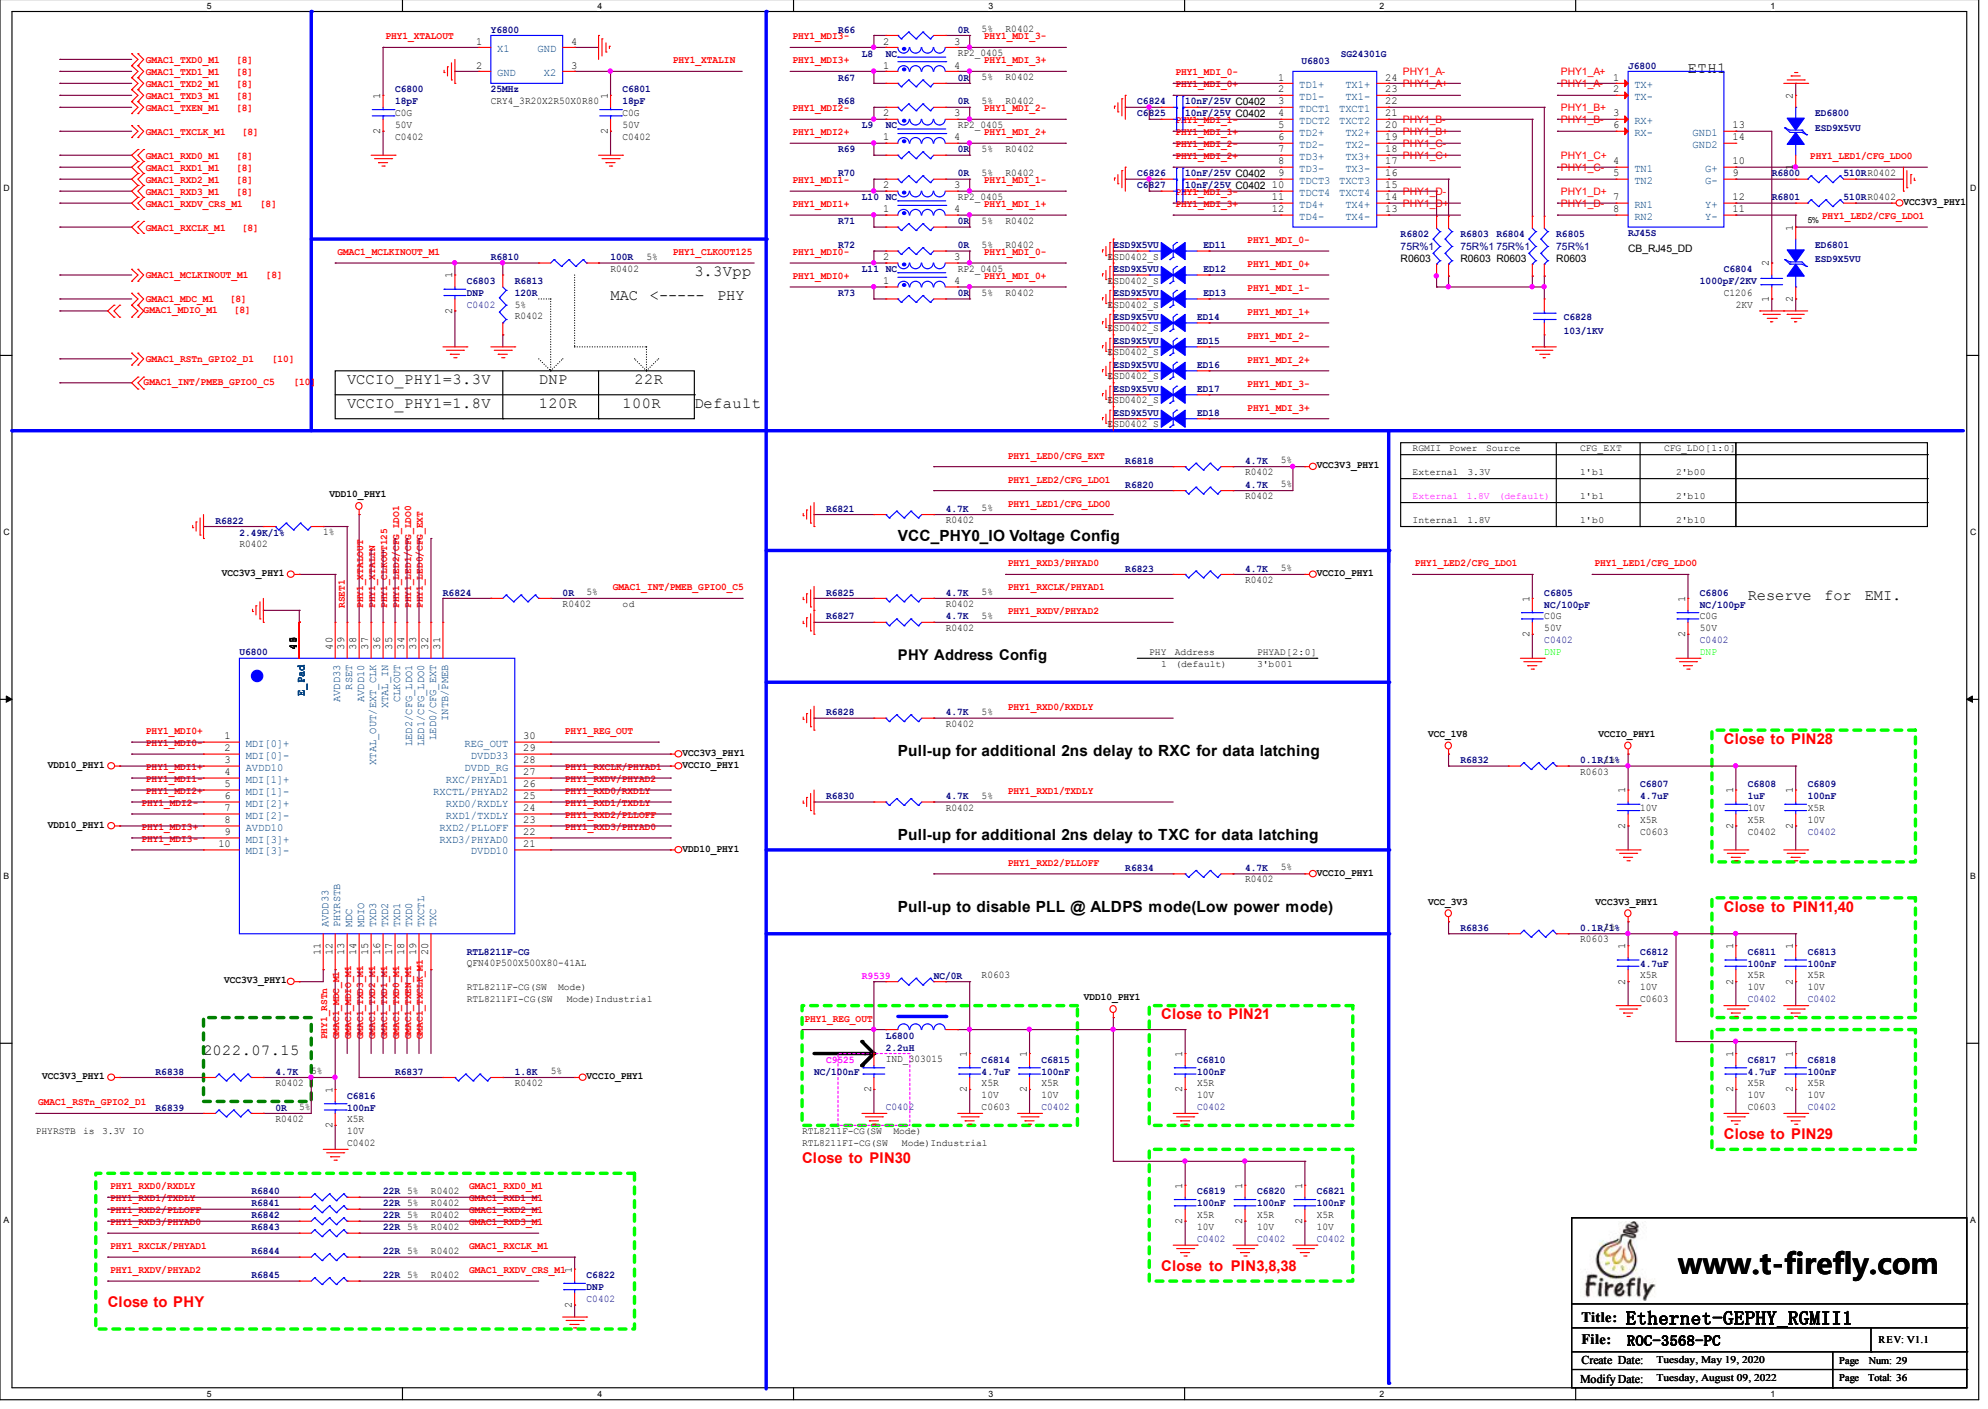
[picture p71: page 30]

PHY1_LED0/CFG_EXT R6818 4.7K 5% R0402 VCC_PHY0_IO Voltage Config | PHY1_LED1/CFG_LDO0 VCCIO_PHY1 | C0G Close to PIN28

PHY1_RXD3/PHYAD0 R6823 4.7K 5% VCCIO_PHY1 R0402 PHY Address Config PHY Address PHYAD[2:0] 1 (default) 3'b001

Pull-up for additional 2ns delay to RXC for data latching

Pull-up for additional 2ns delay to TXC for data latching

Pull-up to disable PLL @ ALDPS mode(Low power mode)

D | D

# Headphone

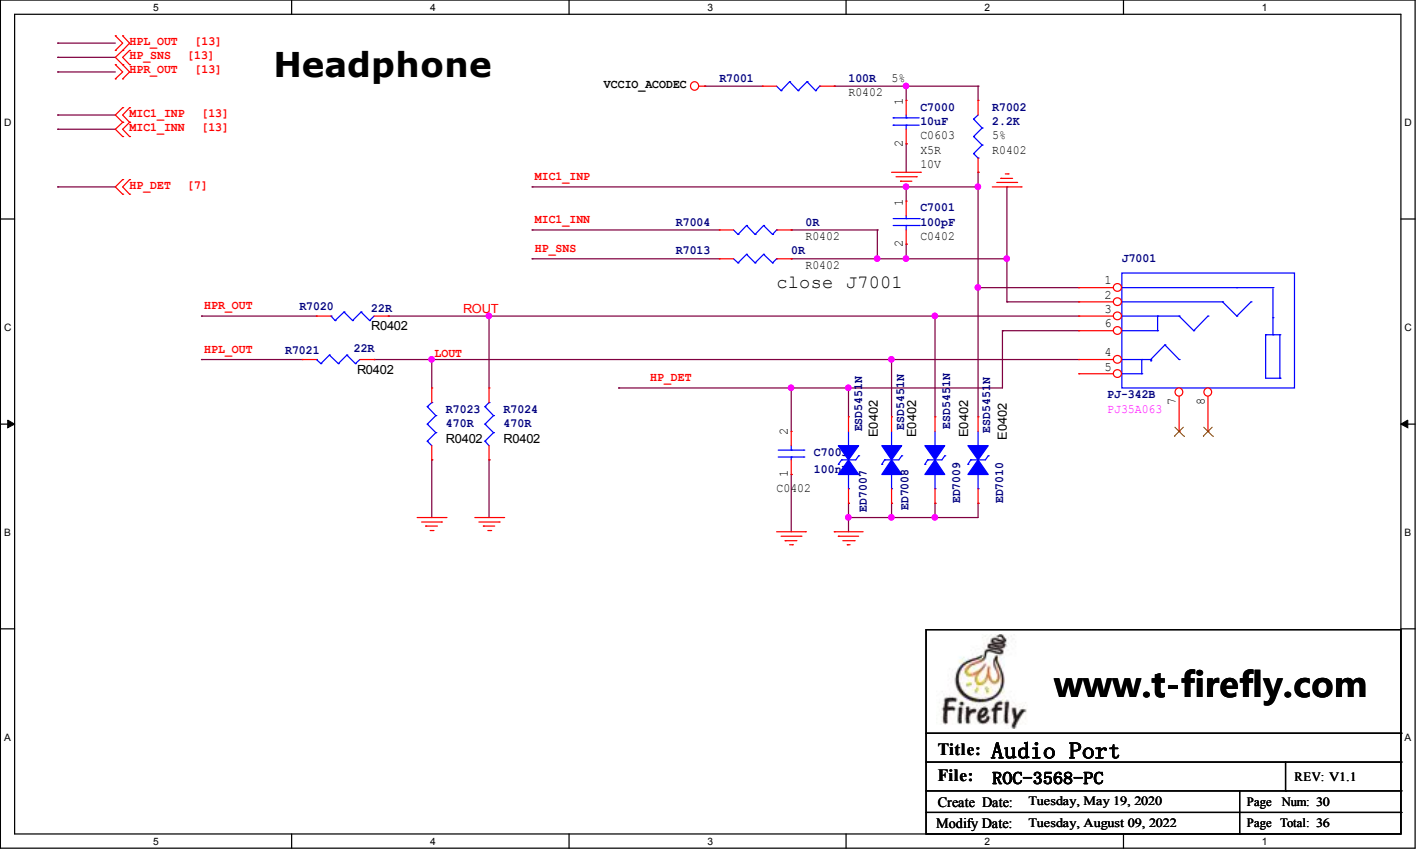
[picture p72: page 31]

# PCIe3.0 x 2Lanes (X 4Slot)

# SATA

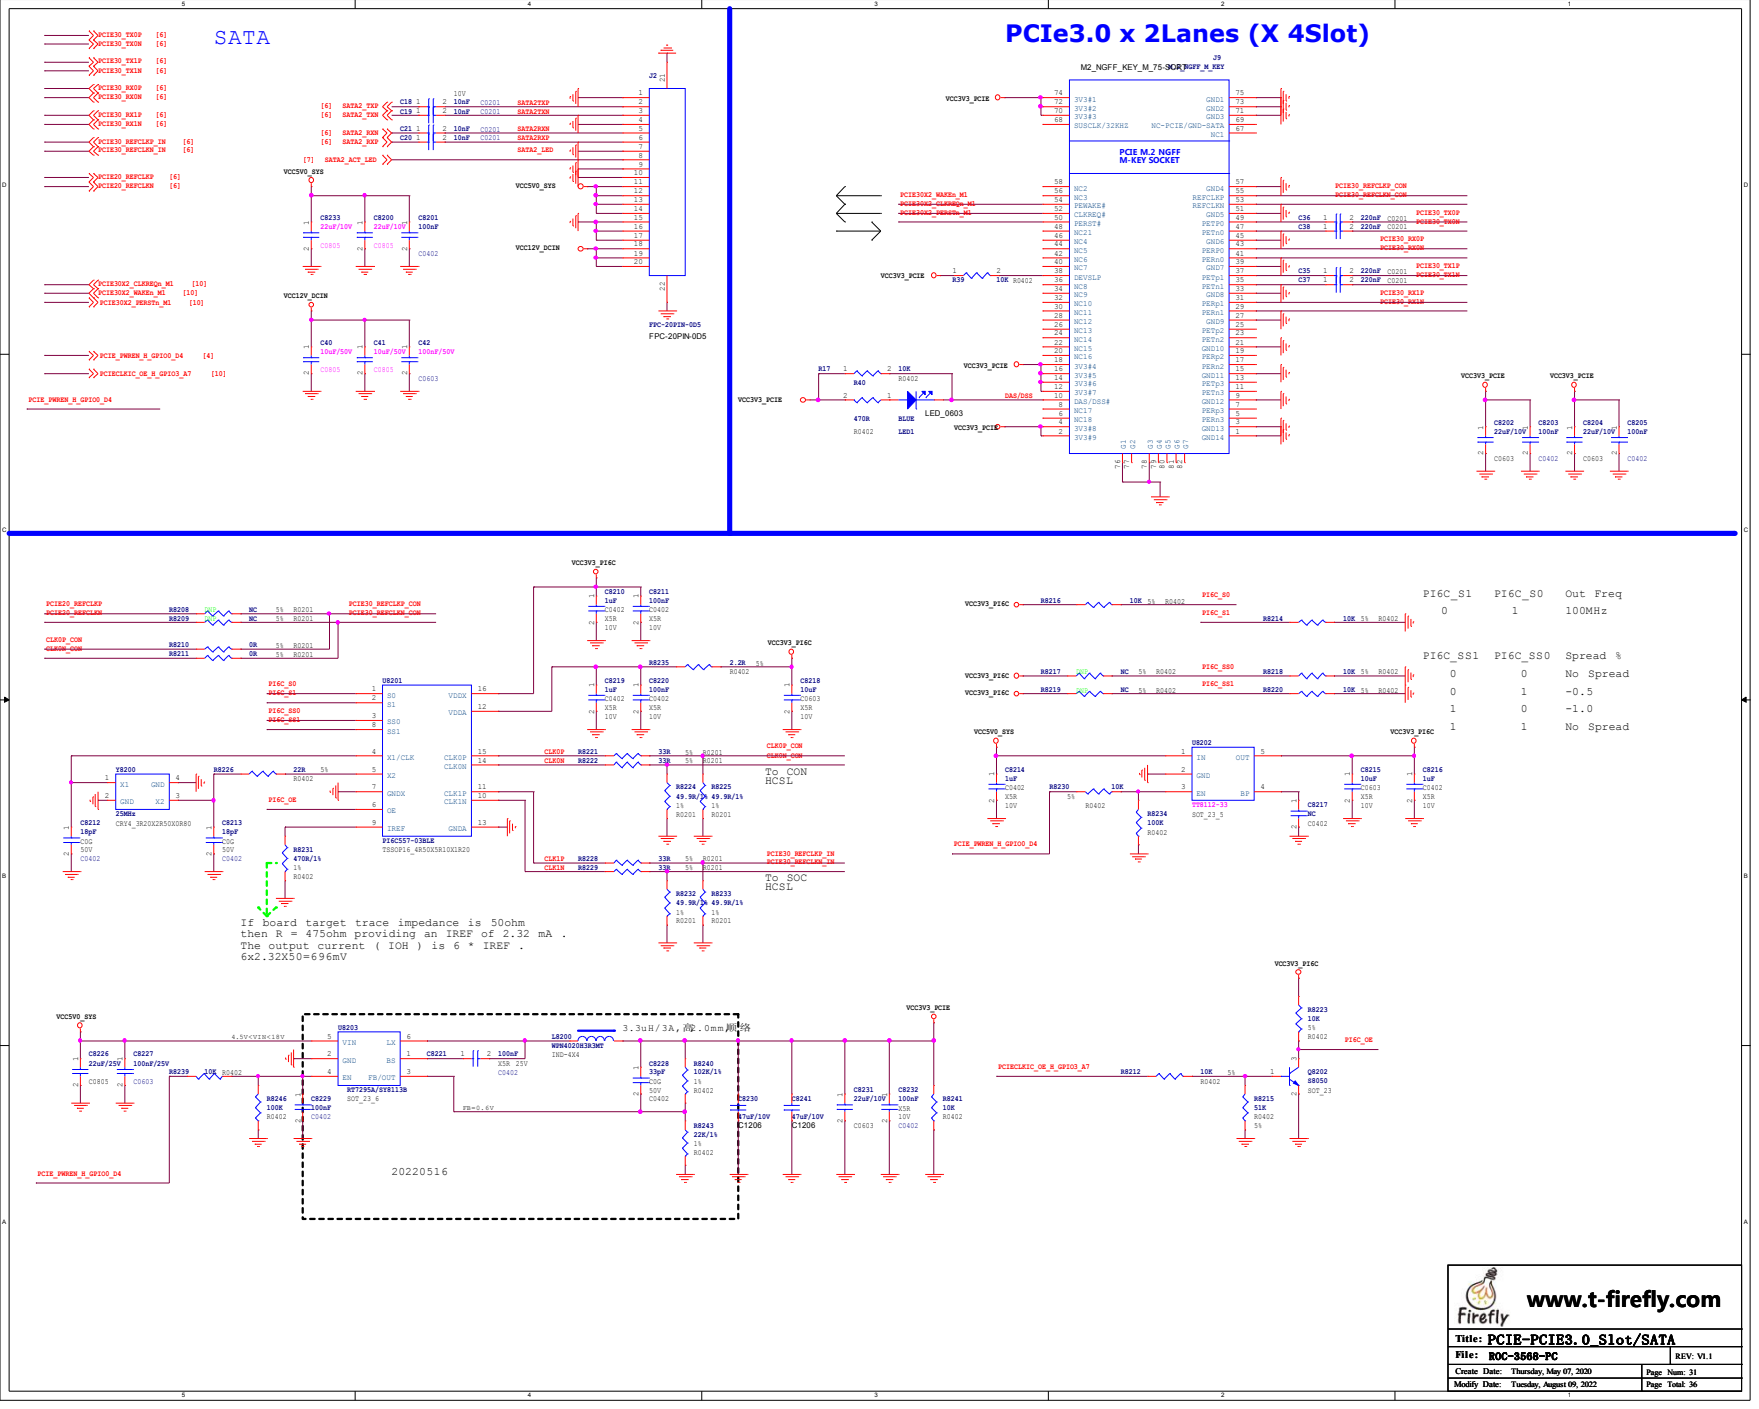
[picture p73: page 32]

NC-PCIE/GND-SATA

If board target trace impedance is 50ohm
then R = 475ohm providing an IREF of 2.32 mA .
The output current ( IOH ) is 6 * IREF .

D | D
GSENSOR_INT_L_GPIO3_C1 | [10]

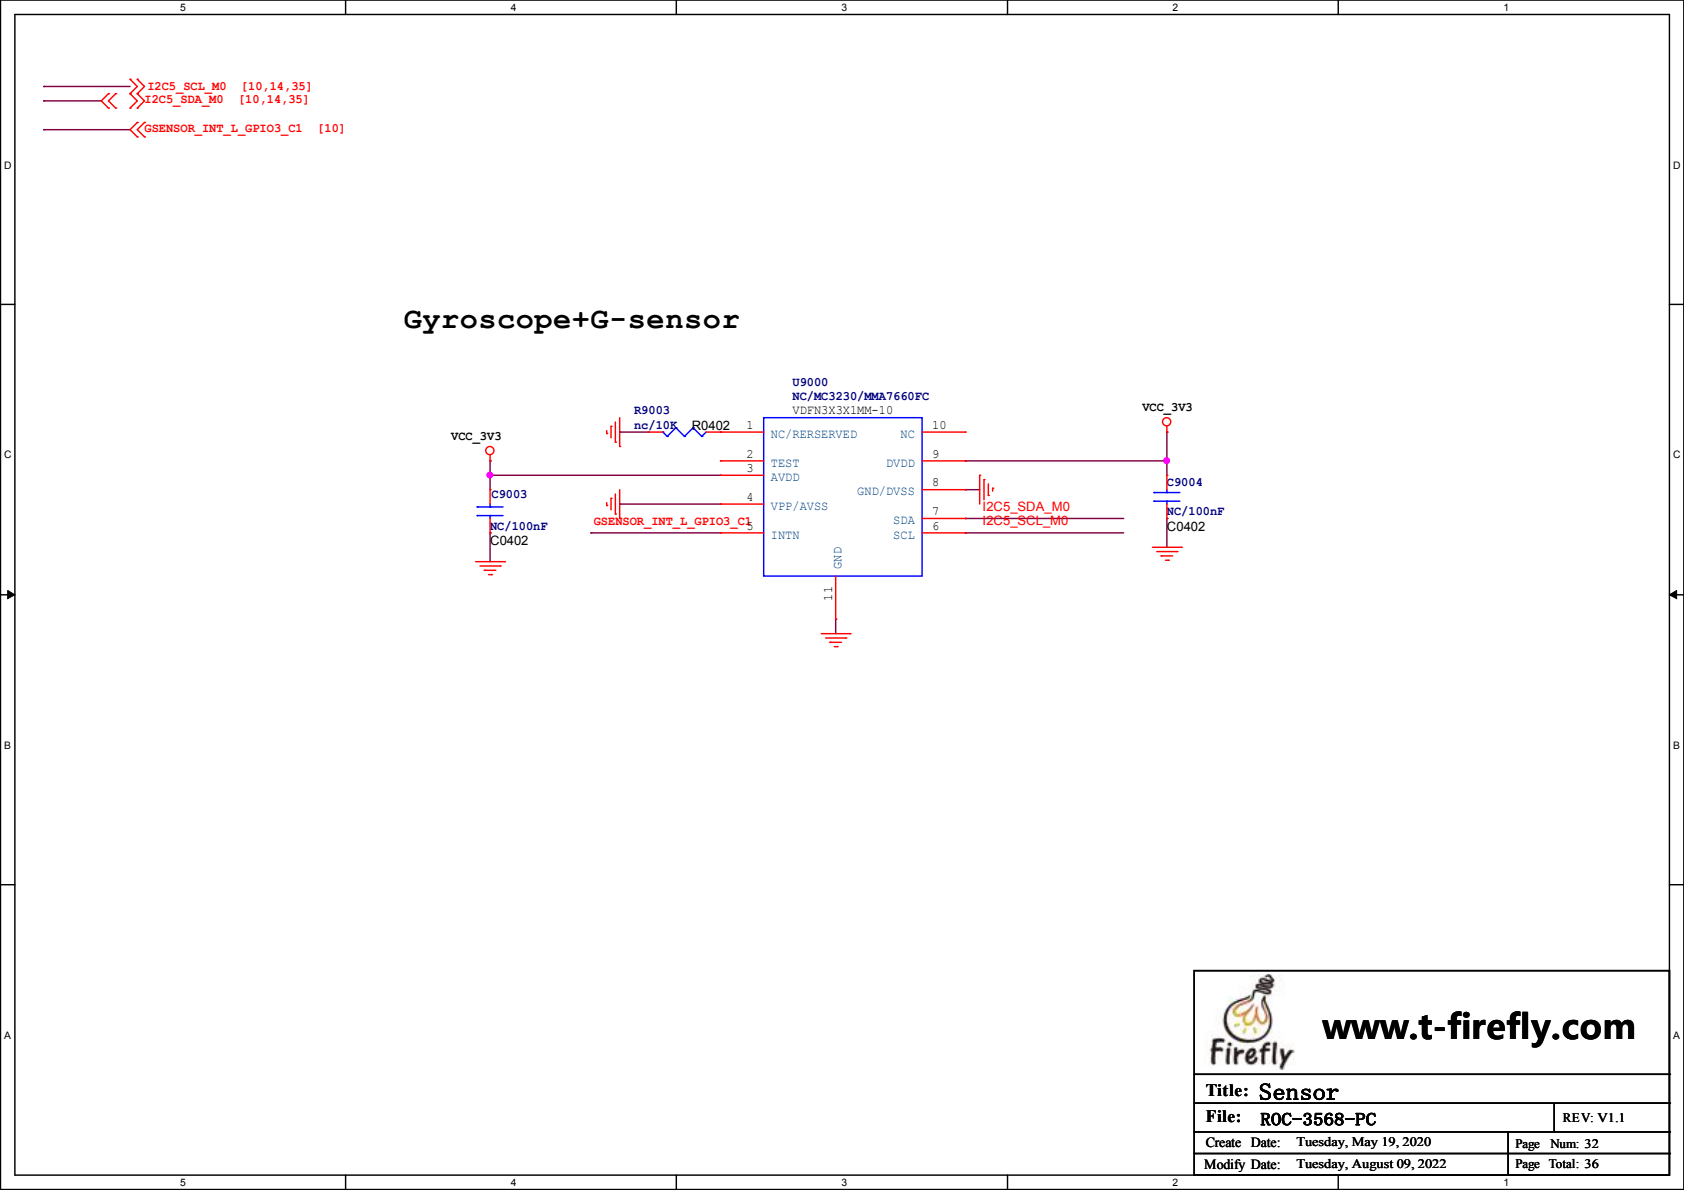
[picture p74: page 33]
Gyroscope+G-sensor; I2C5_SDA_M0; GSENSOR_INT_L_GPIO3_C1; I2C5_SCL_M0; VCC_3V3; Sensor; Tuesday, May 19, 2020; U9000 NC/MC3230/MMA7660FC; VDFN3X3X1MM-10; AVDD; TEST; NC/RERSERVED; VPP/AVSS; INTN; SCL; SDA; GND/DVSS; DVDD; GND

www.t-firefly.com

## DEBUG

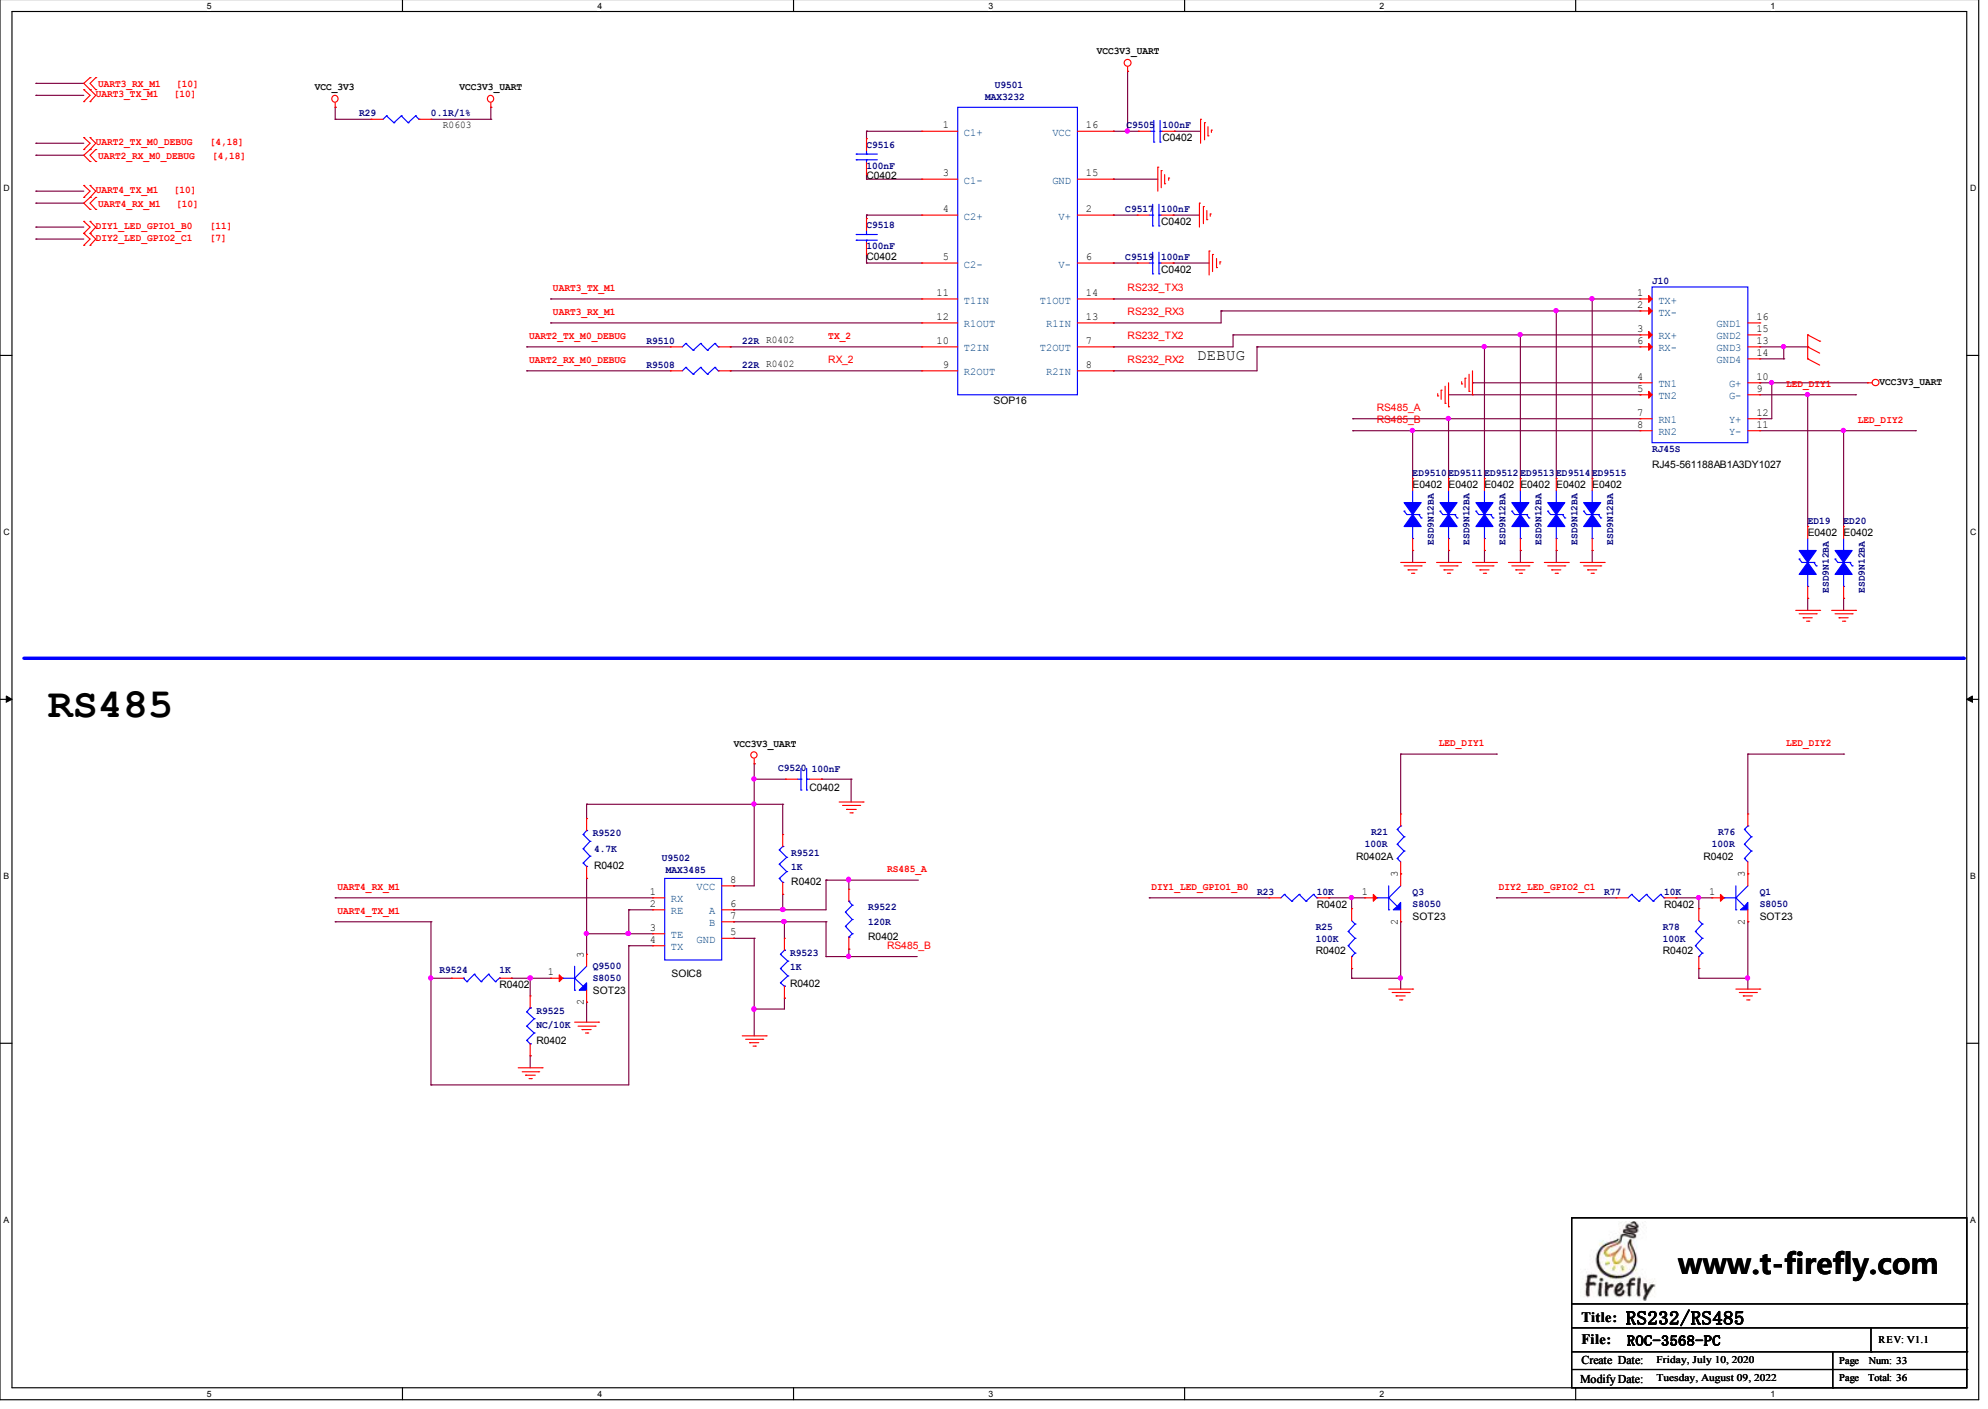
[picture p75: page 34]

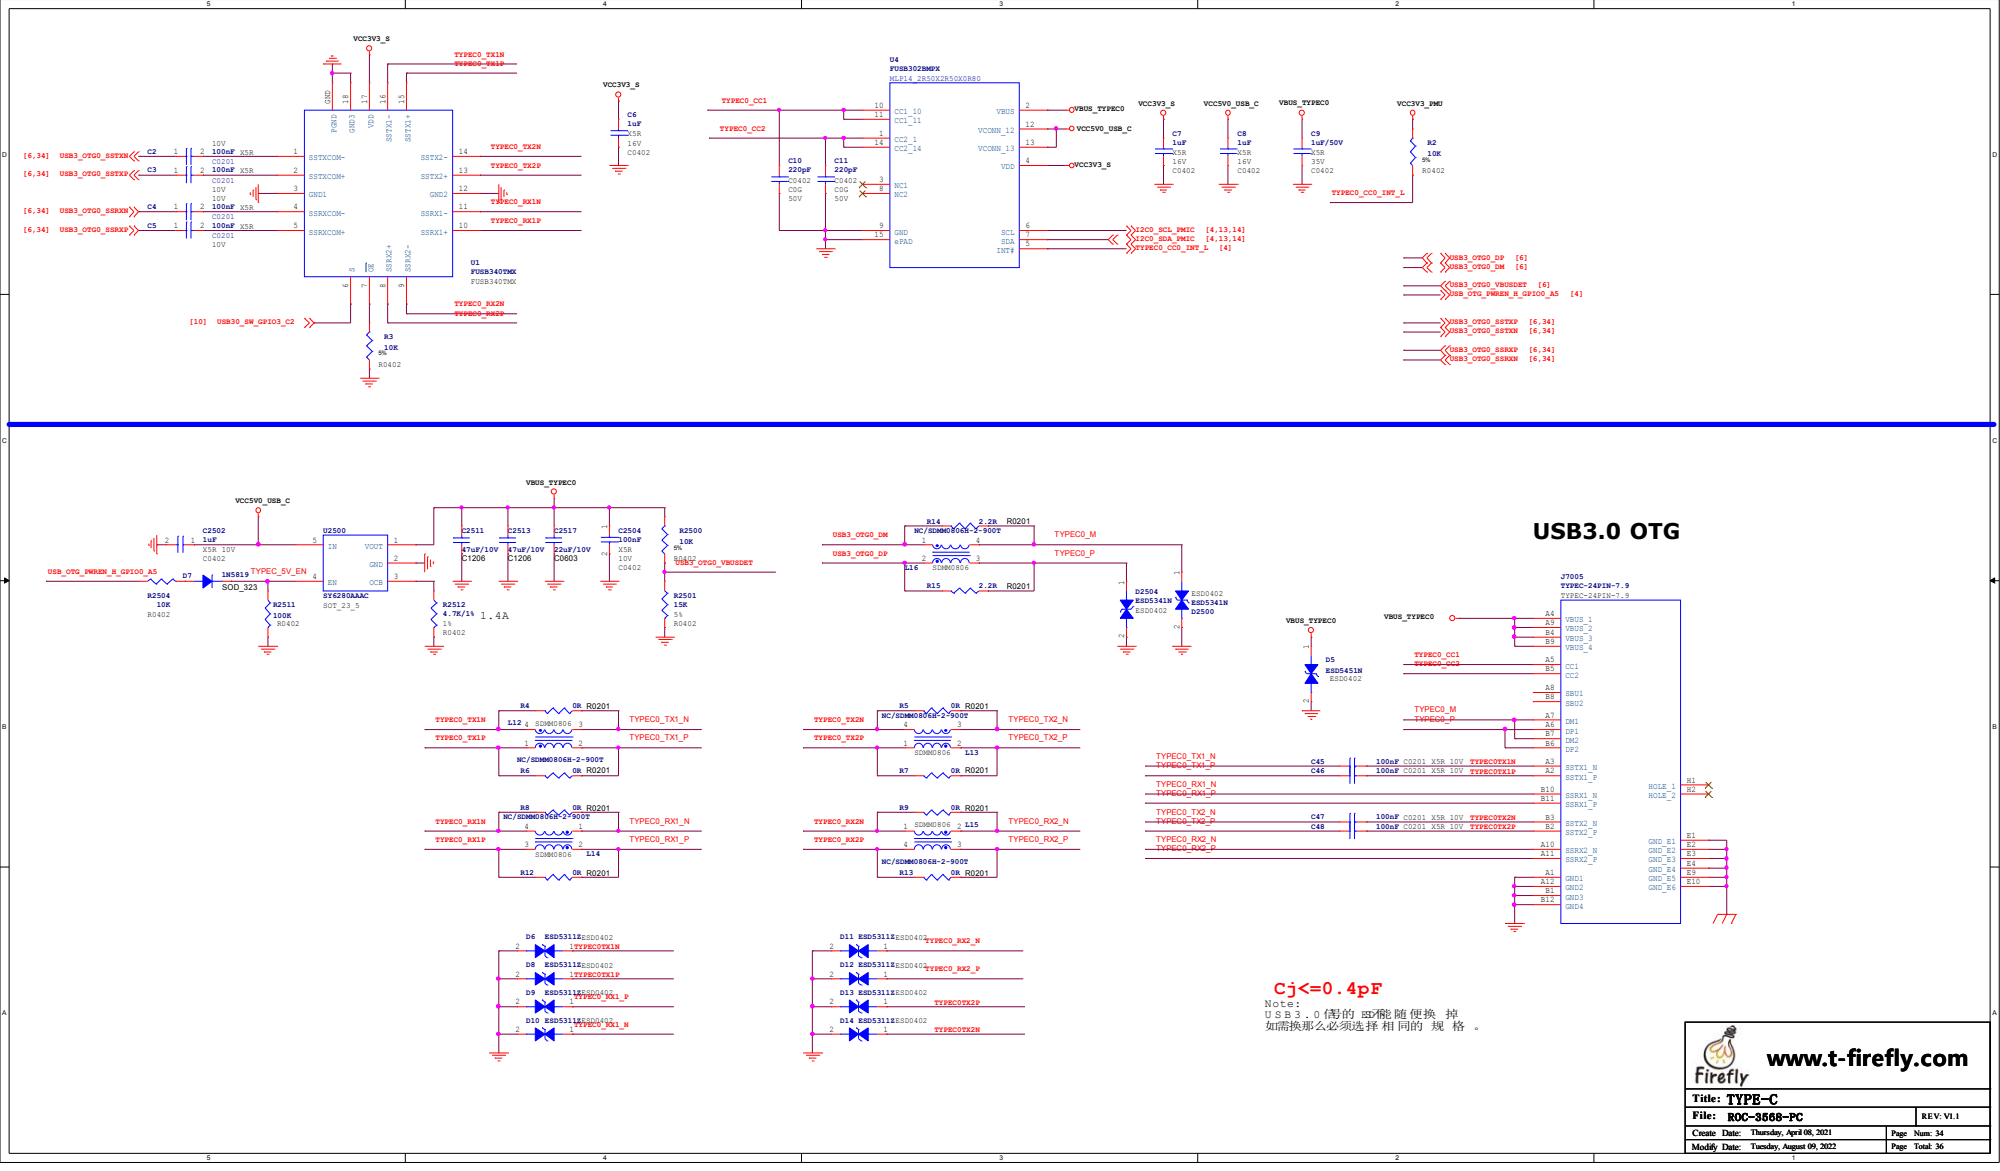
[picture p76: page 35]

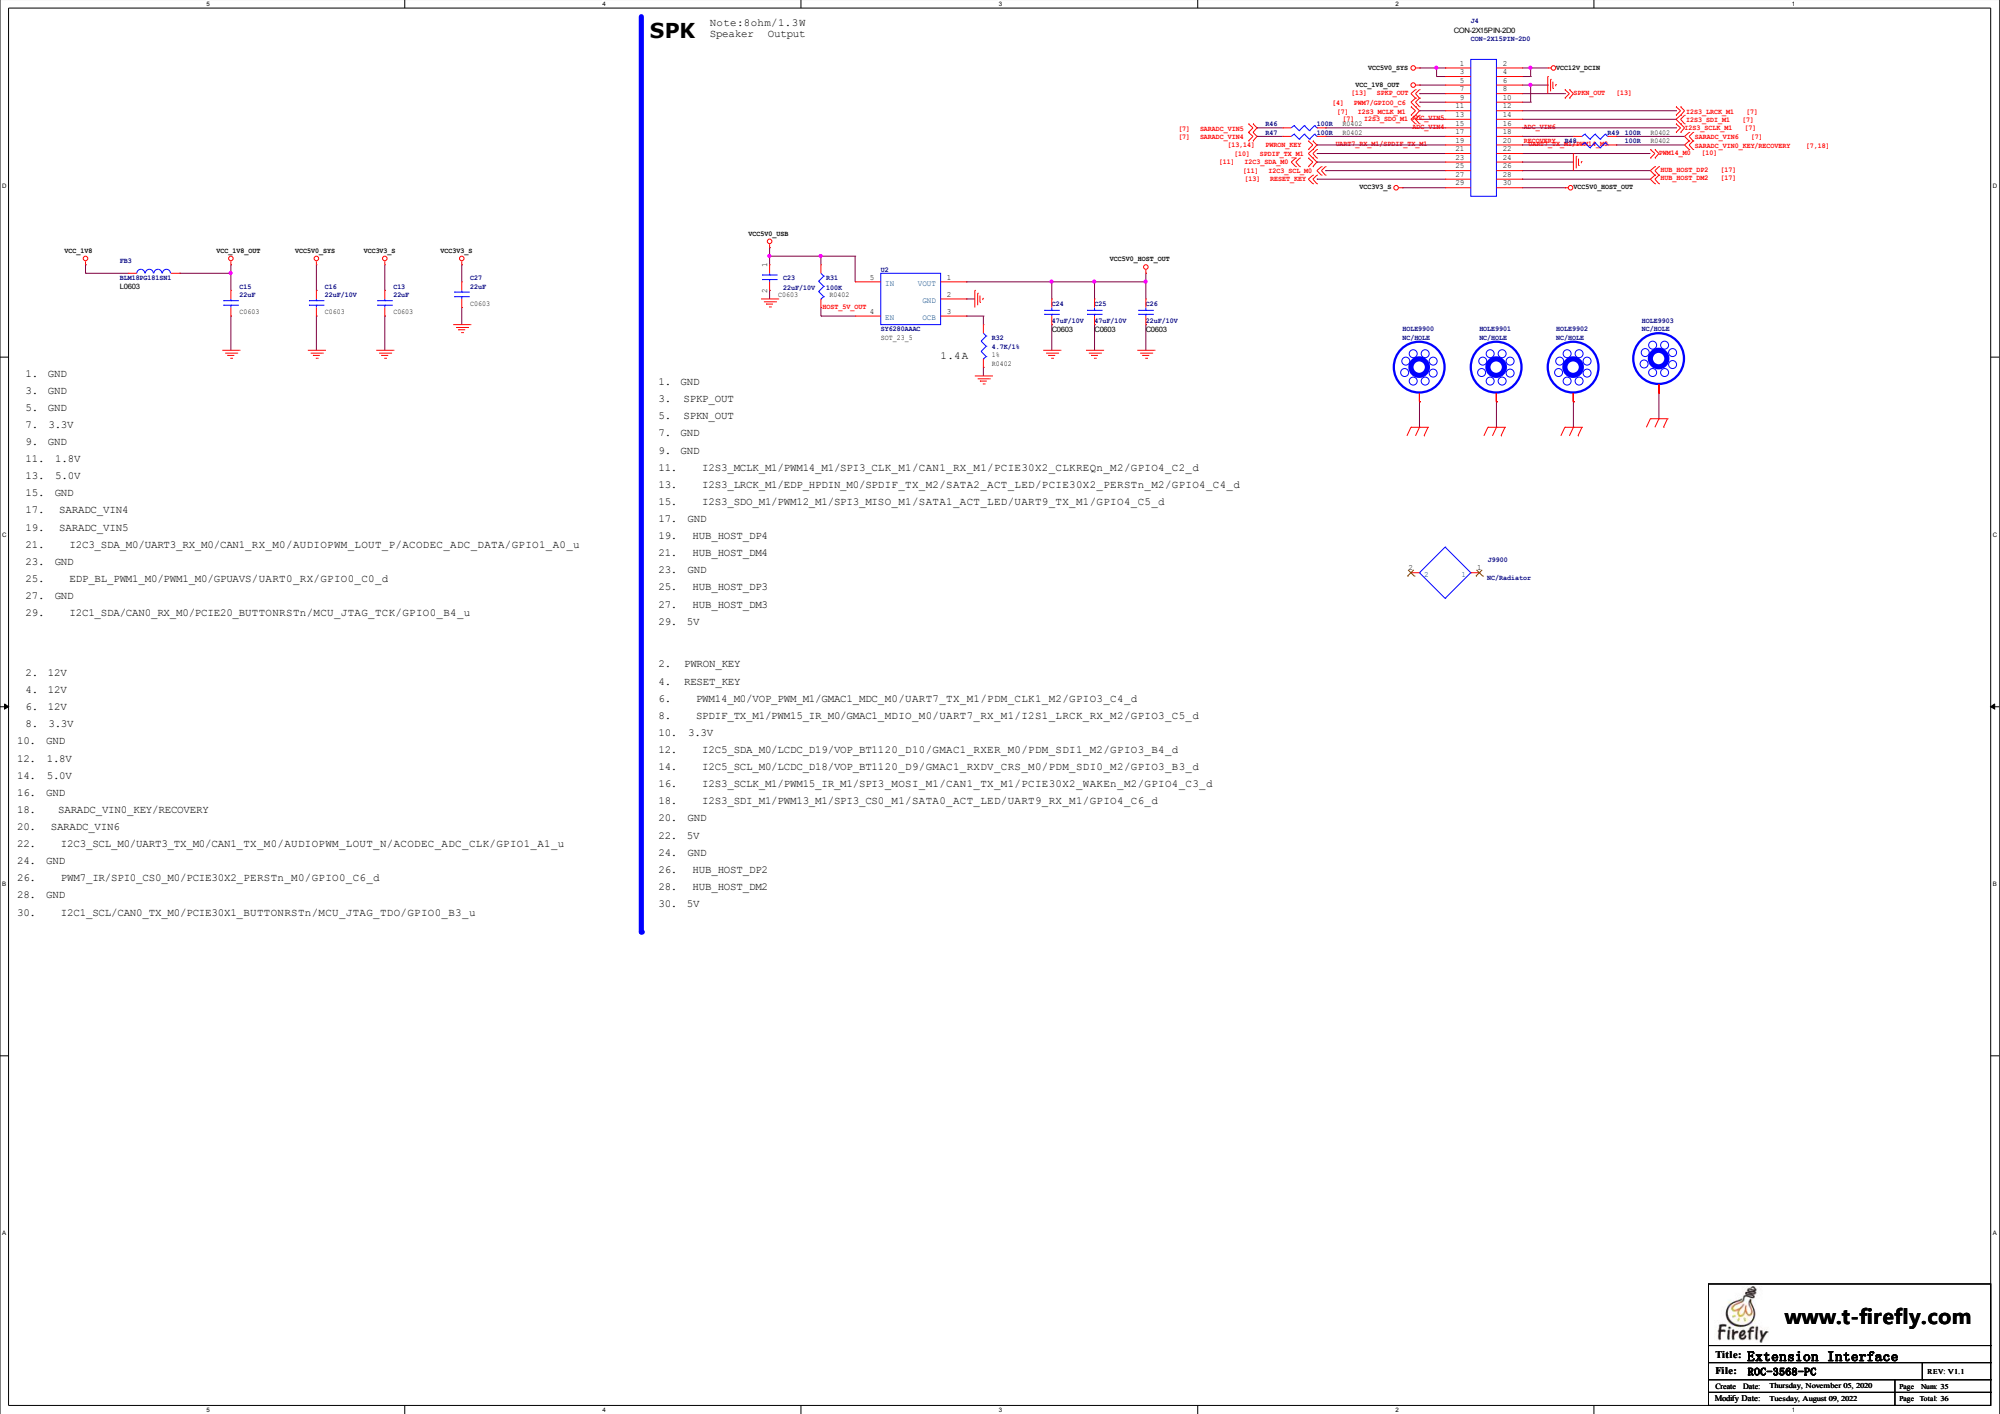
[picture p77: page 36]
