eSpark-Consulting-Group/anis-carrier-board/Deliverables/Schematic/Assembly_Drawing.pdf

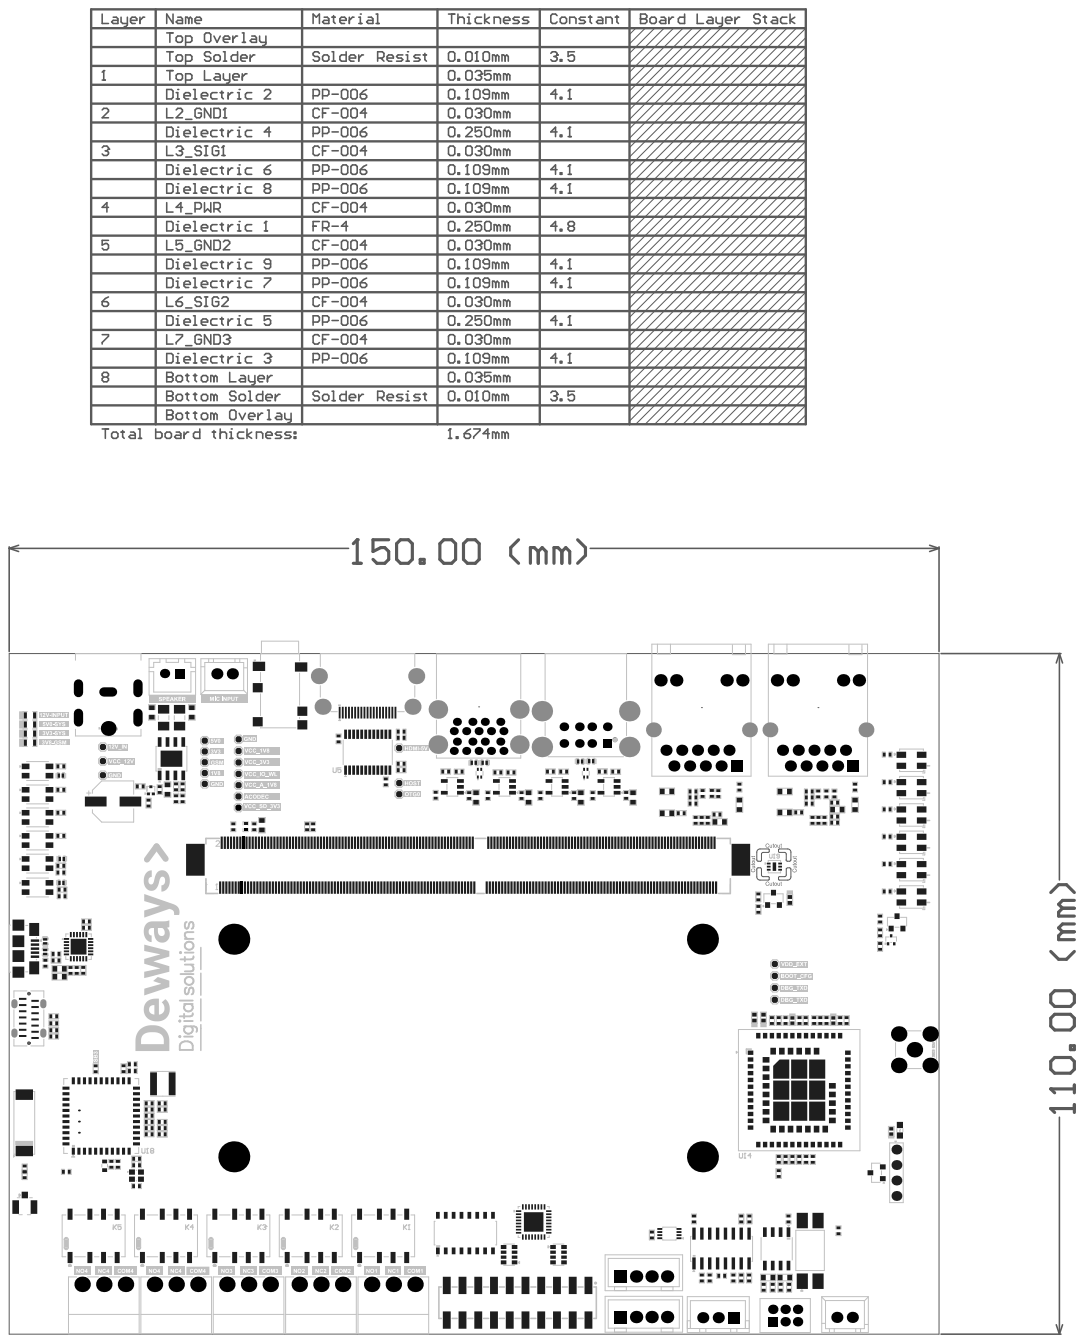
[picture p78: page 1]

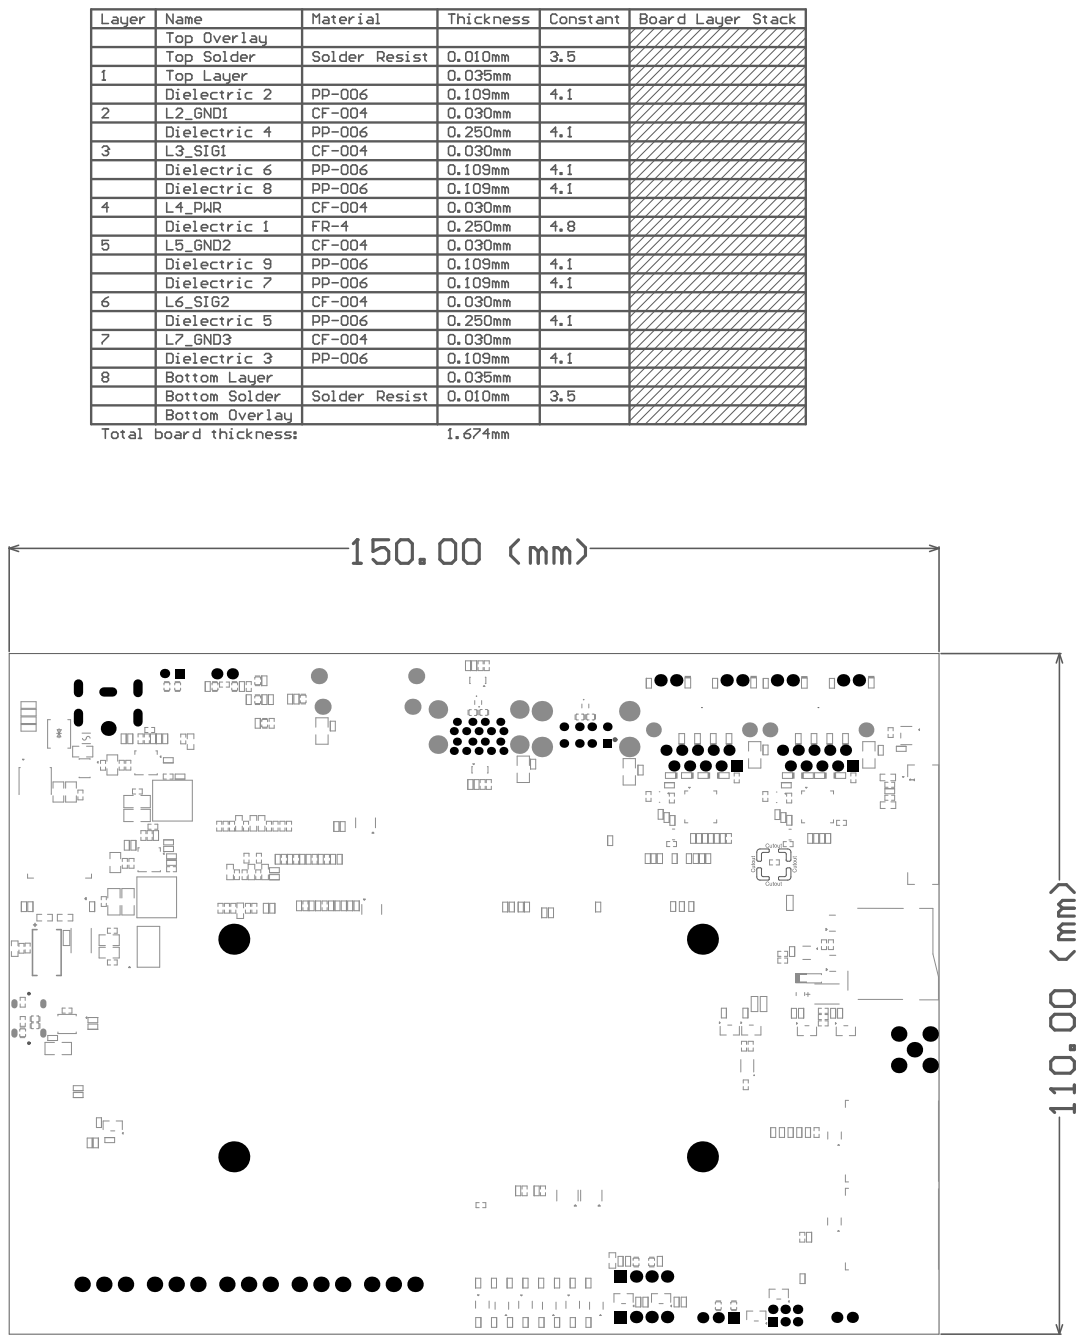
[picture p79: page 2]

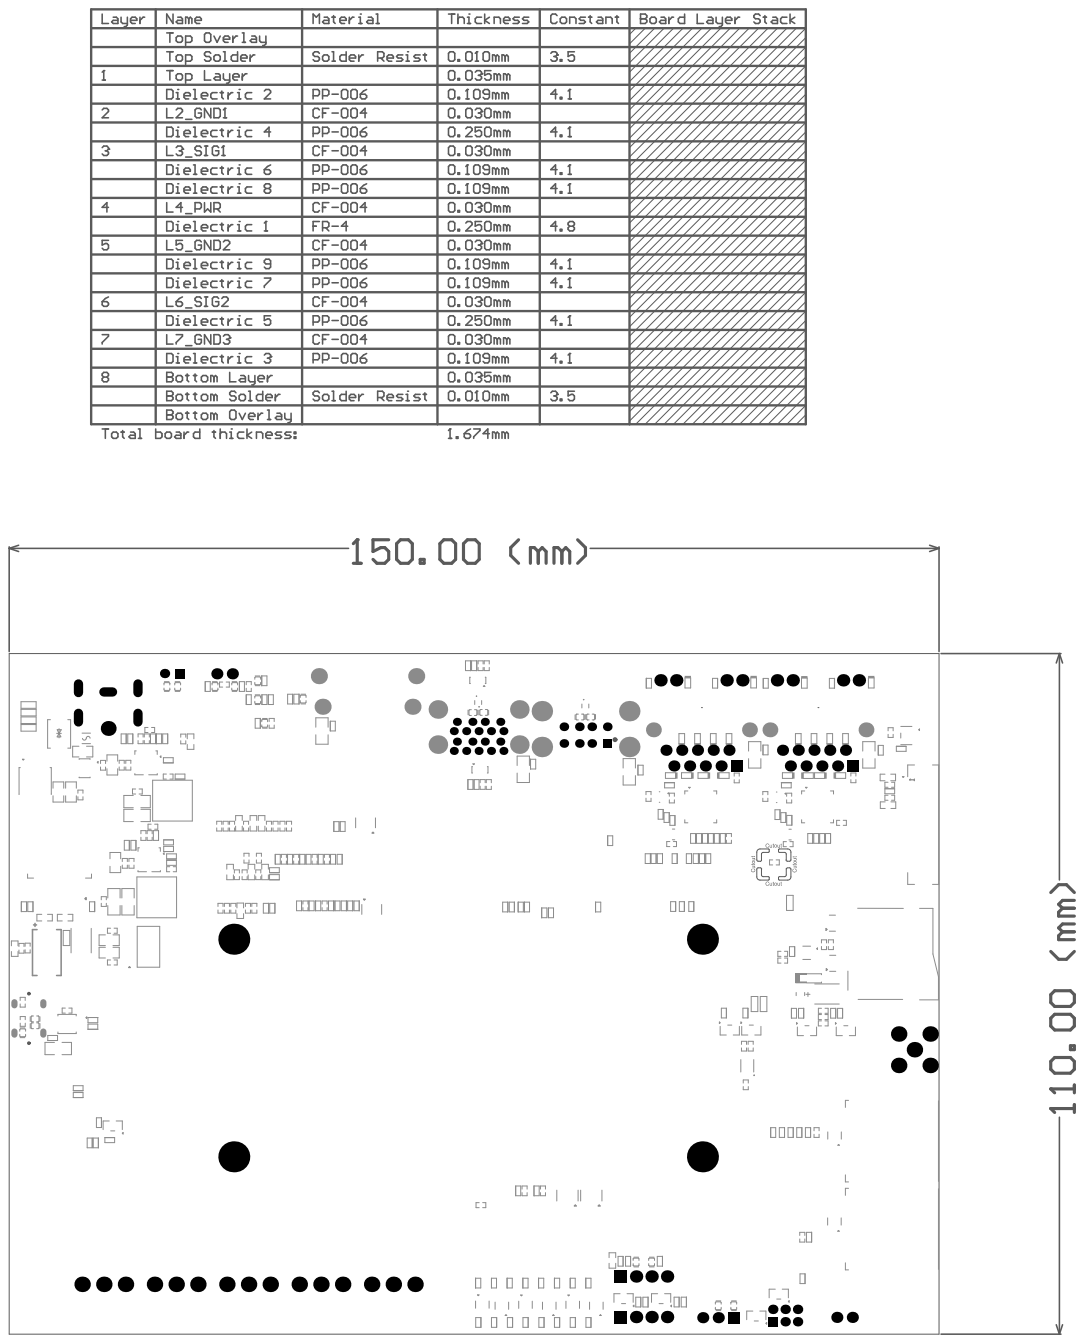
[picture p80: page 3]

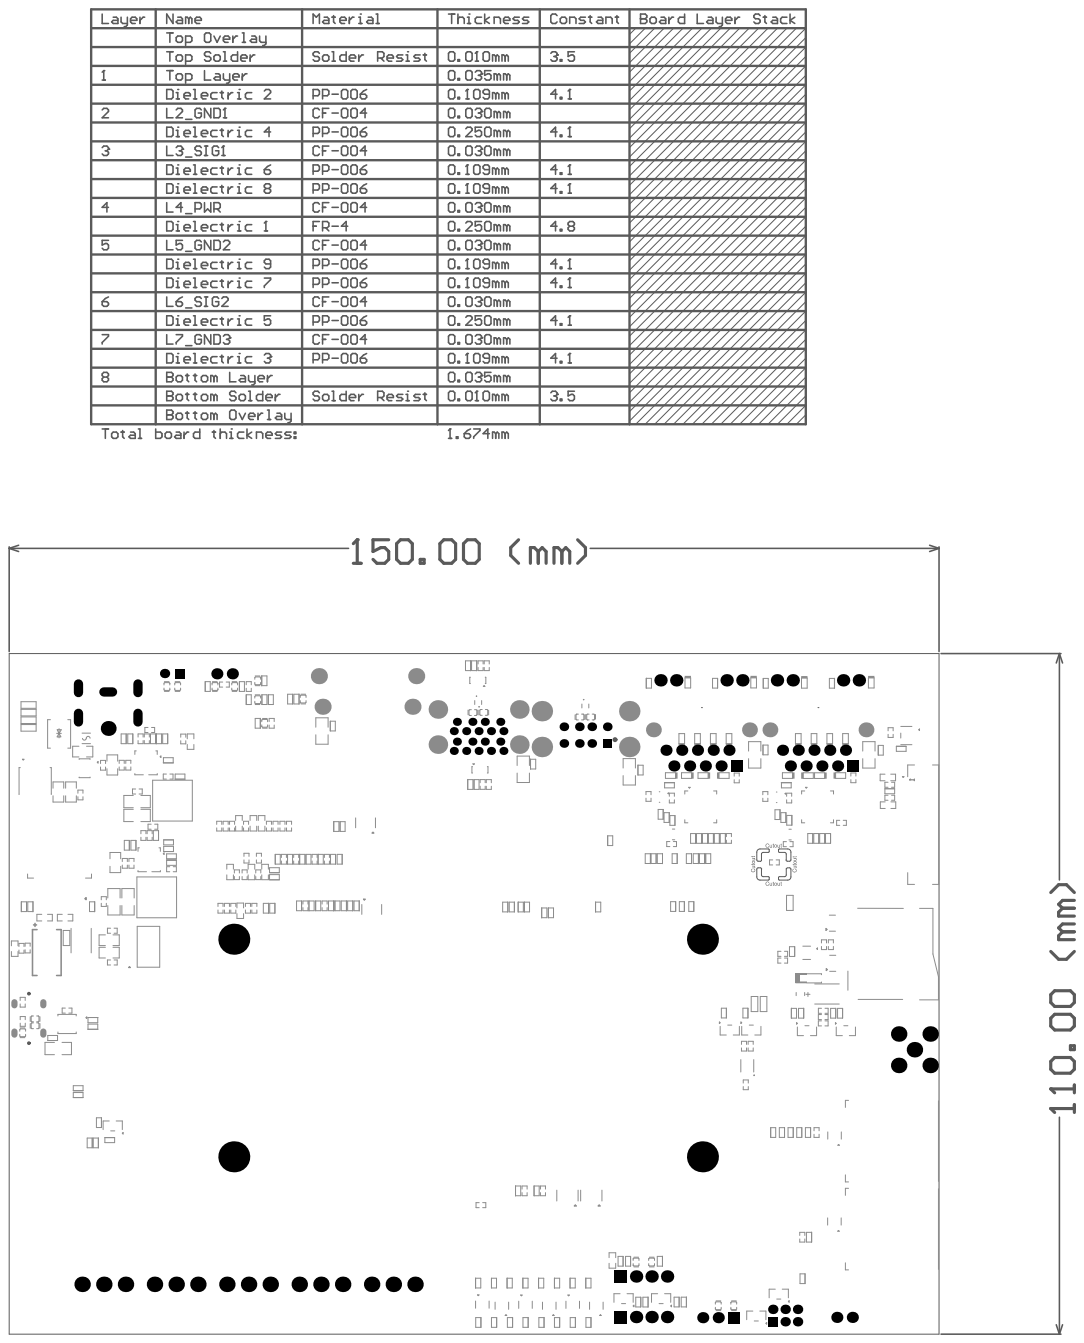
[picture p81: page 4]

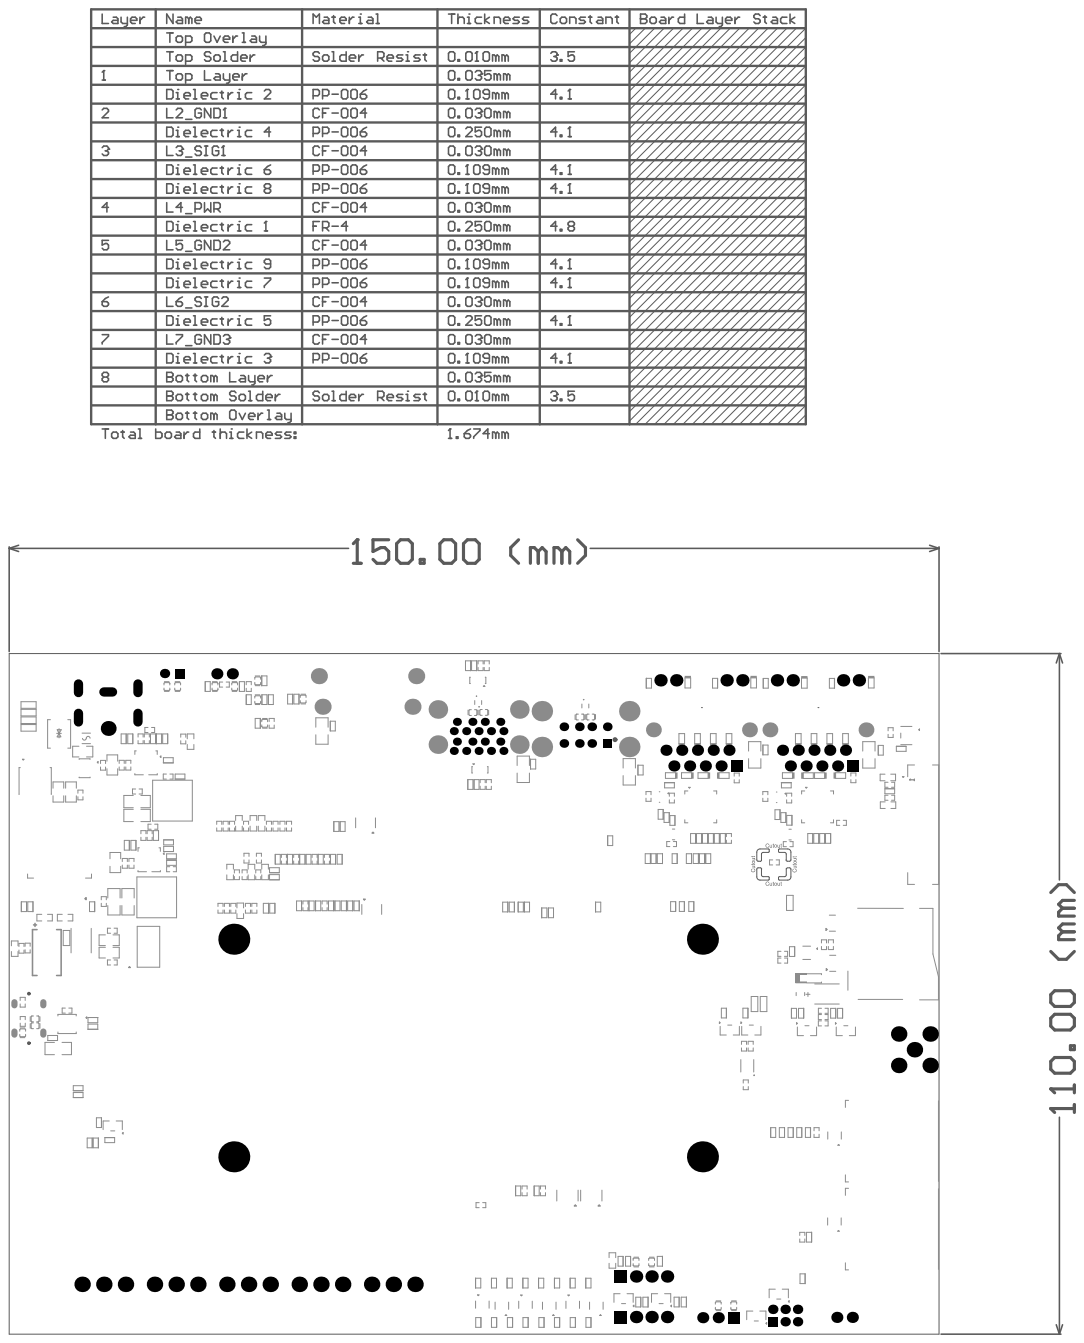
[picture p82: page 5]

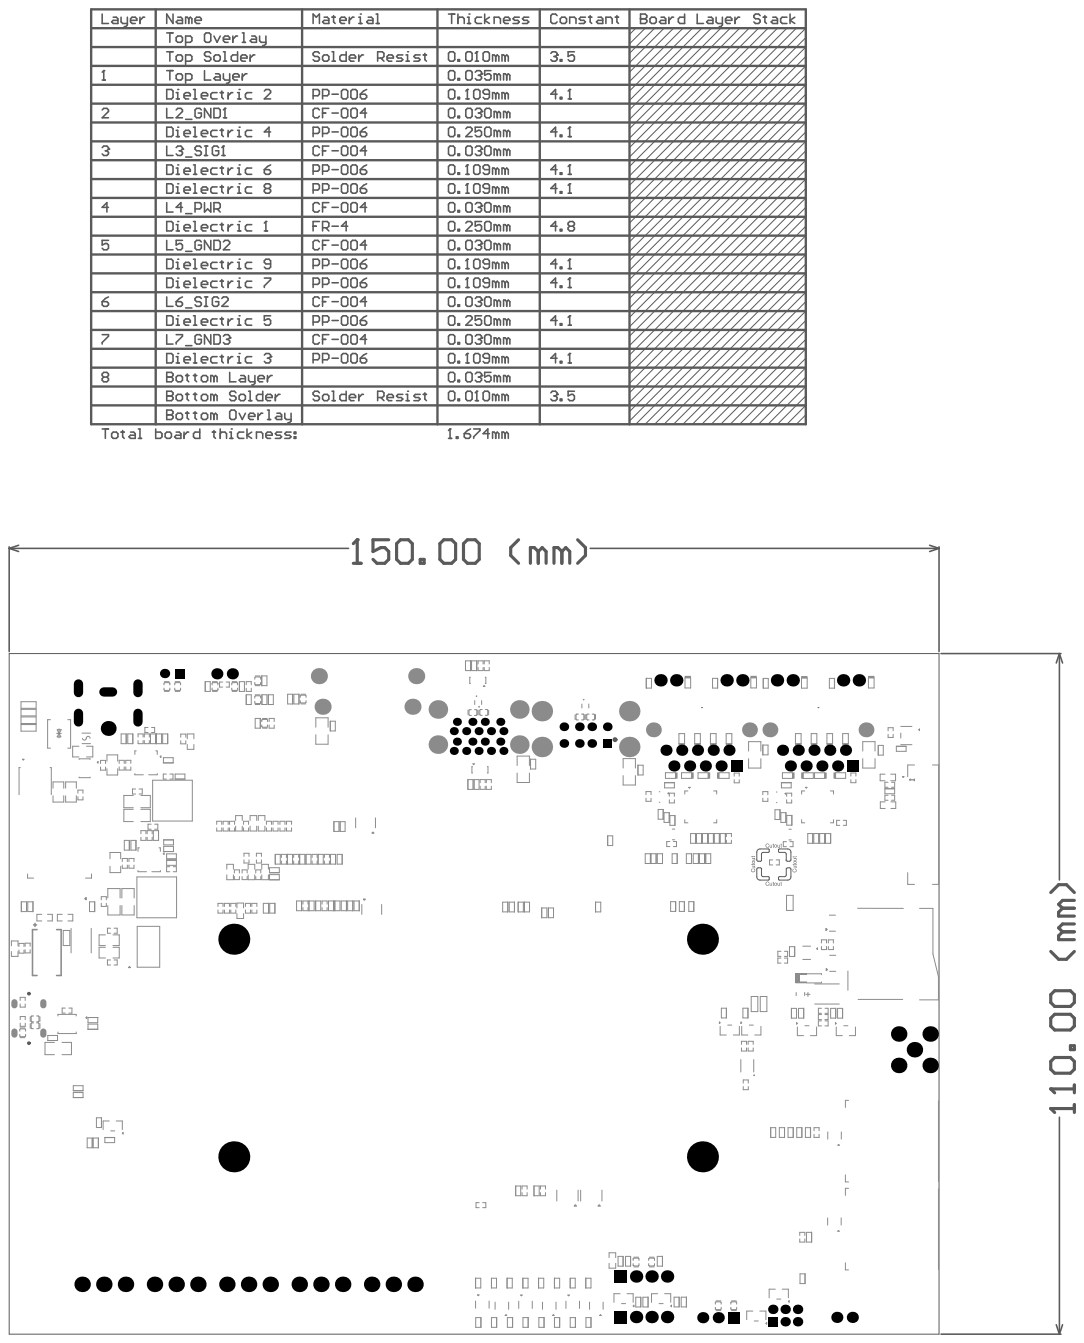
[picture p83: page 6]

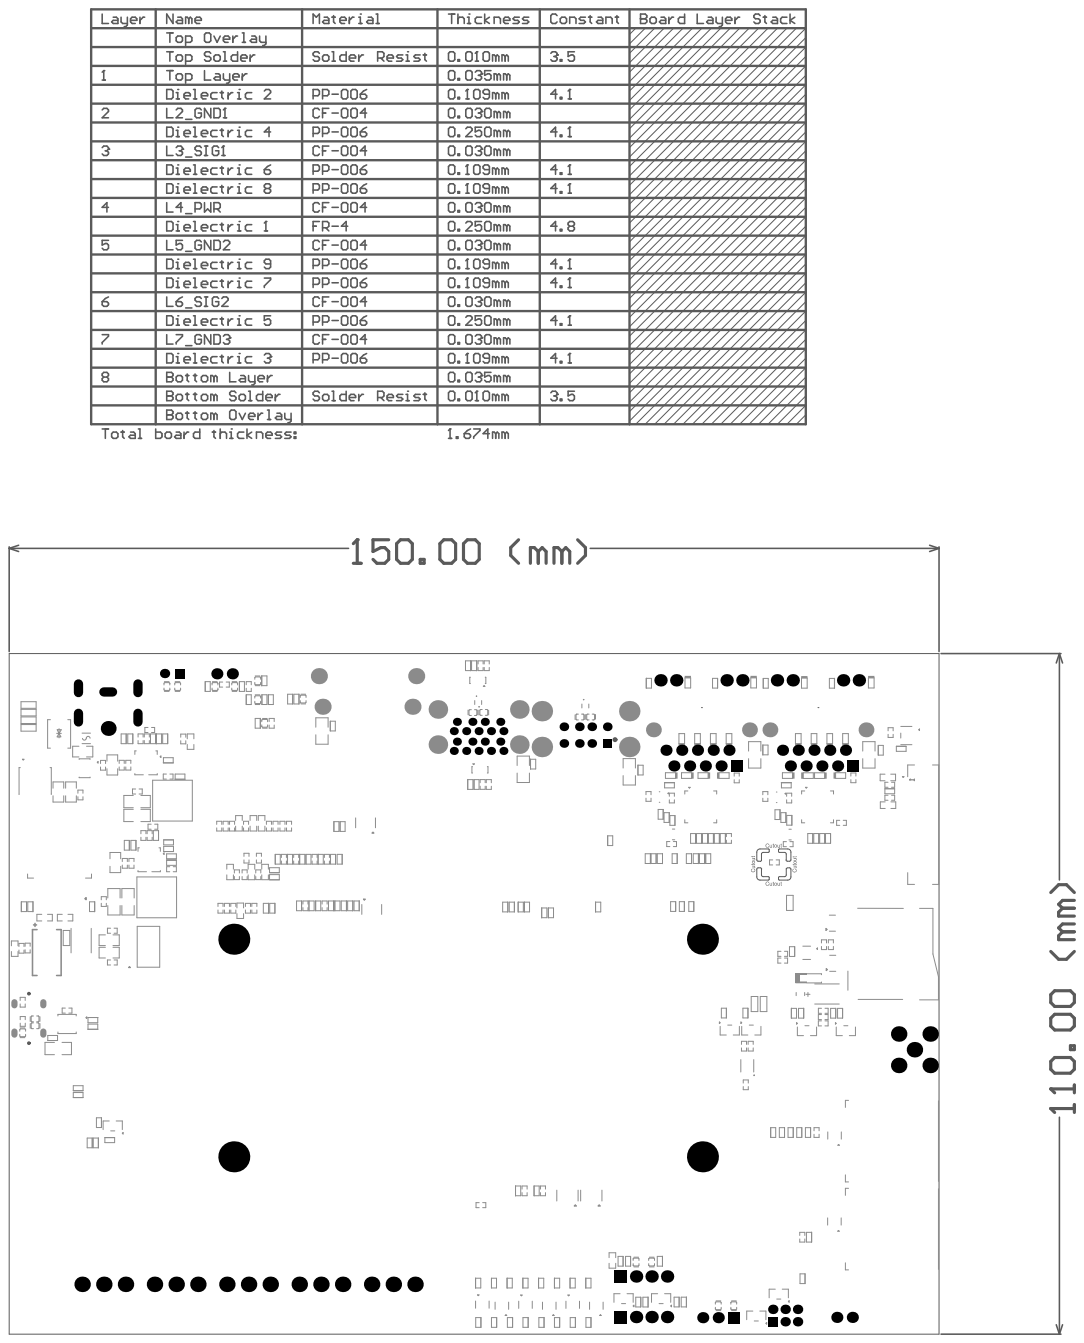
[picture p84: page 7]

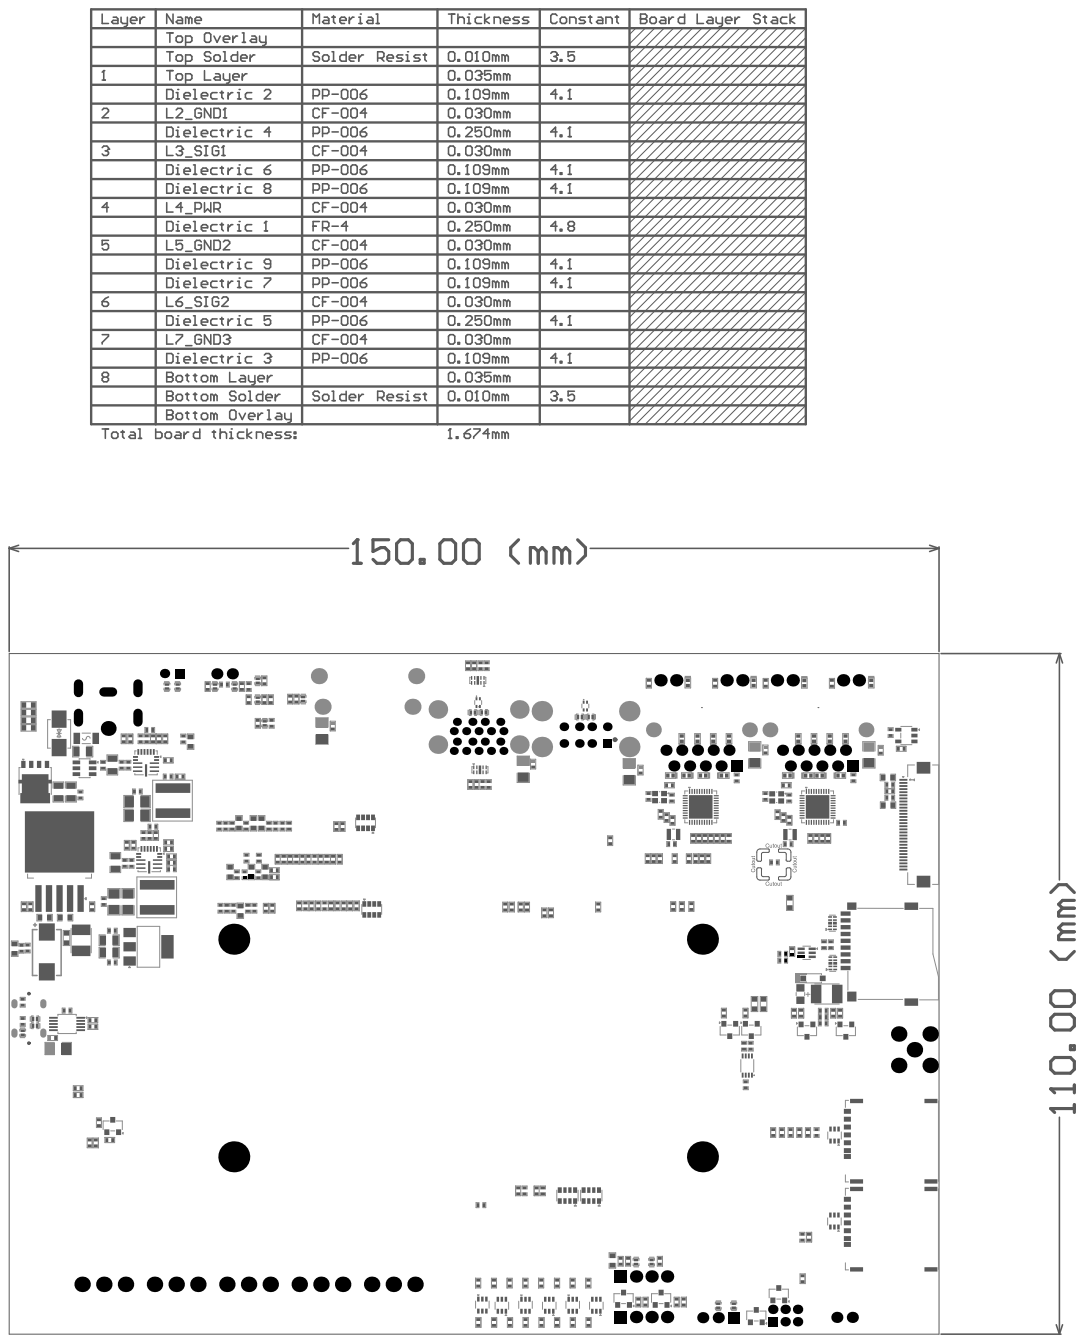
[picture p85: page 8]
