eSpark-Consulting-Group/anis-carrier-board/(list of files, drawings)

Other design files:
Design-Files/Carrier-Board-v1.0/Carrier-Board-v1.0.PrjPcb
Design-Files/Carrier-Board-v1.0/Carrier_Board_v1.0.PcbDoc
Design-Files/Carrier-Board-v1.1/AUDIO_INTERFACE.SchDoc
Design-Files/Carrier-Board-v1.1/BUCK REGULATOR.SchDoc
Design-Files/Carrier-Board-v1.1/Carrier-Board-v1.1.PrjPcb
Design-Files/Carrier-Board-v1.1/Connector Sheet.SchDoc
Design-Files/Carrier-Board-v1.1/DEBUG_UART_INTERFACE.SchDoc
Design-Files/Carrier-Board-v1.1/DIGITAL IO_RELAY_SHEET.SchDoc
Design-Files/Carrier-Board-v1.1/DUAL_SIM_INTERFACE.SchDoc
Design-Files/Carrier-Board-v1.1/ETHERNET_PHY0.SchDoc
Design-Files/Carrier-Board-v1.1/ETHERNET_PHY1.SchDoc
Design-Files/Carrier-Board-v1.1/GSM_INTERFACE.SchDoc
Design-Files/Carrier-Board-v1.1/HDMI_INTERFACE.SchDoc
Design-Files/Carrier-Board-v1.1/INPUT_PROTECTION.SchDoc
Design-Files/Carrier-Board-v1.1/LINEAR_VOLTAGE_REG.SchDoc
Design-Files/Carrier-Board-v1.1/MICRO_SD_INTERFACE.SchDoc
Design-Files/Carrier-Board-v1.1/MIPI-DSI DISPLAY.SchDoc
Design-Files/Carrier-Board-v1.1/POWER SECTION.SchDoc
Design-Files/Carrier-Board-v1.1/PUSH BUTTONs_INTERFACE.SchDoc
Design-Files/Carrier-Board-v1.1/RGB_LEDs_INTERFACE.SchDoc
Design-Files/Carrier-Board-v1.1/ROCKCHIP_GPIO_NC PINS.SchDoc
Design-Files/Carrier-Board-v1.1/ROCKCHIP_PWR_SUPPLY.SchDoc
Design-Files/Carrier-Board-v1.1/ROCKCHIP_SYSTEM_CONTROL.SchDoc
Design-Files/Carrier-Board-v1.1/RS232_RS485_INTERFACE.SchDoc
Design-Files/Carrier-Board-v1.1/SENSOR_SHEET.SchDoc
Design-Files/Carrier-Board-v1.1/TOP SHEET.SchDoc
Design-Files/Carrier-Board-v1.1/USB2.0_INTERFACE.SchDoc
Design-Files/Carrier-Board-v1.1/USB3.0_INTERFACE.SchDoc
Design-Files/Carrier-Board-v1.1/USB-C_INTERFACE.SchDoc
Design-Files/Carrier-Board-v1.1/WIEGAND_INTERFACE.SchDoc
Design-Files/Carrier-Board-v1.1/WIFI_BLUETOOTH_SHEET.SchDoc
