eSpark-Consulting-Group/anis-carrier-board/(commit log)

2024-03-07 Initial Altium files pushed.
    [Carrier-Board-v1.0.PrjPcb, Power-Sheet.SchDoc]
2024-03-13 #3 In Progress
    [Carrier-Board-v1.0.PrjPcb, Connector Sheet.SchDoc, DEBUG_UART_INTERFACE.SchDoc, HDMI_INTERFACE.SchDoc, INPUT_SUPPLY_PROTECTION.SchDoc, MICRO_SD_INTERFACE.SchDoc, Power-Sheet.SchDoc, RS232_RS485_INTERFACE.SchDoc]
2024-04-02 #4 Client BOM added for 5 Boards
    [BOM-Carrier-Board-v1.0.xlsx, Client BOM.xlsx]
2024-04-03 #5 Placement in Progress
    [Carrier_Board_v1.0.PcbDoc]
2024-04-04 #3 Review in progress
    [DEBUG_UART_INTERFACE.SchDoc, DIGITAL IO_RELAY_SHEET.SchDoc, DUAL_SIM_INTERFACE.SchDoc, ETHERNET_PHY0.SchDoc, ETHERNET_PHY1.SchDoc, GSM_INTERFACE.SchDoc, LINEAR_VOLTAGE_REG.SchDoc, ROCKCHIP_GPIO_NC PINS.SchDoc]
2024-04-04 #5 Parts Placement in Progress
    [Carrier-Board-v1.0.PrjPcb, Carrier_Board_v1.0.PcbDoc]
2024-04-08 #5 Review in progress
    [AUDIO_INTERFACE.SchDoc, DEBUG_UART_INTERFACE.SchDoc, DIGITAL IO_RELAY_SHEET.SchDoc, ETHERNET_PHY0.SchDoc, ETHERNET_PHY1.SchDoc, HDMI_INTERFACE.SchDoc, MICRO_SD_INTERFACE.SchDoc, MIPI-DSI DISPLAY.SchDoc]
2024-04-15 #5 Testpoint placement and Formatting remaining
    [Carrier_Board_v1.0.PcbDoc, DEBUG_UART_INTERFACE.SchDoc, DIGITAL IO_RELAY_SHEET.SchDoc, DUAL_SIM_INTERFACE.SchDoc, GSM_INTERFACE.SchDoc, RGB_LEDs_INTERFACE.SchDoc]
2024-04-15 #3 USB typeC sheet added
    [AUDIO_INTERFACE.SchDoc, Carrier-Board-v1.0.PrjPcb, ROCKCHIP_POWER_SUPPLY.SchDoc, USB-C_INTERFACE.SchDoc, USB2.0_INTERFACE.SchDoc, USB3.0_INTERFACE.SchDoc, WIFI_BLUETOOTH_SHEET.SchDoc]
2024-04-16 #3 few parts updated in schematic
    [BUCK REGULATOR.SchDoc, Carrier-Board-v1.0.PrjPcb, Carrier_Board_v1.0.PcbDoc, DEBUG_UART_INTERFACE.SchDoc, MICRO_SD_INTERFACE.SchDoc, RS232_RS485_INTERFACE.SchDoc]
2024-04-16 #5 placement ,formatting done , Two resistors remaining and Mounting holes for remaining
    [Carrier_Board_v1.0.PcbDoc, DEBUG_UART_INTERFACE.SchDoc, MICRO_SD_INTERFACE.SchDoc]
2024-04-17 #3 Changes Completed
    [AUDIO_INTERFACE.SchDoc, BUCK REGULATOR.SchDoc, Carrier-Board-v1.0.PrjPcb, DEBUG_UART_INTERFACE.SchDoc, DIGITAL IO_RELAY_SHEET.SchDoc, DUAL_SIM_INTERFACE.SchDoc, ETHERNET_PHY0.SchDoc, ETHERNET_PHY1.SchDoc]
2024-04-17 #5 PCB completed.
    [Carrier-Board-v1.0.PrjPcb]
2024-04-26 #5 Placement Completed
    [AUDIO_INTERFACE.SchDoc, ETHERNET_PHY0.SchDoc, ETHERNET_PHY1.SchDoc, MICRO_SD_INTERFACE.SchDoc, MIPI-DSI DISPLAY.SchDoc, PUSH BUTTONs_INTERFACE.SchDoc, ROCKCHIP_GPIO_NC PINS.SchDoc, RS232_RS485_INTERFACE.SchDoc]
2024-04-29 #5 Routing in progress
    [AUDIO_INTERFACE.SchDoc, Carrier-Board-v1.0.PrjPcb, DEBUG_UART_INTERFACE.SchDoc, DIGITAL IO_RELAY_SHEET.SchDoc, PROTECTION SHEET.SchDoc, PUSH BUTTONs_INTERFACE.SchDoc, ROCKCHIP_SYSTEM_CONTROL.SchDoc, RS232_RS485_INTERFACE.SchDoc]
2024-05-03 #5 Routing In-prgress.
    [Carrier-Board-v1.0.PrjPcb, DIGITAL IO_RELAY_SHEET.SchDoc]
2024-05-06 #5 Routing In-progress.
    [AUDIO_INTERFACE.SchDoc, BUCK REGULATOR.SchDoc, DEBUG_UART_INTERFACE.SchDoc, DIGITAL IO_RELAY_SHEET.SchDoc, DUAL_SIM_INTERFACE.SchDoc, ETHERNET_PHY0.SchDoc, ETHERNET_PHY1.SchDoc, GSM_INTERFACE.SchDoc]
2024-05-10 #6 Changes done
    [BUCK REGULATOR.SchDoc, DEBUG_UART_INTERFACE.SchDoc, INPUT_PROTECTION.SchDoc, MICRO_SD_INTERFACE.SchDoc, USB3.0_INTERFACE.SchDoc, WIFI_BLUETOOTH_SHEET.SchDoc]
2024-05-10 #6 IC1 designator changed to U24
    [MICRO_SD_INTERFACE.SchDoc]
2024-05-10 #4 Client BOM completed except addition of Peripherals
    [Client BOM.xlsx]
2024-05-14 #4 Client BOM in progress
    [Client BOM.xlsx]
2024-05-15 Client BOM in progress
    [Client BOM.xlsx]
2024-05-15 Changes done
    [GSM_INTERFACE.SchDoc, RS232_RS485_INTERFACE.SchDoc, USB2.0_INTERFACE.SchDoc, USB3.0_INTERFACE.SchDoc]
2024-05-15 #5 Routing in progress MCZ1210CH900CPTA0G re-added due to footprint missing issue
    [AUDIO_INTERFACE.SchDoc, USB2.0_INTERFACE.SchDoc, USB3.0_INTERFACE.SchDoc]
2024-05-15 #4 Client BOM Completed
    [Client BOM.xlsx, eSpark_BOM_Carrier-Board-v1.0.xlsx]
2024-05-15 #4 Updated Client BOM
    [Client BOM.xlsx]
2024-05-16 #4 eSpark BOM Updated.
    [Client BOM.xlsx, eSpark_BOM_Carrier-Board-v1.0.xlsx]
2024-05-16 #5 #4 L1,2,3,4 and R198 replaced
    [PUSH BUTTONs_INTERFACE.SchDoc, USB2.0_INTERFACE.SchDoc, USB3.0_INTERFACE.SchDoc]
2024-05-16 #3 Annotation done
    [USB2.0_INTERFACE.SchDoc]
2024-05-16 #4 Chock Part no update in BOM.
    [Client BOM.xlsx, eSpark_BOM_Carrier-Board-v1.0.xlsx]
2024-05-20 #5 routing completed 4 errors remiaing Deliverables generated
    [AUDIO_INTERFACE.SchDoc, Carrier-Board-v1.0.PrjPcb, Carrier_Board_v1.0.DWG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]
2024-05-21 #5 PCB completed errors removed
    [Carrier-Board-v1.0.PrjPcb]
2024-05-21 #6 Changed wifi Crystal loading capacitor from 9pf to 12pf
    [Client BOM.xlsx, WIFI_BLUETOOTH_SHEET.SchDoc, eSpark_BOM_Carrier-Board-v1.0.xlsx]
2024-05-21 #6 BOM updated
    [Carrier-Board-v1.0.PrjPcb]
2024-05-22 #7 Routing in Progress
    [Carrier-Board-v1.0.PrjPcb]
2024-05-23 9 drc errors remaining
    [ETHERNET_PHY0.SchDoc, LINEAR_VOLTAGE_REG.SchDoc]
2024-05-24 Differntial directive removed form speaker net, #7 routing updated acc to issues highlighted
    [AUDIO_INTERFACE.SchDoc]
2024-05-24 via added on rf trace
2024-05-31 #7 Fresh Deliverables Generated
    [Carrier-Board-v1.0.PrjPcb, Carrier_Board_v1.0.DWG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]
2024-05-31 #4 Spacer added in BOM
    [Client BOM.xlsx, eSpark_BOM_Carrier-Board-v1.0.xlsx]
2024-06-12 #5 RS485 sheet updated and changes in PCB, Fresh Delieverables generated
    [Carrier-Board-v1.0.PrjPcb, Carrier_Board_v1.0.DWG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]
2024-06-12 #4 Client and eSpark BOM Updated acc to schematic.
    [Client BOM.xlsx, eSpark_BOM_Carrier-Board-v1.0.xlsx]
2024-06-13 #4 Client and eSpark BOM Peripheral added
    [Client BOM.xlsx, eSpark_BOM_Carrier-Board-v1.0.xlsx]
2024-09-06 #folder renamed
    [AUDIO_INTERFACE.SchDoc, BUCK REGULATOR.SchDoc, Carrier-Board-v1.1.PrjPcb, Client BOM.xlsx, Connector Sheet.SchDoc, DEBUG_UART_INTERFACE.SchDoc, DIGITAL IO_RELAY_SHEET.SchDoc, DUAL_SIM_INTERFACE.SchDoc]
2024-09-06 #9 PCB changes in progress
    [AUDIO_INTERFACE.SchDoc, Carrier-Board-v1.1.PrjPcb, DIGITAL IO_RELAY_SHEET.SchDoc, DUAL_SIM_INTERFACE.SchDoc, ETHERNET_PHY0.SchDoc, ETHERNET_PHY1.SchDoc, GSM_INTERFACE.SchDoc, HDMI_INTERFACE.SchDoc]
2024-09-09 #9 Completed and Fresh Deliverables Generated
    [AUDIO_INTERFACE.SchDoc, Carrier-Board-v1.1.PrjPcb, Carrier-Board-v1.1.xlsx, Carrier_Board_v1.0.DWG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]
2024-09-10 #9 Wiegand and MIPI Changes done
    [Carrier-Board-v1.1.PrjPcb, Carrier-Board-v1.1.xlsx, Carrier_Board_v1.1.DWG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]
2024-09-10 #10 Client BOM update with Old BOM peripherals
    [Client-BOM-Carrier-Board-v1.1.xlsx]
